ETML-ES-SLO/PRJ_1730_PortierWireless/soft/Portier_17300B_SCA_Release/1730_PortierWireless_InOut_02/readme.txt

Portier Wireless - projet 1730
------------------------------

Description:
Programme fonctionne sur PCB 17300B.
Le même code pour partie porte ou sonnette (détection automatique).
Avec module RF ES 868 MHz 1623x_ModulesRxTx868MHz. Fimware Module_Xbee_06_SCA.
Cette version est fonctionnelle.
Reste à faire :
-gestion des messages sonnette -> sonnette (actuellement, n'en tient pas compte).

Emplacement de ce fichier:
"C:\microchip\harmony\v2_06\apps\PROJ\1730_PortierWireless_InOut_01\readme.txt"

Logiciels:
MPLABX 5.15
xc32 2.15
Harmony 2.06

Auteur:
10.01.2020
Serge Castoldi
