ETML-ES-SLO/PRJ_1730_PortierWireless/doc/Modification/Mod 3.0/2_Rendu/Portier_17300_04_LMS/1730_PortierWireless_InOut_04/readme.txt

Portier Wireless - projet 1730 04
------------------------------

Description:
Programme fonctionne sur PCB 17300B.
Le même code pour partie porte ou sonnette (détection automatique).
Avec module RF ES 868 MHz 1623x_ModulesRxTx868MHz. Fimware Module_Xbee_06_SCA.
Cette version est fonctionnelle.

Basé sur version release SCA avec moddification LMS
Paiting non terminé problème de stabilité. 

Documentations du code : 
https://1730portierwireless.neocities.org/

Emplacement du projet :
C:\microchip\harmony\v2_06\apps\PROJ\1730_PortierWireless_InOut_04

Logiciels:
MPLABX 5.50
xc32 2.50
Harmony 2

Auteur:
02.06.2025
Léo Mendes
