ETML-ES-SLO/PRJ_1730_PortierWireless/doc/PDF(design)/PortierDesign.pptx

## Portier

Phase de design

Ismaël Page
Projet ETML-ES
30 janvier 2018

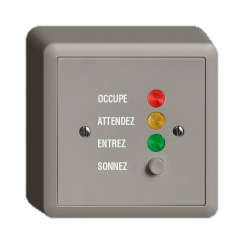
[picture p2: figure]

Notes: 20 min + 10 min questions

## Sommaire

- Produit voulu
- Entrées/Sorties
- Montage "OUT"
- Montage "IN"
- UART
- Coûts
- Planning
- Conclusion
- Questions

## Produit voulu

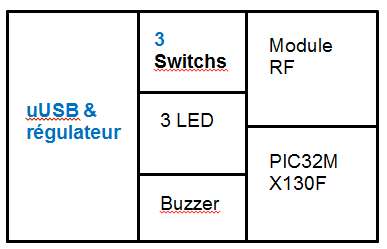
[picture p3: figure]

Module 868MHz

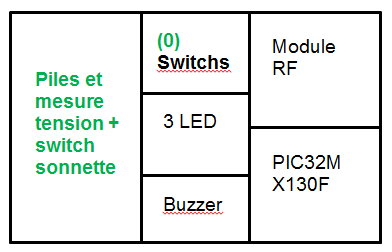
[picture p4: figure]

Module 868MHz

Module 868MHz

## Entrées / Sorties

IN | | OUT
Entrées | Sorties | Entrées | Sorties
Switch1 | LEDRED | Switch1 | LEDRED
Switch2 | LEDRED | Tension piles | LEDYLW
Switch3 | LEDRED | / | LEDGRN
/ | Buzzer | / | Buzzer
RS232 | RS232 | RS232 | RS232

Notes: LED Verte = 330 Ohm

## Entrées / Sorties

RLED Verte = 330Ω
RLED Rouge = 750Ω
RLED Verte = 750Ω
R207 → Sans bruit au démarrage

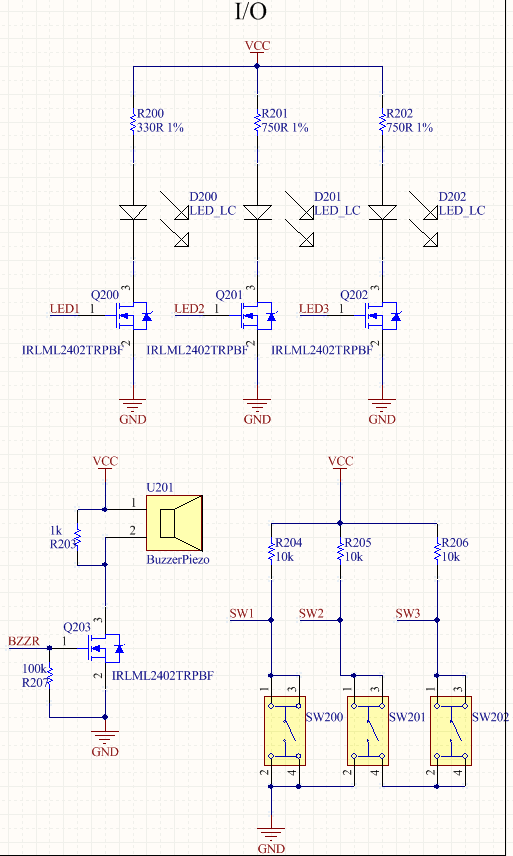
[picture p5: figure]

Notes: Tension LED Rge = 1V75
Tension LED Jne = 1V85
Tension LED Verte = 2V65

## Montage "OUT" Alimentation

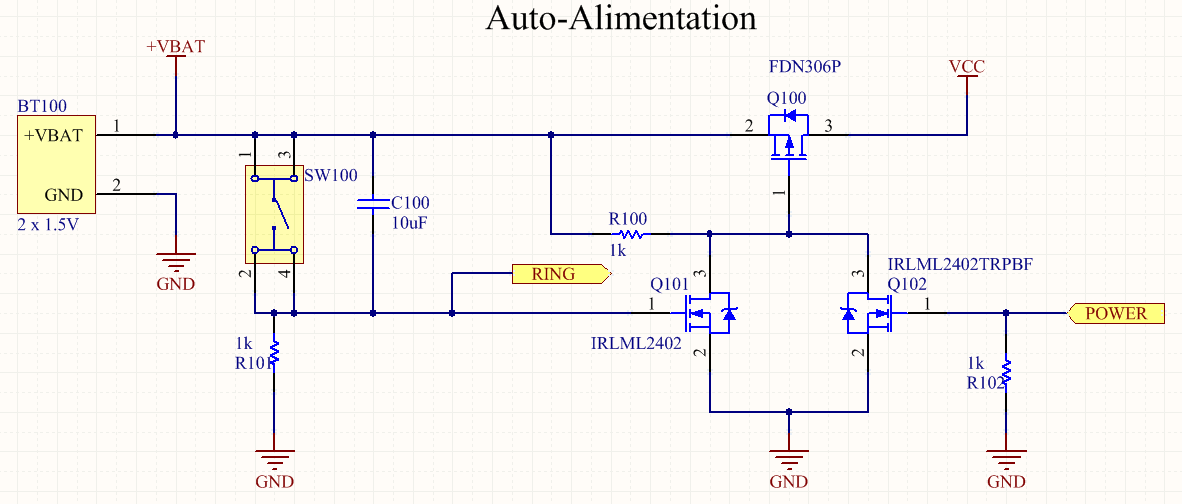
[picture p6: figure]

RC = 10ms

## Montage "OUT" Piles

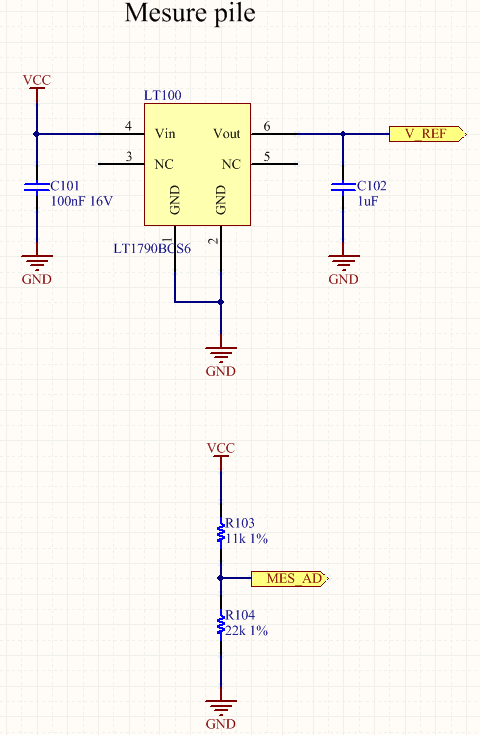
[picture p7: figure]

V_REF = 2.048 V
MES_AD = ⅔ VCC
Seuil d'alerte :
⅔ VCCmin = ⅔ 2.3 = 1.533 V (+0.05)

## Montage "OUT" Démarrage

TPU = Time power-up
TSYSDLY = Time system delay

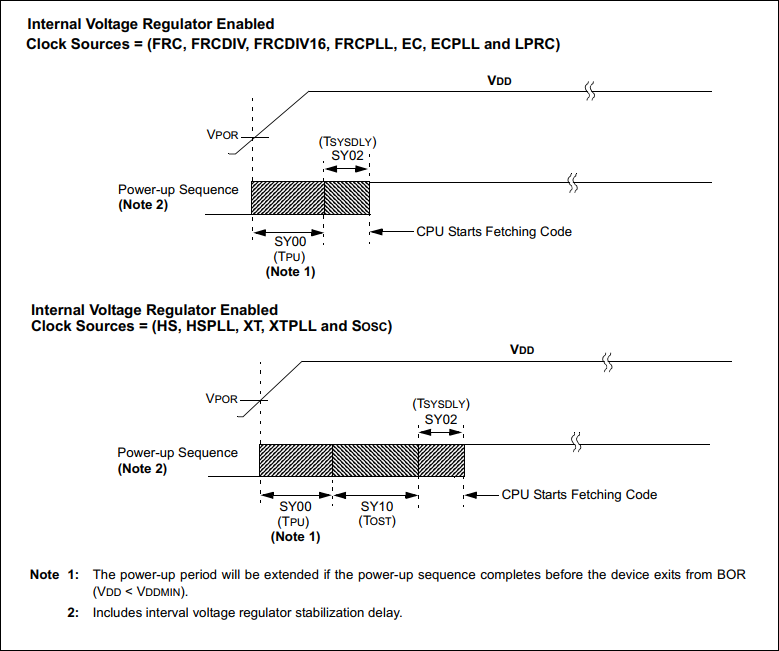
[picture p8: figure]

1+1 µs

Notes: SYSCLK = 8MHz

## Montage Reset PIC

RC = 1 ms
Temps pour être à 1 :
Approx. 3τ → 3ms
Temps Démarrage PIC : 402 µs
Temps Total : 3.402 ms

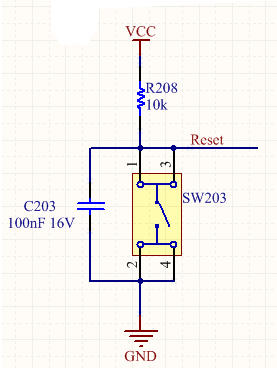
[picture p9: figure]

## Montage "IN" Alimentation

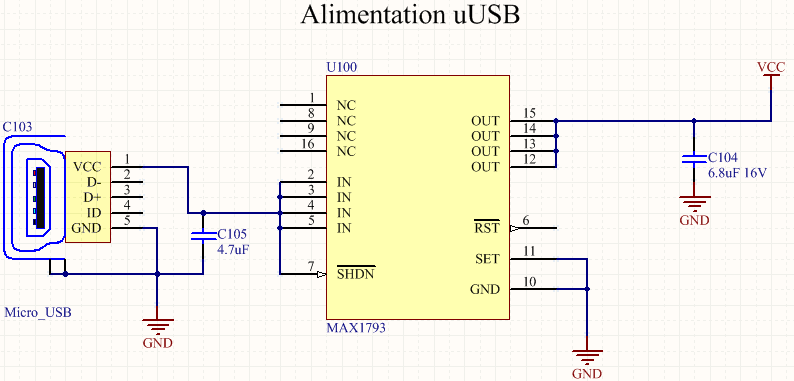
[picture p10: figure]

## UART

- Communication PIC32MX → Module 868MHz
  - Baudrate : 57'600
  - Demande depuis montage OUT (+ tension piles)
  - Réponse dans les 30 secondes
  - Emission en broadcast via le module RF

## Coût

- Composants
  - 74.14.- Fr
- PCB
  - 150.- Fr
- Module 868MHz
  - 165.- Fr
- Total : 389.14.- Fr

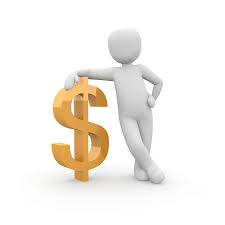
[picture p11: figure]

## Planning

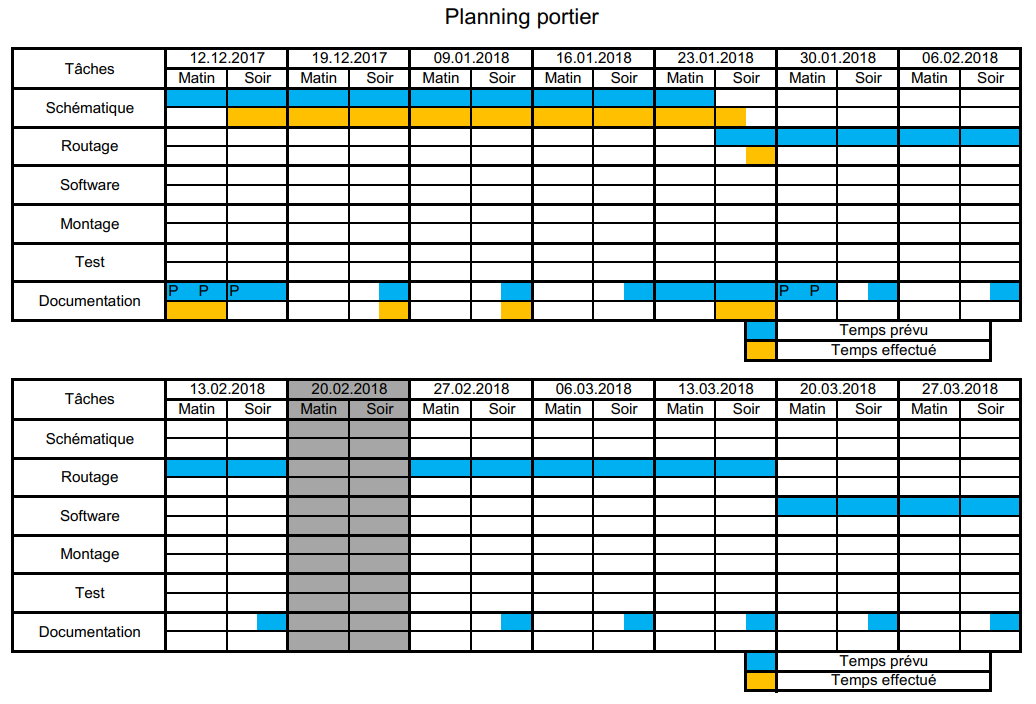
[picture p12: figure]

## Planning

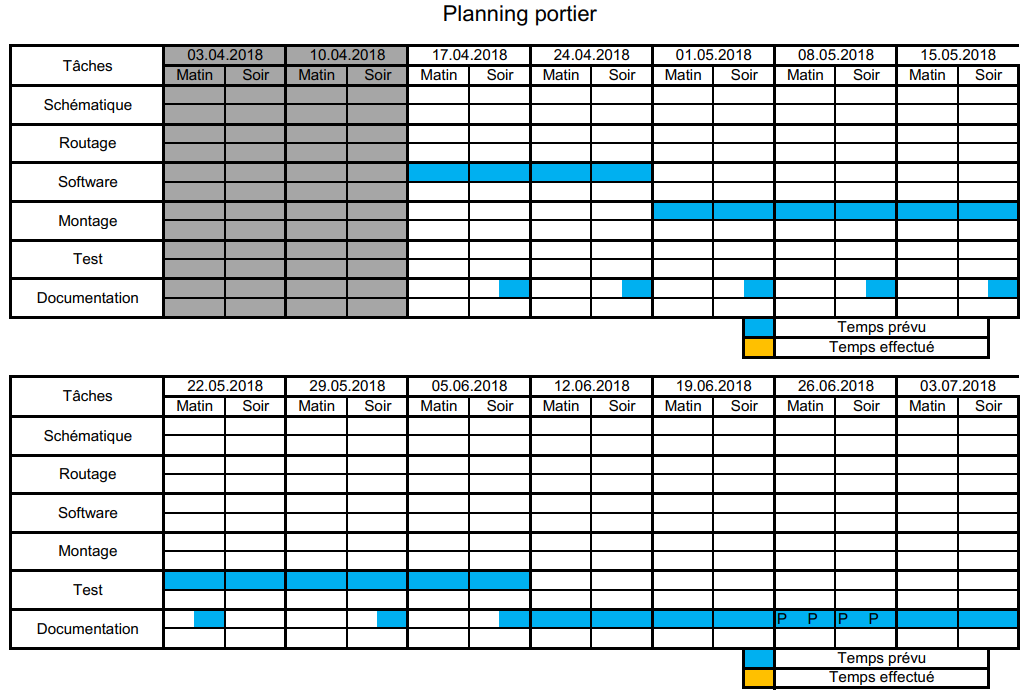
[picture p13: figure]

## Conclusion

- Peu de problèmes dans cette phase
- Je suis dans le temps selon mon planning

Notes: Essayer de gagner du temps dans les prochaines phase par rapport à mon planning

## Questions

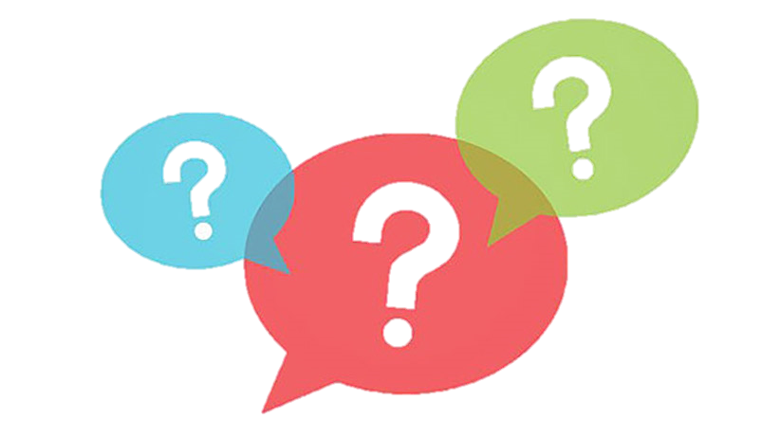
[picture p14: figure]
