ETML-ES-SLO/PRJ_1730_PortierWireless/hard/Portier_17300B_SCA/Project Outputs for Portier_1730/Reports/Electrical Rules Check.html

Altium

# Electrical Rule Check Report

Date: | | 01.11.2019
Time: | | 12:50:00
Filename: | | C:\Users\sercastoldi\Documents\datas_ES\Projets_SCA\1730_PortierWireless\hard\Portier_17300B\Project Outputs for Portier_1730\Reports\Electrical Rules Check.html

Class | Document | Message
Warning | Portier.SchDoc | CD(M) contains IO Pin and Output Pin objects (Pin X200-4,Pin U200-9)
Warning | Portier.SchDoc | LINK(M) contains IO Pin and Output Pin objects (Pin X200-16,Pin U200-25)
Warning | Portier.SchDoc | Net /MCLR has no driving source (Pin R211-2,Pin U200-1,Pin X201-1)
Warning | Portier.SchDoc | NetU200_2 contains IO Pin and Input Port objects (Port V_REF)
Warning | Portier.SchDoc | NetU200_3 contains IO Pin and Input Port objects (Port MES_AD)
Warning | Portier.SchDoc | NetU200_4 contains IO Pin and Output Port objects (Port POWER)
Warning | Portier.SchDoc | NetU200_5 contains IO Pin and Input Port objects (Port RING)
Warning | Power.SchDoc | Net VUSB has no driving source (Pin C104-2,Pin U101-2,Pin U101-3,Pin U101-4,Pin U101-5,Pin U101-7,Pin X100-1)
Warning | Portier.SchDoc | UART_RX contains IO Pin and Output Pin objects (Pin U200-6)

Back to top
