ETML-ES-SLO/PRJ_1730_PortierWireless/hard/Portier_17300B_SCA/Project Outputs for Portier_1730/Reports/Footprint Comparison Report.html

Altium customize

# Footprint Comparison Report

Date: | | 01.11.2019
Time: | | 12:50:00
Elapsed Time: | | 00:00:00
Filename: | | C:\Users\sercastoldi\Documents\datas_ES\Projets_SCA\1730_PortierWireless\hard\Portier_17300B\PCB\Portier.PcbDoc

## Contents

Contents

Components Status Summary

Matched Components List

Footprints Not Found

## Components Status Summary

## Matched Components List

Designator | Footprint | Footprint reference | Footprint to reference Library
BT100 | BATTERYSUPPORT | BatterySupport | C:\Users\sercastoldi\Documents\datas_ES\Projets_SCA\1730_PortierWireless\hard\Portier_17300B\LIBRAIRIES\Portier.PcbLib
C100 | CAPC2013X100X20NL20 | CAPC2013X100X20NL20 | Altium Content Vault
C101 | CAPC2013X100X20NL20 | CAPC2013X100X20NL20 | Altium Content Vault
C102 | CAPC2013X145X50ML20T25 | CAPC2013X145X50ML20T25 | Altium Content Vault
C103 | CAPC2013X135X45LL10T25 | CAPC2013X135X45LL10T25 | Altium Content Vault
C104 | CAPC2013X135X45LL10T25 | CAPC2013X135X45LL10T25 | Altium Content Vault
C200 | CAPC3216X180X50ML20T25 | CAPC3216X180X50ML20T25 | Altium Content Vault
C201 | CAPC2013X100X20NL20 | CAPC2013X100X20NL20 | Altium Content Vault
C202 | CAPC2013X100X20NL20 | CAPC2013X100X20NL20 | Altium Content Vault
C203 | CAPC2013X100X20NL20 | CAPC2013X100X20NL20 | Altium Content Vault
D200 | LED_0805 | LED_0805 | C:\Users\sercastoldi\Documents\datas_ES\Projets_SCA\1730_PortierWireless\hard\Portier_17300B\LIBRAIRIES\Portier.PcbLib
D201 | LED_0805 | LED_0805 | C:\Users\sercastoldi\Documents\datas_ES\Projets_SCA\1730_PortierWireless\hard\Portier_17300B\LIBRAIRIES\Portier.PcbLib
D202 | LED_0805 | LED_0805 | C:\Users\sercastoldi\Documents\datas_ES\Projets_SCA\1730_PortierWireless\hard\Portier_17300B\LIBRAIRIES\Portier.PcbLib
Q100 | FAIR-SSOT3L-3_V | FAIR-SSOT3L-3_V | Altium Content Vault
Q101 | INTR-IRLML2402TRPBF-3_V | INTR-IRLML2402TRPBF-3_V | Altium Content Vault
Q102 | INTR-IRLML2402TRPBF-3_V | INTR-IRLML2402TRPBF-3_V | Altium Content Vault
Q200 | INTR-IRLML2402TRPBF-3_V | INTR-IRLML2402TRPBF-3_V | Altium Content Vault
Q201 | INTR-IRLML2402TRPBF-3_V | INTR-IRLML2402TRPBF-3_V | Altium Content Vault
Q202 | INTR-IRLML2402TRPBF-3_V | INTR-IRLML2402TRPBF-3_V | Altium Content Vault
Q203 | INTR-IRLML2402TRPBF-3_V | INTR-IRLML2402TRPBF-3_V | Altium Content Vault
R100 | RESC2013X60X35ML10T20 | RESC2013X60X35ML10T20 | Altium Content Vault
R101 | RESC2013X60X35ML10T20 | RESC2013X60X35ML10T20 | Altium Content Vault
R102 | RESC2013X60X35ML10T20 | RESC2013X60X35ML10T20 | Altium Content Vault
R103 | RESC0805(2012)_N | RESC0805(2012)_N | Altium Content Vault
R104 | RESC0805(2012)_L | RESC0805(2012)_L | Altium Content Vault
R200 | RESC0805(2012)_N | RESC0805(2012)_N | Altium Content Vault
R201 | RESC0805(2012)_N | RESC0805(2012)_N | Altium Content Vault
R202 | RESC0805(2012)_N | RESC0805(2012)_N | Altium Content Vault
R203 | RESC2013X60X35ML10T20 | RESC2013X60X35ML10T20 | Altium Content Vault
R204 | RESC2013X60X35ML10T20 | RESC2013X60X35ML10T20 | Altium Content Vault
R205 | RESC2013X60X35NL10T20 | RESC2013X60X35NL10T20 | Altium Content Vault
R206 | RESC2013X60X35NL10T20 | RESC2013X60X35NL10T20 | Altium Content Vault
R207 | RESC2013X60X35NL10T20 | RESC2013X60X35NL10T20 | Altium Content Vault
R208 | RESC2013X60X35ML10T20 | RESC2013X60X35ML10T20 | Altium Content Vault
R209 | RESC2013X60X35ML10T20 | RESC2013X60X35ML10T20 | Altium Content Vault
R210 | RESC2013X60X35NL10T20 | RESC2013X60X35NL10T20 | Altium Content Vault
R211 | RESC2013X60X35NL10T20 | RESC2013X60X35NL10T20 | Altium Content Vault
SW100 | SWITCH_SCHURTER | Switch_Schurter | C:\Users\sercastoldi\Documents\datas_ES\Projets_SCA\1730_PortierWireless\hard\Portier_17300B\LIBRAIRIES\Portier.PcbLib
SW200 | SWITCH_SCHURTER | Switch_Schurter | C:\Users\sercastoldi\Documents\datas_ES\Projets_SCA\1730_PortierWireless\hard\Portier_17300B\LIBRAIRIES\Portier.PcbLib
SW201 | SWITCH_SCHURTER | Switch_Schurter | C:\Users\sercastoldi\Documents\datas_ES\Projets_SCA\1730_PortierWireless\hard\Portier_17300B\LIBRAIRIES\Portier.PcbLib
SW202 | SWITCH_SCHURTER | Switch_Schurter | C:\Users\sercastoldi\Documents\datas_ES\Projets_SCA\1730_PortierWireless\hard\Portier_17300B\LIBRAIRIES\Portier.PcbLib
U100 | SOT-23 | SOT-23 | C:\Users\sercastoldi\Documents\datas_ES\Projets_SCA\1730_PortierWireless\hard\Portier_17300B\LIBRAIRIES\Portier.PcbLib
U101 | TSOP65P640X110_HS-17N | TSOP65P640X110_HS-17N | C:\Users\sercastoldi\Documents\datas_ES\Projets_SCA\1730_PortierWireless\hard\Portier_17300B\LIBRAIRIES\Portier.PcbLib
U200 | MCHP-SOIC-SO28_L | MCHP-SOIC-SO28_L | Altium Content Vault
U201 | BUZZER | Buzzer | C:\Users\sercastoldi\Documents\datas_ES\Projets_SCA\1730_PortierWireless\hard\Portier_17300B\LIBRAIRIES\Portier.PcbLib
X100 | MICRO_USB | Micro_USB | C:\Users\sercastoldi\Documents\datas_ES\Projets_SCA\1730_PortierWireless\hard\Portier_17300B\LIBRAIRIES\Portier.PcbLib
X200 | MODULESRXTX868MHZ_1623 | ModulesRxTx868MHz_1623 | C:\Users\sercastoldi\Documents\datas_ES\Projets_SCA\1730_PortierWireless\hard\Portier_17300B\LIBRAIRIES\Portier.PcbLib
X201 | 61300711121 | 61300711121 | C:\Users\sercastoldi\Documents\datas_ES\Projets_SCA\1730_PortierWireless\hard\Portier_17300B\LIBRAIRIES\Portier.PcbLib
X202 | 61300711121 | 61300711121 | C:\Users\sercastoldi\Documents\datas_ES\Projets_SCA\1730_PortierWireless\hard\Portier_17300B\LIBRAIRIES\Portier.PcbLib
X203 | SMTC-TSW-103-07-X-S | SMTC-TSW-103-07-X-S | Altium Content Vault
X204 | 61301011121 | 61301011121 | C:\Users\sercastoldi\Documents\datas_ES\Projets_SCA\1730_PortierWireless\hard\Portier_17300B\LIBRAIRIES\Portier.PcbLib

Back to top

## Footprints Not Found

Designator | Footprint | Library to install
SW203 | 4301X20508X6_6X6X5 | ALTIUM-WS-TASV.IntLib

Back to top
