ETML-ES-SLO/PRJ_1730_PortierWireless/hard/Portier_17300C_JMO/Project Outputs for Portier_1730/Reports/Design Rules Check.html

Altium

# Design Rule Verification Report

Date: | | 19.01.2023
Time: | | 15:34:53
Elapsed Time: | | 00:00:02
Filename: | | C:\Users\juamoreno\OneDrive - Education Vaud\Documents\Altium\Projets\1730_PortierWireless\hard\Portier_17300C_JMO\PCB\Portier.PcbDoc

Warnings: | | 0
Rule Violations: | | 0

## Summary

Warnings | Count
Total | 0

Rule Violations | Count
Clearance Constraint (Gap=0.15mm) (All),(All) | 0
Short-Circuit Constraint (Allowed=No) (All),(All) | 0
Un-Routed Net Constraint ( (All) ) | 0
Modified Polygon (Allow modified: No), (Allow shelved: No) | 0
Width Constraint (Min=0.15mm) (Max=1.5mm) (Preferred=0.2mm) (All) | 0
Width Constraint (Min=0.5mm) (Max=2mm) (Preferred=0.5mm) (InNetClass('Supply')) | 0
Power Plane Connect Rule(Relief Connect )(Expansion=0.175mm) (Conductor Width=0.2mm) (Air Gap=0.2mm) (Entries=4) (All) | 0
Minimum Annular Ring (Minimum=0.125mm) (All) | 0
Hole Size Constraint (Min=0.25mm) (Max=3.5mm) (All) | 0
Hole To Hole Clearance (Gap=0.35mm) (All),(All) | 0
Minimum Solder Mask Sliver (Gap=0.08mm) (All),(All) | 0
Net Antennae (Tolerance=0mm) (All) | 0
Board Clearance Constraint (Gap=0mm) (All) | 0
Height Constraint (Min=0mm) (Max=25mm) (Prefered=12.5mm) (All) | 0
Total | 0
