ETML-ES-SLO/PRJ_1730_PortierWireless/hard/Portier_17300C_JMO/Project Outputs for Portier_1730/Reports/Design Rules Check/1730_Circuit_Door.html

Altium

# Design Rule Verification Report

Date: | | 27.01.2023
Time: | | 16:37:06
Elapsed Time: | | 00:00:02
Filename: | | G:\OneDrive_EV\OneDrive - Education Vaud\Documents\Altium\Projets\1730_PortierWireless\hard\Portier_17300C_JMO\PCB\Portier.PcbDoc

Warnings: | | 0
Rule Violations: | | 3

## Summary

Warnings | Count
Total | 0

Rule Violations | Count
Clearance Constraint (Gap=0.15mm) (All),(All) | 0
Short-Circuit Constraint (Allowed=No) (All),(All) | 0
Un-Routed Net Constraint ( (All) ) | 0
Modified Polygon (Allow modified: No), (Allow shelved: No) | 0
Width Constraint (Min=0.15mm) (Max=1.5mm) (Preferred=0.2mm) (All) | 0
Width Constraint (Min=0.5mm) (Max=2mm) (Preferred=0.5mm) (InNetClass('Supply')) | 0
Power Plane Connect Rule(Relief Connect )(Expansion=0.175mm) (Conductor Width=0.2mm) (Air Gap=0.2mm) (Entries=4) (All) | 0
Minimum Annular Ring (Minimum=0.125mm) (All) | 0
Hole Size Constraint (Min=0.25mm) (Max=3.5mm) (All) | 3
Hole To Hole Clearance (Gap=0.35mm) (All),(All) | 0
Minimum Solder Mask Sliver (Gap=0.08mm) (All),(All) | 0
Net Antennae (Tolerance=0mm) (All) | 0
Board Clearance Constraint (Gap=0mm) (All) | 0
Room Alimentation (Bounding Region = (134.62mm, 33.528mm, 173.99mm, 114.554mm) (InComponentClass('Alimentation')) | 0
Room Circuit (Bounding Region = (75.184mm, 25.146mm, 145.288mm, 123.698mm) (InComponentClass('Circuit')) | 0
Height Constraint (Min=0mm) (Max=25mm) (Prefered=12.5mm) (All) | 0
Total | 3

Hole Size Constraint (Min=0.25mm) (Max=3.5mm) (All)

Hole Size Constraint: (3.5mm > 3.5mm) Pad BT100-3(87.022mm,62.236mm) on Multi-Layer Actual Hole Size = 3.5mm

Hole Size Constraint: (3.5mm > 3.5mm) Pad BT100-3(89.372mm,77.221mm) on Multi-Layer Actual Hole Size = 3.5mm

Hole Size Constraint: (3.5mm > 3.5mm) Pad BT100-4(84.672mm,47.251mm) on Multi-Layer Actual Hole Size = 3.5mm

Back to top
