ETML-ES-SLO/PRJ_1730_PortierWireless/hard/Portier_17300C_JMO/Project Outputs for Portier_1730/Reports/Electrical Rules Check/1730_Circuit_Door.html

Altium

# Electrical Rule Check Report

Date: | | 27.01.2023
Time: | | 16:37:09
Filename: | | G:\OneDrive_EV\OneDrive - Education Vaud\Documents\Altium\Projets\1730_PortierWireless\hard\Portier_17300C_JMO\Project Outputs for Portier_1730\Reports\Electrical Rules Check\1730_Circuit_Door.html

Class | Document | Message
Warning | Portier.SchDoc | CD(M) contains IO Pin and Output Pin objects (Pin U200-9, Pin X200-4).
Warning | Power.SchDoc | Component R104 22k 1% at 9000mil,3000mil: Component revision is Out of Date.
Warning | Portier.SchDoc | Component R200 750R at 8600mil,6600mil: Component revision is Out of Date.
Warning | Portier.SchDoc | Component R201 750R at 9500mil,6600mil: Component revision is Out of Date.
Warning | Portier.SchDoc | Component R202 750R at 10200mil,6400mil: Component revision is Out of Date.
Warning | Power.SchDoc | Incorrect link between project variant "1730_Circuit_Bell" and schematic component Component C102 1µF
Warning | Portier.SchDoc | LINK(M) contains IO Pin and Output Pin objects (Pin U200-25, Pin X200-16).
Warning | Portier.SchDoc | Net /MCLR has no driving source (Pin R211-2, Pin U200-1, Pin X201-1)
Warning | Power.SchDoc | Net VUSB has no driving source (Pin C104-2, Pin U101-2, Pin U101-3, Pin U101-4, Pin U101-5, Pin U101-7, Pin X100-1)
Warning | Portier.SchDoc | NetU200_2 contains IO Pin and Input Port objects (Pin U200-2, Port V_REF).
Warning | Portier.SchDoc | NetU200_3 contains IO Pin and Input Port objects (Pin U200-3, Port MES_AD).
Warning | Portier.SchDoc | NetU200_4 contains IO Pin and Output Port objects (Pin U200-4, Port POWER).
Warning | Portier.SchDoc | NetU200_5 contains IO Pin and Input Port objects (Pin U200-5, Port RING).
Warning | Portier.SchDoc | UART_RX contains IO Pin and Output Pin objects (Pin U200-6, Pin X200-2).

Back to top
