ETML-ES-SLO/PRJ_1730_PortierWireless/doc/Modification/Mod 3.0/3_Doxygen/rtf/dir_1914f9ae7ad7a126c86f640c04ac95e9.rtf

begin bodyRÃ©pertoire de rÃ©fÃ©rence de C:/microchip/harmony/v2_06/apps/1730_PortierWireless_InOut_04/firmware/src
AAAAAAAALLAAAAAAAALLGraphe des dÃ©pendances de rÃ©pertoires pour src:
IMAGE
Fichiers
fichier app.c
fichier app.h
fichier led.c
fichier led.h
fichier main.c
fichier Management.c
fichier Management.h
fichier Mc32Debounce.c
fichier Mc32Debounce.h
fichier Mc32Delays.c
fichier Mc32Delays.h
fichier Pairing.c
fichier Pairing.h
fichier RF.c
fichier RF.h
fichier sound.c
fichier sound.h
