ETML-ES-SLO/PRJ_1730_PortierWireless/doc/Modification/Mod 3.0/3_Doxygen/rtf/refman.rtf

Portier Wireless

AUTHOR
Version Le portier sans fil est un système bidirectionnel basé sur un microcontrôleur PIC32MX130F064B-I/SS et un module radio 868 MHz, permettant à un visiteur d’envoyer une requête depuis l’extérieur via un bouton alimenté par piles, et à l’occupant du bureau de répondre par des signaux lumineux et sonores grâce à une unité intérieure alimentée en USB, le tout avec appairage sécurisé et gestion autonome de l’énergie.

Table des matières

Table of contents

Index des classes
Liste des classes
Liste des classes, structures, unions et interfaces avec une brève description :
APP_DATA pagenum
NOTE_t pagenum
s_bits pagenum
S_SwitchDescriptor pagenum

Index des fichiers
Liste des fichiers
Liste de tous les fichiers avec une brève description :
C:/microchip/harmony/v2_06/apps/1730_PortierWireless_InOut_04/firmware/src/app.c pagenum
C:/microchip/harmony/v2_06/apps/1730_PortierWireless_InOut_04/firmware/src/app.h pagenum
C:/microchip/harmony/v2_06/apps/1730_PortierWireless_InOut_04/firmware/src/led.c pagenum
C:/microchip/harmony/v2_06/apps/1730_PortierWireless_InOut_04/firmware/src/led.h pagenum
C:/microchip/harmony/v2_06/apps/1730_PortierWireless_InOut_04/firmware/src/main.c pagenum
C:/microchip/harmony/v2_06/apps/1730_PortierWireless_InOut_04/firmware/src/Management.c pagenum
C:/microchip/harmony/v2_06/apps/1730_PortierWireless_InOut_04/firmware/src/Management.h pagenum
C:/microchip/harmony/v2_06/apps/1730_PortierWireless_InOut_04/firmware/src/Mc32Debounce.c pagenum
C:/microchip/harmony/v2_06/apps/1730_PortierWireless_InOut_04/firmware/src/Mc32Debounce.h pagenum
C:/microchip/harmony/v2_06/apps/1730_PortierWireless_InOut_04/firmware/src/Mc32Delays.c pagenum
C:/microchip/harmony/v2_06/apps/1730_PortierWireless_InOut_04/firmware/src/Mc32Delays.h pagenum
C:/microchip/harmony/v2_06/apps/1730_PortierWireless_InOut_04/firmware/src/Pairing.c pagenum
C:/microchip/harmony/v2_06/apps/1730_PortierWireless_InOut_04/firmware/src/Pairing.h pagenum
C:/microchip/harmony/v2_06/apps/1730_PortierWireless_InOut_04/firmware/src/RF.c pagenum
C:/microchip/harmony/v2_06/apps/1730_PortierWireless_InOut_04/firmware/src/RF.h pagenum
C:/microchip/harmony/v2_06/apps/1730_PortierWireless_InOut_04/firmware/src/sound.c pagenum
C:/microchip/harmony/v2_06/apps/1730_PortierWireless_InOut_04/firmware/src/sound.h pagenum

Documentation des classes
Référence de la structure APP_DATA
AAAAAAAAKLAAAAAAAAKL
#include <app.h>

Attributs publics
APP_STATES state
bool isDoor
uint16_t batVoltage
bool isLowBat

AAAAAAAAKMAAAAAAAAKMDocumentation des données membres
uint16_t APP_DATA::batVoltage
AAAAAAAAKNAAAAAAAAKNbool APP_DATA::isDoor
AAAAAAAAKOAAAAAAAAKObool APP_DATA::isLowBat
AAAAAAAAKPAAAAAAAAKPAPP_STATES APP_DATA::state
AAAAAAAAKQAAAAAAAAKQ
La documentation de cette structure a été générée à partir du fichier suivant :
C:/microchip/harmony/v2_06/apps/1730_PortierWireless_InOut_04/firmware/src/app.h

Référence de la structure NOTE_t
AAAAAAAAKRAAAAAAAAKR
#include <sound.h>

Attributs publics
uint16_t duration
uint16_t freq

AAAAAAAAKSAAAAAAAAKSDocumentation des données membres
uint16_t NOTE_t::duration
AAAAAAAAKTAAAAAAAAKTuint16_t NOTE_t::freq
AAAAAAAAKUAAAAAAAAKU
La documentation de cette structure a été générée à partir du fichier suivant :
C:/microchip/harmony/v2_06/apps/1730_PortierWireless_InOut_04/firmware/src/sound.h

Référence de la structure s_bits
AAAAAAAAKVAAAAAAAAKV
#include <Mc32Debounce.h>

Attributs publics
uint8_t KeyPressed:1
uint8_t KeyReleased: 1
uint8_t KeyPrevInputValue: 1
uint8_t KeyValue: 1

AAAAAAAAKWAAAAAAAAKWDocumentation des données membres
uint8_t s_bits::KeyPressed
AAAAAAAAKXAAAAAAAAKXuint8_t s_bits::KeyPrevInputValue
AAAAAAAAKYAAAAAAAAKYuint8_t s_bits::KeyReleased
AAAAAAAAKZAAAAAAAAKZuint8_t s_bits::KeyValue
AAAAAAAALAAAAAAAAALA
La documentation de cette structure a été générée à partir du fichier suivant :
C:/microchip/harmony/v2_06/apps/1730_PortierWireless_InOut_04/firmware/src/Mc32Debounce.h

Référence de la structure S_SwitchDescriptor
AAAAAAAALBAAAAAAAALB
#include <Mc32Debounce.h>

Graphe de collaboration de S_SwitchDescriptor:
IMAGE

Attributs publics
E_DebouceStates DebounceState
uint8_t DebounceCounter
s_bits bits

AAAAAAAALCAAAAAAAALCDocumentation des données membres
s_bits S_SwitchDescriptor::bits
AAAAAAAALDAAAAAAAALDuint8_t S_SwitchDescriptor::DebounceCounter
AAAAAAAALEAAAAAAAALEE_DebouceStates S_SwitchDescriptor::DebounceState
AAAAAAAALFAAAAAAAALF
La documentation de cette structure a été générée à partir du fichier suivant :
C:/microchip/harmony/v2_06/apps/1730_PortierWireless_InOut_04/firmware/src/Mc32Debounce.h

Documentation des fichiers
Référence du fichier C:/microchip/harmony/v2_06/apps/1730_PortierWireless_InOut_04/firmware/src/app.c
AAAAAAAAAIAAAAAAAAAI#include "app.h"
#include <stdio.h>

#include "peripheral/adc/plib_adc.h"

#include "peripheral/reset/plib_reset.h"

#include "sound.h"

#include "RF.h"

#include "led.h"

#include "Pairing.h"

#include "management.h"

Graphe des dépendances par inclusion de app.c:
IMAGE

Fonctions
uint16_t ReadBatVoltage (void)
Lit la tension mesurée sur l'entrée analogique AN1.

void SetDoor (void)
Détermine si le CPU est à la porte (Door) ou à la sonnette intérieure (Bell).

void APP_UpdateState (APP_STATES newState)
Met à jour l'état de l'application.

bool APP_GetIsDoor (void)
Vérifie si l'entité courante est une porte.

void APP_Initialize (void)
Initialise l'application.

void APP_Tasks (void)
Tâche principale de l'application.

Variables
APP_DATA appData
S_SwitchDescriptor swEnter
S_SwitchDescriptor swBusy
S_SwitchDescriptor swRing
S_SwitchDescriptor swWait
uint32_t appPairedSerial = 0
uint32_t mySerial

AAAAAAAAAJAAAAAAAAAJDocumentation des fonctions
bool APP_GetIsDoor (void )
AAAAAAAAAKAAAAAAAAAK
Vérifie si l'entité courante est une porte.

Renvoie
true si l'entité est une porte, false sinon.
Cette fonction retourne la valeur du champ isDoor de la structure appData.
void APP_Initialize (void )
AAAAAAAAALAAAAAAAAAL
Initialise l'application.
Cette fonction configure l'état initial de l'application, initialise les broches matérielles, la logique d'antirebond pour les boutons, ainsi que les périphériques tels que les LEDs, le module sonore et la RF.
Renvoie
void
void APP_Tasks (void )
AAAAAAAAAMAAAAAAAAAM
Tâche principale de l'application.
Cette fonction gère la machine à états principale de l'application. Elle est appelée de manière répétée dans la boucle principale du programme.
Remarques
Voir le prototype dans app.h.
void APP_UpdateState (APP_STATES newState)
AAAAAAAAANAAAAAAAAAN
Met à jour l'état de l'application.

Paramètres
newState | Le nouvel état à appliquer à l'application.
Cette fonction assigne la valeur de newState à la variable d'état de l'application. uint16_t ReadBatVoltage (void )
AAAAAAAAAOAAAAAAAAAO
Lit la tension mesurée sur l'entrée analogique AN1.
Cette fonction lit la valeur convertie par l'ADC sur AN1.
◦ i le montage est un bouton à la porte, elle retourne la tension de la pile (diviseur résistif 2/3).
◦ i c'est une sonnerie distante, elle retourne 0 (pull-down).
Renvoie
uint16_t Valeur brute ADC mesurée sur AN1.
void SetDoor (void )
AAAAAAAAAPAAAAAAAAAP
Détermine si le CPU est à la porte (Door) ou à la sonnette intérieure (Bell).
Cette fonction met à jour le champ appData.isDoor selon la position du CPU. Si le CPU est à la porte (isDoor), elle lit la tension de la pile, met à jour appData.batVoltage (tension pile en mV) et appData.isLowBat (indication de batterie faible).
Note
Utilise l'ADC pour effectuer les mesures nécessaires.
Désactive l'ADC à la fin pour économiser la batterie.

AAAAAAAAAQAAAAAAAAAQDocumentation des variables
APP_DATA appData
AAAAAAAAARAAAAAAAAARuint32_t appPairedSerial = 0
AAAAAAAAASAAAAAAAAASuint32_t mySerial[extern]
AAAAAAAAATAAAAAAAAATS_SwitchDescriptor swBusy
AAAAAAAAAUAAAAAAAAAUS_SwitchDescriptor swEnter
AAAAAAAAAVAAAAAAAAAVS_SwitchDescriptor swRing
AAAAAAAAAWAAAAAAAAAWS_SwitchDescriptor swWait
AAAAAAAAAXAAAAAAAAAX

Référence du fichier C:/microchip/harmony/v2_06/apps/1730_PortierWireless_InOut_04/firmware/src/app.h
AAAAAAAAAYAAAAAAAAAY#include <stdint.h>
#include <stdbool.h>

#include <stddef.h>

#include <stdlib.h>

#include "system_config.h"

#include "system_definitions.h"

#include "Mc32Debounce.h"

Graphe des dépendances par inclusion de app.h:
IMAGE

Ce graphe montre quels fichiers incluent directement ou indirectement ce fichier :
IMAGE

Classes
struct APP_DATAMacros
#define LOWBAT_THRESHOLD 2400

Énumérations
enum APP_STATES { APP_STATE_INIT = 0, APP_STATE_WAIT, APP_STATE_SERVICE_TASKS }
Fonctions
void APP_Initialize (void)
Initialise l'application.

void APP_Tasks (void)
Tâche principale de l'application.

void APP_UpdateState (APP_STATES newState)
Met à jour l'état de l'application.

bool APP_GetIsDoor (void)
Vérifie si l'entité courante est une porte.

Variables
S_SwitchDescriptor swRing
S_SwitchDescriptor swEnter
S_SwitchDescriptor swWait
S_SwitchDescriptor swBusy

AAAAAAAAAZAAAAAAAAAZDocumentation des macros
#define LOWBAT_THRESHOLD 2400

AAAAAAAABAAAAAAAAABA
AAAAAAAABBAAAAAAAABBDocumentation du type de l'énumération
enum APP_STATES
AAAAAAAABCAAAAAAAABC
Valeurs énumérées:
APP_STATE_INITAAAAAAAABDAAAAAAAABD
APP_STATE_WAITAAAAAAAABEAAAAAAAABE
APP_STATE_SERVICE_TASKSAAAAAAAABFAAAAAAAABF

AAAAAAAABGAAAAAAAABGDocumentation des fonctions
bool APP_GetIsDoor (void )
AAAAAAAABHAAAAAAAABH
Vérifie si l'entité courante est une porte.

Renvoie
true si l'entité est une porte, false sinon.
Cette fonction retourne la valeur du champ isDoor de la structure appData.
void APP_Initialize (void )
AAAAAAAABIAAAAAAAABI
Initialise l'application.
Cette fonction configure l'état initial de l'application, initialise les broches matérielles, la logique d'antirebond pour les boutons, ainsi que les périphériques tels que les LEDs, le module sonore et la RF.
Renvoie
void
void APP_Tasks (void )
AAAAAAAABJAAAAAAAABJ
Tâche principale de l'application.
Cette fonction gère la machine à états principale de l'application. Elle est appelée de manière répétée dans la boucle principale du programme.
Remarques
Voir le prototype dans app.h.
void APP_UpdateState (APP_STATES newState)
AAAAAAAABKAAAAAAAABK
Met à jour l'état de l'application.

Paramètres
newState | Le nouvel état à appliquer à l'application.
Cette fonction assigne la valeur de newState à la variable d'état de l'application.
AAAAAAAABLAAAAAAAABLDocumentation des variables
S_SwitchDescriptor swBusy[extern]
AAAAAAAABMAAAAAAAABMS_SwitchDescriptor swEnter[extern]
AAAAAAAABNAAAAAAAABNS_SwitchDescriptor swRing[extern]
AAAAAAAABOAAAAAAAABOS_SwitchDescriptor swWait[extern]
AAAAAAAABPAAAAAAAABP

app.h
AAAAAAAAAAAAAAAAAAAAAller à la documentation de ce fichier.

1 /*******************************************************************************
2 MPLAB Harmony Application Header File
3
4 Company:
5 Microchip Technology Inc.
6
7 File Name:
8 app.h
9
10 Summary:
11 This header file provides prototypes and definitions for the application.
12
13 Description:
14 This header file provides function prototypes and data type definitions for
15 the application. Some of these are required by the system (such as the
16 "APP_Initialize" and "APP_Tasks" prototypes) and some of them are only used
17 internally by the application (such as the "APP_STATES" definition). Both
18 are defined here for convenience.
19 *******************************************************************************/
20
21 //DOM-IGNORE-BEGIN
22 /*******************************************************************************
23 Copyright (c) 2013-2014 released Microchip Technology Inc. All rights reserved.
24
25 Microchip licenses to you the right to use, modify, copy and distribute
26 Software only when embedded on a Microchip microcontroller or digital signal
27 controller that is integrated into your product or third party product
28 (pursuant to the sublicense terms in the accompanying license agreement).
29
30 You should refer to the license agreement accompanying this Software for
31 additional information regarding your rights and obligations.
32
33 SOFTWARE AND DOCUMENTATION ARE PROVIDED "AS IS" WITHOUT WARRANTY OF ANY KIND,
34 EITHER EXPRESS OR IMPLIED, INCLUDING WITHOUT LIMITATION, ANY WARRANTY OF
35 MERCHANTABILITY, TITLE, NON-INFRINGEMENT AND FITNESS FOR A PARTICULAR PURPOSE.
36 IN NO EVENT SHALL MICROCHIP OR ITS LICENSORS BE LIABLE OR OBLIGATED UNDER
37 CONTRACT, NEGLIGENCE, STRICT LIABILITY, CONTRIBUTION, BREACH OF WARRANTY, OR
38 OTHER LEGAL EQUITABLE THEORY ANY DIRECT OR INDIRECT DAMAGES OR EXPENSES
39 INCLUDING BUT NOT LIMITED TO ANY INCIDENTAL, SPECIAL, INDIRECT, PUNITIVE OR
40 CONSEQUENTIAL DAMAGES, LOST PROFITS OR LOST DATA, COST OF PROCUREMENT OF
41 SUBSTITUTE GOODS, TECHNOLOGY, SERVICES, OR ANY CLAIMS BY THIRD PARTIES
42 (INCLUDING BUT NOT LIMITED TO ANY DEFENSE THEREOF), OR OTHER SIMILAR COSTS.
43 *******************************************************************************/
44 //DOM-IGNORE-END
45
46 #ifndef _APP_H
47 #define _APP_H
48
49 // *****************************************************************************
50 // Section : Fichiers inclus
51 // *****************************************************************************
52
53 #include <stdint.h> // Types entiers standards
54 #include <stdbool.h> // Type booléen
55 #include <stddef.h> // Définitions de taille
56 #include <stdlib.h> // Fonctions utilitaires générales
57 #include "system_config.h" // Configuration système
58 #include "system_definitions.h" // Définitions système
59 #include "Mc32Debounce.h" // Gestion anti-rebond pour boutons
60
61 // DOM-IGNORE-BEGIN
62 #ifdef __cplusplus // Pour compatibilité C++
63 extern "C" {
64 #endif
65 // DOM-IGNORE-END
66
67 // *****************************************************************************
68 // Section : Définitions de types
69 // *****************************************************************************
70
71 // *****************************************************************************
72 // Enumération des états de l'application
73 // *****************************************************************************
74 typedef enum
75 {
76 APP_STATE_INIT = 0, // État initial de l'application
77 APP_STATE_WAIT, // Attente d'un événement
78 APP_STATE_SERVICE_TASKS // Exécution des tâches de service
79 } APP_STATES;
80
81 // *****************************************************************************
82 // Structure des données de l'application
83 // *****************************************************************************
84 #define LOWBAT_THRESHOLD 2400 // Seuil de batterie faible (2.4V)
85
86 typedef struct
87 {
88 APP_STATES state; // État courant de l'application
89 bool isDoor; // Indique si la porte est détectée
90 uint16_t batVoltage; // Tension de la batterie
91 bool isLowBat; // Indique si la batterie est faible
92 } APP_DATA;
93
94 // *****************************************************************************
95 // Déclarations externes des descripteurs de boutons
96 // *****************************************************************************
97 extern S_SwitchDescriptor swRing; // Descripteur du bouton de sonnette
98 extern S_SwitchDescriptor swEnter; // Descripteur du bouton d'entrée
99 extern S_SwitchDescriptor swWait; // Descripteur du bouton d'attente
100 extern S_SwitchDescriptor swBusy; // Descripteur du bouton d'occupation
101
102 // *****************************************************************************
103 // Section : Prototypes des fonctions de l'application
104 // *****************************************************************************
105
106 /*******************************************************************************
107 Fonction : void APP_Initialize(void)
108 Initialise l'application Harmony, place dans l'état initial.
109 *******************************************************************************/
110 void APP_Initialize(void); // Initialise l'application
111
112 /*******************************************************************************
113 Fonction : void APP_Tasks(void)
114 Machine à états principale de l'application Harmony.
115 *******************************************************************************/
116 void APP_Tasks(void); // Exécute les tâches de l'application
117
118 /*******************************************************************************
119 Fonction : void APP_UpdateState(APP_STATES newState)
120 Met à jour l'état de l'application.
121 *******************************************************************************/
122 void APP_UpdateState(APP_STATES newState); // Met à jour l'état
123
124 /*******************************************************************************
125 Fonction : bool APP_GetIsDoor(void)
126 Retourne l'état de détection de la porte.
127 *******************************************************************************/
128 bool APP_GetIsDoor(void); // Retourne si la porte est détectée
129
130 // *****************************************************************************
131 // Fin des définitions externes et compatibilité C++
132 // *****************************************************************************
133 #ifdef __cplusplus
134 }
135 #endif
136
137 /*******************************************************************************
138 Fin du fichier
139 *******************************************************************************/

Référence du fichier C:/microchip/harmony/v2_06/apps/1730_PortierWireless_InOut_04/firmware/src/led.c
AAAAAAAABQAAAAAAAABQ#include "led.h"
#include <stdint.h>

#include <xc.h>

#include <stdbool.h>

Graphe des dépendances par inclusion de led.c:
IMAGE

Macros
#define NUMBER_OF_LEDS 3

#define LED_ON(led_Id)

#define LED_OFF(led_Id)

Énumérations
enum LED_STATES { LED_STATE_INIT =0, LED_STATE_IDLE, LED_STATE_ACTIVE }
Fonctions
void Led_Init (void)
bool Led_CheckBlink ()
void Led_SetMode (LED_IDS led_Id, LED_MODES led_Mode)
void Led_Mgmt (void)
Variables
LED_STATES ledState
LED_MODES ledModes [NUMBER_OF_LEDS]

AAAAAAAABRAAAAAAAABRDocumentation des macros
#define LED_OFF( led_Id)

AAAAAAAABSAAAAAAAABSValeur :
{LATBCLR = 1<<(led_Id+4);}
#define LED_ON( led_Id)

AAAAAAAABTAAAAAAAABTValeur :
{LATBSET = 1<<(led_Id+4);}
#define NUMBER_OF_LEDS 3

AAAAAAAABUAAAAAAAABU
AAAAAAAABVAAAAAAAABVDocumentation du type de l'énumération
enum LED_STATES
AAAAAAAABWAAAAAAAABW
Valeurs énumérées:
LED_STATE_INITAAAAAAAABXAAAAAAAABX
LED_STATE_IDLEAAAAAAAABYAAAAAAAABY
LED_STATE_ACTIVEAAAAAAAABZAAAAAAAABZ

AAAAAAAACAAAAAAAAACADocumentation des fonctions
bool Led_CheckBlink ()
AAAAAAAACBAAAAAAAACBvoid Led_Init (void )
AAAAAAAACCAAAAAAAACCvoid Led_Mgmt (void )
AAAAAAAACDAAAAAAAACDvoid Led_SetMode (LED_IDS led_Id, LED_MODES led_Mode)
AAAAAAAACEAAAAAAAACE
AAAAAAAACFAAAAAAAACFDocumentation des variables
LED_MODES ledModes[NUMBER_OF_LEDS]
AAAAAAAACGAAAAAAAACGLED_STATES ledState
AAAAAAAACHAAAAAAAACH

Référence du fichier C:/microchip/harmony/v2_06/apps/1730_PortierWireless_InOut_04/firmware/src/led.h
AAAAAAAACIAAAAAAAACICe graphe montre quels fichiers incluent directement ou indirectement ce fichier :
IMAGE

Énumérations
enum LED_IDS { LED_ID_ENTER =0, LED_ID_WAIT, LED_ID_BUSY }
enum LED_MODES { LED_MODE_OFF =0, LED_MODE_ON, LED_MODE_BLINK_NORMAL, LED_MODE_BLINK_2X_FAST }
Fonctions
void Led_Init (void)
void Led_SetMode (LED_IDS led_Id, LED_MODES led_Mode)
void Led_Mgmt (void)

AAAAAAAACJAAAAAAAACJDocumentation du type de l'énumération
enum LED_IDS
AAAAAAAACKAAAAAAAACK
Valeurs énumérées:
LED_ID_ENTERAAAAAAAACLAAAAAAAACL
LED_ID_WAITAAAAAAAACMAAAAAAAACM
LED_ID_BUSYAAAAAAAACNAAAAAAAACN
enum LED_MODES
AAAAAAAACOAAAAAAAACO
Valeurs énumérées:
LED_MODE_OFFAAAAAAAACPAAAAAAAACP
LED_MODE_ONAAAAAAAACQAAAAAAAACQ
LED_MODE_BLINK_NORMALAAAAAAAACRAAAAAAAACR
LED_MODE_BLINK_2X_FASTAAAAAAAACSAAAAAAAACS

AAAAAAAACTAAAAAAAACTDocumentation des fonctions
void Led_Init (void )
AAAAAAAACUAAAAAAAACUvoid Led_Mgmt (void )
AAAAAAAACVAAAAAAAACVvoid Led_SetMode (LED_IDS led_Id, LED_MODES led_Mode)
AAAAAAAACWAAAAAAAACW

led.h
AAAAAAAAABAAAAAAAAABAller à la documentation de ce fichier.

1 //--------------------------------------------------------
2 // led.h
3 //--------------------------------------------------------
4 // Gestion des leds sur portier électronique (1730)
5 //
6 // Auteur : SCA
7 // Date : 15.01.2020
8 // Version : V1.0
9 // Compilateur : XC32 V2.15
10 // Modifications :
11 // -
12 /*--------------------------------------------------------*/
13
14 #ifndef _LED_H /* Guard against multiple inclusion */
15 #define _LED_H
16
17 /* ************************************************************************** */
18
19 typedef enum
20 {
21 LED_ID_ENTER=0,
22 LED_ID_WAIT,
23 LED_ID_BUSY,
24 } LED_IDS;
25
26 typedef enum
27 {
28 LED_MODE_OFF=0,
29 LED_MODE_ON,
30 LED_MODE_BLINK_NORMAL,
31 LED_MODE_BLINK_2X_FAST,
32 } LED_MODES;
33
34 /* ************************************************************************** */
35
36 void Led_Init(void);
37 void Led_SetMode(LED_IDS led_Id, LED_MODES led_Mode);
38 void Led_Mgmt(void);
39
40 #endif /* _LED_H */
41
42 /* *****************************************************************************
43 End of File
44 */

Référence du fichier C:/microchip/harmony/v2_06/apps/1730_PortierWireless_InOut_04/firmware/src/main.c
AAAAAAAACXAAAAAAAACX#include <stddef.h>
#include <stdbool.h>

#include <stdlib.h>

#include "system/common/sys_module.h"

#include "system_definitions.h"

Graphe des dépendances par inclusion de main.c:
IMAGE

Fonctions
int main (void)

AAAAAAAACYAAAAAAAACYDocumentation des fonctions
int main (void )
AAAAAAAACZAAAAAAAACZ

Référence du fichier C:/microchip/harmony/v2_06/apps/1730_PortierWireless_InOut_04/firmware/src/Management.c
AAAAAAAADAAAAAAAAADA#include "Management.h"
#include "app.h"

#include "led.h"

#include "sound.h"

#include "Pairing.h"

#include "RF.h"

#include "peripheral/reset/plib_reset.h"

Graphe des dépendances par inclusion de Management.c:
IMAGE

Macros
#define DOOR_TIMEOUT 3100

#define BELL_TIMEOUT 3000

#define ANSWER_NR_MAX 50

Fonctions
void Door_Mgmt (void)
Gestion du bouton-poussoir de la porte avec filtre de pairing intégré.

void Bell_Mgmt (void)
Gestion de la carte de sonnerie (Bell_Mgmt).

AAAAAAAADBAAAAAAAADBDocumentation des macros
#define ANSWER_NR_MAX 50

AAAAAAAADCAAAAAAAADC#define BELL_TIMEOUT 3000
AAAAAAAADDAAAAAAAADD#define DOOR_TIMEOUT 3100
AAAAAAAADEAAAAAAAADE
AAAAAAAADFAAAAAAAADFDocumentation des fonctions
void Bell_Mgmt (void )
AAAAAAAADGAAAAAAAADG
Gestion de la carte de sonnerie (Bell_Mgmt).
Cette fonction gère la logique de la carte de sonnerie, y compris la réception des messages, la gestion des boutons de réponse, l'envoi des réponses, et la gestion des états associés.

◦ urveille les messages RF entrants pour déclencher la sonnerie ou répondre à une demande.
◦ ère les boutons physiques pour envoyer les réponses appropriées (entrez, attendez, occupé).
◦ ère les délais et le clignotement des LEDs selon l'état de la batterie et les réponses.
◦ ssure la synchronisation avec d'autres cartes de sonnerie si nécessaire.
Note
Cette fonction fait partie du module de gestion de la sonnerie (Bell_Mgmt).
void Door_Mgmt (void )
AAAAAAAADHAAAAAAAADH
Gestion du bouton-poussoir de la porte avec filtre de pairing intégré.
Cette fonction gère la logique associée au bouton-poussoir situé à la porte, incluant un filtre pour le processus de jumelage (pairing).

◦ urveille l'état du bouton-poussoir.
◦ pplique un filtre logiciel pour éviter les rebonds et les appuis involontaires.
◦ ntègre la gestion du pairing pour l'association des dispositifs sans fil.
Note
Cette fonction fait partie du module de gestion de la porte (Door_Mgmt).

Référence du fichier C:/microchip/harmony/v2_06/apps/1730_PortierWireless_InOut_04/firmware/src/Management.h
AAAAAAAADIAAAAAAAADI#include <stdint.h>
#include <stdbool.h>

#include "Mc32Debounce.h"

#include "app.h"

Graphe des dépendances par inclusion de Management.h:
IMAGE

Ce graphe montre quels fichiers incluent directement ou indirectement ce fichier :
IMAGE

Énumérations
enum DOOR_STATES { DOOR_STATE_INIT = 0, DOOR_STATE_PRESSED, DOOR_STATE_WAITING, DOOR_STATE_ANSWER, DOOR_STATE_NOANSWER, DOOR_STATE_SHUTDOWN }
enum BELL_STATES { BELL_STATE_INIT = 0, BELL_STATE_IDLE, BELL_STATE_RING }
Fonctions
void Door_Mgmt (void)
Gestion du bouton-poussoir de la porte avec filtre de pairing intégré.

void Bell_Mgmt (void)
Gestion de la carte de sonnerie (Bell_Mgmt).

Variables
S_SwitchDescriptor swRing
S_SwitchDescriptor swEnter
S_SwitchDescriptor swWait
S_SwitchDescriptor swBusy
APP_DATA appData

AAAAAAAADJAAAAAAAADJDocumentation du type de l'énumération
enum BELL_STATES
AAAAAAAADKAAAAAAAADK
Valeurs énumérées:
BELL_STATE_INITAAAAAAAADLAAAAAAAADL
BELL_STATE_IDLEAAAAAAAADMAAAAAAAADM
BELL_STATE_RINGAAAAAAAADNAAAAAAAADN
enum DOOR_STATES
AAAAAAAADOAAAAAAAADO
Valeurs énumérées:
DOOR_STATE_INITAAAAAAAADPAAAAAAAADP
DOOR_STATE_PRESSEDAAAAAAAADQAAAAAAAADQ
DOOR_STATE_WAITINGAAAAAAAADRAAAAAAAADR
DOOR_STATE_ANSWERAAAAAAAADSAAAAAAAADS
DOOR_STATE_NOANSWERAAAAAAAADTAAAAAAAADT
DOOR_STATE_SHUTDOWNAAAAAAAADUAAAAAAAADU

AAAAAAAADVAAAAAAAADVDocumentation des fonctions
void Bell_Mgmt (void )
AAAAAAAADWAAAAAAAADW
Gestion de la carte de sonnerie (Bell_Mgmt).
Cette fonction gère la logique de la carte de sonnerie, y compris la réception des messages, la gestion des boutons de réponse, l'envoi des réponses, et la gestion des états associés.

◦ urveille les messages RF entrants pour déclencher la sonnerie ou répondre à une demande.
◦ ère les boutons physiques pour envoyer les réponses appropriées (entrez, attendez, occupé).
◦ ère les délais et le clignotement des LEDs selon l'état de la batterie et les réponses.
◦ ssure la synchronisation avec d'autres cartes de sonnerie si nécessaire.
Note
Cette fonction fait partie du module de gestion de la sonnerie (Bell_Mgmt).
void Door_Mgmt (void )
AAAAAAAADXAAAAAAAADX
Gestion du bouton-poussoir de la porte avec filtre de pairing intégré.
Cette fonction gère la logique associée au bouton-poussoir situé à la porte, incluant un filtre pour le processus de jumelage (pairing).

◦ urveille l'état du bouton-poussoir.
◦ pplique un filtre logiciel pour éviter les rebonds et les appuis involontaires.
◦ ntègre la gestion du pairing pour l'association des dispositifs sans fil.
Note
Cette fonction fait partie du module de gestion de la porte (Door_Mgmt).

AAAAAAAADYAAAAAAAADYDocumentation des variables
APP_DATA appData[extern]
AAAAAAAADZAAAAAAAADZS_SwitchDescriptor swBusy[extern]
AAAAAAAAEAAAAAAAAAEAS_SwitchDescriptor swEnter[extern]
AAAAAAAAEBAAAAAAAAEBS_SwitchDescriptor swRing[extern]
AAAAAAAAECAAAAAAAAECS_SwitchDescriptor swWait[extern]
AAAAAAAAEDAAAAAAAAED

Management.h
AAAAAAAAACAAAAAAAAACAller à la documentation de ce fichier.

1 //--------------------------------------------------------
2 // DoorBellMgmt.h
3 //--------------------------------------------------------
4 // Header pour gestion Door et Bell du système PortierWireless
5 //
6 // Auteurs : Projet ETML / adaptation LMS
7 // Date : 2025
8 // Version : V3.0
9 // Compilateur : XC32
10 //--------------------------------------------------------
11
12 #ifndef DOORBELLMGMT_H
13 #define DOORBELLMGMT_H
14
15 //----------------------
16 // Inclusions
17 //----------------------
18 #include <stdint.h> // Types entiers standard
19 #include <stdbool.h> // Types booléens standard
20 #include "Mc32Debounce.h" // Gestion anti-rebond des boutons
21 #include "app.h" // Définition de APP_DATA
22
23 //----------------------
24 // Définitions d'états
25 //----------------------
26
27 // États internes pour la gestion de la porte (Door)
28 typedef enum
29 {
30 DOOR_STATE_INIT = 0, // Initialisation
31 DOOR_STATE_PRESSED, // Bouton pressé
32 DOOR_STATE_WAITING, // En attente de réponse
33 DOOR_STATE_ANSWER, // Réponse reçue
34 DOOR_STATE_NOANSWER, // Pas de réponse
35 DOOR_STATE_SHUTDOWN // Arrêt du système
36 } DOOR_STATES;
37
38 // États internes pour la gestion de la sonnette (Bell)
39 typedef enum
40 {
41 BELL_STATE_INIT = 0, // Initialisation
42 BELL_STATE_IDLE, // Attente (repos)
43 BELL_STATE_RING // Sonnerie active
44 } BELL_STATES;
45
46 //----------------------
47 // Prototypes de fonctions
48 //----------------------
49
50 // Gestion de la porte
51 void Door_Mgmt(void);
52
53 // Gestion de la sonnette
54 void Bell_Mgmt(void);
55
56 //----------------------
57 // Variables externes
58 //----------------------
59
60 // Descripteurs pour l'anti-rebond des boutons
61 extern S_SwitchDescriptor swRing; // Bouton de sonnerie
62 extern S_SwitchDescriptor swEnter; // Bouton d'entrée
63 extern S_SwitchDescriptor swWait; // Bouton d'attente
64 extern S_SwitchDescriptor swBusy; // Bouton d'occupation
65
66 // Données globales de l'application
67 extern APP_DATA appData;
68
69 #endif // DOORBELLMGMT_H

Référence du fichier C:/microchip/harmony/v2_06/apps/1730_PortierWireless_InOut_04/firmware/src/Mc32Debounce.c
AAAAAAAAEEAAAAAAAAEE#include "Mc32Debounce.h"
Graphe des dépendances par inclusion de Mc32Debounce.c:
IMAGE

Fonctions
void DoDebounce (S_SwitchDescriptor *Descriptor, bool InputValue)
!!!!!!!!!!!!!!!!!!!!!!!!!!!!!!!!!!!!!!!!!!!!!!!!!!!!!!!!!!!!!!!!!!!!!!!!!!!!!

void DebounceInit (S_SwitchDescriptor *pDescriptor)
bool DebounceGetInput (S_SwitchDescriptor *pDescriptor)
bool DebounceIsPressed (S_SwitchDescriptor *pDescriptor)
bool DebounceIsReleased (S_SwitchDescriptor *pDescriptor)
void DebounceClearPressed (S_SwitchDescriptor *pDescriptor)
void DebounceClearReleased (S_SwitchDescriptor *pDescriptor)
Variables
const uint8_t MaxDebounceCount = 5

AAAAAAAAEFAAAAAAAAEFDocumentation des fonctions
void DebounceClearPressed (S_SwitchDescriptor * pDescriptor)
AAAAAAAAEGAAAAAAAAEGvoid DebounceClearReleased (S_SwitchDescriptor * pDescriptor)
AAAAAAAAEHAAAAAAAAEHbool DebounceGetInput (S_SwitchDescriptor * pDescriptor)
AAAAAAAAEIAAAAAAAAEIvoid DebounceInit (S_SwitchDescriptor * pDescriptor)
AAAAAAAAEJAAAAAAAAEJbool DebounceIsPressed (S_SwitchDescriptor * pDescriptor)
AAAAAAAAEKAAAAAAAAEKbool DebounceIsReleased (S_SwitchDescriptor * pDescriptor)
AAAAAAAAELAAAAAAAAELvoid DoDebounce (S_SwitchDescriptor * Descriptor, bool InputValue)
AAAAAAAAEMAAAAAAAAEM
!!!!!!!!!!!!!!!!!!!!!!!!!!!!!!!!!!!!!!!!!!!!!!!!!!!!!!!!!!!!!!!!!!!!!!!!!!!!!
!!!!!!!!!!!!!!!!!!!!!!!!!!!!!!!!!!!!!!!!!!!!!!!!!!!!!!!!!!!!!!!!!!!!!!!!!!!!!

AAAAAAAAENAAAAAAAAENDocumentation des variables
const uint8_t MaxDebounceCount = 5
AAAAAAAAEOAAAAAAAAEO

Référence du fichier C:/microchip/harmony/v2_06/apps/1730_PortierWireless_InOut_04/firmware/src/Mc32Debounce.h
AAAAAAAAEPAAAAAAAAEP#include <stdbool.h>
#include <stdint.h>

Graphe des dépendances par inclusion de Mc32Debounce.h:
IMAGE

Ce graphe montre quels fichiers incluent directement ou indirectement ce fichier :
IMAGE

Classes
struct s_bitsstruct S_SwitchDescriptor
Énumérations
enum E_DebouceStates { DebounceWaitChange, DebounceWaitStable }
Fonctions
void DoDebounce (S_SwitchDescriptor *Descriptor, bool InputValue)
!!!!!!!!!!!!!!!!!!!!!!!!!!!!!!!!!!!!!!!!!!!!!!!!!!!!!!!!!!!!!!!!!!!!!!!!!!!!!

void DebounceInit (S_SwitchDescriptor *pDescriptor)
bool DebounceGetInput (S_SwitchDescriptor *pDescriptor)
bool DebounceIsPressed (S_SwitchDescriptor *pDescriptor)
bool DebounceIsReleased (S_SwitchDescriptor *pDescriptor)
void DebounceClearPressed (S_SwitchDescriptor *pDescriptor)
void DebounceClearReleased (S_SwitchDescriptor *pDescriptor)

AAAAAAAAEQAAAAAAAAEQDocumentation du type de l'énumération
enum E_DebouceStates
AAAAAAAAERAAAAAAAAER
Valeurs énumérées:
DebounceWaitChangeAAAAAAAAESAAAAAAAAES
DebounceWaitStableAAAAAAAAETAAAAAAAAET

AAAAAAAAEUAAAAAAAAEUDocumentation des fonctions
void DebounceClearPressed (S_SwitchDescriptor * pDescriptor)
AAAAAAAAEVAAAAAAAAEVvoid DebounceClearReleased (S_SwitchDescriptor * pDescriptor)
AAAAAAAAEWAAAAAAAAEWbool DebounceGetInput (S_SwitchDescriptor * pDescriptor)
AAAAAAAAEXAAAAAAAAEXvoid DebounceInit (S_SwitchDescriptor * pDescriptor)
AAAAAAAAEYAAAAAAAAEYbool DebounceIsPressed (S_SwitchDescriptor * pDescriptor)
AAAAAAAAEZAAAAAAAAEZbool DebounceIsReleased (S_SwitchDescriptor * pDescriptor)
AAAAAAAAFAAAAAAAAAFAvoid DoDebounce (S_SwitchDescriptor * Descriptor, bool InputValue)
AAAAAAAAFBAAAAAAAAFB
!!!!!!!!!!!!!!!!!!!!!!!!!!!!!!!!!!!!!!!!!!!!!!!!!!!!!!!!!!!!!!!!!!!!!!!!!!!!!
!!!!!!!!!!!!!!!!!!!!!!!!!!!!!!!!!!!!!!!!!!!!!!!!!!!!!!!!!!!!!!!!!!!!!!!!!!!!!

Mc32Debounce.h
AAAAAAAAADAAAAAAAAADAller à la documentation de ce fichier.

1 #ifndef MC32DEBOUNCE2_H
2 #define MC32DEBOUNCE2_H
3
4
5 // Mc32Debounce.h
6
7 // C. HUBER 19/02/2014 Portage sur PIC32MX
8 // Attention int1 transformé en uint8
9
10 // Fonctions pour la gestion de l'anti-rebond d'un switch
11 //
12 //
13 // Principe : Il est nécessaire d'appeler cycliquement la fonction DoDebounce
14 // pour chaque switch. Suggestion cycle de 1 ms
15 //
16 // Pour la gestion du switch, il y a 3 fonctions à disposition :
17 // DebounceGetInput fourni l'état du switch aprés anti-rebond
18 // DebounceIsPressed true indique que l'on vient de presser la touche
19 // DebounceIsReleased true indique que l'on vient de relacher la touche
20 // DebounceClearPressed annule indication de pression sur la touche
21 // DebounceClearReleased annule indication de relachement de la touche
22 //
23 // Remarques : toute les fonctions utilisent un descripteur de touche
24 // un état 0 indique une touche pressée
25 //
26 //---------------------------------------------------------------------------
27
28 #include <stdbool.h>
29 #include <stdint.h>
30
31 // définitions des types qui seront utilisés dans cette application
32
33 // Etats du système antirebond
34 typedef enum {
35 DebounceWaitChange,
36 DebounceWaitStable,
37 } E_DebouceStates;
38
39 // New
40 typedef struct {
41 uint8_t KeyPressed :1; // événement touche pressée
42 uint8_t KeyReleased : 1; // événement touche relachée
43 uint8_t KeyPrevInputValue : 1; // valeur précédente de la touche
44 uint8_t KeyValue : 1; // valeur finale (image) de la touche
45 } s_bits;
46
47 // structure du descripteur
48 typedef struct {
49 E_DebouceStates DebounceState; // état de l'antirebond
50 uint8_t DebounceCounter; // compteur
51 s_bits bits;
52 } S_SwitchDescriptor;
53
55 // POUR CHAQUE SWITCH DONT ON VEUT EFFECTUER L'ANTI-REBOND DANS L'APPLICATION.
56 // IL FAUDRA DEFINIR UNE VARIABLE DU TYPE S_SwitchDescriptor
58 //
59 //
60 // DoDebounce (S_SwitchDescriptor *Descriptor, boolean InputValue)
61 // Routine effectuant la gestion de l'anti-rebond d'un switch
62 // dont l'adresse de la structure est passée en paramètre.
63 // La valeur du switch lue sur le port est a passer lors de l'appel
64 //
65 // Entrée: un pointeur sur la structure du switch
66 // la valeur du switch lue sur le port
67 //
68 // Sortie: la structure mise à jour
69 // le bit KeyValue qui donne la valeur du switch après anti-rebond
70 // le bit KeyPressed qui est mis à 1 dès que l'on presse sur le switch
71 // ce bit n'est pas resetté par cette fonction mais doit l'être par l'application
72 // si elle l'utilise.
73 // le bit KeyReleased qui est mis à 1 dès que l'on relâche sur le switch
74 // ce bit n'est pas resetté par cette fonction mais doit l'être par l'application
75 // si elle l'utilise
76 //
77
78 void DoDebounce (S_SwitchDescriptor *Descriptor, bool InputValue);
79
80
81 /********************************************************************************************/
82 // DebounceInit (S_SwitchDescriptor *pDescriptor) :
83 // Routine effectuant l'initialisation de la structure d'un switch
84 // dont l'adresse de la structure est passée en paramètre.
85 //
86 // Entrée: un pointeur sur la structure du switch
87 //
88
89 void DebounceInit (S_SwitchDescriptor *pDescriptor);
90
91 // DebounceGetInput fourni l'état du switch aprés anti-rebond
92 bool DebounceGetInput (S_SwitchDescriptor *pDescriptor);
93
94 // DebounceIsPressed true indique que l'on vient de presser la touche
95 bool DebounceIsPressed (S_SwitchDescriptor *pDescriptor);
96
97 // DebounceIsReleased true indique que l'on vient de relacher la touche
98 bool DebounceIsReleased (S_SwitchDescriptor *pDescriptor);
99
100 // DebounceClearPressed annule indication de pression sur la touche
101 void DebounceClearPressed (S_SwitchDescriptor *pDescriptor);
102
103 // DebounceClearReleased annule indication de relachement de la touche
104 void DebounceClearReleased (S_SwitchDescriptor *pDescriptor);
105
106 #endif

Référence du fichier C:/microchip/harmony/v2_06/apps/1730_PortierWireless_InOut_04/firmware/src/Mc32Delays.c
AAAAAAAAFCAAAAAAAAFC#include "Mc32Delays.h"
#include <xc.h>

#include <stdint.h>

Graphe des dépendances par inclusion de Mc32Delays.c:
IMAGE

Macros
#define SYS_FREQ (10000000L)

#define TICK_CT_MS (SYS_FREQ / 2000L)

#define TICK_CT_US (SYS_FREQ / 2000000L)

#define TICK_OVERHEAD 0

Fonctions
void __attribute__ ((optimize("-O0")))

AAAAAAAAFDAAAAAAAAFDDocumentation des macros
#define SYS_FREQ (10000000L)

AAAAAAAAFEAAAAAAAAFE#define TICK_CT_MS (SYS_FREQ / 2000L)
AAAAAAAAFFAAAAAAAAFF#define TICK_CT_US (SYS_FREQ / 2000000L)
AAAAAAAAFGAAAAAAAAFG#define TICK_OVERHEAD 0
AAAAAAAAFHAAAAAAAAFH
AAAAAAAAFIAAAAAAAAFIDocumentation des fonctions
void __attribute__ ((optimize("-O0")) )
AAAAAAAAFJAAAAAAAAFJ

Référence du fichier C:/microchip/harmony/v2_06/apps/1730_PortierWireless_InOut_04/firmware/src/Mc32Delays.h
AAAAAAAAFKAAAAAAAAFKCe graphe montre quels fichiers incluent directement ou indirectement ce fichier :
IMAGE

Macros
#define delay_cycle()

Fonctions
void delay_msCt (unsigned int NbMs)
void delay_usCt (unsigned int NbUs)
void delay500nsCt (void)

AAAAAAAAFLAAAAAAAAFLDocumentation des macros
#define delay_cycle()

AAAAAAAAFMAAAAAAAAFMValeur :
__asm__( "nop" )

AAAAAAAAFNAAAAAAAAFNDocumentation des fonctions
void delay500nsCt (void )
AAAAAAAAFOAAAAAAAAFOvoid delay_msCt (unsigned int NbMs)
AAAAAAAAFPAAAAAAAAFPvoid delay_usCt (unsigned int NbUs)
AAAAAAAAFQAAAAAAAAFQ

Mc32Delays.h
AAAAAAAAAEAAAAAAAAAEAller à la documentation de ce fichier.

1 #ifndef __MC32DELAYS_H
2 #define __MC32DELAYS_H
3 /*--------------------------------------------------------*/
4 // Mc32Delays.h
5 /*--------------------------------------------------------*/
6 // Description : Adaptation des fonctions de delay afin
7 // de pouvoir utiliser la même syntaxe
8 // que sous CCS.
9 //
10 // Auteur : F. Dominé
11 //
12 // Version : V1.0
13 // Compilateur : C32 V2.01
14 //
15 /*--------------------------------------------------------*/
16
17
18 /*--------------------------------------------------------*/
19 // Définition des fonctions prototypes
20 /*--------------------------------------------------------*/
21 // Quelques commentaires:
22 // Avec notre configuration, le temps nécessire pour passer
23 // une sortie à 0 puis à 1 est denviron 65ns
24 // En ajoutant un nop, on obtient environ 100ns
25 // On peut en conclure que le temps de cycle est de 33ns
26 #define delay_cycle() __asm__( "nop" )
27 //void delay500ns(); // nécessaire pour lcd
28 //void delay_us(unsigned int); // 32 bits
29 //void delay_ms(unsigned int); // 32 bits
30
31 //Fonctions basées sur Core Timer
32 void delay_msCt(unsigned int NbMs);
33 void delay_usCt(unsigned int NbUs);
34 void delay500nsCt(void);
35
36
37 #endif

Référence du fichier C:/microchip/harmony/v2_06/apps/1730_PortierWireless_InOut_04/firmware/src/Pairing.c
AAAAAAAAFRAAAAAAAAFR#include "app.h"
#include <stdio.h>

#include <string.h>

#include "driver/nvm/drv_nvm.h"

#include "led.h"

#include "Mc32Debounce.h"

#include "Mc32Delays.h"

#include "Pairing.h"

#include "RF.h"

#include "sound.h"

Graphe des dépendances par inclusion de Pairing.c:
IMAGE

Énumérations
enum BellState { BELL_IDLE, BELL_SEND_P0, BELL_SEND_P1, BELL_WAIT_ACK, BELL_DONE }
enum DoorState { DOOR_IDLE, DOOR_WAIT_P, DOOR_SEND_A0, DOOR_SEND_A1, DOOR_DONE }
Fonctions
Serial_IsPairingRunningIndique si une procédure d'appairage est en cours.
Renvoie
true si l'appairage est en cours, false sinon.
bool Serial_IsPairingRunning (void)
NVM_OpenDriverOuvre le driver NVM si ce n'est pas déjà fait.
SaveSerialHarmonySauvegarde le numéro de série appairé en mémoire non volatile (NVM).
Paramètres
serial | Numéro de série à sauvegarder.
LoadSerialHarmonyCharge le numéro de série appairé depuis la mémoire non volatile (NVM).
Renvoie
Le numéro de série chargé, ou 0 si non valide.
SavePairedSerialToFlashSauvegarde le numéro de série appairé courant en mémoire flash.
void SavePairedSerialToFlash (void)
LoadPairedSerialAndApplyCharge le numéro de série appairé depuis la flash et l'applique à l'application.
void LoadPairedSerialAndApply (void)
GetActifSerialNbrRetourne le numéro de série actuellement actif (appairé).
Renvoie
Le numéro de série appairé.
uint32_t GetActifSerialNbr (void)
ResetSerialListRéinitialise la liste des numéros de série et l'état d'appairage.
void ResetSerialList (void)
ShowPairingSuccessIndique visuellement et auditivement le succès de l'appairage.
void ShowPairingSuccess (void)
PairingReset_DoResetEffectue la réinitialisation de l'appairage.
Cette fonction réinitialise la liste des numéros de série appairés, efface la mémoire flash correspondante, remet l'état d'appairage à zéro, et effectue une indication visuelle et sonore de la réinitialisation.
Renvoie
void
PairingReset_DoorTaskTâche de surveillance du bouton d'appairage pour la porte (Door).
Déclenche une réinitialisation de l'appairage si le bouton swRing est maintenu appuyé suffisamment longtemps (appui long).
Renvoie
void
void PairingReset_DoorTask (void)
PairingReset_BellTaskTâche de surveillance des boutons d'appairage pour la sonnette (Bell).
Déclenche une réinitialisation de l'appairage si les trois boutons (swEnter, swWait, swBusy) sont maintenus appuyés simultanément suffisamment longtemps (appui long).
Renvoie
void
void PairingReset_BellTask (void)
void RF_SendWithSerial (uint8_t *payload)
Envoie une trame RF avec le numéro de série, en utilisant P0 et P1.

bool Serial_CheckIfFromPaired (uint8_t *msg)
Vérifie si le message RF reçu provient du périphérique appairé.

uint32_t PairingManagement (void)
Gère la procédure complète d'appairage côté Door ou Bell.

AAAAAAAAFSAAAAAAAAFSDocumentation du type de l'énumération
enum BellState
AAAAAAAAFTAAAAAAAAFT
Valeurs énumérées:
BELL_IDLEAAAAAAAAFUAAAAAAAAFU
BELL_SEND_P0AAAAAAAAFVAAAAAAAAFV
BELL_SEND_P1AAAAAAAAFWAAAAAAAAFW
BELL_WAIT_ACKAAAAAAAAFXAAAAAAAAFX
BELL_DONEAAAAAAAAFYAAAAAAAAFY
enum DoorState
AAAAAAAAFZAAAAAAAAFZ
Valeurs énumérées:
DOOR_IDLEAAAAAAAAGAAAAAAAAAGA
DOOR_WAIT_PAAAAAAAAGBAAAAAAAAGB
DOOR_SEND_A0AAAAAAAAGCAAAAAAAAGC
DOOR_SEND_A1AAAAAAAAGDAAAAAAAAGD
DOOR_DONEAAAAAAAAGEAAAAAAAAGE

AAAAAAAAGFAAAAAAAAGFDocumentation des fonctions
uint32_t GetActifSerialNbr (void )
AAAAAAAAGGAAAAAAAAGGvoid LoadPairedSerialAndApply (void )
AAAAAAAAGHAAAAAAAAGHuint32_t PairingManagement (void )
AAAAAAAAGIAAAAAAAAGI
Gère la procédure complète d'appairage côté Door ou Bell.
Cette fonction implémente la machine d'état d'appairage pour les deux rôles (Door/Bell). Elle pilote l'envoi/réception des trames, la sauvegarde du numéro de série appairé, l'affichage du succès, et la sortie de la procédure.
Renvoie
Le numéro de série appairé si l'appairage est terminé, 0 sinon.
void PairingReset_BellTask (void )
AAAAAAAAGJAAAAAAAAGJvoid PairingReset_DoorTask (void )
AAAAAAAAGKAAAAAAAAGKvoid ResetSerialList (void )
AAAAAAAAGLAAAAAAAAGLvoid RF_SendWithSerial (uint8_t * payload)
AAAAAAAAGMAAAAAAAAGM
Envoie une trame RF avec le numéro de série, en utilisant P0 et P1.

Paramètres
payload | Pointeur vers la charge utile à envoyer.
void SavePairedSerialToFlash (void )
AAAAAAAAGNAAAAAAAAGNbool Serial_CheckIfFromPaired (uint8_t * msg)
AAAAAAAAGOAAAAAAAAGO
Vérifie si le message RF reçu provient du périphérique appairé.

Paramètres
msg | Pointeur vers le message RF reçu.
Renvoie true si le message provient du périphérique appairé, false sinon.
bool Serial_IsPairingRunning (void )
AAAAAAAAGPAAAAAAAAGPvoid ShowPairingSuccess (void )
AAAAAAAAGQAAAAAAAAGQ

Référence du fichier C:/microchip/harmony/v2_06/apps/1730_PortierWireless_InOut_04/firmware/src/Pairing.h
AAAAAAAAGRAAAAAAAAGRCe graphe montre quels fichiers incluent directement ou indirectement ce fichier :
IMAGE

Macros
#define NVM_SERIAL_BLOCK 0

#define LONG_PRESS_TICKS 300

Fonctions
void LoadPairedSerialAndApply (void)
void SavePairedSerialToFlash (void)
uint32_t GetActifSerialNbr (void)
void ResetSerialList (void)
uint32_t PairingManagement (void)
Gère la procédure complète d'appairage côté Door ou Bell.

void PairingReset_DoorTask (void)
void PairingReset_BellTask (void)
bool Serial_IsPairingRunning (void)
bool Serial_CheckIfFromPaired (uint8_t *msg)
Vérifie si le message RF reçu provient du périphérique appairé.

void RF_SendWithSerial (uint8_t *payload)
Envoie une trame RF avec le numéro de série, en utilisant P0 et P1.

void ShowPairingSuccess (void)
void TestFlashWriteRead (void)
Variables
S_SwitchDescriptor swRing
S_SwitchDescriptor swEnter
S_SwitchDescriptor swWait
S_SwitchDescriptor swBusy
uint32_t appPairedSerial

AAAAAAAAGSAAAAAAAAGSDocumentation des macros
#define LONG_PRESS_TICKS 300

AAAAAAAAGTAAAAAAAAGT#define NVM_SERIAL_BLOCK 0
AAAAAAAAGUAAAAAAAAGU
AAAAAAAAGVAAAAAAAAGVDocumentation des fonctions
uint32_t GetActifSerialNbr (void )
AAAAAAAAGWAAAAAAAAGWvoid LoadPairedSerialAndApply (void )
AAAAAAAAGXAAAAAAAAGXuint32_t PairingManagement (void )
AAAAAAAAGYAAAAAAAAGY
Gère la procédure complète d'appairage côté Door ou Bell.
Cette fonction implémente la machine d'état d'appairage pour les deux rôles (Door/Bell). Elle pilote l'envoi/réception des trames, la sauvegarde du numéro de série appairé, l'affichage du succès, et la sortie de la procédure.
Renvoie
Le numéro de série appairé si l'appairage est terminé, 0 sinon.
void PairingReset_BellTask (void )
AAAAAAAAGZAAAAAAAAGZvoid PairingReset_DoorTask (void )
AAAAAAAAHAAAAAAAAAHAvoid ResetSerialList (void )
AAAAAAAAHBAAAAAAAAHBvoid RF_SendWithSerial (uint8_t * payload)
AAAAAAAAHCAAAAAAAAHC
Envoie une trame RF avec le numéro de série, en utilisant P0 et P1.

Paramètres
payload | Pointeur vers la charge utile à envoyer.
void SavePairedSerialToFlash (void )
AAAAAAAAHDAAAAAAAAHDbool Serial_CheckIfFromPaired (uint8_t * msg)
AAAAAAAAHEAAAAAAAAHE
Vérifie si le message RF reçu provient du périphérique appairé.

Paramètres
msg | Pointeur vers le message RF reçu.
Renvoie true si le message provient du périphérique appairé, false sinon.
bool Serial_IsPairingRunning (void )
AAAAAAAAHFAAAAAAAAHFvoid ShowPairingSuccess (void )
AAAAAAAAHGAAAAAAAAHGvoid TestFlashWriteRead (void )
AAAAAAAAHHAAAAAAAAHH
AAAAAAAAHIAAAAAAAAHIDocumentation des variables
uint32_t appPairedSerial[extern]
AAAAAAAAHJAAAAAAAAHJS_SwitchDescriptor swBusy[extern]
AAAAAAAAHKAAAAAAAAHKS_SwitchDescriptor swEnter[extern]
AAAAAAAAHLAAAAAAAAHLS_SwitchDescriptor swRing[extern]
AAAAAAAAHMAAAAAAAAHMS_SwitchDescriptor swWait[extern]
AAAAAAAAHNAAAAAAAAHN

Pairing.h
AAAAAAAAAFAAAAAAAAAFAller à la documentation de ce fichier.

1 /*
2 * Pairing.c
3 * Gestion de l'appairage Door / Bell
4 * - Envoi automatique des trames P0 / P1 / A0 / A1 (non bloquant)
5 * - Reset d'appairage par appui long (Door : swRing, Bell : trois boutons)
6 * - Sauvegarde / lecture du numéro appairé en Flash (Harmony NVM)
7 *
8 * MCU : PIC32MX130F064B
9 * Outils : XC32 v2.50, Harmony v2_06
10 * Auteurs : Projet PortierWireless LMS
11 * ---------------------------------------------------------------------------
12
13 #ifndef PAIRING_H // Protection contre l'inclusion multiple du fichier d'en-tête
14 #define PAIRING_H
15
16 #include <stdint.h> // Inclusion des définitions de types entiers standard
17 #include <stdbool.h> // Inclusion du type booléen standard
18 /* === Constantes === */
19 #define NVM_SERIAL_BLOCK 0 // Bloc mémoire NVM utilisé pour le numéro de série
20 #define LONG_PRESS_TICKS 300 // Nombre de ticks pour un appui long
21
22 /* === Déclarations externes === */
23 extern S_SwitchDescriptor swRing; // Descripteur du bouton Ring
24 extern S_SwitchDescriptor swEnter; // Descripteur du bouton Enter
25 extern S_SwitchDescriptor swWait; // Descripteur du bouton Wait
26 extern S_SwitchDescriptor swBusy; // Descripteur du bouton Busy
27 extern uint32_t appPairedSerial; // Numéro de série appairé courant
28
29 /* === Fonctions publiques === */
30
31 /* Accès au numéro de série appairé */
32 void LoadPairedSerialAndApply(void); // Charge le numéro appairé depuis la Flash et l'applique en RAM
33 void SavePairedSerialToFlash(void); // Sauvegarde le numéro appairé courant en mémoire non-volatile
34 uint32_t GetActifSerialNbr(void); // Retourne le numéro de série appairé actif
35 void ResetSerialList(void); // Réinitialise la liste des numéros appairés
36
37 /* Automate d'appairage complet */
38 uint32_t PairingManagement(void); // Gère l'automate d'appairage, retourne le numéro appairé (0 si non appairé)
39
40 /* Reset d'appairage (appui long) */
41 void PairingReset_DoorTask(void); // Gestion du reset d'appairage côté Door
42 void PairingReset_BellTask(void); // Gestion du reset d'appairage côté Bell
43
44 /* Statut global du pairing */
45 bool Serial_IsPairingRunning(void); // Retourne true si l'appairage est en cours
46
47 /* Filtrage & envoi de trames RF */
48 bool Serial_CheckIfFromPaired(uint8_t *msg); // Vérifie si la trame reçue provient du numéro appairé
49 void RF_SendWithSerial(uint8_t *payload); // Envoie une trame RF avec le numéro de série appairé
50
51 /* Visuel / sonore */
52 void ShowPairingSuccess(void); // Indique le succès de l'appairage (bip + LED verte)
53
54 /* Tests Flash (optionnel) */
55 void TestFlashWriteRead(void); // Teste l'écriture/lecture du numéro appairé en Flash
56
57 /* === Fonctions internes (statics, à usage privé) === */
58 static void SaveSerialHarmony(uint32_t serial); // Sauvegarde un numéro de série en Flash (interne)
59 static uint32_t LoadSerialHarmony(void); // Charge un numéro de série depuis la Flash (interne)
60 static void PairingReset_DoReset(void); // Effectue le reset d'appairage (interne)
61 static void RF_SendP0(void); // Envoie une trame P0 (interne)
62 static void RF_SendP1(void); // Envoie une trame P1 (interne)
63 static void RF_SendA0(uint32_t serial); // Envoie une trame A0 avec numéro de série (interne)
64 static void RF_SendA1(uint32_t serial); // Envoie une trame A1 avec numéro de série (interne)
65 static void HandlePairingMessage(uint8_t* msg); // Traite un message d'appairage (interne)
66
67 #endif /* PAIRING_H */ // Fin de la protection contre l'inclusion multiple

Référence du fichier C:/microchip/harmony/v2_06/apps/1730_PortierWireless_InOut_04/firmware/src/RF.c
AAAAAAAAHOAAAAAAAAHO#include "RF.h"
#include <xc.h>

#include "Mc32Delays.h"

#include "peripheral/usart/plib_usart.h"

#include <string.h>

#include "system_definitions.h"

#include <stdio.h>

Graphe des dépendances par inclusion de RF.c:
IMAGE

Macros
#define MAXMSG 64

Fonctions
uint32_t RF_GetLastSenderSerial (void)
void RF_RecordSenderSerial (uint8_t *msg)
uint8_t ReadSerialNbr (uint32_t *serialInput)
void RF_Init (void)
void RF_SendMessage (uint8_t *dataToSend, uint8_t nbBytesToSend)
bool isNewFrame (uint8_t *rcvdMsg)
bool RF_GetMessage (uint8_t *msg)
uint32_t getSerialRF ()
Variables
uint8_t flagGetAdress = 0
uint8_t flagErrorAdress = 0
uint32_t nbrSerialRF = 0
uint8_t rcvdMsg [64]
uint8_t rcdvCharCntr = 0
bool flagGetMsgUart = false
DRV_HANDLE handleUSART

AAAAAAAAHPAAAAAAAAHPDocumentation des macros
#define MAXMSG 64

AAAAAAAAHQAAAAAAAAHQ
AAAAAAAAHRAAAAAAAAHRDocumentation des fonctions
uint32_t getSerialRF (void )
AAAAAAAAHSAAAAAAAAHSbool isNewFrame (uint8_t * rcvdMsg)
AAAAAAAAHTAAAAAAAAHTuint8_t ReadSerialNbr (uint32_t * serialInput)
AAAAAAAAHUAAAAAAAAHUuint32_t RF_GetLastSenderSerial (void )
AAAAAAAAHVAAAAAAAAHVbool RF_GetMessage (uint8_t * msg)
AAAAAAAAHWAAAAAAAAHWvoid RF_Init (void )
AAAAAAAAHXAAAAAAAAHXvoid RF_RecordSenderSerial (uint8_t * msg)
AAAAAAAAHYAAAAAAAAHYvoid RF_SendMessage (uint8_t * dataToSend, uint8_t nbBytesToSend)
AAAAAAAAHZAAAAAAAAHZ
AAAAAAAAIAAAAAAAAAIADocumentation des variables
uint8_t flagErrorAdress = 0
AAAAAAAAIBAAAAAAAAIBuint8_t flagGetAdress = 0
AAAAAAAAICAAAAAAAAICbool flagGetMsgUart = false
AAAAAAAAIDAAAAAAAAIDDRV_HANDLE handleUSART
AAAAAAAAIEAAAAAAAAIEuint32_t nbrSerialRF = 0
AAAAAAAAIFAAAAAAAAIFuint8_t rcdvCharCntr = 0
AAAAAAAAIGAAAAAAAAIGuint8_t rcvdMsg[64]
AAAAAAAAIHAAAAAAAAIH

Référence du fichier C:/microchip/harmony/v2_06/apps/1730_PortierWireless_InOut_04/firmware/src/RF.h
AAAAAAAAIIAAAAAAAAII#include <stdint.h>
#include <stdbool.h>

Graphe des dépendances par inclusion de RF.h:
IMAGE

Ce graphe montre quels fichiers incluent directement ou indirectement ce fichier :
IMAGE

Fonctions
void RF_Init (void)
void RF_SendMessage (uint8_t *dataToSend, uint8_t nbBytesToSend)
bool RF_GetMessage (uint8_t *msg)
uint32_t getSerialRF (void)
uint32_t RF_GetLastSenderSerial (void)
void RF_RecordSenderSerial (uint8_t *msg)

AAAAAAAAIJAAAAAAAAIJDocumentation des fonctions
uint32_t getSerialRF (void )
AAAAAAAAIKAAAAAAAAIKuint32_t RF_GetLastSenderSerial (void )
AAAAAAAAILAAAAAAAAILbool RF_GetMessage (uint8_t * msg)
AAAAAAAAIMAAAAAAAAIMvoid RF_Init (void )
AAAAAAAAINAAAAAAAAINvoid RF_RecordSenderSerial (uint8_t * msg)
AAAAAAAAIOAAAAAAAAIOvoid RF_SendMessage (uint8_t * dataToSend, uint8_t nbBytesToSend)
AAAAAAAAIPAAAAAAAAIP

RF.h
AAAAAAAAAGAAAAAAAAAGAller à la documentation de ce fichier.

1 //--------------------------------------------------------
2 // RF.h
3 //--------------------------------------------------------
4 // Gestion communication
5 //
6 // Auteur : SCA
7 // Date : 5.12.2019
8 // Version : V1.0
9 // Compilateur : XC32 V2.15
10 // Modifications :
11 // -
12 /*--------------------------------------------------------*/
13
14 #ifndef _RF_H /* Guard against multiple inclusion */
15 #define _RF_H
16
17 #include <stdint.h>
18 #include <stdbool.h>
19
20 /* ************************************************************************** */
21
22
23 /* ************************************************************************** */
24
25
26
27 /* ************************************************************************** */
28
29 void RF_Init(void);
30 void RF_SendMessage(uint8_t* dataToSend, uint8_t nbBytesToSend);
31 bool RF_GetMessage(uint8_t* msg);
32 uint32_t getSerialRF(void);
33 uint32_t RF_GetLastSenderSerial(void);
34 void RF_RecordSenderSerial(uint8_t* msg);
35 #endif /* _RF_H */
36
37 /* *****************************************************************************
38 End of File
39 */

Référence du fichier C:/microchip/harmony/v2_06/apps/1730_PortierWireless_InOut_04/firmware/src/sound.c
AAAAAAAAIQAAAAAAAAIQ#include "sound.h"
#include "peripheral/oc/plib_oc.h"

#include "peripheral/tmr/plib_tmr.h"

Graphe des dépendances par inclusion de sound.c:
IMAGE

Macros
#define DO3 262

#define RE3 294

#define MI3 330

#define FA3 349

#define SOL3 392

#define LA3 440

#define SI3 494

#define DO4 523

#define RE4 587

#define MI4 659

#define FA4 699

#define SOL4 784

#define LA4 880

#define SI4 988

#define DO5 1047

#define F_TMR_CLK 10000000

Énumérations
enum SOUND_STATES { SOUND_STATE_INIT =0, SOUND_STATE_IDLE, SOUND_STATE_PLAYING }
Fonctions
void SetNote (uint16_t freq)
void Sound_Init (void)
void Sound_Start (const NOTE_t *sound)
bool Sound_IsIdle (void)
void Sound_Mgmt (void)
Variables
const NOTE_t RING [10]
const NOTE_t SUCCESS [10]
const NOTE_t ERROR [10]
SOUND_STATES soundState
NOTE_t * currentNotes
uint16_t currentNoteIndex
uint16_t currentNoteDuration

AAAAAAAAIRAAAAAAAAIRDocumentation des macros
#define DO3 262

AAAAAAAAISAAAAAAAAIS#define DO4 523
AAAAAAAAITAAAAAAAAIT#define DO5 1047
AAAAAAAAIUAAAAAAAAIU#define F_TMR_CLK 10000000
AAAAAAAAIVAAAAAAAAIV#define FA3 349
AAAAAAAAIWAAAAAAAAIW#define FA4 699
AAAAAAAAIXAAAAAAAAIX#define LA3 440
AAAAAAAAIYAAAAAAAAIY#define LA4 880
AAAAAAAAIZAAAAAAAAIZ#define MI3 330
AAAAAAAAJAAAAAAAAAJA#define MI4 659
AAAAAAAAJBAAAAAAAAJB#define RE3 294
AAAAAAAAJCAAAAAAAAJC#define RE4 587
AAAAAAAAJDAAAAAAAAJD#define SI3 494
AAAAAAAAJEAAAAAAAAJE#define SI4 988
AAAAAAAAJFAAAAAAAAJF#define SOL3 392
AAAAAAAAJGAAAAAAAAJG#define SOL4 784
AAAAAAAAJHAAAAAAAAJH
AAAAAAAAJIAAAAAAAAJIDocumentation du type de l'énumération
enum SOUND_STATES
AAAAAAAAJJAAAAAAAAJJ
Valeurs énumérées:
SOUND_STATE_INITAAAAAAAAJKAAAAAAAAJK
SOUND_STATE_IDLEAAAAAAAAJLAAAAAAAAJL
SOUND_STATE_PLAYINGAAAAAAAAJMAAAAAAAAJM

AAAAAAAAJNAAAAAAAAJNDocumentation des fonctions
void SetNote (uint16_t freq)
AAAAAAAAJOAAAAAAAAJOvoid Sound_Init (void )
AAAAAAAAJPAAAAAAAAJPbool Sound_IsIdle (void )
AAAAAAAAJQAAAAAAAAJQvoid Sound_Mgmt (void )
AAAAAAAAJRAAAAAAAAJRvoid Sound_Start (const NOTE_t * sound)
AAAAAAAAJSAAAAAAAAJS
AAAAAAAAJTAAAAAAAAJTDocumentation des variables
uint16_t currentNoteDuration
AAAAAAAAJUAAAAAAAAJUuint16_t currentNoteIndex
AAAAAAAAJVAAAAAAAAJVNOTE_t* currentNotes
AAAAAAAAJWAAAAAAAAJWconst NOTE_t ERROR[10]
AAAAAAAAJXAAAAAAAAJXValeur initiale :
=
{{.duration=150,.freq=SI3},
{.duration=150,.freq=LA3},
{.duration=150,.freq=SOL3},
{.duration=150,.freq=FA3},
{.duration=0,.freq=0},
{.duration=0,.freq=0},
{.duration=0,.freq=0},
{.duration=0,.freq=0},
{.duration=0,.freq=0},
{.duration=0,.freq=0}}
const NOTE_t RING[10]
AAAAAAAAJYAAAAAAAAJYValeur initiale :
=

{{.duration=200,.freq=DO4},
{.duration=200,.freq=RE4},
{.duration=200,.freq=MI4},
{.duration=200,.freq=FA4},
{.duration=200,.freq=SOL4},
{.duration=200,.freq=LA4},
{.duration=200,.freq=SI4},
{.duration=1000,.freq=DO5},
{.duration=0,.freq=0},
{.duration=0,.freq=0}}
SOUND_STATES soundState
AAAAAAAAJZAAAAAAAAJZconst NOTE_t SUCCESS[10]
AAAAAAAAKAAAAAAAAAKAValeur initiale :
=
{{.duration=150,.freq=FA3},
{.duration=150,.freq=SOL3},
{.duration=150,.freq=LA3},
{.duration=150,.freq=SI3},
{.duration=0,.freq=0},
{.duration=0,.freq=0},
{.duration=0,.freq=0},
{.duration=0,.freq=0},
{.duration=0,.freq=0},
{.duration=0,.freq=0}}

Référence du fichier C:/microchip/harmony/v2_06/apps/1730_PortierWireless_InOut_04/firmware/src/sound.h
AAAAAAAAKBAAAAAAAAKB#include <stdint.h>
#include <stdbool.h>

Graphe des dépendances par inclusion de sound.h:
IMAGE

Ce graphe montre quels fichiers incluent directement ou indirectement ce fichier :
IMAGE

Classes
struct NOTE_tFonctions
void Sound_Init (void)
void Sound_Start (const NOTE_t *sound)
bool Sound_IsIdle (void)
void Sound_Mgmt (void)
Variables
const NOTE_t RING []
const NOTE_t SUCCESS []
const NOTE_t ERROR []

AAAAAAAAKCAAAAAAAAKCDocumentation des fonctions
void Sound_Init (void )
AAAAAAAAKDAAAAAAAAKDbool Sound_IsIdle (void )
AAAAAAAAKEAAAAAAAAKEvoid Sound_Mgmt (void )
AAAAAAAAKFAAAAAAAAKFvoid Sound_Start (const NOTE_t * sound)
AAAAAAAAKGAAAAAAAAKG
AAAAAAAAKHAAAAAAAAKHDocumentation des variables
const NOTE_t ERROR[][extern]
AAAAAAAAKIAAAAAAAAKIconst NOTE_t RING[][extern]
AAAAAAAAKJAAAAAAAAKJconst NOTE_t SUCCESS[][extern]
AAAAAAAAKKAAAAAAAAKK

sound.h
AAAAAAAAAHAAAAAAAAAHAller à la documentation de ce fichier.

1 //--------------------------------------------------------
2 // sound.h
3 //--------------------------------------------------------
4 // Gestion mélodies sur haut-parleur portier électronique (1730)
5 // Description : HP branché sur RB15 (OC1)
6 //
7 // Auteur : SCA
8 // Date : 26.11.2019
9 // Version : V1.0
10 // Compilateur : XC32 V2.15
11 // Modifications :
12 // -
13 /*--------------------------------------------------------*/
14
15 #ifndef _SOUND_H /* Guard against multiple inclusion */
16 #define _SOUND_H
17
18 #include <stdint.h>
19 #include <stdbool.h>
20
21 /* ************************************************************************** */
22 typedef struct{
23 uint16_t duration; //duree de la note en ms
24 uint16_t freq; //freq de la note en Hz
25 } NOTE_t;
26
27 /* ************************************************************************** */
28
29 extern const NOTE_t RING[];
30 extern const NOTE_t SUCCESS[];
31 extern const NOTE_t ERROR[];
32
33 /* ************************************************************************** */
34
35 void Sound_Init(void);
36 void Sound_Start(const NOTE_t* sound);
37 bool Sound_IsIdle(void);
38 void Sound_Mgmt(void);
39
40 #endif /* _SOUND_H */
41
42 /* *****************************************************************************
43 End of File
44 */

Index
INDEX
