ETML-ES-SLO/PRJ_1730_PortierWireless/doc/PDF(Final)/EstimationPrix.pdf

ETML | Estimation prix | Page n° 1 / 1
N° | Désignation | Fabricant | Réf. Fabricant | Fournisseur | Réf fournisseur | prix unitaire | Qté | Total
1 PIC32MX130F064B-I/SS | Microchip Technology | PIC32MX130F064B-I/SO | Digi-key | PIC32MX130F064B-I/SO-ND | fr. 2.61 | 3 | fr. 7.83
2 Buzzer piezzoélectrique | TDK Corporation | PS1240P02BT | Digi-key | 445-2525-3-ND | fr. 0.75 | 3 | fr. 2.25
3 Bouton poussoir | Wurth Electronics Inc | 430152070826 | Digi-key | 732-6995-2-ND | fr. 0.37 | 7 | fr. 2.59
4 LED rouge low current | Kingbright | APTD2012LSURCK | Digi-key | 754-2044-1-ND | fr. 0.32 | 3 | fr. 0.97
5 LED jaune low current | Kingbright | APTD2012LSYCK | Digi-key | 754-2045-1-ND | fr. 0.32 | 3 | fr. 0.97
6 LED verte low current | Kingbright | APTD20120LZGCK | Digi-key | 754-2048-1-ND | fr. 0.67 | 3 | fr. 2.00
7 Pile AAA | Distrelec | 300-96-325 | fr. 1.45 | 2 | fr. 2.90
8 Support à piles pour print | Keystone Electronics | 1022 | Digi-key | 36-1022-ND | fr. 3.90 | 1 | fr. 3.90
9 Transformateur 5V | Phihong USA | PSM03E-050Q | Digi-key | 993-1031-ND | fr. 4.45 | 2 | fr. 8.90
10 Prise uUSB | Phihong USA | IP-USB(C10)S | Digi-key | 993-1294-ND | fr. 3.70 | 2 | fr. 7.40
11 uUSB femelle | Wurth Electronics Inc | 629105150521 | Digi-key | 732-5960-1-ND | fr. 2.07 | 2 | fr. 4.14
| 12 868MHz0 | ETML-ES | Simonet | | | fr. 55.00 | | 3 fr. 165.00
13 MOSFET P FDN306P-D | ON Semiconductor | FDN306P | Digi-key | FDN306PCT-ND | fr. 0.51 | 1 | fr. 0.51
14 MOSFET N IRLML2402 | Infineon Technologies | IRLML2402TRBF | Digi-key | IRLML2402PBFCT-ND | fr. 0.55 | 2 | fr. 1.10
15 Régulateur 5V to 3V3 | Maxim Integrated | MAX1793EUE33+- | Digi-key | MAX1793EUE33+ND | fr. 3.90 | 2 | fr. 7.80
16 Référence de Tension | Linear Technology | LT1790BSC6-2.5#TRMPBF | Digi-key | LT1790BSC6-2.5#TRMPBF-ND | fr. 3.21 | 1 | fr. 3.21
17 Quartz 8MHz | IQD | LF XTAL003151 | Distrelec | 174-52-030 | fr. 0.60 | 3 | fr. 1.80
| 18 Estimation fabrication PCB | Eurocircuit | - | - | - | fr. 14.00 | | 3 fr. 42.00
19 Barette 1x3 | Wurth Electronics Inc | 61300311121.00 | Digi-key | 732-5316-ND | fr. 0.28 | 3 | fr. 0.84
Barette femelle 1x10 2mm | Harwin Inc. | M22-7131042 | Digi-key | 952-1354-5-ND | fr. 1.40 | 6 | 8.4
20 Barette 1x7 | Wurth Electronics Inc | 61300711121 | Digi-key | 732-5320-ND | fr. 0.35 | 3 | fr. 1.05
21 Condensateur SMD Série E12 | En stock | Estimation prix | fr. 0.60 | 11 | fr. 6.60
22 Résistances SMD Série E24 | En stock | Estimation prix | fr. 0.60 | 14 | fr. 8.40
Total | | | | | | | | fr. 290.55
Prix composants : | fr. 83.55
H:\Projet\Projet_1730\doc\EstimationPrix.xlsx | Date d'impression : 21.06.2018
