ETML-ES-SLO/PRJ_1730_PortierWireless/doc/Modification/Mod 3.0/3_Doxygen/latex/led_8c__incl.pdf

C:/microchip/harmony
/v2_06/apps/1730_PortierWireless _InOut_04/firmware/src/led.c
led.h | stdint.h | xc.h | stdbool.h
