ETML-ES-SLO/PRJ_1730_PortierWireless/doc/Modification/Mod 3.0/3_Doxygen/latex/led_8h__dep__incl.pdf

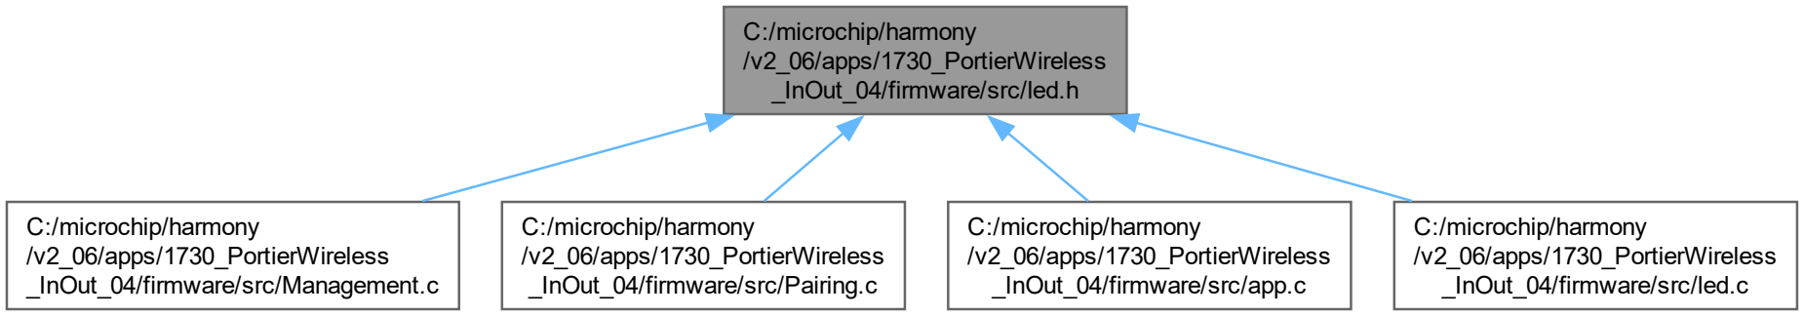
[picture p43: figure]
C:/microchip/harmony /v2_06/apps/1730_PortierWireless _InOut_04/firmware/src/led.h; C:/microchip/harmony /v2_06/apps/1730_PortierWireless _InOut_04/firmware/src/Management.c; C:/microchip/harmony /v2_06/apps/1730_PortierWireless _InOut_04/firmware/src/Pairing.c; C:/microchip/harmony /v2_06/apps/1730_PortierWireless _InOut_04/firmware/src/app.c; C:/microchip/harmony /v2_06/apps/1730_PortierWireless _InOut_04/firmware/src/led.c
