ETML-ES-SLO/PRJ_1730_PortierWireless/soft/Portier_17300B_SCA_Release/20200214_Module_Xbee_06_SCA/readme.txt

Portier Wireless - projet 1730
------------------------------

Description:
FW du module RF868 ES 1623x_ModulesRxTx868MHz
Possibilité, durant les 2 premières secondes, d'interroger le module et d'obtenir on Id unique.
Après 2s, le module passe en mode transparent. Tout part en broadcast. Pas de garantie de livraison des trames

Emplacement de ce fichier:
"C:\microchip\harmony\v2_06\apps\PROJ\Module_Xbee_06_SCA\readme.txt"

Logiciels:
MPLABX 5.15
xc32 2.15
Harmony 2.06

Auteur:
10.01.2020
Serge Castoldi
