ETML-ES-SLO/PRJ_1730_PortierWireless/doc/Modification/Mod 3.0/3_Doxygen/latex/app_8h.tex

\doxysection{RÃ©fÃ©rence du fichier C\+:/microchip/harmony/v2\+\_\+06/apps/1730\+\_\+\+Portier\+Wireless\+\_\+\+In\+Out\+\_\+04/firmware/src/app.h}
\hypertarget{app_8h}{}\label{app_8h}\index{C:/microchip/harmony/v2\_06/apps/1730\_PortierWireless\_InOut\_04/firmware/src/app.h@{C:/microchip/harmony/v2\_06/apps/1730\_PortierWireless\_InOut\_04/firmware/src/app.h}}
{\ttfamily \#include $<$stdint.\+h$>$}\newline
{\ttfamily \#include $<$stdbool.\+h$>$}\newline
{\ttfamily \#include $<$stddef.\+h$>$}\newline
{\ttfamily \#include $<$stdlib.\+h$>$}\newline
{\ttfamily \#include "{}system\+\_\+config.\+h"{}}\newline
{\ttfamily \#include "{}system\+\_\+definitions.\+h"{}}\newline
{\ttfamily \#include "{}Mc32\+Debounce.\+h"{}}\newline
Graphe des dÃ©pendances par inclusion de app.\+h\+:\nopagebreak
\begin{figure}[H]
\begin{center}
\leavevmode
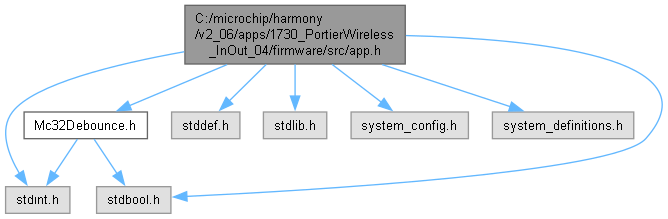
[picture p45: doc/Modification/Mod 3.0/3_Doxygen/rtf/app_8h__incl.png]

\end{center}
\end{figure}
Ce graphe montre quels fichiers incluent directement ou indirectement ce fichier \+:\nopagebreak
\begin{figure}[H]
\begin{center}
\leavevmode
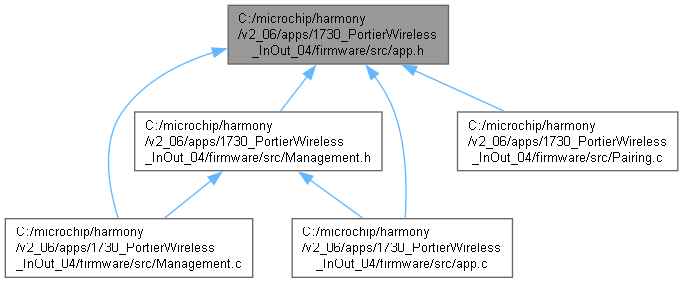
[picture p46: doc/Modification/Mod 3.0/3_Doxygen/rtf/app_8h__dep__incl.png]

\end{center}
\end{figure}
\doxysubsubsection*{Classes}
\begin{DoxyCompactItemize}
\item 
struct \mbox{\hyperlink{struct_a_p_p___d_a_t_a}{APP\+\_\+\+DATA}}
\end{DoxyCompactItemize}
\doxysubsubsection*{Macros}
\begin{DoxyCompactItemize}
\item 
\#define \mbox{\hyperlink{app_8h_a6e6123365d9c53fa6c846def98dd72b9}{LOWBAT\+\_\+\+THRESHOLD}}~2400
\end{DoxyCompactItemize}
\doxysubsubsection*{Ã‰numÃ©rations}
\begin{DoxyCompactItemize}
\item 
enum \mbox{\hyperlink{app_8h_ac23e091bbd221d57ef9aa15bf099b871}{APP\+\_\+\+STATES}} \{ \mbox{\hyperlink{app_8h_ac23e091bbd221d57ef9aa15bf099b871aee72936f6dda86ada3946d7c937a2297}{APP\+\_\+\+STATE\+\_\+\+INIT}} = 0
, \mbox{\hyperlink{app_8h_ac23e091bbd221d57ef9aa15bf099b871a4a2d007c2bbd7b136d1a6c587e536c89}{APP\+\_\+\+STATE\+\_\+\+WAIT}}
, \mbox{\hyperlink{app_8h_ac23e091bbd221d57ef9aa15bf099b871a92f04718da45a34c069d899c657d1ac5}{APP\+\_\+\+STATE\+\_\+\+SERVICE\+\_\+\+TASKS}}
 \}
\end{DoxyCompactItemize}
\doxysubsubsection*{Fonctions}
\begin{DoxyCompactItemize}
\item 
void \mbox{\hyperlink{app_8h_a59b305aa4f4287d45cbe428f533f84b2}{APP\+\_\+\+Initialize}} (void)
\begin{DoxyCompactList}\small\item\em Initialise l\textquotesingle{}application. \end{DoxyCompactList}\item 
void \mbox{\hyperlink{app_8h_a859aee46b660cfee47cfd45ce08f6862}{APP\+\_\+\+Tasks}} (void)
\begin{DoxyCompactList}\small\item\em Tâche principale de l\textquotesingle{}application. \end{DoxyCompactList}\item 
void \mbox{\hyperlink{app_8h_acc9cde7d11cdebdf90dc9f45323376d7}{APP\+\_\+\+Update\+State}} (\mbox{\hyperlink{app_8h_ac23e091bbd221d57ef9aa15bf099b871}{APP\+\_\+\+STATES}} new\+State)
\begin{DoxyCompactList}\small\item\em Met à jour l\textquotesingle{}état de l\textquotesingle{}application. \end{DoxyCompactList}\item 
bool \mbox{\hyperlink{app_8h_a2eddd01dc88b9cfb845ab578cd7510b4}{APP\+\_\+\+Get\+Is\+Door}} (void)
\begin{DoxyCompactList}\small\item\em Vérifie si l\textquotesingle{}entité courante est une porte. \end{DoxyCompactList}\end{DoxyCompactItemize}
\doxysubsubsection*{Variables}
\begin{DoxyCompactItemize}
\item 
\mbox{\hyperlink{struct_s___switch_descriptor}{S\+\_\+\+Switch\+Descriptor}} \mbox{\hyperlink{app_8h_a19358061a4fa8672c2124d5eb6a6337a}{sw\+Ring}}
\item 
\mbox{\hyperlink{struct_s___switch_descriptor}{S\+\_\+\+Switch\+Descriptor}} \mbox{\hyperlink{app_8h_aafadd8f2a2aa59c174b5207f21872f1f}{sw\+Enter}}
\item 
\mbox{\hyperlink{struct_s___switch_descriptor}{S\+\_\+\+Switch\+Descriptor}} \mbox{\hyperlink{app_8h_afdc3fbca7ca6fb08b354d67fea915b56}{sw\+Wait}}
\item 
\mbox{\hyperlink{struct_s___switch_descriptor}{S\+\_\+\+Switch\+Descriptor}} \mbox{\hyperlink{app_8h_a2eb3ac5dc73c685e3beefb74af0e1371}{sw\+Busy}}
\end{DoxyCompactItemize}

\label{doc-define-members}
\Hypertarget{app_8h_doc-define-members}
\doxysubsection{Documentation des macros}
\Hypertarget{app_8h_a6e6123365d9c53fa6c846def98dd72b9}\index{app.h@{app.h}!LOWBAT\_THRESHOLD@{LOWBAT\_THRESHOLD}}
\index{LOWBAT\_THRESHOLD@{LOWBAT\_THRESHOLD}!app.h@{app.h}}
\doxysubsubsection{\texorpdfstring{LOWBAT\_THRESHOLD}{LOWBAT\_THRESHOLD}}
{\footnotesize\ttfamily \label{app_8h_a6e6123365d9c53fa6c846def98dd72b9} 
\#define LOWBAT\+\_\+\+THRESHOLD~2400}

\label{doc-enum-members}
\Hypertarget{app_8h_doc-enum-members}
\doxysubsection{Documentation du type de l\textquotesingle{}Ã©numÃ©ration}
\Hypertarget{app_8h_ac23e091bbd221d57ef9aa15bf099b871}\index{app.h@{app.h}!APP\_STATES@{APP\_STATES}}
\index{APP\_STATES@{APP\_STATES}!app.h@{app.h}}
\doxysubsubsection{\texorpdfstring{APP\_STATES}{APP\_STATES}}
{\footnotesize\ttfamily \label{app_8h_ac23e091bbd221d57ef9aa15bf099b871} 
enum \mbox{\hyperlink{app_8h_ac23e091bbd221d57ef9aa15bf099b871}{APP\+\_\+\+STATES}}}

\begin{DoxyEnumFields}[2]{Valeurs Ã©numÃ©rÃ©es}
\raisebox{\heightof{T}}[0pt][0pt]{\index{APP\_STATE\_INIT@{APP\_STATE\_INIT}!app.h@{app.h}}\index{app.h@{app.h}!APP\_STATE\_INIT@{APP\_STATE\_INIT}}}\Hypertarget{app_8h_ac23e091bbd221d57ef9aa15bf099b871aee72936f6dda86ada3946d7c937a2297}\label{app_8h_ac23e091bbd221d57ef9aa15bf099b871aee72936f6dda86ada3946d7c937a2297} 
APP\+\_\+\+STATE\+\_\+\+INIT&\\
\hline

\raisebox{\heightof{T}}[0pt][0pt]{\index{APP\_STATE\_WAIT@{APP\_STATE\_WAIT}!app.h@{app.h}}\index{app.h@{app.h}!APP\_STATE\_WAIT@{APP\_STATE\_WAIT}}}\Hypertarget{app_8h_ac23e091bbd221d57ef9aa15bf099b871a4a2d007c2bbd7b136d1a6c587e536c89}\label{app_8h_ac23e091bbd221d57ef9aa15bf099b871a4a2d007c2bbd7b136d1a6c587e536c89} 
APP\+\_\+\+STATE\+\_\+\+WAIT&\\
\hline

\raisebox{\heightof{T}}[0pt][0pt]{\index{APP\_STATE\_SERVICE\_TASKS@{APP\_STATE\_SERVICE\_TASKS}!app.h@{app.h}}\index{app.h@{app.h}!APP\_STATE\_SERVICE\_TASKS@{APP\_STATE\_SERVICE\_TASKS}}}\Hypertarget{app_8h_ac23e091bbd221d57ef9aa15bf099b871a92f04718da45a34c069d899c657d1ac5}\label{app_8h_ac23e091bbd221d57ef9aa15bf099b871a92f04718da45a34c069d899c657d1ac5} 
APP\+\_\+\+STATE\+\_\+\+SERVICE\+\_\+\+TASKS&\\
\hline

\end{DoxyEnumFields}

\label{doc-func-members}
\Hypertarget{app_8h_doc-func-members}
\doxysubsection{Documentation des fonctions}
\Hypertarget{app_8h_a2eddd01dc88b9cfb845ab578cd7510b4}\index{app.h@{app.h}!APP\_GetIsDoor@{APP\_GetIsDoor}}
\index{APP\_GetIsDoor@{APP\_GetIsDoor}!app.h@{app.h}}
\doxysubsubsection{\texorpdfstring{APP\_GetIsDoor()}{APP\_GetIsDoor()}}
{\footnotesize\ttfamily \label{app_8h_a2eddd01dc88b9cfb845ab578cd7510b4} 
bool APP\+\_\+\+Get\+Is\+Door (\begin{DoxyParamCaption}\item[{void}]{}{}\end{DoxyParamCaption})}

Vérifie si l\textquotesingle{}entité courante est une porte. 

\begin{DoxyReturn}{Renvoie}
true si l\textquotesingle{}entité est une porte, false sinon.
\end{DoxyReturn}
Cette fonction retourne la valeur du champ is\+Door de la structure app\+Data. \Hypertarget{app_8h_a59b305aa4f4287d45cbe428f533f84b2}\index{app.h@{app.h}!APP\_Initialize@{APP\_Initialize}}
\index{APP\_Initialize@{APP\_Initialize}!app.h@{app.h}}
\doxysubsubsection{\texorpdfstring{APP\_Initialize()}{APP\_Initialize()}}
{\footnotesize\ttfamily \label{app_8h_a59b305aa4f4287d45cbe428f533f84b2} 
void APP\+\_\+\+Initialize (\begin{DoxyParamCaption}\item[{void}]{}{}\end{DoxyParamCaption})}

Initialise l\textquotesingle{}application. 

Cette fonction configure l\textquotesingle{}état initial de l\textquotesingle{}application, initialise les broches matérielles, la logique d\textquotesingle{}antirebond pour les boutons, ainsi que les périphériques tels que les LEDs, le module sonore et la RF.

\begin{DoxyReturn}{Renvoie}
void 
\end{DoxyReturn}
\Hypertarget{app_8h_a859aee46b660cfee47cfd45ce08f6862}\index{app.h@{app.h}!APP\_Tasks@{APP\_Tasks}}
\index{APP\_Tasks@{APP\_Tasks}!app.h@{app.h}}
\doxysubsubsection{\texorpdfstring{APP\_Tasks()}{APP\_Tasks()}}
{\footnotesize\ttfamily \label{app_8h_a859aee46b660cfee47cfd45ce08f6862} 
void APP\+\_\+\+Tasks (\begin{DoxyParamCaption}\item[{void}]{}{}\end{DoxyParamCaption})}

Tâche principale de l\textquotesingle{}application. 

Cette fonction gère la machine à états principale de l\textquotesingle{}application. Elle est appelée de manière répétée dans la boucle principale du programme.

\begin{DoxyRemark}{Remarques}
Voir le prototype dans \doxylink{app_8h}{app.\+h}. 
\end{DoxyRemark}
\Hypertarget{app_8h_acc9cde7d11cdebdf90dc9f45323376d7}\index{app.h@{app.h}!APP\_UpdateState@{APP\_UpdateState}}
\index{APP\_UpdateState@{APP\_UpdateState}!app.h@{app.h}}
\doxysubsubsection{\texorpdfstring{APP\_UpdateState()}{APP\_UpdateState()}}
{\footnotesize\ttfamily \label{app_8h_acc9cde7d11cdebdf90dc9f45323376d7} 
void APP\+\_\+\+Update\+State (\begin{DoxyParamCaption}\item[{\mbox{\hyperlink{app_8h_ac23e091bbd221d57ef9aa15bf099b871}{APP\+\_\+\+STATES}}}]{new\+State}{}\end{DoxyParamCaption})}

Met à jour l\textquotesingle{}état de l\textquotesingle{}application. 

\begin{DoxyParams}{ParamÃ¨tres}
{\em new\+State} & Le nouvel état à appliquer à l\textquotesingle{}application.\\
\hline
\end{DoxyParams}
Cette fonction assigne la valeur de new\+State à la variable d\textquotesingle{}état de l\textquotesingle{}application. 

\label{doc-var-members}
\Hypertarget{app_8h_doc-var-members}
\doxysubsection{Documentation des variables}
\Hypertarget{app_8h_a2eb3ac5dc73c685e3beefb74af0e1371}\index{app.h@{app.h}!swBusy@{swBusy}}
\index{swBusy@{swBusy}!app.h@{app.h}}
\doxysubsubsection{\texorpdfstring{swBusy}{swBusy}}
{\footnotesize\ttfamily \label{app_8h_a2eb3ac5dc73c685e3beefb74af0e1371} 
\mbox{\hyperlink{struct_s___switch_descriptor}{S\+\_\+\+Switch\+Descriptor}} sw\+Busy\hspace{0.3cm}{\ttfamily [extern]}}

\Hypertarget{app_8h_aafadd8f2a2aa59c174b5207f21872f1f}\index{app.h@{app.h}!swEnter@{swEnter}}
\index{swEnter@{swEnter}!app.h@{app.h}}
\doxysubsubsection{\texorpdfstring{swEnter}{swEnter}}
{\footnotesize\ttfamily \label{app_8h_aafadd8f2a2aa59c174b5207f21872f1f} 
\mbox{\hyperlink{struct_s___switch_descriptor}{S\+\_\+\+Switch\+Descriptor}} sw\+Enter\hspace{0.3cm}{\ttfamily [extern]}}

\Hypertarget{app_8h_a19358061a4fa8672c2124d5eb6a6337a}\index{app.h@{app.h}!swRing@{swRing}}
\index{swRing@{swRing}!app.h@{app.h}}
\doxysubsubsection{\texorpdfstring{swRing}{swRing}}
{\footnotesize\ttfamily \label{app_8h_a19358061a4fa8672c2124d5eb6a6337a} 
\mbox{\hyperlink{struct_s___switch_descriptor}{S\+\_\+\+Switch\+Descriptor}} sw\+Ring\hspace{0.3cm}{\ttfamily [extern]}}

\Hypertarget{app_8h_afdc3fbca7ca6fb08b354d67fea915b56}\index{app.h@{app.h}!swWait@{swWait}}
\index{swWait@{swWait}!app.h@{app.h}}
\doxysubsubsection{\texorpdfstring{swWait}{swWait}}
{\footnotesize\ttfamily \label{app_8h_afdc3fbca7ca6fb08b354d67fea915b56} 
\mbox{\hyperlink{struct_s___switch_descriptor}{S\+\_\+\+Switch\+Descriptor}} sw\+Wait\hspace{0.3cm}{\ttfamily [extern]}}
