ETML-ES-SLO/PRJ_1730_PortierWireless/doc/Modification/Mod 3.0/3_Doxygen/latex/main_8c.tex

\doxysection{Référence du fichier C\+:/microchip/harmony/v2\+\_\+06/apps/1730\+\_\+\+Portier\+Wireless\+\_\+\+In\+Out\+\_\+04/firmware/src/main.c}
\hypertarget{main_8c}{}\label{main_8c}\index{C:/microchip/harmony/v2\_06/apps/1730\_PortierWireless\_InOut\_04/firmware/src/main.c@{C:/microchip/harmony/v2\_06/apps/1730\_PortierWireless\_InOut\_04/firmware/src/main.c}}
{\ttfamily \#include $<$stddef.\+h$>$}\newline
{\ttfamily \#include $<$stdbool.\+h$>$}\newline
{\ttfamily \#include $<$stdlib.\+h$>$}\newline
{\ttfamily \#include "{}system/common/sys\+\_\+module.\+h"{}}\newline
{\ttfamily \#include "{}system\+\_\+definitions.\+h"{}}\newline
Graphe des dépendances par inclusion de main.\+c\+:\nopagebreak
\begin{figure}[H]
\begin{center}
\leavevmode

\end{center}
\end{figure}
\doxysubsubsection*{Fonctions}
\begin{DoxyCompactItemize}
\item 
int \mbox{\hyperlink{main_8c_a840291bc02cba5474a4cb46a9b9566fe}{main}} (void)
\end{DoxyCompactItemize}

\label{doc-func-members}
\Hypertarget{main_8c_doc-func-members}
\doxysubsection{Documentation des fonctions}
\Hypertarget{main_8c_a840291bc02cba5474a4cb46a9b9566fe}\index{main.c@{main.c}!main@{main}}
\index{main@{main}!main.c@{main.c}}
\doxysubsubsection{\texorpdfstring{main()}{main()}}
{\footnotesize\ttfamily \label{main_8c_a840291bc02cba5474a4cb46a9b9566fe} 
int main (\begin{DoxyParamCaption}\item[{void}]{}{}\end{DoxyParamCaption})}
