ETML-ES-SLO/PRJ_1730_PortierWireless/doc/Modification/Mod 3.0/2_Rendu/Presentation_Modification_1730_PortierWireless_Mendes.pptx

## 1730 Portier Wireless

Modification 3.0
POBJ SLO2
Léo Mendes

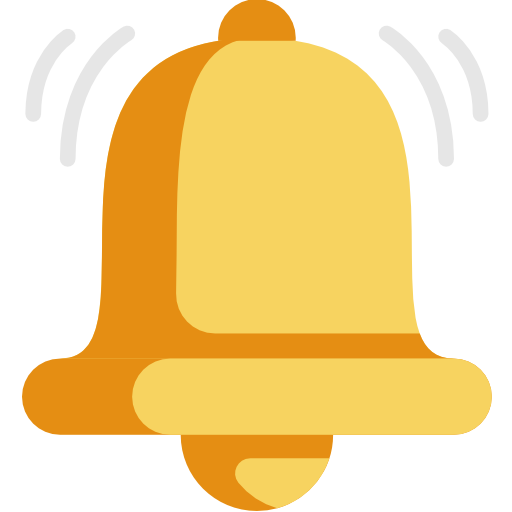
[picture p56: figure]

## Description du projet

Firmware de base :
- Essais et compréhension de modification de la version 2 de Diogo Ferreira
- Choix de repartir de la version stable de Serge Castoldi
  - Version : 1730_PortierWireless_InOut_02
Hardware :
- Carte n°1730B :
  - Avec PIC32MX130F064B-I/SS
- 1623x_ModulesRxTx868MHz :
  - Communication sans fil par module RF 868 MHz
  - Version firmware : Module_Xbee_06_SCA
Aucun filtrage d'identité :
- Toutes les trames sont acceptées, quelle que soit leur provenance

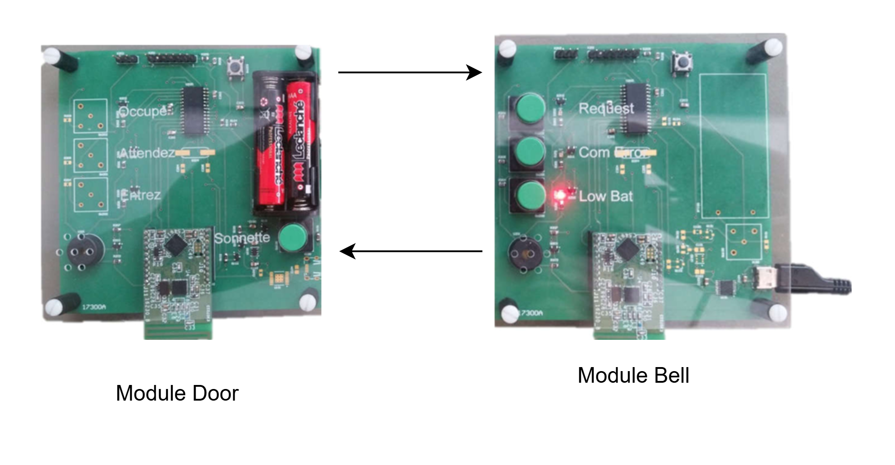
[picture p57: figure]

- Alimentation par USB (5V)
- Réception de la demande
- Envois de la réponse
- Buzzer pour indications sonore

- Alimentation indépendante
- Appuis pour demandes
- Réception de la réponse
- Buzzeur pour indications sonore

## Modifications apportées

Effectuée :
- Implémentation complète de l’appairage dynamique des modules
- Mise à jour de la documentation technique avec Flowchart, machines d’état et tests

Non effectuée :
Mise en place d’un message RF dédié pour alerter sur un niveau de batterie critique.
Amélioration de l’indication visuelle en cas de batterie faible

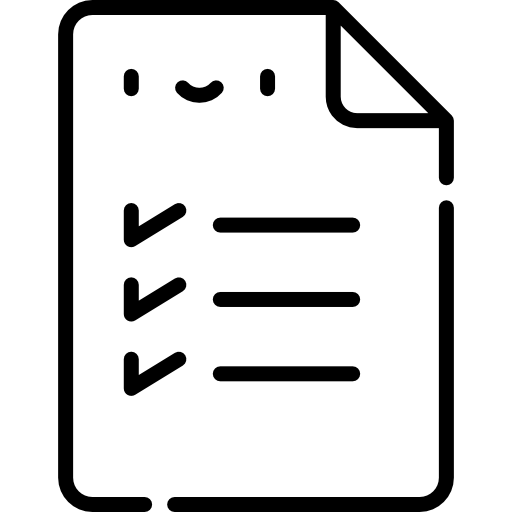
[picture p58: figure]

## Modifications apportées

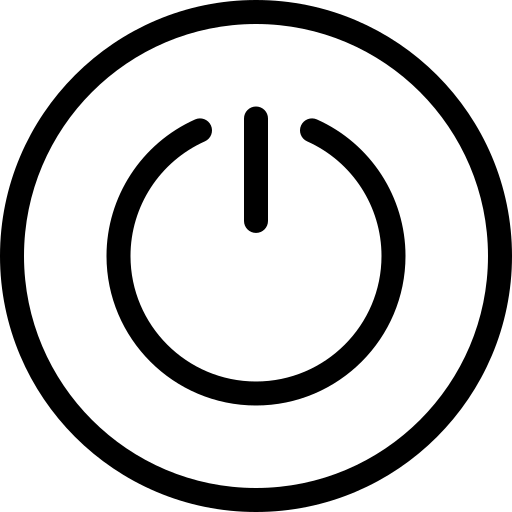
[picture p59: figure]

Appareillage : Logique à l’allumage

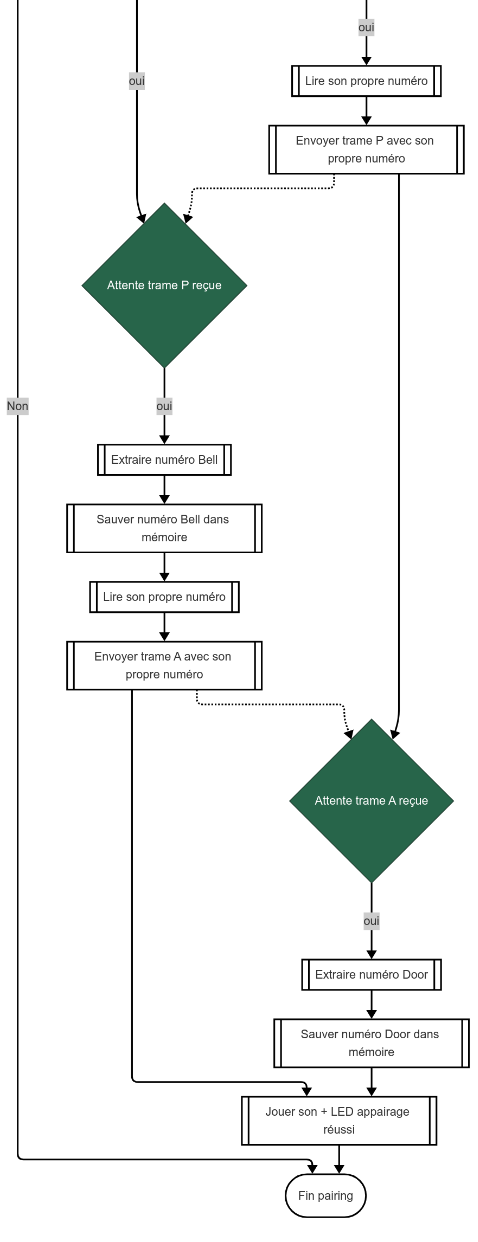
[picture p60: figure]
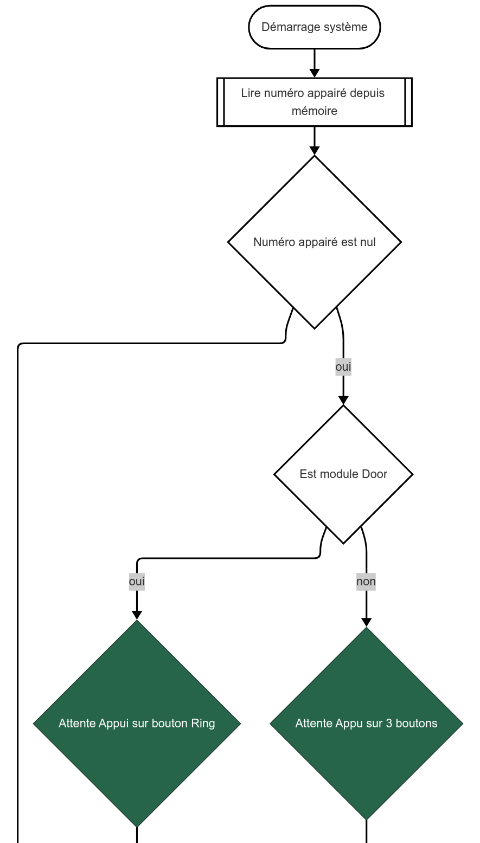
[picture p61: figure]

## Modifications apportées

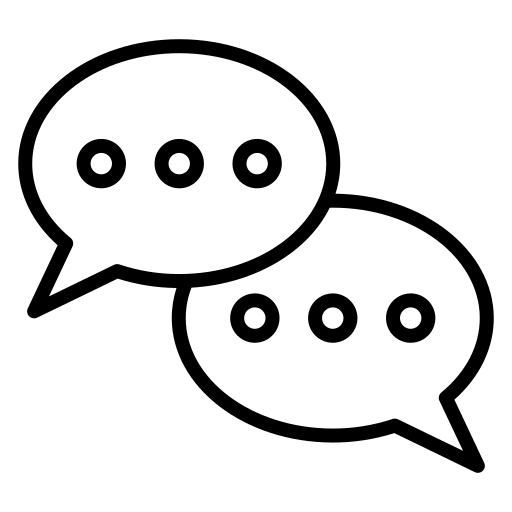
[picture p62: figure]

Appareillage : En communication

Module Door

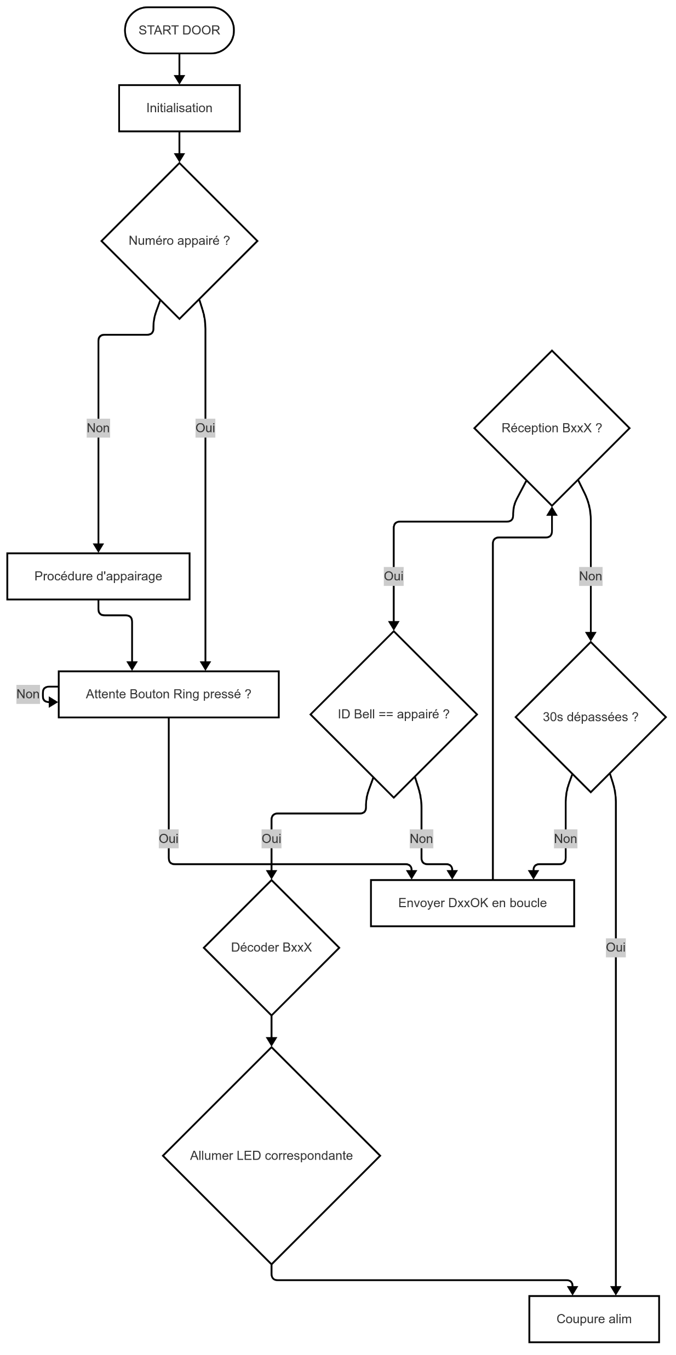
[picture p63: figure]

Module Bell :

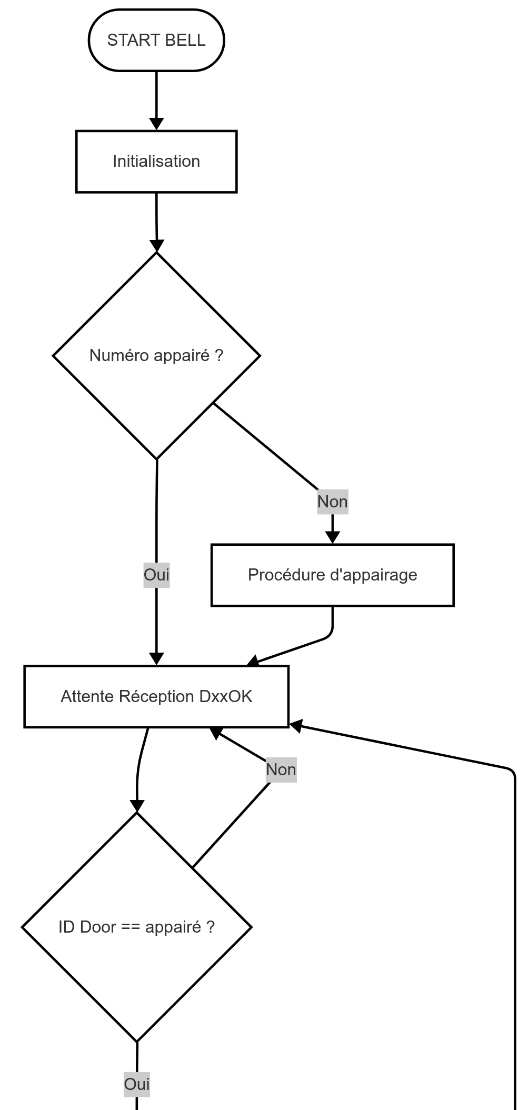
[picture p64: figure]
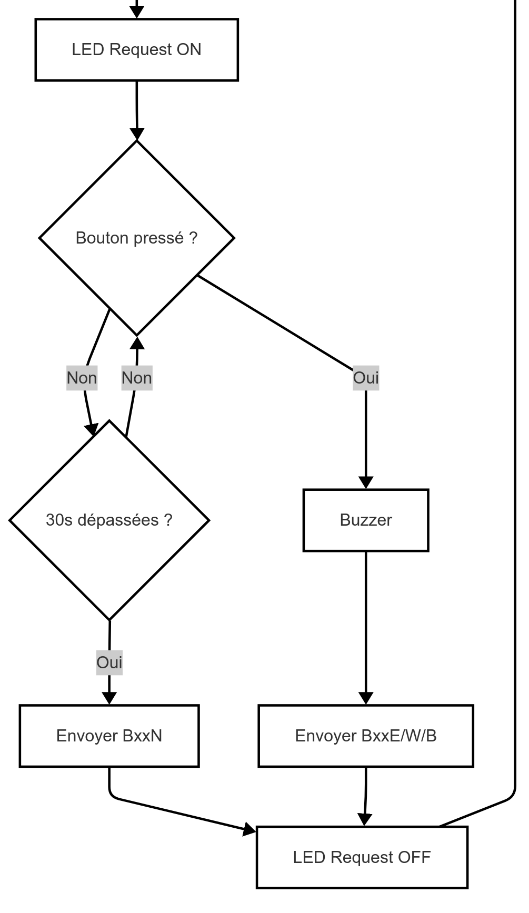
[picture p65: figure]

## Modifications apportées

Appareillage : Demo

Fonctionnalités OK:
Appairage manuel au démarrage
Sauvegarde ID en NVM
Filtrage des trames reçues
Réinitialisation par bouton
Intégration ID et filtrage

Fonctionnalités NOK:
Perte d’ID après redémarrage (Door)
Reset instable (Bell)
Procédure appairage instable
Priorité Bell/Door
Pas d’appareillage automatique
Feedback sonore peu clair

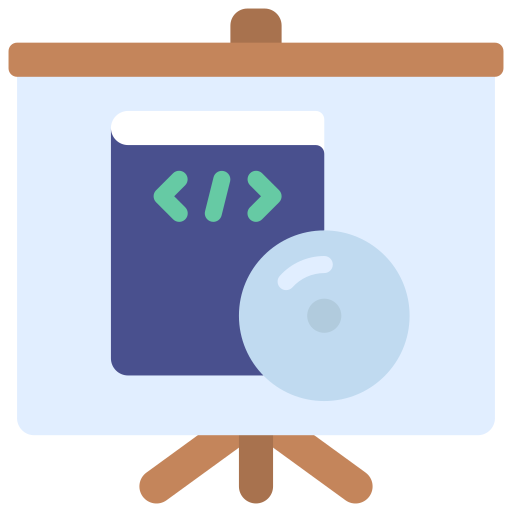
[picture p66: figure]

## Modifications apportées

Documentation

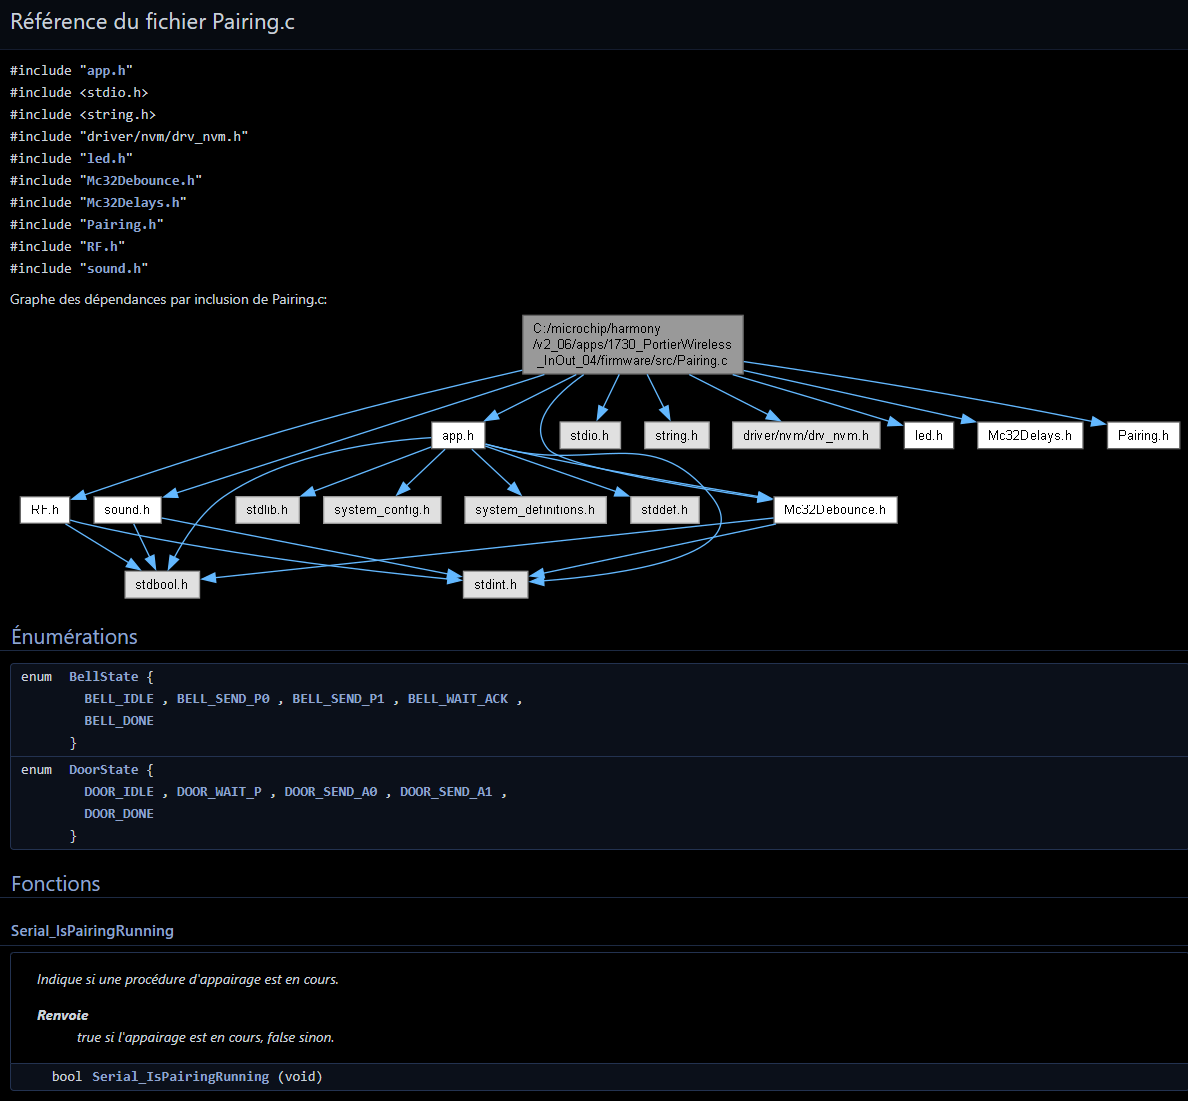
[picture p67: figure]

https://1730portierwireless.neocities.org/

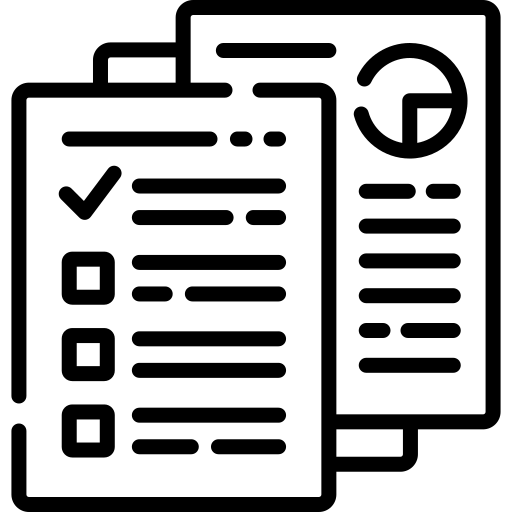
[picture p68: figure]

Améliorations apportées :
Passage de fonctions de management dans fichier supplémentaire
Utilisation de Doxgen
Amélioration des commentaires

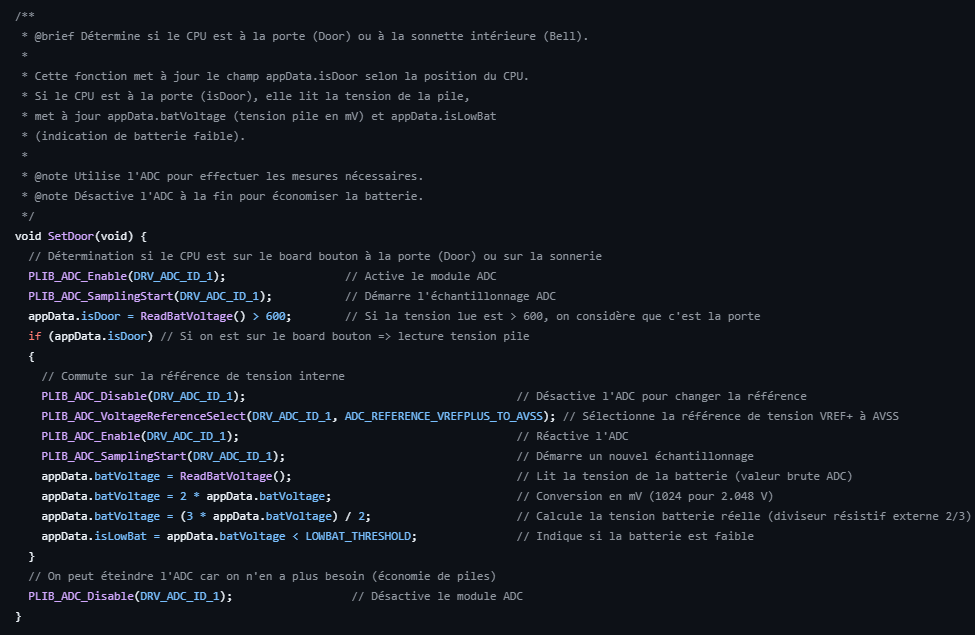
[picture p69: figure]

## Modifications apportées

Difficulté :
Instabilité du débogueur : 8 redémarrages de MPLAB en une matinée
→ migration vers MPLAB v6.15.
Difficulté de compréhension des modifications de Diogo Ferreira
→ usage de Doxygen + diagrammes Mermaid pour améliorer la lisibilité.
Code DFA non fonctionnel sur carte
→ remplacement par le code stable SCA.
Mise en place complexe de la sauvegarde NVM
→ réflexion sur l’ajout d’une EEPROM externe.
Le système DOOR doit s’éteindre pour exécuter sa séquence logique, ce qui interrompt le débogage
→ réflexion sur une modification hardware ou logicielle pour contourner ce blocage.?

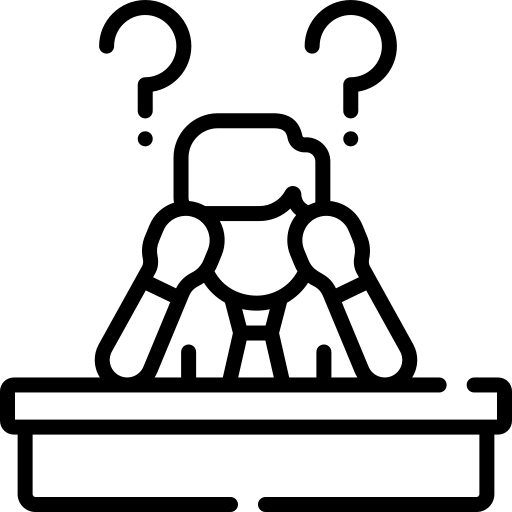
[picture p70: figure]

## Slide 9

Merci pour votre attention

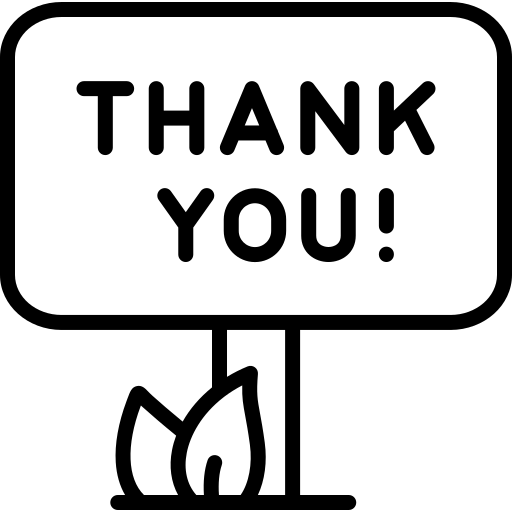
[picture p71: figure]

## Slide 10

Questions

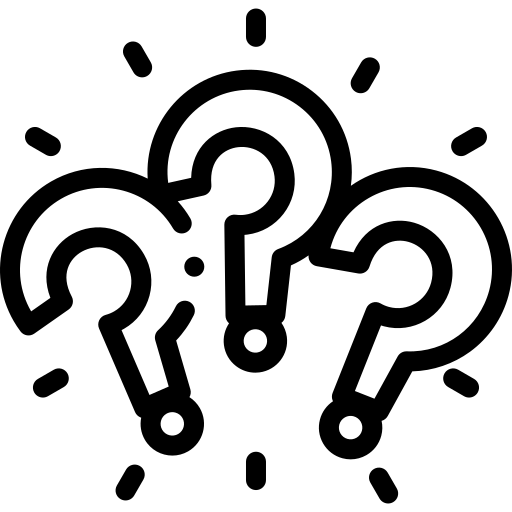
[picture p72: figure]
