ETML-ES-SLO/PRJ_1730_PortierWireless/doc/Modification/Mod 3.0/3_Doxygen/rtf/dir_3c1ce8462c07dfc038ad7ef552c344f0.rtf

begin bodyRÃ©pertoire de rÃ©fÃ©rence de C:/microchip/harmony/v2_06
AAAAAAAALMAAAAAAAALMGraphe des dÃ©pendances de rÃ©pertoires pour v2_06:
IMAGE
RÃ©pertoires
rÃ©pertoire apps
