ETML-ES-SLO/PRJ_1730_PortierWireless/doc/Modification/Mod 3.0/3_Doxygen/rtf/dir_580ddd0237585ac315b4ef98a15174fa.rtf

begin bodyRÃ©pertoire de rÃ©fÃ©rence de C:/microchip/harmony/v2_06/apps
AAAAAAAALHAAAAAAAALHGraphe des dÃ©pendances de rÃ©pertoires pour apps:
IMAGE
RÃ©pertoires
rÃ©pertoire 1730_PortierWireless_InOut_04
