ETML-ES-SLO/PRJ_1730_PortierWireless/doc/Modification/Mod 3.0/3_Doxygen/rtf/dir_60864ceb768185ac6327ae001cbbf6bb.rtf

begin bodyRÃ©pertoire de rÃ©fÃ©rence de C:/microchip
AAAAAAAALKAAAAAAAALKRÃ©pertoires
rÃ©pertoire harmony
