ETML-ES-SLO/PRJ_1730_PortierWireless/doc/Modification/Mod 3.0/3_Doxygen/rtf/dir_6b443360973a53f0750ab0dc163001d0.rtf

begin bodyRÃ©pertoire de rÃ©fÃ©rence de C:/microchip/harmony
AAAAAAAALJAAAAAAAALJGraphe des dÃ©pendances de rÃ©pertoires pour harmony:
IMAGE
RÃ©pertoires
rÃ©pertoire v2_06
