ETML-ES-SLO/PRJ_1730_PortierWireless/doc/Modification/Mod 3.0/3_Doxygen/rtf/dir_7729169af531c636b6b5252162dc6bbe.rtf

begin bodyRÃ©pertoire de rÃ©fÃ©rence de C:/microchip/harmony/v2_06/apps/1730_PortierWireless_InOut_04/firmware
AAAAAAAALIAAAAAAAALIGraphe des dÃ©pendances de rÃ©pertoires pour firmware:
IMAGE
RÃ©pertoires
rÃ©pertoire src
