ETML-ES-SLO/PRJ_1730_PortierWireless/doc/Modification/Mod 3.0/3_Doxygen/rtf/dir_8e86079d32e24360c681a957ed9a9585.rtf

begin bodyRÃ©pertoire de rÃ©fÃ©rence de C:/microchip/harmony/v2_06/apps/1730_PortierWireless_InOut_04
AAAAAAAALGAAAAAAAALGGraphe des dÃ©pendances de rÃ©pertoires pour 1730_PortierWireless_InOut_04:
IMAGE
RÃ©pertoires
rÃ©pertoire firmware
