ETML-ES-SLO/PRJ_1730_PortierWireless/doc/Modification/Mod 3.0/3_Doxygen/latex/app_8h__dep__incl.pdf

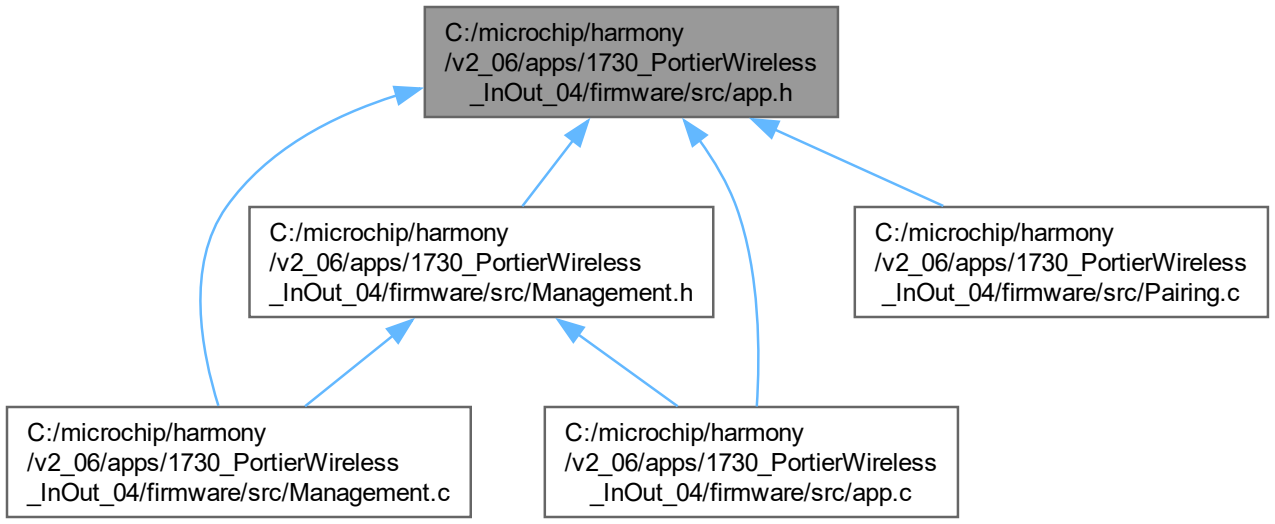
[picture p73: figure]
C:/microchip/harmony /v2_06/apps/1730_PortierWireless _InOut_04/firmware/src/app.h; C:/microchip/harmony /v2_06/apps/1730_PortierWireless _InOut_04/firmware/src/Management.c; C:/microchip/harmony /v2_06/apps/1730_PortierWireless _InOut_04/firmware/src/Management.h; C:/microchip/harmony /v2_06/apps/1730_PortierWireless _InOut_04/firmware/src/app.c; C:/microchip/harmony /v2_06/apps/1730_PortierWireless _InOut_04/firmware/src/Pairing.c
