ETML-ES-SLO/PRJ_1730_PortierWireless/doc/Modification/Mod 3.0/3_Doxygen/latex/app_8h__incl.pdf

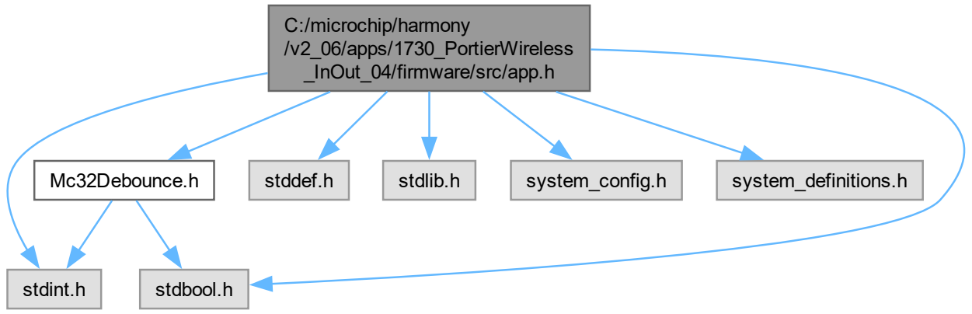
[picture p74: figure]
C:/microchip/harmony /v2_06/apps/1730_PortierWireless _InOut_04/firmware/src/app.h; stdint.h; stdbool.h; Mc32Debounce.h; stddef.h; stdlib.h; system_config.h; system_definitions.h
