ETML-ES-SLO/PRJ_1730_PortierWireless/doc/Modification/Mod 3.0/3_Doxygen/latex/main_8c__incl.pdf

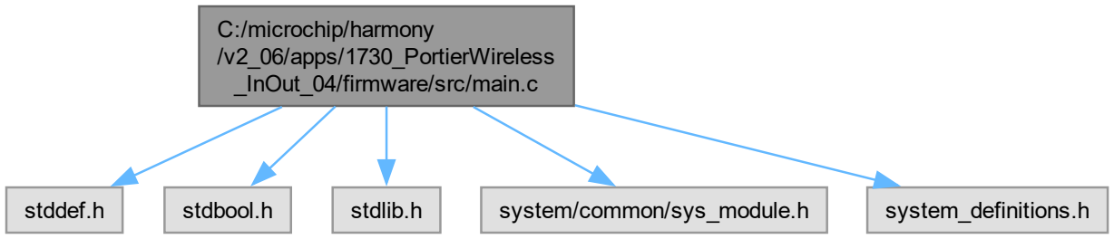
[picture p75: figure]
C:/microchip/harmony /v2_06/apps/1730_PortierWireless _InOut_04/firmware/src/main.c; stddef.h; stdbool.h; stdlib.h; system/common/sys_module.h; system_definitions.h
