ETML-ES-SLO/PRJ_1730_PortierWireless/doc/Modification/Mod 3.0/3_Doxygen/latex/sound_8c__incl.pdf

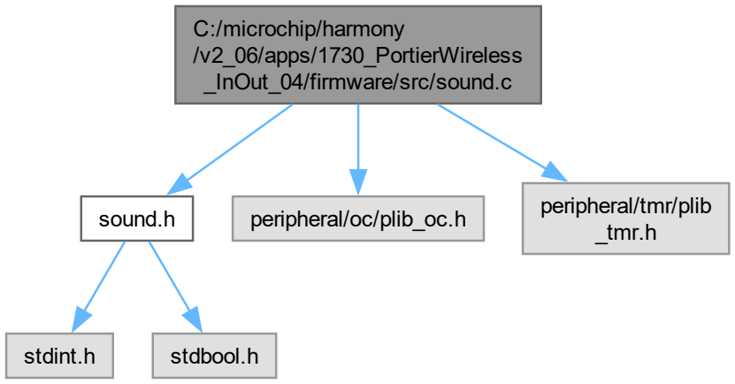
[picture p76: figure]
C:/microchip/harmony /v2_06/apps/1730_PortierWireless _InOut_04/firmware/src/sound.c; sound.h; peripheral/oc/plib_oc.h; peripheral/tmr/plib; _tmr.h; stdint.h; stdbool.h
