ETML-ES-SLO/PRJ_1730_PortierWireless/doc/IMG_Rapport/Buzzer.jpg

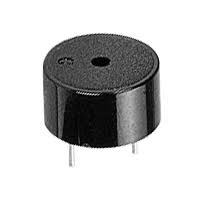
doc/IMG_Rapport/Buzzer.jpg
