ETML-ES-SLO/PRJ_1730_PortierWireless/doc/IMG_Rapport/IN.jpg

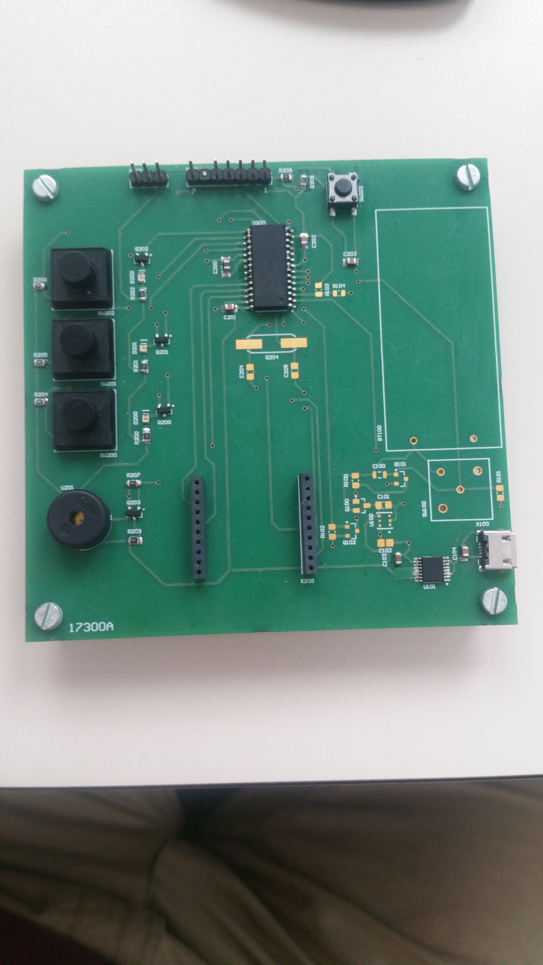
doc/IMG_Rapport/IN.jpg
