ETML-ES-SLO/PRJ_1730_PortierWireless/doc/IMG_Rapport/LED_RGO.png

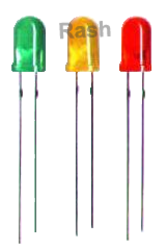
doc/IMG_Rapport/LED_RGO.png
