ETML-ES-SLO/PRJ_1730_PortierWireless/doc/IMG_Rapport/microUSB.jpg

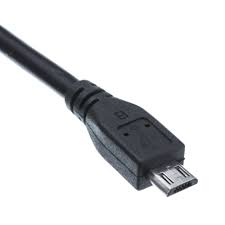
doc/IMG_Rapport/microUSB.jpg
