ETML-ES-SLO/PRJ_1730_PortierWireless/doc/IMG_Rapport/OUT.jpg

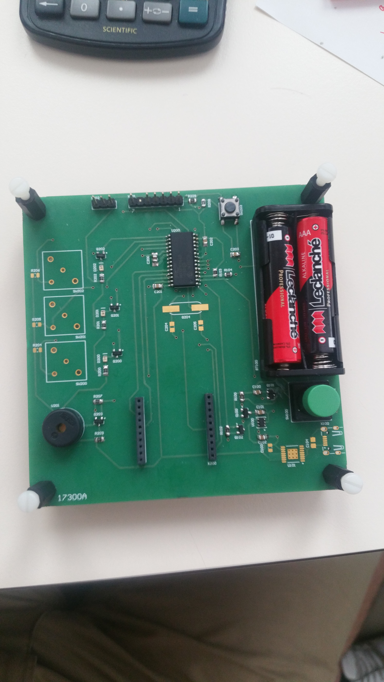
doc/IMG_Rapport/OUT.jpg
