ETML-ES-SLO/PRJ_1730_PortierWireless/doc/IMG_Rapport/OutFini1.jpg

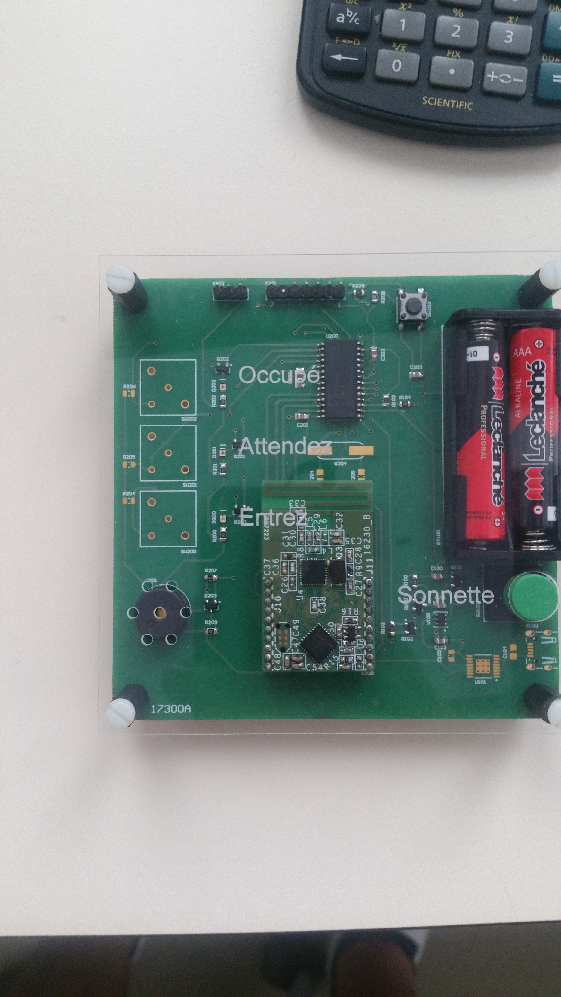
doc/IMG_Rapport/OutFini1.jpg
