ETML-ES-SLO/PRJ_1730_PortierWireless/doc/IMG_Rapport/Poussoir.jpg

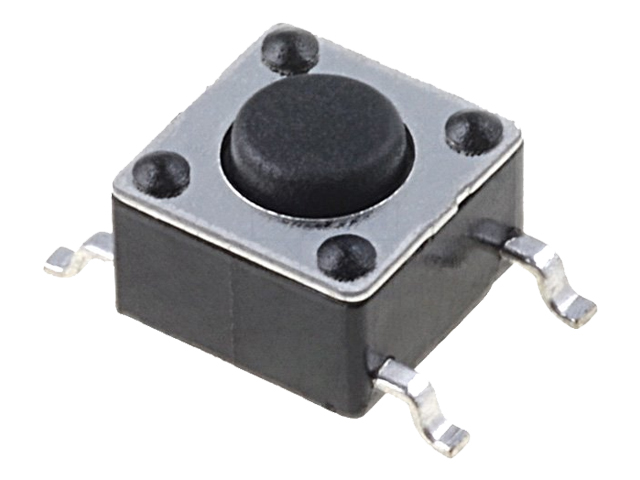
doc/IMG_Rapport/Poussoir.jpg
