ETML-ES-SLO/PRJ_1730_PortierWireless/doc/IMG_Rapport/Proj_f_CLK.png

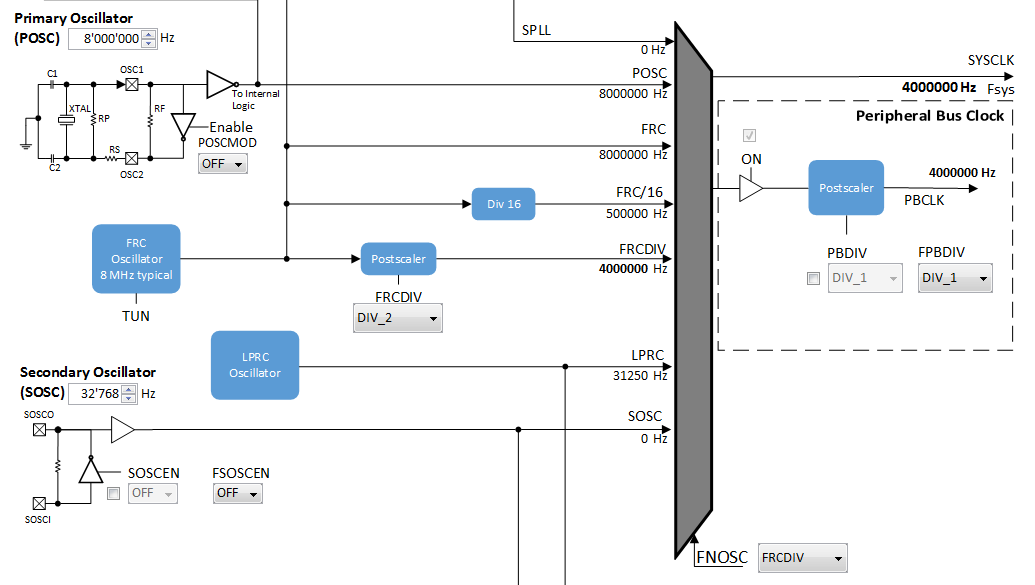
doc/IMG_Rapport/Proj_f_CLK.png
