ETML-ES-SLO/PRJ_1730_PortierWireless/doc/IMG_Rapport/Proj_Pinout.png

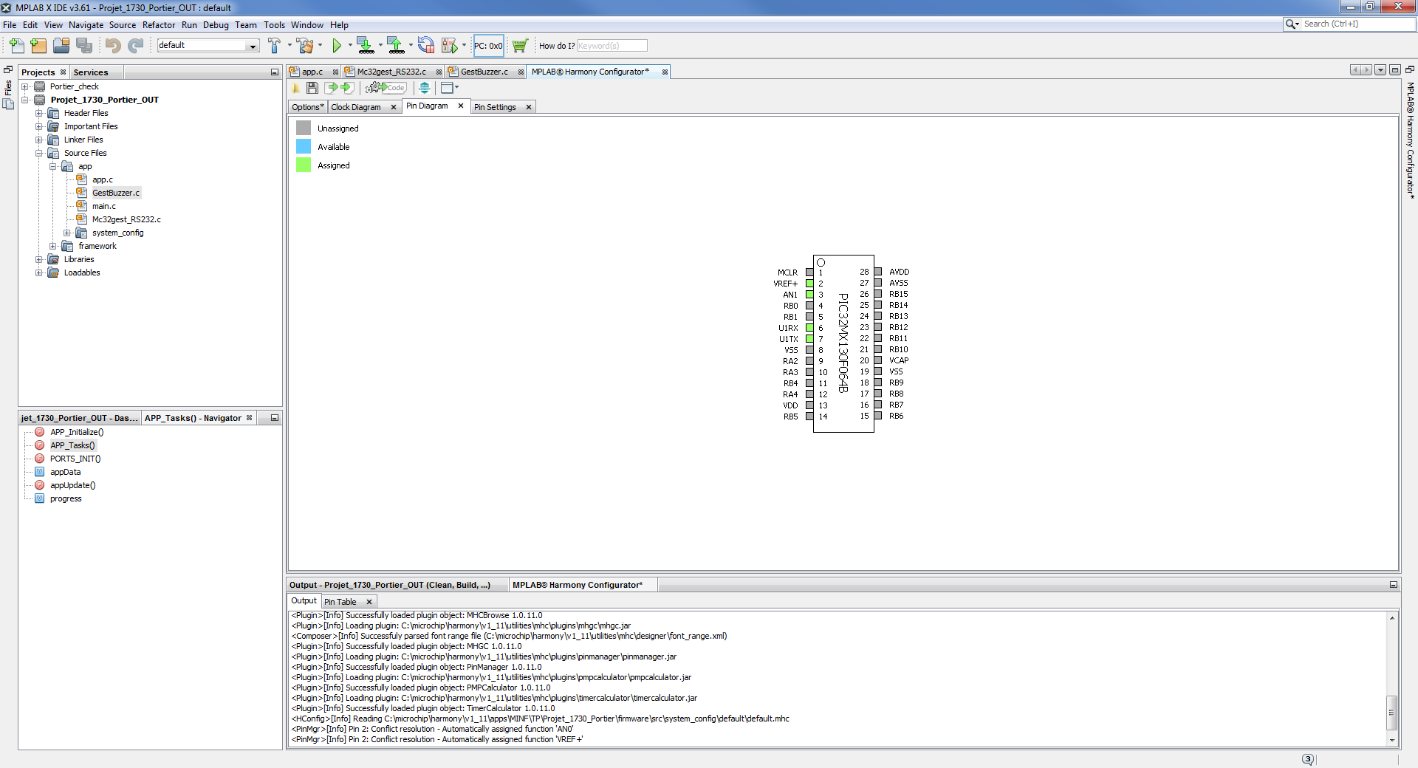
doc/IMG_Rapport/Proj_Pinout.png
