ETML-ES-SLO/PRJ_1730_PortierWireless/doc/IMG_Rapport/transfo.jpg

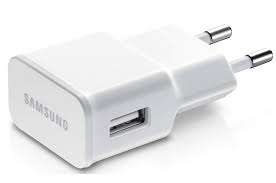
doc/IMG_Rapport/transfo.jpg
