ETML-ES-SLO/PRJ_1730_PortierWireless/doc/IMG_Rapport/USB.jpg

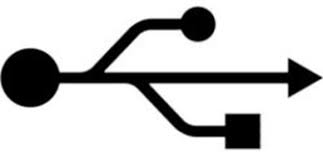
doc/IMG_Rapport/USB.jpg
