ETML-ES-SLO/PRJ_1730_PortierWireless/doc/Modification/Mod 3.0/3_Doxygen/docbook/_management_8h__incl.png

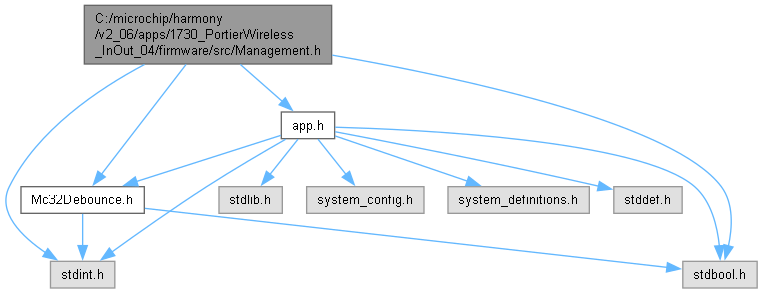
doc/Modification/Mod 3.0/3_Doxygen/docbook/_management_8h__incl.png
