ETML-ES-SLO/PRJ_1730_PortierWireless/doc/Modification/Mod 3.0/3_Doxygen/docbook/_r_f_8c__incl.png

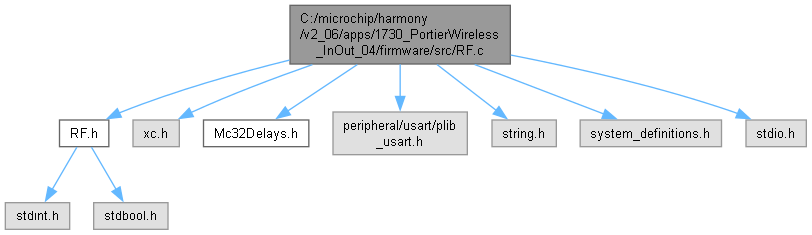
doc/Modification/Mod 3.0/3_Doxygen/docbook/_r_f_8c__incl.png
