ETML-ES-SLO/PRJ_1730_PortierWireless/doc/Modification/Mod 3.0/3_Doxygen/docbook/dir_3c1ce8462c07dfc038ad7ef552c344f0_dep.png

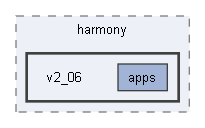
doc/Modification/Mod 3.0/3_Doxygen/docbook/dir_3c1ce8462c07dfc038ad7ef552c344f0_dep.png
