ETML-ES-SLO/PRJ_1730_PortierWireless/doc/Modification/Mod 3.0/3_Doxygen/docbook/dir_8e86079d32e24360c681a957ed9a9585_dep.png

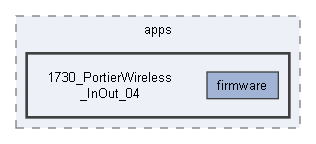
doc/Modification/Mod 3.0/3_Doxygen/docbook/dir_8e86079d32e24360c681a957ed9a9585_dep.png
