ETML-ES-SLO/PRJ_1730_PortierWireless/doc/Modification/Mod 3.0/3_Doxygen/docbook/dir_580ddd0237585ac315b4ef98a15174fa_dep.png

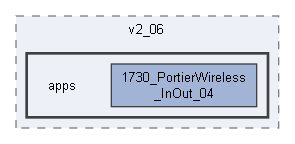
doc/Modification/Mod 3.0/3_Doxygen/docbook/dir_580ddd0237585ac315b4ef98a15174fa_dep.png
