ETML-ES-SLO/PRJ_1730_PortierWireless/doc/Modification/Mod 3.0/3_Doxygen/docbook/dir_7729169af531c636b6b5252162dc6bbe_dep.png

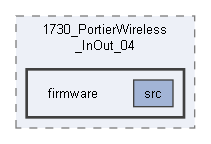
doc/Modification/Mod 3.0/3_Doxygen/docbook/dir_7729169af531c636b6b5252162dc6bbe_dep.png
