ETML-ES-SLO/PRJ_1730_PortierWireless/doc/Modification/Mod 3.0/3_Doxygen/docbook/struct_s___switch_descriptor__coll__graph.png

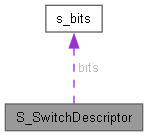
doc/Modification/Mod 3.0/3_Doxygen/docbook/struct_s___switch_descriptor__coll__graph.png
