ETML-ES-SLO/PRJ_1730_PortierWireless/hard/Portier_17300C_JMO/LIBRAIRIES/MECH/Face avant Gravoply OUT.png

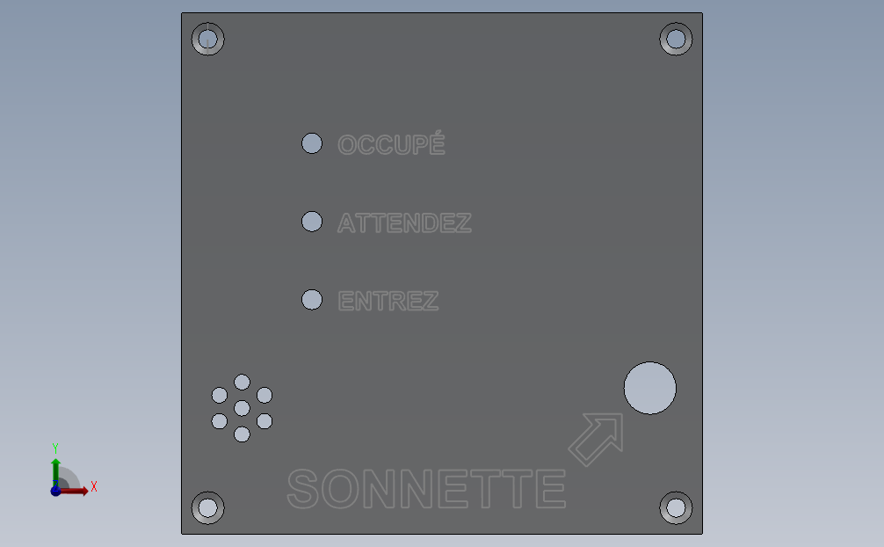
hard/Portier_17300C_JMO/LIBRAIRIES/MECH/Face avant Gravoply OUT.png
