ETML-ES-SLO/PRJ_1730_PortierWireless/hard/Portier_17300C_JMO/LIBRAIRIES/MECH/LFC 050 CTP.png

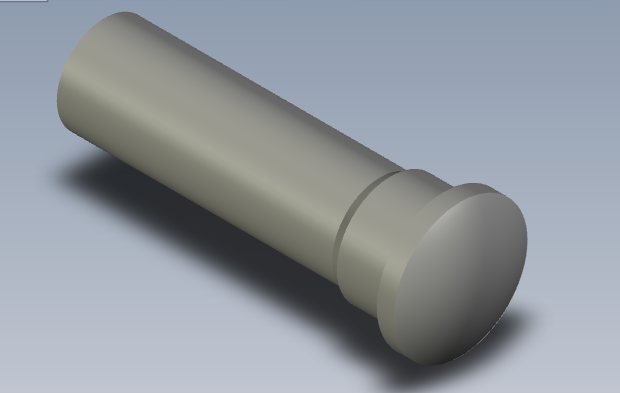
hard/Portier_17300C_JMO/LIBRAIRIES/MECH/LFC 050 CTP.png
