ETML-ES-SLO/PRJ_1730_PortierWireless/hard/Portier_17300C_JMO/LIBRAIRIES/MECH/M3x05_MF_971050365.png

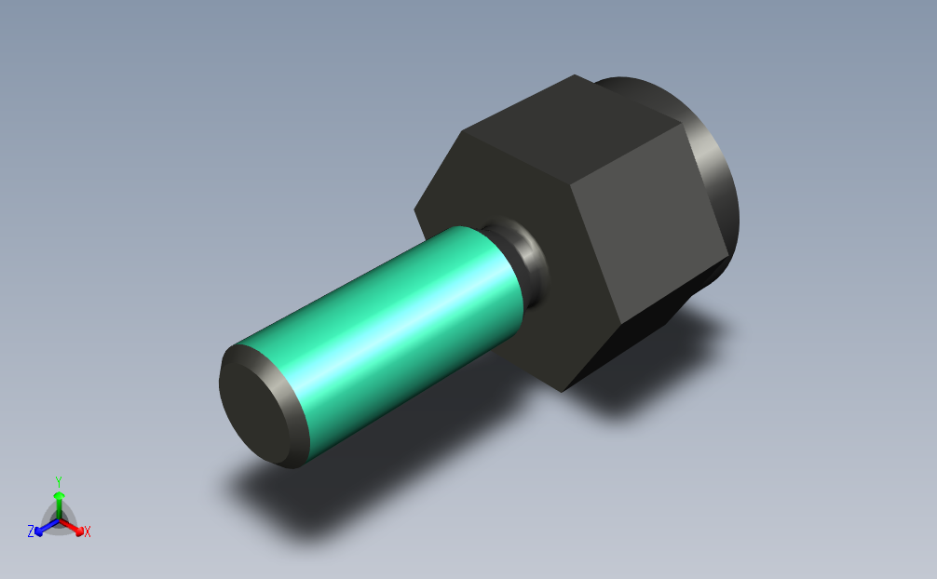
hard/Portier_17300C_JMO/LIBRAIRIES/MECH/M3x05_MF_971050365.png
