ETML-ES-SLO/PRJ_1730_PortierWireless/hard/Portier_17300C_JMO/LIBRAIRIES/MECH/M3x06_Countersunk.png

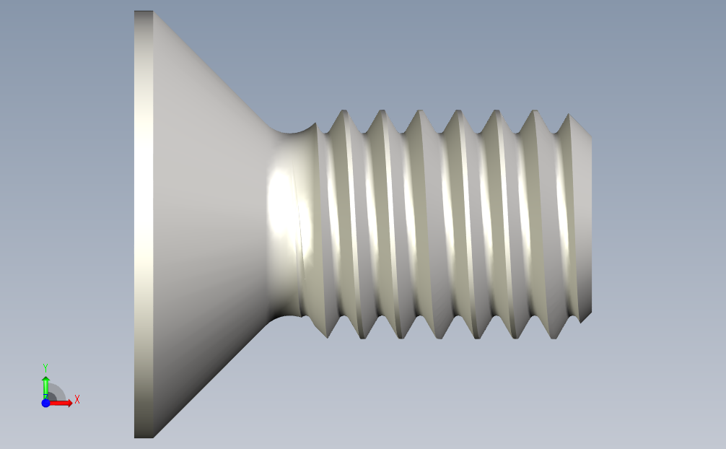
hard/Portier_17300C_JMO/LIBRAIRIES/MECH/M3x06_Countersunk.png
