ETML-ES-SLO/PRJ_1730_PortierWireless/hard/Portier_17300C_JMO/LIBRAIRIES/MECH/M3x14_FF_970140365-fil.png

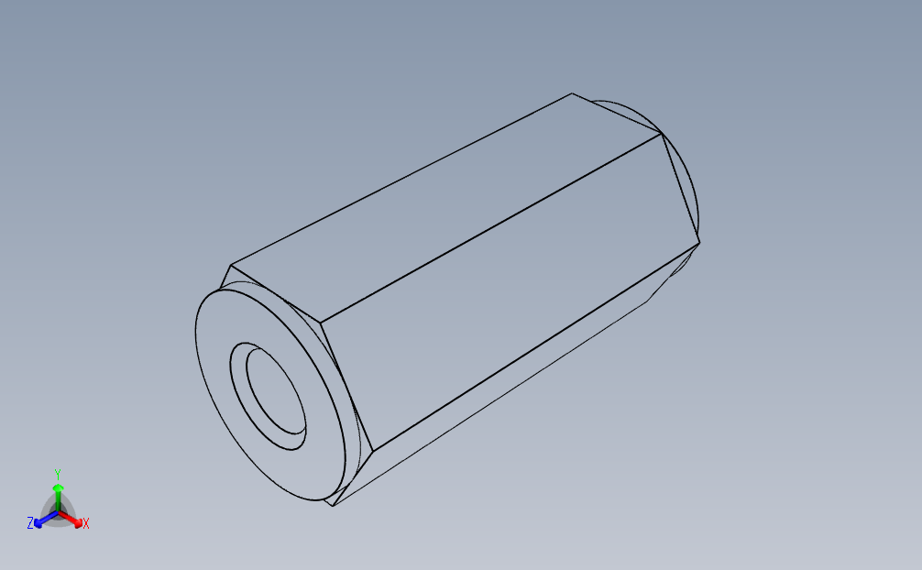
hard/Portier_17300C_JMO/LIBRAIRIES/MECH/M3x14_FF_970140365-fil.png
