ETML-ES-SLO/PRJ_1730_PortierWireless/hard/Portier_17300C_JMO/LIBRAIRIES/MECH/Xbee/User Library-XBee.png

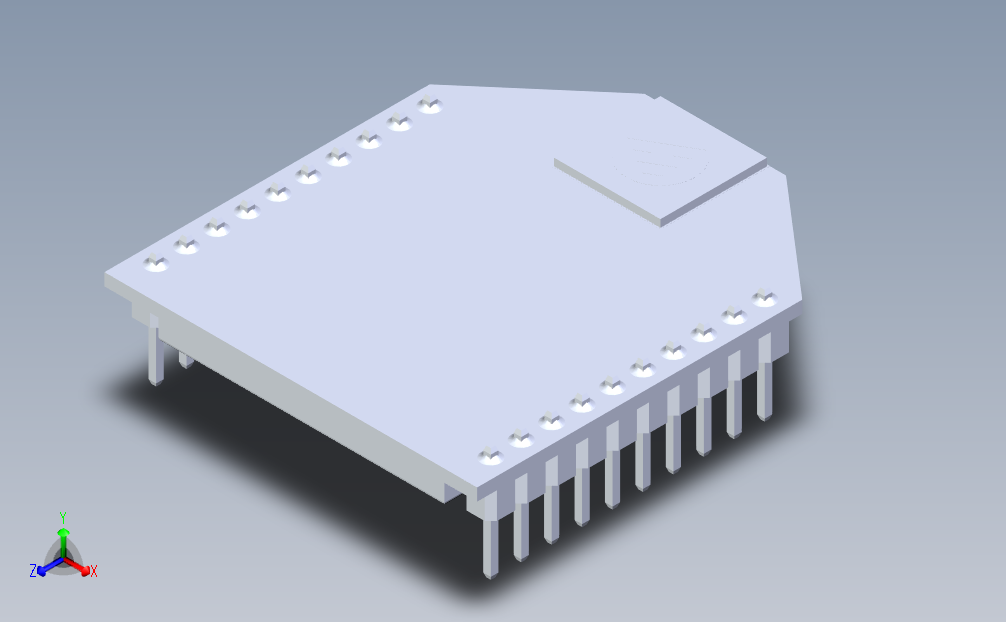
hard/Portier_17300C_JMO/LIBRAIRIES/MECH/Xbee/User Library-XBee.png
