ETML-ES-SLO/PRJ_1730_PortierWireless/hard/Portier_17300C_JMO/Project Outputs for Portier_1730/ETML_Mfg_Docs/17300C-Capture Panel EC Avant Commande.png

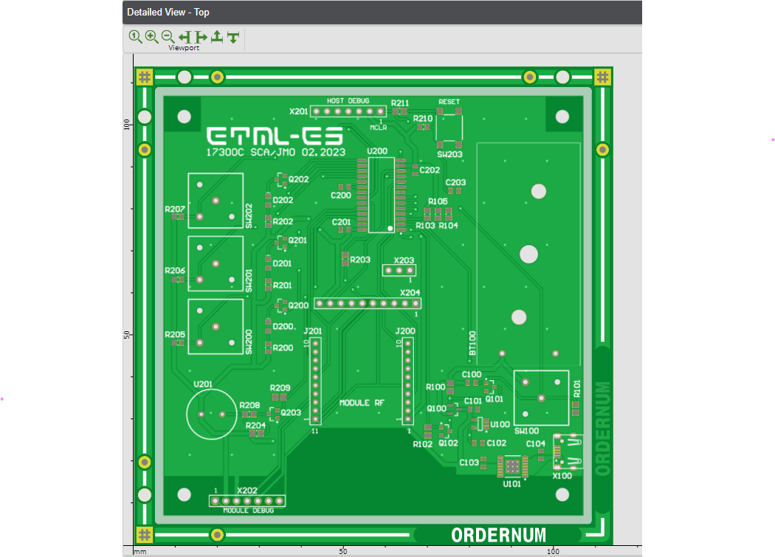
hard/Portier_17300C_JMO/Project Outputs for Portier_1730/ETML_Mfg_Docs/17300C-Capture Panel EC Avant Commande.png
