ETML-ES-SLO/PRJ_1730_PortierWireless/hard/Portier_17300C_JMO/Project Outputs for Portier_1730/Portier_1730_ES_BOM_Cost_All_Variants.xlsx

Line # | Designator | Value | Name | Description | Qty | Fitted | PCBA_Door - Qty | PCBA_Door - Price | PCBA_Bell - Qty | PCBA_Bell - Price | MEC_Assy_Door - Qty | MEC_Assy_Door - Price | MEC_Assy_Bell - Qty | MEC_Assy_Bell - Price | Manufacturer 1 | Manufacturer PN 1 | Supplier 1 | Supplier PN 1 | Supplier Unit Price 1 | Supplier Subtotal 1
1 | BT100 | 2 x 1.5V AAA | 2 x 1.5V AAA | Cylindrical Battery Contacts, Clips, Holders & Springs 2AAA PC MNT HOLDER | 1 | Varied | 1 | 15.02 | 0 | 0 | 1 | 15.02 | 0 | 0 | Keystone Electronics | 2468 | Digi-Key | 36-2468-ND | 1.25 | 15.02 | 0.50 | 7.50 | 7.50
2 | C100, C101, C102 |  | 100nF | WCAP-CSGP Multilayer Ceramic Chip Capacitor, General Purpose, size 0805, X7R, 100nF, 50VDC | 3 | Varied | 3 | 5.27 | 0 | 2.64 | 3 | 5.27 | 0 | 2.64 | Wurth Electronics | 885012207098 | Digi-Key | 732-8080-1-ND | 0.07322 | 5.27 | 1.00 | 1.32 | 1.32
3 | C103, C104 | 4.7µF 16V | 4.7µF | WCAP-CSGP Multilayer Ceramic Chip Capacitor, General Purpose, size 0805, X7R, 4.7µF, 16VDC | 2 | Varied | 0 | 0 | 2 | 8.19 | 0 | 0 | 2 | 8.19 | Wurth Electronics | 885012207053 | Digi-Key | 732-7666-1-ND | 0.34109 | 8.19 | 0.50 | 4.09 | 4.09
4 | C200 | 10uF 16V | 10µF | WCAP-CSGP Multilayer Ceramic Chip Capacitor, General Purpose, size 0805, X5R, 10µF, 16VDC | 1 | Fitted | 1 | 3.04 | 1 | 3.04 | 1 | 3.04 | 1 | 3.04 | Wurth Electronics | 885012107014 | Digi-Key | 732-7624-1-ND | 0.25304 | 3.04 | 0.25 | 3.04 | 3.04
2 | C201, C202, C203 |  | 100nF | WCAP-CSGP Multilayer Ceramic Chip Capacitor, General Purpose, size 0805, X7R, 100nF, 50VDC | 3 | Fitted | 3 | 5.27 | 3 | 2.64 | 3 | 5.27 | 3 | 2.64 | Wurth Electronics | 885012207098 | Digi-Key | 732-8080-1-ND | 0.07322 | 5.27 | 0.50 | 2.64 | 2.64
5 | D200, D201, D202 |  | Green, 2V, 40° | WL-SMCW Mono-color Chip LED Waterclear, size 0805, Bright Green, 2V, 140° | 3 | Fitted | 3 | 8.14 | 3 | 8.14 | 3 | 8.14 | 3 | 8.14 | Kingbright | APTD2012LCGCK | Digi-Key | 754-2043-1-ND | 0.22616 | 8.14 | 0.25 | 8.14 | 8.14
6 | J200, J201 | HD 10x1 2mm | 62001011821 | WR-PHD Socket Header, THT, Vertical, pitch 2mm, 1 Row, 10P | 2 | Fitted | 2 | 25.8 | 2 | 25.8 | 2 | 25.8 | 2 | 25.8 | Wurth Electronics | 62001011821 | Mouser | 710-62001011821 | 1.08 | 25.8 | 0.25 | 25.92 | 25.92
7 | LG1, LG2, LG3 |  | LFC 050 CTP | Light Guide pour panneau pour Leds | 3 | Varied | 0 | 0 | 0 | 0 | 3 | 18.55 | 3 | 18.55 | Visual Communications | LFC050CTP | Mouser | 593-LFC050CTP | 0.51535 | 18.55 | 0.50 | 0.00 | 18.55
8 | ME1, ME2, ME3, ME4 |  | Spacer M3x14 F-F | Hexagonal Plastic Spacer Stud, M3x14 F-F | 4 | Varied | 0 | 0 | 0 | 0 | 4 | 36.8 | 4 | 36.8 | Wurth Electronics | 970140365 | Digi-Key | 732-13006-ND | 0.73595 | 36.8 | 0.52 | 0.00 | 35.33
9 | ME5, ME6, ME7, ME8 |  | Spacer M3x05 M-F | Hexagonal Plastic Spacer Stud, M3x05 M-F | 4 | Varied | 0 | 0 | 0 | 0 | 4 | 37.03 | 4 | 37.03 | Wurth Electronics | 971050365 | Digi-Key | 732-13041-ND | 0.74058 | 37.03 | 0.52 | 0.00 | 35.55
10 | ME9, ME10, ME11, ME12, ME13, ME14, ME15, ME16 |  | M3x06 | M3x06 Coutersunk screw | 8 | Varied | 0 | 0 | 0 | 0 | 8 | 9.6 | 8 | 9.6 | Bossard | 1402994 | Bossard | 1402994 | 0.1 | 9.6 | 0.50 | 0.00 | 9.60
11 | MP1 | 9774030360 | M3 x 3mm | WA-SMSI SMT Steel Spacer with internal Thread, OD 6mm, M3 x 3mm | 1 | Varied | 1 | 18.05 | 0 | 0 | 1 | 18.05 | 0 | 0 | Wurth Electronics | 9774030360R | Digi-Key | 732-5270-1-ND | 1.5 | 18.05 | 0.50 | 9.00 | 9.00
40 | PCB1 | PCB 17300C | Bare board |  | 1 |  | 1 | 218.26 | 1 | 218.26 | 1 | 218.26 | 1 | 218.26 | EuroCircuits | 17300C | EuroCircuits | 17300C | 18.19 | 218.26 | 0.25 | 218.28 | 218.28
12 | Q100 | FDN336P | FDN336P | MOSFET P-CH 20V 1.3A SSOT3 | 1 | Varied | 1 | 4.26 | 0 | 0 | 1 | 4.26 | 0 | 0 | ON Semiconductor / Fairchild | FDN336P | Digi-Key | FDN336PCT-ND | 0.355 | 4.26 | 0.50 | 2.13 | 2.13
13 | Q101, Q102 | IRLML2402TRBF | IRLML2402TRPBF | HEXFET(R) Power MOSFET, N-Channel, 20 V, 1.2 A, 3-Pin SOT-23, RoHS, Tape and Reel | 2 | Varied | 2 | 20.35 | 0 | 14.37 | 2 | 20.35 | 0 | 14.37 | Infineon | IRLML2402TRPBF | Digi-Key | IRLML2402PBFCT-ND | 0.20354 | 20.35 | 2.08 | 2.44 | 2.44
13 | Q200, Q201, Q202, Q203 | IRLML2402TRBF | IRLML2402TRPBF | HEXFET(R) Power MOSFET, N-Channel, 20 V, 1.2 A, 3-Pin SOT-23, RoHS, Tape and Reel | 4 | Fitted | 4 | 20.35 | 4 | 14.37 | 4 | 20.35 | 4 | 14.37 | Infineon | IRLML2402TRPBF | Digi-Key | IRLML2402PBFCT-ND | 0.20354 | 20.35 | 0.52 | 9.77 | 9.77
14 | R100, R101, R102 | 100k | ERJ-6ENF1003V |  | 3 | Varied | 3 | 1.66 | 0 | 0.48939 | 3 | 1.66 | 0 | 0.48939 | Yageo | AC0805FR-07100KL | Digi-Key | YAG3688CT-ND | 0.01659 | 1.66 | 1.39 | 0.30 | 0.30
15 | R103, R105 | 22k | CRCW080522K0FKEA |  | 2 | Varied | 2 | 1.1 | 0 | 0.36705 | 2 | 1.1 | 0 | 0.36705 | Yageo | RC0805FR-0722KL | Digi-Key | 311-22.0KCRCT-ND | 0.03059 | 1.1 | 0.75 | 0.37 | 0.37
15 | R104 | 22k | CRCW080522K0FKEA |  | 1 | Fitted | 1 | 1.1 | 1 | 0.36705 | 1 | 1.1 | 1 | 0.36705 | Yageo | RC0805FR-0722KL | Digi-Key | 311-22.0KCRCT-ND | 0.03059 | 1.1 | 0.75 | 0.37 | 0.37
16 | R200, R201, R202 |  | CRCW0805750KFKEA |  | 3 | Fitted | 3 | 2.27 | 3 | 2.27 | 3 | 2.27 | 3 | 2.27 | Vishay | CRCW0805750KFKEA | Mouser | 71-CRCW0805-750K-E3 | 0.06303 | 2.27 | 0.25 | 2.27 | 2.27
17 | R203, R204, R211 | 1k | CRCW08051K00FKEA |  | 3 | Fitted | 3 | 2.24 | 3 | 2.24 | 3 | 2.24 | 3 | 2.24 | Vishay Dale | CRCW08051K00FKEA | Digi-Key | 541-1.00KCCT-ND | 0.0621 | 2.24 | 0.25 | 2.24 | 2.24
18 | R205, R206, R207, R210 | 10k | RC0805FR-0710KL | Chip Resistor, 10 KOhm, +/- 1%, 0.125 W, -55 to 155 degC, 0805 (2012 Metric), RoHS, Tape and Reel | 4 | Fitted | 4 | 1.24 | 4 | 1.24 | 4 | 1.24 | 4 | 1.24 | Yageo | RC0805FR-0710KL | Digi-Key | 311-10.0KCRCT-ND | 0.01242 | 1.24 | 0.52 | 0.60 | 0.60
19 | R208 | 0R | RC0805JR-100RL | Chip Resistor, 0 Ohm, +/- 5%, 125 mW, -55 to 155 degC, 0805 (2012 Metric), RoHS, Tape and Reel | 1 | Fitted | 1 | 0.17796 | 1 | 0.17796 | 1 | 0.17796 | 1 | 0.17796 | Yageo | RC0603JR-070RL | Digi-Key | 311-0.0GRCT-ND | 0.01483 | 0.17796 | 0.25 | 0.18 | 0.18
14 | R209 | 100k | ERJ-6ENF1003V |  | 1 | Fitted | 1 | 1.66 | 1 | 0.48939 | 1 | 1.66 | 1 | 0.48939 | Yageo | AC0805FR-07100KL | Digi-Key | YAG3688CT-ND | 0.01659 | 1.66 | 2.08 | 0.20 | 0.20
20 | SW100 |  | Tact-sw 1241.1022 |  | 1 | Varied | 1 | 42.38 | 0 | 127.13 | 1 | 42.38 | 0 | 127.13 | Schurter | 1241.1022 | Mouser | 693-1241.1022 | 2.62 | 131.15 | 2.09 | 15.72 | 15.72
20 | SW200, SW201, SW202 |  | Tact-sw 1241.1022 |  | 3 | Varied | 0 | 42.38 | 3 | 127.13 | 0 | 42.38 | 3 | 127.13 | Schurter | 1241.1022 | Mouser | 693-1241.1022 | 2.62 | 131.15 | 0.70 | 47.16 | 47.16
21 | SW203 | 430182043816 | 430182043816 | WS-TASV SMT Tact Switch, L6 x W6 x H4.3mm, 160g, SPST-NO, 12V, 50mA | 1 | Fitted | 1 | 5.89 | 1 | 5.89 | 1 | 5.89 | 1 | 5.89 | Wurth Electronics | 430182043816 | Digi-Key | 732-7004-1-ND | 0.49125 | 5.89 | 0.25 | 5.90 | 5.90
22 | U100 | LM4125IM5-2.0 | LM4125IM5-2.0/NOPB | Precision Micropower Low Dropout Voltage Reference, 5-pin SOT-23, Pb-Free | 1 | Varied | 1 | 21.62 | 0 | 0 | 1 | 21.62 | 0 | 0 | TI National Semiconductor | LM4125IM5-2.0/NOPB | Digi-Key | LM4125IM5-2.0/NOPBCT-ND | 1.8 | 21.62 | 0.50 | 10.80 | 10.80
23 | U101 | MAX1793EUE33 | MAX1793 | IC REG LINEAR POS ADJ 1A 16TSSOP | 1 | Varied | 0 | 0 | 1 | 43.68 | 0 | 0 | 1 | 43.68 | Maxim | MAX1793EUE33+ | Digi-Key | MAX1793EUE33+-ND | 3.64 | 43.68 | 0.50 | 21.84 | 21.84
24 | U200 | PIC32MX130F064B-I/SO | PIC32MX130F064B-I/SO | 32-bit Microcontroller with Audio and Graphics Interface, USB and Advanced Analog, 40 MHz, 21 I/O, PMP, -40 to 85 degC, 28-pin SOIC (SO28), Tube | 1 | Fitted | 1 | 38.6 | 1 | 38.6 | 1 | 38.6 | 1 | 38.6 | Microchip | PIC32MX130F064B-I/SO | Mouser | 579-32MX130F064BISO | 3.22 | 38.6 | 0.25 | 38.64 | 38.64
25 | U201 | PS1240P02BT | BuzzerPiezo | Buzzer 12mm piezo | 1 | Fitted | 1 | 5.91 | 1 | 5.91 | 1 | 5.91 | 1 | 5.91 | TDK | PS1240P02BT | Digi-Key | 445-2525-1-ND | 0.49218 | 5.91 | 0.25 | 5.91 | 5.91
26 | X100 |  | Micro_USB | WR-COM_USB_Micro Type B_Horizontal_SMT | 1 | Varied | 0 | 0 | 1 | 22.55 | 0 | 0 | 1 | 22.55 | Wurth Electronics | 629105150521 | Digi-Key | 732-5960-1-ND | 1.88 | 22.55 | 0.50 | 11.28 | 11.28
27 | X201, X202 | HD 7x1 2.54mm | 61300711121 | WR-PHD Pin Header, THT, Vertical, pitch 2.54mm, 1 Row, 7P | 2 | Fitted | 2 | 6.49 | 2 | 6.49 | 2 | 6.49 | 2 | 6.49 | Wurth Electronics | 61300711121 | Digi-Key | 732-5320-ND | 0.25953 | 6.49 | 0.26 | 6.23 | 6.23
28 | X203 | HD 3x1 2.54mm | 61300311121 | WR-PHD Pin Header, THT, Vertical, pitch 2.54mm, 1 Row, 3P | 1 | Fitted | 1 | 1.26 | 1 | 1.26 | 1 | 1.26 | 1 | 1.26 | Wurth Electronics | 61300311121 | Digi-Key | 732-5316-ND | 0.10474 | 1.26 | 0.25 | 1.26 | 1.26
29 | X204 | HD 10x1 2.54mm | 61301011121 | WR-PHD Pin Header, THT, Vertical, pitch 2.54mm, 1 Row, 10P | 1 | Fitted | 1 | 10.37 | 1 | 10.37 | 1 | 10.37 | 1 | 10.37 | Wurth Electronics | 61301011121 | Digi-Key | 732-2670-ND | 0.86386 | 10.37 | 0.25 | 10.37 | 10.37
30 | XB1 | 2x10 | ModulesRxTx868MHz_NC_3D | 2x Header 2x10 2mm / compatible xBee - sans connexion, avec footprint | 1 | Varied | 0 | 0 | 0 | 0 | 1 | 180 | 0 | 0 | ETML-ES | ModuleRF_RxTx | ETML-ES | ModuleRF_RxTx | 15 | 180 | 1.00 | 0.00 | 90.00
31 | XB2 |  | Xbee_Module | Module Xbee 3D pour BOM et représentation 3D | 1 | Varied | 0 | 0 | 0 | 0 | 0 | 0 | 1 | 368.16 | Digi International | XB24CAPIT-001 | Digi-Key | 602-1892-ND | 30.68 | 368.16 | 1.00 | 0.00 | 184.08
32 | ZPNL1 |  | Front Panel Door | Panneau de face avant de porte (Portier electronique) | 1 | Varied | 0 | 0 | 0 | 0 | 1 | 12 | 0 | 0 | ETML-ES | Face avant Gravoply OUT | ETML-ES | Face avant Gravoply OUT | 1 | 12 | 1.00 | 0.00 | 6.00
33 | ZPNL2 |  | Front Panel Bell | Panneau de face avant de porte (Portier electronique) | 1 | Varied | 0 | 0 | 0 | 0 | 0 | 0 | 1 | 12 | ETML-ES | Face avant Gravoply IN | ETML-ES | Face avant Gravoply IN | 1 | 12 | 1.00 | 0.00 | 6.00
34 | ZPNL3 |  | Rear Panel | Panneau de face arriere de porte (Portier electronique) | 1 | Varied | 0 | 0 | 0 | 0 | 1 | 12 | 1 | 12 | ETML-ES | Face arriere PMMA | ETML-ES | Face arriere PMMA | 1 | 12 | 0.50 | 0.00 | 12.00
 |  |  |  |  |  |  |  |  |  |  |  |  |  |  |  |  |  |  |  |  |  | 475.87 | 872.98
 |  |  |  |  |  |  |  |  |  |  |  |  |  |  |  |  |  |  |  | Coût moyen par pcb |  | 39.66 | 72.75
