ETML-ES-SLO/PRJ_1730_PortierWireless/hard/Portier_17300B_SCA/Project Outputs for Portier_1730/Reports/Bill of Materials.xls

Designator | Quantity | Comment | Description | Footprint | LibRef | Supplier | Supplier min. qty | Supplier PN | Supplier unit price
BT100 | 1 | 2 x 1.5V | Battery Support 2x1.5V type AAA | BatterySupport | Battery connector AAA | ? A retrouver? Stock magasin ETML ?
C100, C101, C201, C202, C203 | 5 | 100nF | Chip Capacitor, 100 nF, +/- 10%, 16 V, -55 to 85 degC, 0805 (2012 Metric), RoHS, Tape and Reel | CAPC2013X100X20NL20 | CMP-1663-00007-1 | Stock ES
C102 | 1 | 1uF | Chip Capacitor, 1 uF, 25 V, 10%, -55 to 125 degC, 0805 (2012 Metric), RoHS, Tape and Reel | CAPC2013X145X50ML20T25 | CMP-2100-03605-1 | Stock ES
C103, C104 | 2 | 4.7uF | Chip Capacitor, 4.7 uF, +/- 10%, 16 V, -55 to 85 degC, 0805 (2012 Metric), RoHS, Tape and Reel | CAPC2013X135X45LL10T25 | CMP-1662-00015-2 | Stock ES
C200 | 1 | 10uF | CAP, Ceramic, 10 uF, +/- 10%, 16 V, -55 to 125 degC, 1206 (3216 Metric), RoHS, Tape and Reel | CAPC3216X180X50ML20T25 | CMP-1664-00006-1 | Stock ES
D200, D201, D202 | 3 | LGR971-KN-1 | SMD mono-color Chip LED, 0805, Green | LED_0805 | LGR971-KN-1 | Stock ES
Q100 | 1 | FDN306P | P-Channel Specified Power Trench (R) MOSFET, 1.8 V, -55 to 150 degC, 3-Pin SOT, RoHS, Tape and Reel | FAIR-SSOT3L-3_V | CMP-2000-06248-1 | Digi-key |  | FDN306PCT-ND
Q101, Q102, Q200, Q201, Q202, Q203 | 6 | IRLML2402 | HEXFET(R) Power MOSFET, N-Channel, 20 V, 1.2 A, 3-Pin SOT-23, RoHS, Tape and Reel | INTR-IRLML2402TRPBF-3_V | CMP-2000-05155-1 | Digi-key,Stock ES | 1 | IRLML2402PBFCT-ND | 0.34
R100, R101, R102, R209 | 4 | 100k | Chip Resistor, 100 KOhm, +/- 1%, 125 mW, -55 to 155 degC, 0805 (2012 Metric), RoHS, Tape and Reel | RESC2013X60X35ML10T20 | CMP-2100-03671-1 | Stock ES
R103 | 1 | 11k 1% | 11k 0.125W 0805 (2012 Metric) SMD | RESC0805(2012)_N | CMP-1013-00075-1 | Stock ES
R104 | 1 | 22k 1% | 22k 0.125W 0805 (2012 Metric) SMD | RESC0805(2012)_L | CMP-1013-00082-1 | Stock ES
R200, R201, R202 | 3 | 750R | 750R 0.125W 1% 0805 (2012 Metric) SMD | RESC0805(2012)_N | CMP-1013-00496-1 | Stock ES
R203, R204 | 2 | 1k | Chip Resistor, 1 KOhm, +/- 1%, 125 mW, -55 to 155 degC, 0805 (2012 Metric), RoHS, Tape and Reel | RESC2013X60X35ML10T20 | CMP-2100-03671-1 | Stock ES
R205, R206, R207, R210 | 4 | 10k | Chip Resistor, 10 KOhm, +/- 1%, 0.125 W, -55 to 155 degC, 0805 (2012 Metric), RoHS, Tape and Reel | RESC2013X60X35NL10T20 | CMP-1659-00013-4, CMP-1659-00011-4 | Stock ES
R208 | 1 | 0R | Chip Resistor, 1 KOhm, +/- 1%, 125 mW, -55 to 155 degC, 0805 (2012 Metric), RoHS, Tape and Reel | RESC2013X60X35ML10T20 | CMP-2100-03671-1 | Stock ES
R211 | 1 | 1k | Chip Resistor, 1 KOhm, +/- 1%, 0.125 W, -55 to 155 degC, 0805 (2012 Metric), RoHS, Tape and Reel | RESC2013X60X35NL10T20 | CMP-1659-00011-4 | Stock ES
SW100 | 1 | Poussoir | Switch 12.7x12.7x17.5 | Switch_Schurter | Switch_Schurter
SW200, SW201, SW202 | 3 | SW | Switch 12.7x12.7x17.5 | Switch_Schurter | Switch_Schurter
SW203 | 1 | 430152050836 | WS-TASV 6x6mm Tact Switch, SMD version | 4301x20508x6_6x6x5 | 430152050836 | Stock ES
U100 | 1 | LT1790BCS6 | IC VREF SERIES 2.048V SOT23-6 | SOT-23 | LT1790 | Digi-key |  | LT1790BCS6-2.048#TRMPBFCT-ND
U101 | 1 | MAX1793 | IC REG LINEAR POS ADJ 1A 16TSSOP | TSOP65P640X110_HS-17N | MAX1793 | Stock ES
U200 | 1 | PIC32MX130F064B-I/SO | 32-bit Microcontroller with Audio and Graphics Interface, USB and Advanced Analog, 40 MHz, 21 I/O, PMP, -40 to 85 degC, 28-pin SOIC (SO28), Tube | MCHP-SOIC-SO28_L | CMP-0048-00454-1 | Digi-key |  | PIC32MX130F064B-I/SO-ND
U201 | 1 | BuzzerPiezo | Buzzer 12mm piezo | Buzzer | BZR | Digi-key | 1 | 445-2525-1-ND | 0.67
X100 | 1 | Micro_USB | WR-COM_USB_Micro Type B_Horizontal_SMT | Micro_USB | WR-Communication Connectors 629105150521 | Digi-key | 1 | 732-5960-1-ND | 2.03
X200 | 1 | ModulesRxTx868MHz_1623 | 2x Header 2x10 2mm / compatible xBee | ModulesRxTx868MHz_1623 | ModulesRxTx868MHz_1623 | Digi-key | 1 | 2x 3M156413-10-ND | 2x 0.74
X201, X202 | 2 | 2.54 mm_THT_Vertical_7 pin | Pin Header WR-PHD, pitch 2.54 mm, THT, Vertical, single row, 7 pin | 61300711121 | 61300711121 | Stock ES
X203 | 1 | TSW-103-07-F-S | 0.025" SQ Post Header, Through-hole, Vertical, -55 to 125 degC, 2.54 mm Pitch, 3-Pin, Male, RoHS | SMTC-TSW-103-07-X-S | CMP-1024-00331-1 | Stock ES
X204 | 1 | 61301011121 | WR-PHD 2.54 mm THT Pin Header, 10p | 61301011121 | 61301011121
