ETML-ES-SLO/PRJ_1730_PortierWireless/hard/Portier_17300C_JMO/Project Outputs for Portier_1730/ETML_Mfg_Docs/BOM_Cost_ES_Variant_PCBA_Bell.xlsx

Sheet: BOM Cost Report
BOM Cost |  | PROJET: | Portier_1730.PrjPcb |  |  |  |  |  |  | ETML-ES | Rue de Sébeillon 12 1004 Lausanne
Date: | 28.02.2023 | Variante: | PCBA_Bell |  |  |  |  |  |  | Quantité de production (nb PCBs) : | 6
Par: | SCA/JMO | Source: | Portier_1730.BomDoc |  |  |  |  |  |  | Devise : | CHF
Line # | Designator | Value | Name | Manufacturer 1 | Manufacturer PN 1 | Qty | Supplier 1 | Supplier PN 1 | Supplier Currency 1 | Supplier Unit Price 1 | Supplier Subtotal 1
2 | C201, C202, C203 |  | 100nF | Wurth Electronics | 885012207098 | 3 | Digi-Key | 732-8080-1-ND | CHF | 0.0732 | 1.32
3 | C103, C104 | 4.7µF 16V | 4.7µF | Wurth Electronics | 885012207053 | 2 | Digi-Key | 732-7666-1-ND | CHF | 0.3411 | 4.09
4 | C200 | 10uF 16V | 10µF | Wurth Electronics | 885012107014 | 1 | Digi-Key | 732-7624-1-ND | CHF | 0.2781 | 1.67
5 | D200, D201, D202 |  | Green, 2V, 40° | Kingbright | APTD2012LCGCK | 3 | Digi-Key | 754-2043-1-ND | CHF | 0.2262 | 4.07
6 | J200, J201 | HD 10x1 2mm | 62001011821 | Wurth Electronics | 62001011821 | 2 | Mouser | 710-62001011821 | CHF | 1.0800 | 12.90
13 | Q200, Q201, Q202, Q203 | IRLML2402TRBF | IRLML2402TRPBF | Infineon | IRLML2402TRPBF | 4 | Digi-Key | IRLML2402PBFCT-ND | CHF | 0.2994 | 7.19
14 | R209 | 100k | ERJ-6ENF1003V | Yageo | AC0805FR-07100KL | 1 | Digi-Key | YAG3688CT-ND | CHF | 0.0408 | 0.41
15 | R104 | 22k | CRCW080522K0FKEA | Yageo | RC0805FR-0722KL | 1 | Digi-Key | 311-22.0KCRCT-ND | CHF | 0.0306 | 0.31
16 | R200, R201, R202 |  | CRCW0805750KFKEA | Vishay | CRCW0805750KFKEA | 3 | Mouser | 71-CRCW0805-750K-E3 | CHF | 0.0630 | 1.13
17 | R203, R204, R211 | 1k | CRCW08051K00FKEA | Vishay Dale | CRCW08051K00FKEA | 3 | Digi-Key | 541-1.00KCCT-ND | CHF | 0.0621 | 1.12
18 | R205, R206, R207, R210 | 10k | RC0805FR-0710KL | Yageo | RC0805FR-0710KL | 4 | Digi-Key | 311-10.0KCRCT-ND | CHF | 0.0306 | 0.73
19 | R208 | 0R | RC0805JR-100RL | Yageo | RC0603JR-070RL | 1 | Digi-Key | 311-0.0GRCT-ND | CHF | 0.0148 | 0.15
20 | SW200, SW201, SW202 |  | Tact-sw 1241.1022 | Schurter | 1241.1022 | 3 | Mouser | 693-1241.1022 | CHF | 3.5300 | 63.57
21 | SW203 | 430182043816 | 430182043816 | Wurth Electronics | 430182043816 | 1 | Digi-Key | 732-7004-1-ND | CHF | 0.4913 | 2.95
23 | U101 | MAX1793EUE33 | MAX1793 | Maxim | MAX1793EUE33+ | 1 | Digi-Key | MAX1793EUE33+-ND | CHF | 4.0500 | 24.30
24 | U200 | PIC32MX130F064B-I/SO | PIC32MX130F064B-I/SO | Microchip | PIC32MX130F064B-I/SO | 1 | Mouser | 579-32MX130F064BISO | CHF | 3.2200 | 19.30
25 | U201 | PS1240P02BT | BuzzerPiezo | TDK | PS1240P02BT | 1 | Digi-Key | 445-2525-1-ND | CHF | 0.5747 | 3.45
26 | X100 |  | Micro_USB | Wurth Electronics | 629105150521 | 1 | Digi-Key | 732-5960-1-ND | CHF | 2.0500 | 12.29
27 | X201, X202 | HD 7x1 2.54mm | 61300711121 | Wurth Electronics | 61300711121 | 2 | Digi-Key | 732-5320-ND | CHF | 0.3114 | 3.74
28 | X203 | HD 3x1 2.54mm | 61300311121 | Wurth Electronics | 61300311121 | 1 | Digi-Key | 732-5316-ND | CHF | 0.1205 | 0.72
29 | X204 | HD 10x1 2.54mm | 61301011121 | Wurth Electronics | 61301011121 | 1 | Digi-Key | 732-2670-ND | CHF | 0.8805 | 5.28
40 | PCB1 | PCB 17300C | Bare board | EuroCircuits | 17300C | 1 | EuroCircuits | 17300C | CHF | 18.1900 | 218.26
 |  |  |  |  |  |  |  |  |  |  | CHF 388.95
Approved | Notes

Sheet: Project Information
Project Full Path | D:\Users\Jose\OneDrive\Documents\3-Engineering\Altium\Projects\PousseAvion\TPA_v2\TPA_v2.PrjPcb
Project Filename | TPA_v2.PrjPcb
Variant Name | None
Data-Source Filename | TPA_v2.PrjPcb
Data-Source Full Path | D:\Users\Jose\OneDrive\Documents\3-Engineering\Altium\Projects\PousseAvion\TPA_v2\TPA_v2.PrjPcb
Title | Batch2-BOM_Digikey for Project [TPA_v2.PrjPcb] (No PCB Document Selected)
Total Quantity | 146
Report Time | 00:02
Report Date | 22.05.2021
Report Date & Tine | 22.05.2021 00:02
Output Name | Batch2-BOM_Digikey
Output Type | BOM_PartType
Output Generator Name | BOM
Output Generator Description | Bill of Materials
