ETML-ES-SLO/PRJ_1730_PortierWireless/hard/Portier_17300C_JMO/Project Outputs for Portier_1730/Reports/Copy of Bill of Materials/1730_Circuit_Bell.xlsx

Line # | Name | Description | Designator | Revision ID | Revision State | Revision Status | Quantity | Manufacturer 1 | Manufacturer Part Number 1 | Manufacturer Lifecycle 1 | Supplier 1 | Supplier Part Number 1 | Supplier Unit Price 1 | Supplier Subtotal 1
 | GRM21BR61C475KA88L | Chip Capacitor, 4.7 uF, +/- 10%, 16 V, -55 to 85 degC, 0805 (2012 Metric), RoHS, Tape and Reel | C103, C104 | CMP-1662-00015-2 | Released | Up to date | 2 | Murata | GRM21BR61C475KA88L | Obsolete
 | C1206C106K4RACTU | CAP, Ceramic, 10 uF, +/- 10%, 16 V, -55 to 125 degC, 1206 (3216 Metric), RoHS, Tape and Reel | C200 | CMP-1664-00006-1 | Released | Up to date | 1 | KEMET | C1206C106K4RACTU | Unknown | Newark | 36X2794 | 0.124 | 0.124
 | C2012X5R1C106K085AC | Chip Capacitor, 10 uF, +/- 10%, 16 V, -55 to 85 degC, 0805 (2012 Metric), RoHS, Tape and Reel | C201, C202, C203 | CMP-1663-00007-1 | Released | Up to date | 3 | TDK | C2012X5R1C106K085AC | Not Recommended for New Design | Newark | 25AC8539 | 0.026 | 0.078
 | LGR971-KN-1 | SMD mono-color Chip LED, 0805, Green | D200, D201, D202 |  | Not managed |  | 3
 | IRLML2402TRPBF | HEXFET(R) Power MOSFET, N-Channel, 20 V, 1.2 A, 3-Pin SOT-23, RoHS, Tape and Reel | Q200, Q201, Q202, Q203 | CMP-2000-05155-1 | Released | Up to date | 4 | International Rectifier | IRLML2402TRPBF | Unknown | Farnell | 9102710 | 0.45738 | 2.29
 | 2K2 5% 0805(2012) | 2K2 0.125W 5% 0805 (2012 Metric) SMD | R104 | CMP-1013-00082-1 | Released | Out of date | 1 | Yageo | RC0805JR-072K2L | Unknown | Newark | 68R0264 | 0.001 | 0.001
 | 750R 1% 0805(2012) | 750R 0.125W 1% 0805 (2012 Metric) SMD | R200, R201, R202 | CMP-1013-00496-1 | Released | Out of date | 3 | Vishay | CRCW0805750RFKEA | Unknown | Newark | 42K4661 | 0.005 | 0.015
 | RC0805FR-071KL | Chip Resistor, 1 KOhm, +/- 1%, 125 mW, -55 to 155 degC, 0805 (2012 Metric), RoHS, Tape and Reel | R203, R204, R208, R209 | CMP-2100-03671-1 | Released | Up to date | 4 | Yageo | RC0805FR-071KL | Unknown | Newark | 68X3183 | 0.004 | 0.016
 | RC0805FR-0710KL | Chip Resistor, 10 KOhm, +/- 1%, 0.125 W, -55 to 155 degC, 0805 (2012 Metric), RoHS, Tape and Reel | R205, R206, R207 | CMP-1659-00013-4 | Released | Up to date | 3 | Yageo | RC0805FR-0710KL | Unknown | Newark | 85X1799 | 0.004 | 0.012
 | RC0805FR-0747KL | Chip Resistor, 47 KOhm, +/- 1%, 0.125 W, -55 to 155 degC, 0805 (2012 Metric), RoHS, Tape and Reel | R210, R211 | CMP-1659-00011-4 | Released | Up to date | 2 | Yageo | RC0805FR-0747KL | Unknown | Digi-Key | 311-47.0KCRCT-ND | 0.1 | 0.2
 | SW | Switch 12.7x12.7x17.5 | SW200, SW201, SW202 |  | Not managed |  | 3
 | 430152050836 | WS-TASV 6x6mm Tact Switch, SMD version | SW203 |  | Not managed |  | 1
 | MAX1793 | IC REG LINEAR POS ADJ 1A 16TSSOP | U101 |  | Not managed |  | 1
 | PIC32MX130F064B-I/SO | 32-bit Microcontroller with Audio and Graphics Interface, USB and Advanced Analog, 40 MHz, 21 I/O, PMP, -40 to 85 degC, 28-pin SOIC (SO28), Tube | U200 | CMP-0048-00454-1 | Released | Up to date | 1 | Microchip | PIC32MX130F064B-I/SO | Unknown | Mouser | 579-32MX130F064BISO | 3.47 | 3.47
 | BuzzerPiezo | Buzzer 12mm piezo | U201 |  | Not managed |  | 1
 | Micro_USB | WR-COM_USB_Micro Type B_Horizontal_SMT | X100 |  | Not managed |  | 1
 | ModulesRxTx868MHz_1623 | 2x Header 2x10 2mm / compatible xBee | X200 |  | Not managed |  | 1
 | 2.54 mm_THT_Vertical_7 pin | Pin Header WR-PHD, pitch 2.54 mm, THT, Vertical, single row, 7 pin | X201, X202 |  | Not managed |  | 2
 | TSW-103-07-F-S | 0.025" SQ Post Header, Through-hole, Vertical, -55 to 125 degC, 2.54 mm Pitch, 3-Pin, Male, RoHS | X203 | CMP-1024-00331-1 | Released | Up to date | 1 | Samtec | TSW-103-07-F-S | Unknown | Newark | 71Y9502 | 0.326 | 0.326
 | 61301011121 | WR-PHD 2.54 mm THT Pin Header, 10p | X204 |  | Not managed |  | 1
