ETML-ES-SLO/PRJ_1730_PortierWireless/hard/Portier_17300C_JMO/Project Outputs for Portier_1730/Reports/Copy of Bill of Materials/1730_Circuit_Door.xlsx

Line # | Designator | Name | Description | Revision State | Revision Status | Quantity | MAJ | Fitted | Manufacturer 1 | Manufacturer Part Number 1 | Manufacturer Lifecycle 1 | Supplier 1 | Supplier Part Number 1 | Supplier Unit Price 1 | Supplier Subtotal 1 | Supplier 2 | Supplier Part Number 2 | Supplier Unit Price 2 | Supplier Subtotal 2
1 | BT100 | 2 x 1.5V AAA | Cylindrical Battery Contacts, Clips, Holders & Springs 2AAA PC MNT HOLDER | Not managed |  | 1 | OK, faire trou pour spacer Wurth |  | Keystone Electronics | 2468 | Volume Production | Digi-Key | 36-2468-ND | 1.35 | 1.35
2 | C100, C101, C201, C202, C203 | 100nF | WCAP-CSGP Multilayer Ceramic Chip Capacitor, General Purpose, size 0805, X7R, 100nF, 50VDC | Not managed |  | 5 | OK |  | Wurth Electronics | 885012207098 | Volume Production | Digi-Key | 732-8080-1-ND | 0.1 | 0.5
 | C102 | 1µF | WCAP-CSGP Multilayer Ceramic Chip Capacitor, General Purpose, size 0805, X7R, 1µF, 25VDC | Not managed |  | 1 | OK |  | Wurth Electronics | 885012207078 | Volume Production | Digi-Key | 732-7672-1-ND | 0.1 | 0.1
5 | C200 | 10µF | WCAP-CSGP Multilayer Ceramic Chip Capacitor, General Purpose, size 0805, X5R, 10µF, 16VDC | Not managed |  | 1 | OK |  | Wurth Electronics | 885012107014 | Volume Production | Digi-Key | 732-7624-1-ND | 0.3 | 0.3
6 | D200, D201, D202 | Bright Green, 2V, 140° | WL-SMCW Mono-color Chip LED Waterclear, size 0805, Bright Green, 2V, 140° | Not managed |  | 3 | OK |  | Kingbright | APTD2012LCGCK | Volume Production | Digi-Key | 754-2043-1-ND | 0.41 | 1.23
7 | Q100 | FDN306P | P-Channel Specified Power Trench (R) MOSFET, 1.8 V, -55 to 150 degC, 3-Pin SOT, RoHS, Tape and Reel | Released | Up to date | 1 | Pas de stock
8 | Q101, Q102, Q200, Q201, Q202, Q203 | IRLML2402TRPBF | HEXFET(R) Power MOSFET, N-Channel, 20 V, 1.2 A, 3-Pin SOT-23, RoHS, Tape and Reel | Released | Up to date | 6 | OK, possible chez RS |  | International Rectifier | IRLML2402TRPBF | Unknown | Mouser | 942-IRLML2402TRPBF | 0.43 | 2.58
9 | R100, R101, R102, R203, R204, R208, R209 | RC0805FR-071KL | Chip Resistor, 1 KOhm, +/- 1%, 125 mW, -55 to 155 degC, 0805 (2012 Metric), RoHS, Tape and Reel | Released | Up to date | 7 | OK |  | Yageo | RC0805FR-071KL | Unknown | Digi-Key | 311-1.00KCRCT-ND | 0.033 | 0.33
10 | R103 | 1K1 5% 0805(2012) | 1K1 0.125W 5% 0805 (2012 Metric) SMD | Released | Up to date | 1 | E24, à fournir à Prod |  | Panasonic | ERJ-6GEYJ112V | Volume Production | Digi-Key | P1.1KACT-ND | 0.1 | 0.1
11 | R104 | 2K2 5% 0805(2012) | 2K2 0.125W 5% 0805 (2012 Metric) SMD | Released | Out of date | 1 | Changer ce composant |  | Yageo | RC0805JR-072K2L | Unknown | Digi-Key | 311-2.2KARCT-ND | 0.1 | 0.1
12 | R200, R201, R202 | 750R 1% 0805(2012) | 750R 0.125W 1% 0805 (2012 Metric) SMD | Released | Out of date | 3 | Changer ce composant |  | Yageo | RC0805FR-07750RL | Unknown | Digi-Key | 311-750CRCT-ND | 0.1 | 0.3
13 | R205, R206, R207 | RC0805FR-0710KL | Chip Resistor, 10 KOhm, +/- 1%, 0.125 W, -55 to 155 degC, 0805 (2012 Metric), RoHS, Tape and Reel | Released | Up to date | 3 | OK |  | Yageo | RC0805FR-0710KL | Unknown | Digi-Key | 311-10.0KCRCT-ND | 0.1 | 0.3
14 | R210, R211 | RC0805FR-0747KL | Chip Resistor, 47 KOhm, +/- 1%, 0.125 W, -55 to 155 degC, 0805 (2012 Metric), RoHS, Tape and Reel | Released | Up to date | 2 | OK |  | Yageo | RC0805FR-0747KL | Unknown | Digi-Key | 311-47.0KCRCT-ND | 0.1 | 0.2
15 | SW100 | Poussoir | Switch 12.7x12.7x17.5 | Not managed |  | 1 | Changer comp
17 | SW203 | 430152050836 | WS-TASV 6x6mm Tact Switch, SMD version | Not managed |  | 1 | Chercher ManPartSea
18 | U100 | LT1790BCS6 | IC VREF SERIES 2.048V SOT23-6 | Not managed |  | 1 | Chercher ManPartSea
20 | U200 | PIC32MX130F064B-I/SO | 32-bit Microcontroller with Audio and Graphics Interface, USB and Advanced Analog, 40 MHz, 21 I/O, PMP, -40 to 85 degC, 28-pin SOIC (SO28), Tube | Released | Up to date | 1 | Add sol |  | Microchip | PIC32MX130F064B-I/SO | Unknown | Mouser | 579-32MX130F064BISO | 3.47 | 3.47
21 | U201 | BuzzerPiezo | Buzzer 12mm piezo | Not managed |  | 1 | Add sol
23 | X200 | ModulesRxTx868MHz_1623 | 2x Header 2x10 2mm / compatible xBee | Not managed |  | 1 | Add Sol/Chge
24 | X201, X202 | 2.54 mm_THT_Vertical_7 pin | Pin Header WR-PHD, pitch 2.54 mm, THT, Vertical, single row, 7 pin | Not managed |  | 2 | Add Sol/Chge
25 | X203 | TSW-103-07-F-S | 0.025" SQ Post Header, Through-hole, Vertical, -55 to 125 degC, 2.54 mm Pitch, 3-Pin, Male, RoHS | Released | Up to date | 1 | Add Sol/Chge WHR-PHD |  | Samtec | TSW-103-07-F-S | Unknown | Digi-Key | SAM8995-ND | 0.42 | 0.42
26 | X204 | 61301011121 | WR-PHD 2.54 mm THT Pin Header, 10p | Not managed |  | 1 | Add Sol
