ETML-ES-SLO/PRJ_1730_PortierWireless/hard/Portier_17300C_JMO/Project Outputs for Portier_1730/Portier_1730_Verif_stock_ES.xlsx

Line # | Designator | Comment | Description | Quantity | MAJ | Fitted | Manufacturer 1 | Manufacturer Part Number 1 | Manufacturer Lifecycle 1 | Supplier 1 | Supplier Part Number 1 | Supplier Unit Price 1 | Supplier Subtotal 1 | Supplier 2 | Supplier Part Number 2 | Supplier Unit Price 2 | Supplier Subtotal 2
6 | J200, J201 | 62001011821 | WR-PHD Socket Header, THT, Vertical, pitch 2mm, 1 Row, 10P | 24 | OK, Verifier stock ES | Fitted | Wurth Electronics | 62001011821 | Volume Production | Digi-Key | 732-62001011821-ND | 1.13 | 2.26 | Mouser | 710-62001011821 | 1.13 | 2.26
20 | SW100 | Tact-sw 1241.1022 |  | 6 | OK, Verifier stock ES | Fitted | Schurter | 1241.1022 | Volume Production | Mouser | 693-1241.1022 | 3.53 | 3.53 | Farnell | 2082864 | 3.82 | 3.82
20 | SW200, SW201, SW202 | Tact-sw 1241.1022 |  | 18 | OK, Verifier stock ES | Not Fitted | Schurter | 1241.1022 | Volume Production | Mouser | 693-1241.1022 | 3.53 | 3.53 | Farnell | 2082864 | 3.82 | 3.82
21 | SW203 | 430152050836 | WS-TASV 6x6mm Tact Switch, SMD version | 12 | OK, Verifier stock ES | Fitted | Wurth Electronics | 430152050836 | Volume Production | Digi-Key | 732-6994-1-ND | 0.52832 | 0.52832 | Mouser | 710-430152050836 | 0.52832 | 0.52832
23 | U101 | MAX1793 | IC REG LINEAR POS ADJ 1A 16TSSOP | 6 | OK, Verifier stock ES | Not Fitted | Maxim | MAX1793EUE33+ | Volume Production | Digi-Key | MAX1793EUE33+-ND | 0 | 0 | Mouser | 700-MAX1793EUE33 | 0 | 0
30 | XB1 | ModulesRxTx868MHz_NC_3D | 2x Header 2x10 2mm / compatible xBee - sans connexion, avec footprint | 0 | OK, Verifier stock ES | Not Fitted | ETML-ES | ModuleRF_RxTx | Manual Solution | ETML-ES | ModuleRF_RxTx | 0 | 0
13 | Qxxx | IRLML2402TRPBF |  | 60
9 | ME5-8 | Spacer Hexa M/F M3x05
10 | ME9-16 | Vis plastique M3x6
