ETML-ES-SLO/PRJ_1730_PortierWireless/hard/Portier_17300C_JMO/Project Outputs for Portier_1730/Portier_1730_ETML_Simple.xlsx

 | Titre | <Parameter BomTitle not found> |  | Numéro | <Parameter BomNumber not found> |  | ETML
 | Devise | CHF |  | Dessiné | <Parameter BomDrawnBy not found> | <Parameter BomDrawnDate not found>
 | Qté production | 6 |  | Controlé | <Parameter BomCheckedBy not found> | <Parameter BomCheckedDate not found>
Pos. | Designator | Description | #Column Name Error:' PN | Qty | Supplier 1 | Supplier Part Number 1 | #Column Name Error:' Supplier Price 1 | Order Qty | Total | #Column Name Error:' IsStocked
1 | BT100 | Cylindrical Battery Contacts, Clips, Holders & Springs 2AAA PC MNT HOLDER |  | 1 | Digi-Key | 36-2468-ND |  | 6 | 0.0000
2 | C100, C101, C102, C201, C202, C203 | WCAP-CSGP Multilayer Ceramic Chip Capacitor, General Purpose, size 0805, X7R, 100nF, 50VDC |  | 6 | Digi-Key | 732-8080-1-ND |  | 36 | 0.0000
3 | C200 | WCAP-CSGP Multilayer Ceramic Chip Capacitor, General Purpose, size 0805, X5R, 10µF, 16VDC |  | 1 | Digi-Key | 732-7624-1-ND |  | 6 | 0.0000
4 | D200, D201, D202 | WL-SMCW Mono-color Chip LED Waterclear, size 0805, Bright Green, 2V, 140° |  | 3 | Digi-Key | 754-2043-1-ND |  | 18 | 0.0000
5 | J200, J201 | WR-PHD Socket Header, THT, Vertical, pitch 2mm, 1 Row, 10P |  | 2 | Digi-Key | 732-62001011821-ND |  | 12 | 0.0000
6 | MP1 | WA-SMSI SMT Steel Spacer with internal Thread, OD 6mm, M3 x 3mm |  | 1 | Digi-Key | 732-5270-1-ND |  | 6 | 0.0000
7 | Q100 | MOSFET P-CH 20V 1.3A SSOT3 |  | 1 | Digi-Key | FDN336PCT-ND |  | 6 | 0.0000
8 | Q101, Q102, Q200, Q201, Q202, Q203 | HEXFET(R) Power MOSFET, N-Channel, 20 V, 1.2 A, 3-Pin SOT-23, RoHS, Tape and Reel |  | 6 | Digi-Key | IRLML2402PBFCT-ND |  | 36 | 0.0000
9 | R100, R101, R102, R209 |  |  | 4 | Digi-Key | YAG3688CT-ND |  | 24 | 0.0000
10 | R103, R104, R105 |  |  | 3 | Digi-Key | 311-22.0KCRCT-ND |  | 18 | 0.0000
11 | R200, R201, R202 |  |  | 3 | Digi-Key | 541-750KCCT-ND |  | 18 | 0.0000
12 | R203, R204, R211 |  |  | 3 | Rs | 6790982 |  | 18 | 0.0000
13 | R205, R206, R207, R210 | Chip Resistor, 10 KOhm, +/- 1%, 0.125 W, -55 to 155 degC, 0805 (2012 Metric), RoHS, Tape and Reel |  | 4 | Digi-Key | 311-10.0KCRDKR-ND |  | 24 | 0.0000
14 | R208 | Chip Resistor, 0 Ohm, +/- 5%, 125 mW, -55 to 155 degC, 0805 (2012 Metric), RoHS, Tape and Reel |  | 1 | Digi-Key | 311-0.0GRCT-ND |  | 6 | 0.0000
15 | SW100 |  |  | 1 | Mouser | 693-1241.1022 |  | 6 | 0.0000
16 | SW203 | WS-TASV SMT Tact Switch, L6 x W6 x H4.3mm, 160g, SPST-NO, 12V, 50mA |  | 1 | Digi-Key | 732-7004-1-ND |  | 6 | 0.0000
17 | U100 | Precision Micropower Low Dropout Voltage Reference, 5-pin SOT-23, Pb-Free |  | 1 | Digi-Key | LM4125IM5-2.0/NOPBCT-ND |  | 6 | 0.0000
18 | U200 | 32-bit Microcontroller with Audio and Graphics Interface, USB and Advanced Analog, 40 MHz, 21 I/O, PMP, -40 to 85 degC, 28-pin SOIC (SO28), Tube |  | 1 | Mouser | 579-32MX130F064BISO |  | 6 | 0.0000
19 | U201 | Buzzer 12mm piezo |  | 1 | Digi-Key | 445-2525-1-ND |  | 6 | 0.0000
20 | X201, X202 | WR-PHD Pin Header, THT, Vertical, pitch 2.54mm, 1 Row, 7P |  | 2 | Digi-Key | 732-5320-ND |  | 12 | 0.0000
21 | X203 | WR-PHD Pin Header, THT, Vertical, pitch 2.54mm, 1 Row, 3P |  | 1 | Digi-Key | 732-5316-ND |  | 6 | 0.0000
22 | X204 | WR-PHD Pin Header, THT, Vertical, pitch 2.54mm, 1 Row, 10P |  | 1 | Digi-Key | 732-2670-ND |  | 6 | 0.0000
 |  |  |  |  |  |  | Totaux | 288 | 0.00
