ETML-ES-SLO/PRJ_1730_PortierWireless/hard/Portier_17300C_JMO/LIBRAIRIES/MECH/Xbee/User Library-XBee.STEP

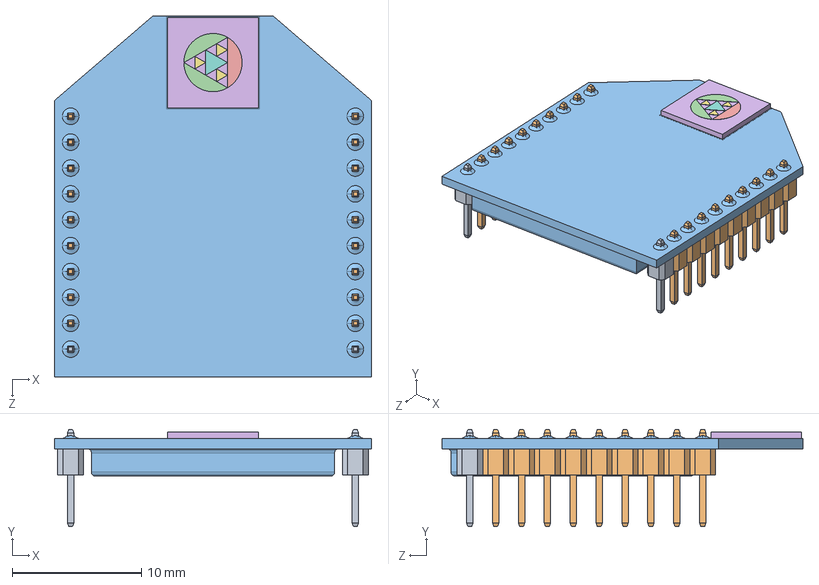
[picture p115: CAD file, 2024-05-14]
hard/Portier_17300C_JMO/LIBRAIRIES/MECH/Xbee/User Library-XBee.STEP
24.5 x 7.50 x 27.9 mm
User Library-XBee-Chip_XBee-10pin-male_1 x 2
User Library-XBee-Chip_XBee-Chip_1
User Library-XBee-Chip_XBee-Chip-antenna_1
