ETML-ES-SLO/PRJ_1730_PortierWireless/mec/Portier_17300A_Page/PlexiOUT.SLDPRT

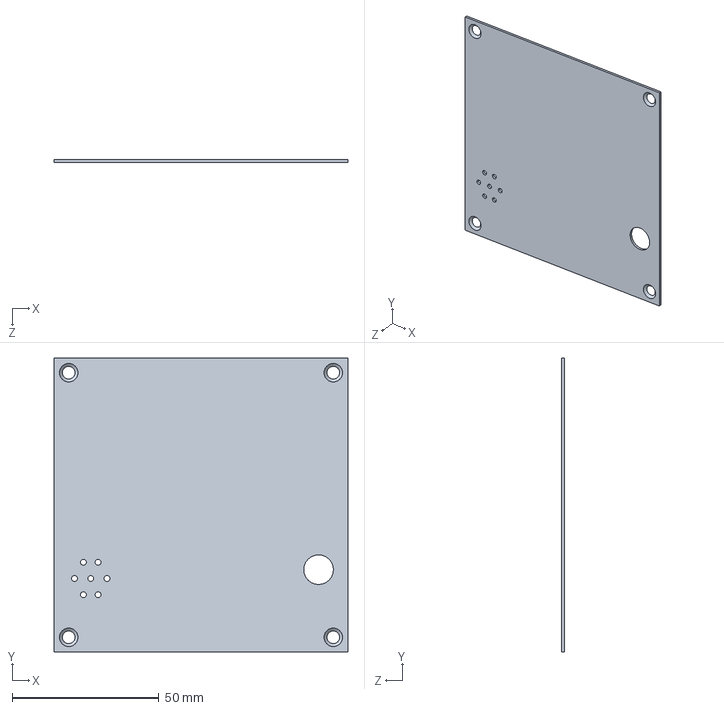
[picture p116: CAD file, 2024-05-14]
mec/Portier_17300A_Page/PlexiOUT.SLDPRT
100.0 x 100.0 x 1.00 mm
