ETML-ES-SLO/PRJ_1730_PortierWireless/mec/Portier_17300B_SCA/Face avant Gravoply OUT.SLDPRT

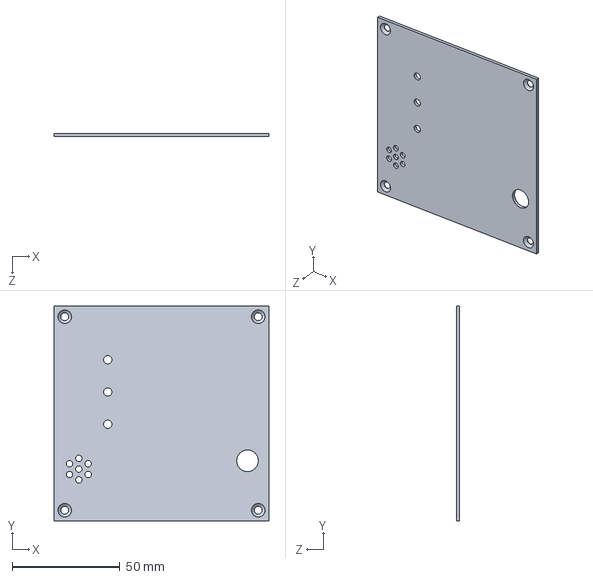
[picture p117: CAD file, 2024-05-14]
mec/Portier_17300B_SCA/Face avant Gravoply OUT.SLDPRT
100.0 x 100.0 x 1.60 mm
