ETML-ES-SLO/PRJ_1730_PortierWireless/mec/Portier_17300B_SCA/Face arriere PMMA.SLDPRT

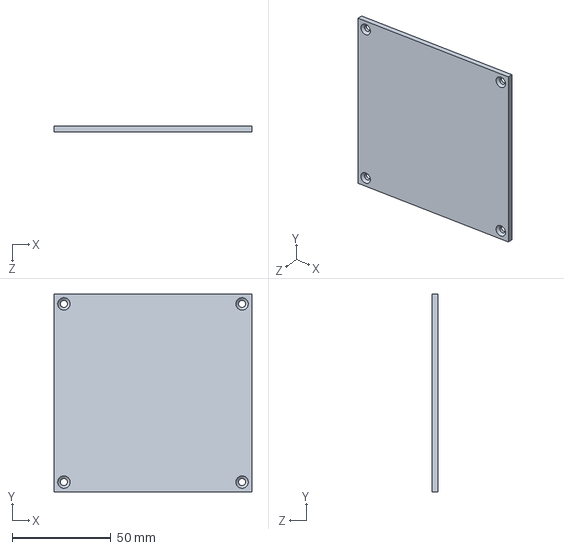
[picture p118: CAD file, 2024-05-14]
mec/Portier_17300B_SCA/Face arriere PMMA.SLDPRT
100.0 x 100.0 x 3.00 mm
