ETML-ES-SLO/PRJ_1730_PortierWireless/hard/Portier_17300C_JMO/LIBRAIRIES/MECH/LFC 050 CTP.STEP

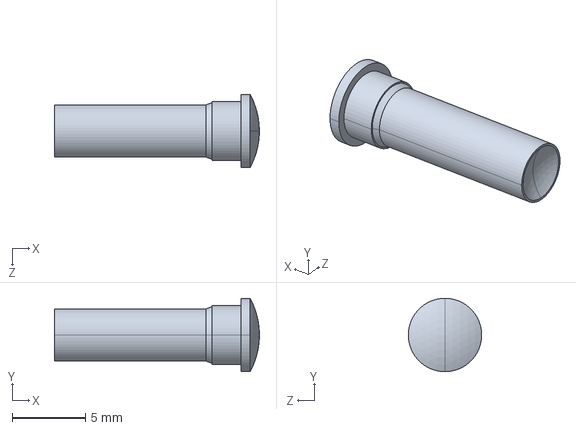
[picture p119: CAD file, 2024-05-14]
hard/Portier_17300C_JMO/LIBRAIRIES/MECH/LFC 050 CTP.STEP
14.0 x 5.00 x 5.00 mm
