ETML-ES-SLO/PRJ_1730_PortierWireless/hard/Portier_17300C_JMO/LIBRAIRIES/MECH/M3x06-torx-ph-iso7045.step

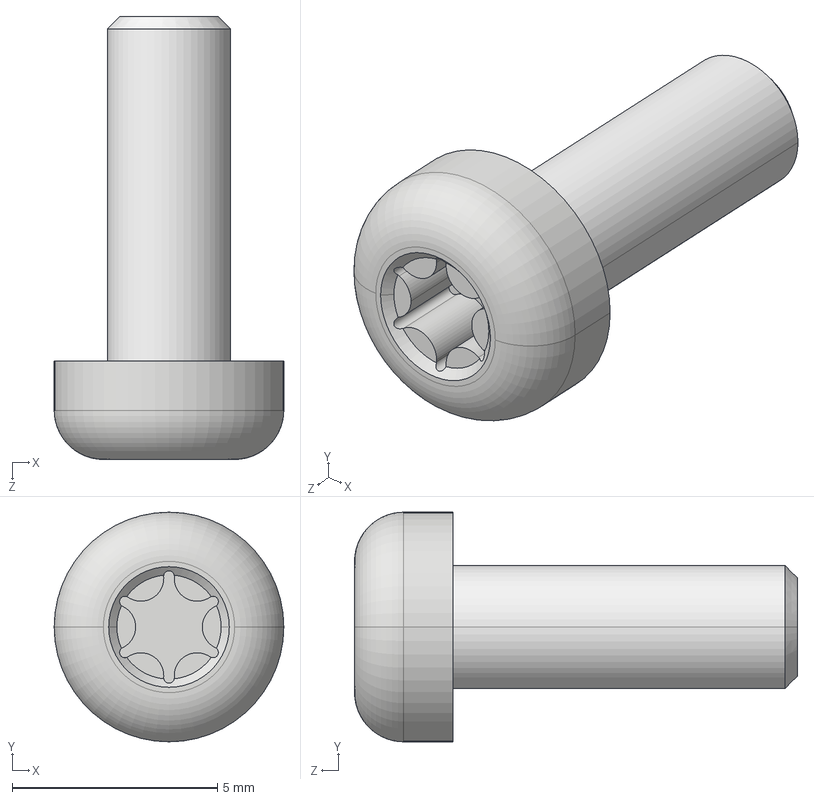
[picture p120: CAD file, 2024-05-14]
hard/Portier_17300C_JMO/LIBRAIRIES/MECH/M3x06-torx-ph-iso7045.step
5.60 x 5.60 x 10.8 mm
