ETML-ES-SLO/PRJ_1730_PortierWireless/hard/Portier_17300C_JMO/LIBRAIRIES/MECH/M3x06_Countersunk.step

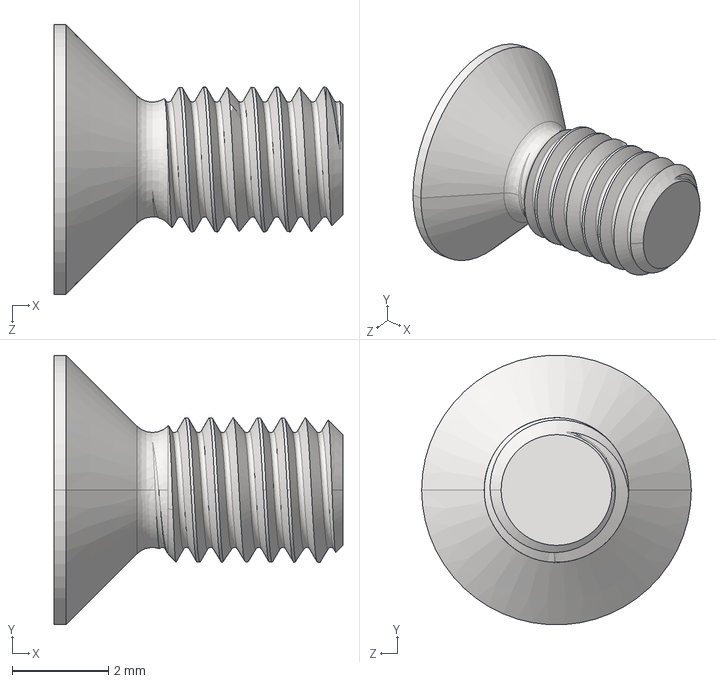
[picture p121: CAD file, 2024-05-14]
hard/Portier_17300C_JMO/LIBRAIRIES/MECH/M3x06_Countersunk.step
6.00 x 5.59 x 5.60 mm
