ETML-ES-SLO/PRJ_1730_PortierWireless/hard/Portier_17300C_JMO/LIBRAIRIES/MECH/M3x08_Countersunk.step

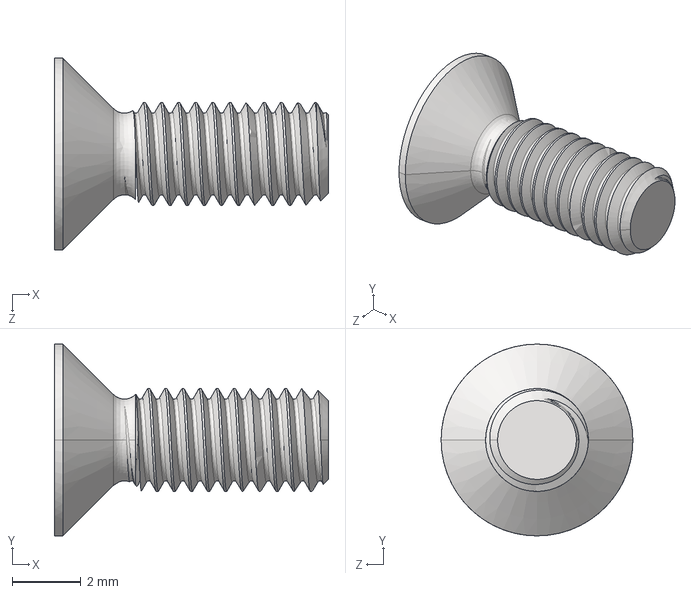
[picture p122: CAD file, 2024-05-14]
hard/Portier_17300C_JMO/LIBRAIRIES/MECH/M3x08_Countersunk.step
8.00 x 5.60 x 5.60 mm
