ETML-ES-SLO/PRJ_1730_PortierWireless/hard/Portier_17300C_JMO/LIBRAIRIES/MECH/M3x06_MF_971060365.stp

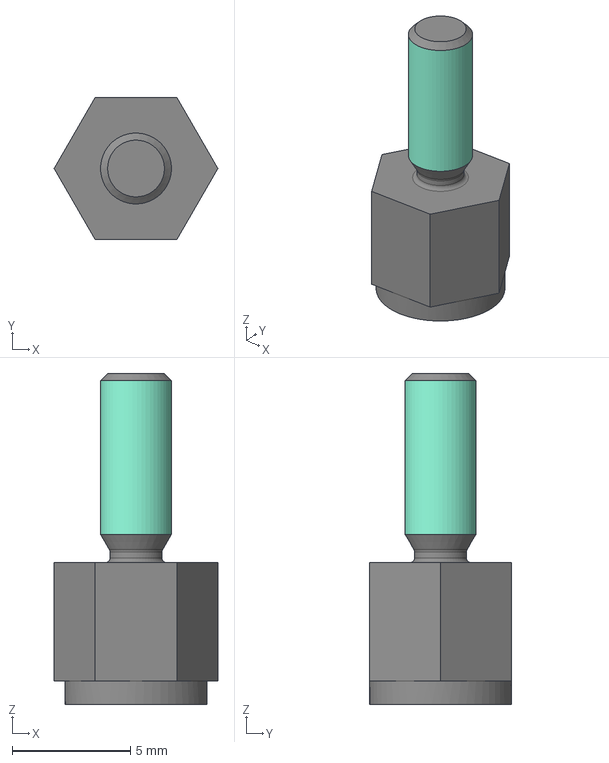
[picture p123: CAD file, 2024-05-14]
hard/Portier_17300C_JMO/LIBRAIRIES/MECH/M3x06_MF_971060365.stp
6.93 x 6.00 x 14.0 mm
