ETML-ES-SLO/PRJ_1730_PortierWireless/hard/Portier_17300C_JMO/LIBRAIRIES/MECH/M3x10_Countersunk.step

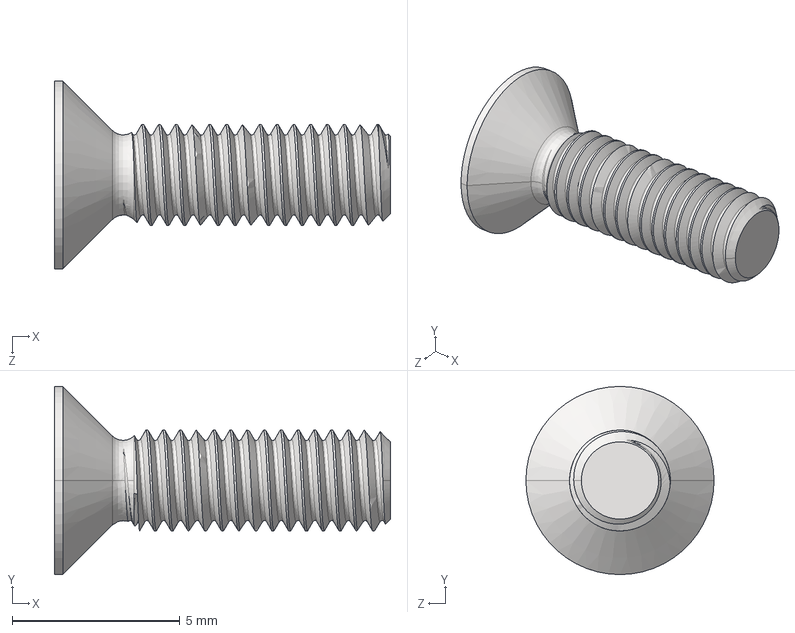
[picture p124: CAD file, 2024-05-14]
hard/Portier_17300C_JMO/LIBRAIRIES/MECH/M3x10_Countersunk.step
10.0 x 5.60 x 5.60 mm
