ETML-ES-SLO/PRJ_1730_PortierWireless/hard/Portier_17300C_JMO/LIBRAIRIES/MECH/M3x05_MF_971050365.stp

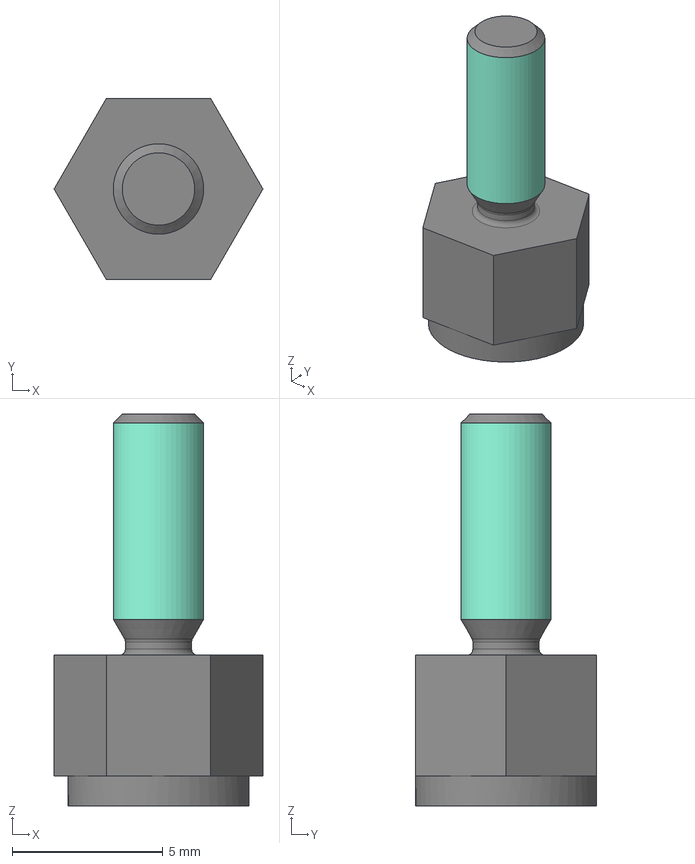
[picture p125: CAD file, 2024-05-14]
hard/Portier_17300C_JMO/LIBRAIRIES/MECH/M3x05_MF_971050365.stp
6.93 x 6.00 x 13.0 mm
