ETML-ES-SLO/PRJ_1730_PortierWireless/(list of files, cad)

Other CAD files:
mec/Portier_17300A_Page/PlexiIN.SLDPRT
mec/Portier_17300B_SCA/Face avant Gravoply IN.SLDPRT
hard/Portier_17300C_JMO/LIBRAIRIES/MECH/Face arriere PMMA - v2.SLDPRT
hard/Portier_17300C_JMO/LIBRAIRIES/MECH/Face avant Gravoply IN.SLDPRT
hard/Portier_17300C_JMO/LIBRAIRIES/MECH/Face avant Gravoply OUT - v2.SLDPRT
hard/Portier_17300C_JMO/LIBRAIRIES/MECH/Face avant Gravoply IN - v2.SLDPRT
hard/Portier_17300C_JMO/LIBRAIRIES/MECH/M3x05_Countersunk.step
hard/Portier_17300C_JMO/LIBRAIRIES/MECH/M3x05_FF_970050365.stp
hard/Portier_17300C_JMO/LIBRAIRIES/MECH/M3x14_FF_970140365.stp
