ETML-ES-SLO/PRJ_1730_PortierWireless/doc/Rapports/JournalDeTravail.xlsx

Sheet: JournalDeTravail
 |  | Journal de travail Page
S | Date | Tâches effectuées | Décisions Prises | Problèmes rencontrés
1 | 2017-11-14 | Cahier des charges | Autoalimentation par le PIC32 dès appuis sur
 |  | Schéma bloc | le bouton
2 | 2017-11-21 | Estimation prix + début détail schématique | Ajouter un buzzer sur la partie côté porte
 |  | Schéma bloc | Choix de certains composants
 |  | début rapport pré-étude | Utiliser des LED low current pour pour les piles
3 | 2017-11-28 | Choix des composants et autonomie des | Garder 2 piles | Autonomie inférieur à 2ans dans le pire
 |  | piles. |  | des cas.
 |  | planning
4 | 2017-12-05 | Choix du PIC, support à pile & planning | PIC
 |  | Rapport pré-étude
 |  | Présentations ppt
5 | 2017-12-12 | Présentations | MAJ du système d'autoalimentation
 |  | Schématique + download des librairies
 |  | Chez Wurth-electronique
6 | 2017-12-19 | Création de composants | Ajout d'un LT1790 pour la mesure des piles
 |  | MIse en place bibliothèque
7 | 2018-01-09 | Création de composants | Idée de faire un seul PCB qui peut être alimenté
 |  | Shématique | des 2 façons.
8 | 2018-01-16 | Schématique
9 | 2018-01-23 | Schématique finie | Pins N/A du PIC mise sur un TP(Test Point)
 |  | Génération routage
 |  | Rapport design
10 | 2018-01-30 | Finission présentation + présentation |  | Modification connecteur RJ12 en barettes
 |  | Contrôle des stock + préparation cmd
 |  | Modification schéma + Début routage
11 | 2018-02-06 | Routage + croquis boitier | Prise des switchs chez Schhurter | Dans l'attente de la réponse de Schurter
 |  | Choix des pipes pour les leds | Sinon prendre des soudable par câble | je commence le soft
 |  | échantillons de poussoirs demandés
 |  | Début du software
12 | 2018-02-13 | Finission PCB + commande ( avec matériel)
 |  | Commande effectuée
13 | 2018-02-27 | Réception composant + PCB --> montage |  | Il manque plus que les LED à monter
 |  |  |  | Quand la cmd Mouser arrivera
14 | 2018-03-06 | Finission du montage + test PCB
 |  | Tests des switchs, LED et Buzzer(soft)
 |  | Le circuit est opérationnel
15 | 2018-03-13 | Préparation de la face avant
 |  | Tests UART sans le module RF
16 | 2018-03-20 | Divers test de code
17 | 2018-03-27 | Test fonctionnement module |  | Peu de documentation
 |  |  |  | Plus de tests nécessaires
18 | 2018-04-17 | Essais divers pour faire fonctionner le |  | ZB-SB monté en miroir, on peut monter le
 |  | module 868MHz |  | module mais dans l'autre sens
19 | 2018-04-24 | Fabrication de la plaque frontale ETML | Faire les programme en communication UART
 |  | Code circuit OUT | Directement et ajouter les module 868MHz par après
20 | 2018-05-01 | Fin du code OUT |  | Reste l'ADC
 |  | Début du code IN |  | Reste l'UART
21 | 2018-05-08 | Fin du code IN |  | L'AD lit toujours un 0
 |  | Test de l'ADC |  | Fonctionnement du module RF
22 | 2018-05-15 | Divers test de code pour module RF
 |  |  |  | Ne fonctionne pas !
23 | 2018-08-22 | Analyse du code du module | Adapatation du Tx/Rx sur les montages | Tx et Rx inversé
24 | 2018-05-29 | Analyse du code du module |  | Module ne fonctionne pas
 |  | Test ADC |  | ADC OK
25 | 2018-06-05 | Refaire le code du module à partir d'un
 |  | exemple
26 | 2018-06-12 | MAJ de la documentation et des fautes
 |  | Documentation
27 | 2018-06-19 | Dernier tests pour faire fonctionner les |  | Problème hardware pour alimentation
 |  | modules |  | des piles, démarrage bloqué à 2V97

Sheet: Planning
Tâches | 2017-12-12 |  |  | 2017-12-19 |  | 2018-01-09 |  | 2018-01-16 |  | 2018-01-23 |  | 2018-01-30 |  |  | 2018-02-06 |  | Tâches | 2018-04-03 |  | 2018-04-10 |  | 2018-04-17 |  | 2018-04-24 |  | 2018-05-01 |  | 2018-05-08
 | Matin |  | Soir | Matin | Soir | Matin | Soir | Matin | Soir | Matin | Soir | Matin |  | Soir | Matin | Soir |  | Matin | Soir | Matin | Soir | Matin | Soir | Matin | Soir | Matin | Soir | Matin
Schématique |  |  |  |  |  |  |  |  |  |  |  |  |  |  |  |  | Schématique
Routage |  |  |  |  |  |  |  |  |  |  |  |  |  |  |  |  | Routage
Software |  |  |  |  |  |  |  |  |  |  |  |  |  |  |  |  | Software
Montage |  |  |  |  |  |  |  |  |  |  |  |  |  |  |  |  | Montage
Test |  |  |  |  |  |  |  |  |  |  |  |  |  |  |  |  | Test
Documentation | P | P | P |  |  |  |  |  |  |  |  | P | P |  |  |  | Documentation
 |  |  |  |  |  |  |  |  |  |  |  | Temps prévu |  |  |  |  |  |  |  |  |  |  |  |  |  |  |  | Temps prévu
 |  |  |  |  |  |  |  |  |  |  |  | Temps effectué |  |  |  |  |  |  |  |  |  |  |  |  |  |  |  | Temps effectué
Tâches | 2018-02-13 |  |  | 2018-02-20 |  | 2018-02-27 |  | 2018-03-06 |  | 2018-03-13 |  | 2018-03-20 |  |  | 2018-03-27 |  | Tâches | 2018-05-22 |  | 2018-05-29 |  | 2018-06-05 |  | 2018-06-12 |  | 2018-06-19 |  | 2018-06-26
 | Matin |  | Soir | Matin | Soir | Matin | Soir | Matin | Soir | Matin | Soir | Matin |  | Soir | Matin | Soir |  | Matin | Soir | Matin | Soir | Matin | Soir | Matin | Soir | Matin | Soir | Matin
Schématique |  |  |  |  |  |  |  |  |  |  |  |  |  |  |  |  | Schématique
Routage |  |  |  |  |  |  |  |  |  |  |  |  |  |  |  |  | Routage
Software |  |  |  |  |  |  |  |  |  |  |  |  |  |  |  |  | Software
Montage |  |  |  |  |  |  |  |  |  |  |  |  |  |  |  |  | Montage
Test |  |  |  |  |  |  |  |  |  |  |  |  |  |  |  |  | Test
Documentation |  |  |  |  |  |  |  |  |  |  |  |  |  |  |  |  | Documentation |  |  |  |  |  |  |  |  |  |  | P | P
 |  |  |  |  |  |  |  |  |  |  |  | Temps prévu |  |  |  |  |  |  |  |  |  |  |  |  |  |  |  | Temps prévu
 |  |  |  |  |  |  |  |  |  |  |  | Temps effectué |  |  |  |  |  |  |  |  |  |  |  |  |  |  |  | Temps effectué
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
