ETML-ES-SLO/PRJ_1730_PortierWireless/doc/PreEtude/JournalDeTravail.pdf

## Planning portier

| 12.12.2017 | 19.12.2017 | 09.01.2018 | 16.01.2018 | 23.01.2018 | 30.01.2018 | 06.02.2018
Matin | Soir | Matin | Soir | Matin | Soir | Matin | Soir | Matin | Soir | Matin | Soir | Matin | Soir Tâches

Schématique

Routage

Software

Montage

Test

Documentation | P P | P | | | | | | | | | P P
Tâches | 13.02.2018 | 20.02.2018 | 27.02.2018 | 06.03.2018 | 13.03.2018 | 20.03.2018 | 27.03.2018
Matin | Soir | Matin | Soir | Matin | Soir | Matin | Soir | Matin | Soir | Matin | Soir | Matin | Soir

Schématique

Routage

Software

Montage

Test

Documentation

| Temps prévu
| Temps effectué

Temps prévu
Temps effectué

## Planning portier

08.05.2018 | 15.05.2018
Tâches | 03.04.2018 | 10.04.2018 | 17.04.2018 | 24.04.2018 | 01.05.2018
Matin | Soir | Matin | Soir | Matin | Soir | Matin | Soir | Matin | Soir | Matin | Soir | Matin | Soir

Schématique

Routage

Software

Montage

Test

Documentation

| Temps prévu
| Temps effectué
26.06.2018 | 03.07.2018
Tâches | 22.05.2018 | 29.05.2018 | 05.06.2018 | 12.06.2018 | 19.06.2018
Matin | Soir | Matin | Soir | Matin | Soir | Matin | Soir | Matin | Soir | Matin | Soir | Matin | Soir

Schématique

Routage

Software

Montage

Test

Documentation | | | | | | | | | | | P P | P P

Temps prévu
Temps effectué
