ETML-ES-SLO/PRJ_1730_PortierWireless/doc/Modification/Mod 3.0/1_Fichier_Travail/JournalDeTravailModification.xlsx

Journal de travail modification PortierWireless
Jour de travail | Date | Avancements
1 | 2025-02-24 | • Lecture des documentations du projet. • Essais sans réussite de démarrage des modules (manque câble et piles).
2 | 2025-03-10 | • Compilation du programme fonctionnel. • Mise en place des adaptations IDC4 et alimentation forcée pour programmation.
3 | 2025-03-24 | • Compréhension du code au moyen de Sourcetrail. • Création des fonctions de pairing.
4 | 2025-04-07 | • Compréhension du code au moyen de Sourcetrail. • Implémentation des fonctions de pairing. • Débogage de la communication non fonctionnelle : les trames ne sont pas reçues par le système.
5 | 2025-05-12 | • Changement de la logique d’envoi pour correspondre à la logique présente. • Débogage des communications.
6 | 2025-05-19 | • Réussite du débogage des communications. • Mise en place de la logique de sauvegarde. • Débogage de la logique de sauvegarde.
7 | 2025-05-26 | • Réussite du débogage de la sauvegarde NVM. • Mise en place de la validation des trames par envoi du numéro de série. • Débogage de la validation des trames par envoi du numéro de série. • Ajout de la réinitialisation du pairing. • Débogage de la réinitialisation du pairing.
8 | 2025-06-02 | • Documentation : ◦ Doxygen ◦ Journal de travail ◦ Rapport de modifications • Tentative de débogage et de stabilisation : problèmes encore présents : ◦ La Door perd la sauvegarde du pairing ◦ Stabilité de la procédure de pairing ◦ Priorité du pairing : Bell d’abord, puis Door
