ETML-ES-SLO/PRJ_1730_PortierWireless/doc/PDF(design)/SchematicPrints.pdf

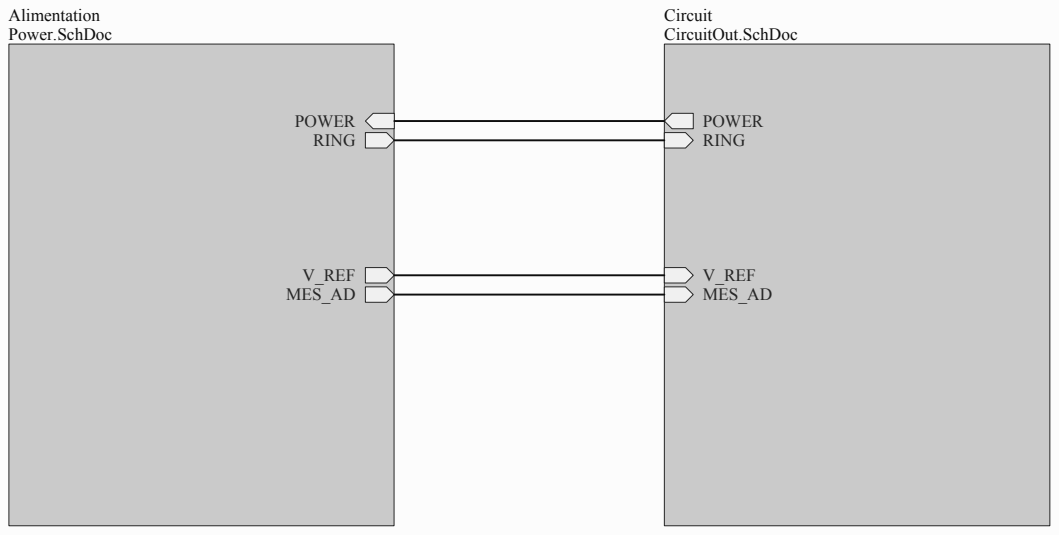
[picture p126: page 1]
Top Schematic; Title; Size:; Number:; Date:; Revision:; Time:; Sheet; RING; POWER; V_REF MES_AD; Alimentation Power.SchDoc; MES_AD; V_REF; Circuit CircuitOut.SchDoc

ETML-ES
Rue de Sébeillon 12
1004 Lausanne

H:\Projet\Projet_xxxx\hard\CircuitOUT\SCHEMA\TopSchematic.SchDoc
File:

# Auto-Alimentation

# Mesure pile

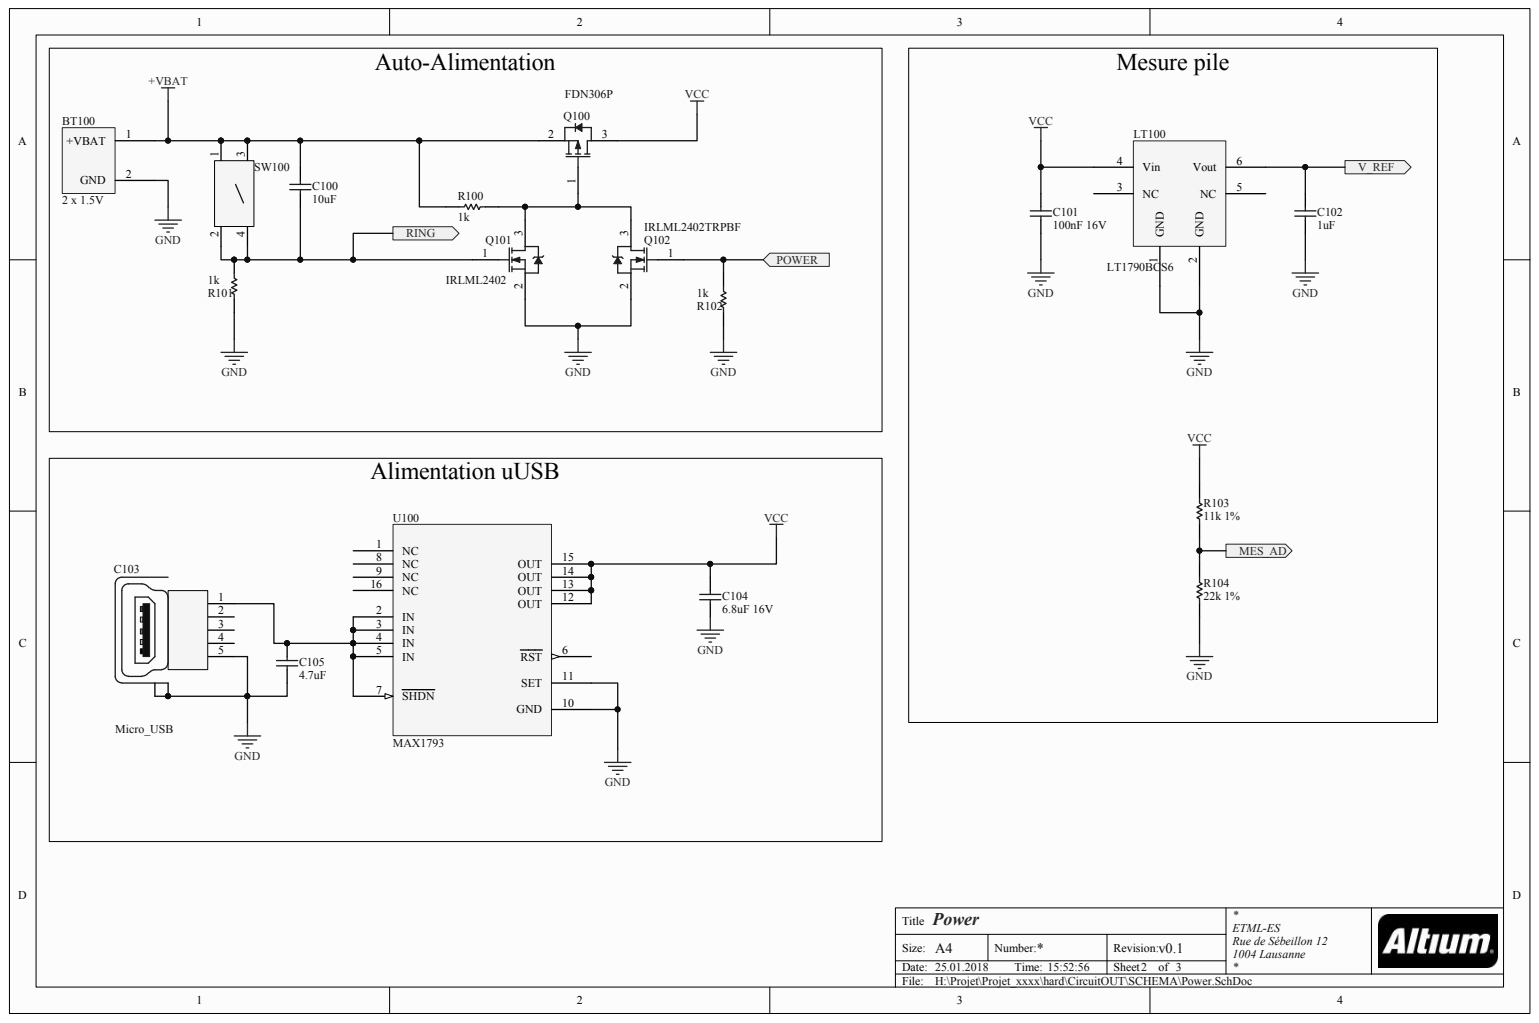
[picture p127: page 2]

H:\Projet\Projet_xxxx\hard\CircuitOUT\SCHEMA\Power.SchDoc

I/O

# PIC32MX130F064B

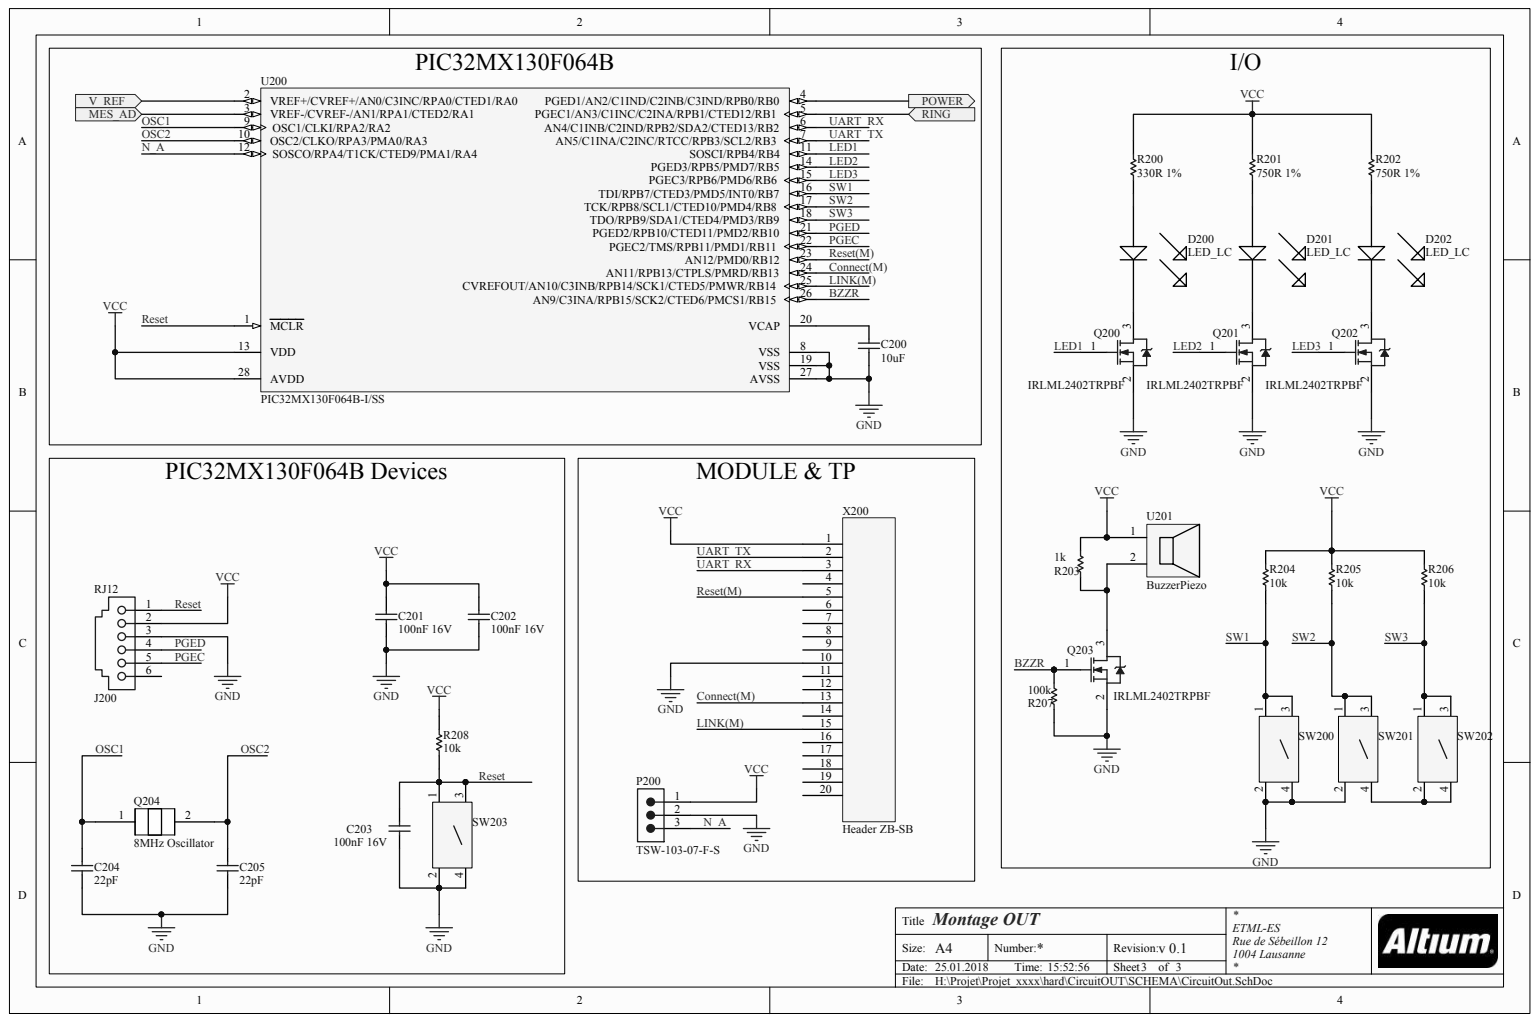
[picture p128: page 3]

H:\Projet\Projet_xxxx\hard\CircuitOUT\SCHEMA\CircuitOut.SchDoc
