ETML-ES-SLO/PRJ_1730_PortierWireless/hard/Portier_17300C_JMO/Project Outputs for Portier_1730/DesignDocs/Portier_1730_Draftsman_Variant_PCBA_Door.PDF

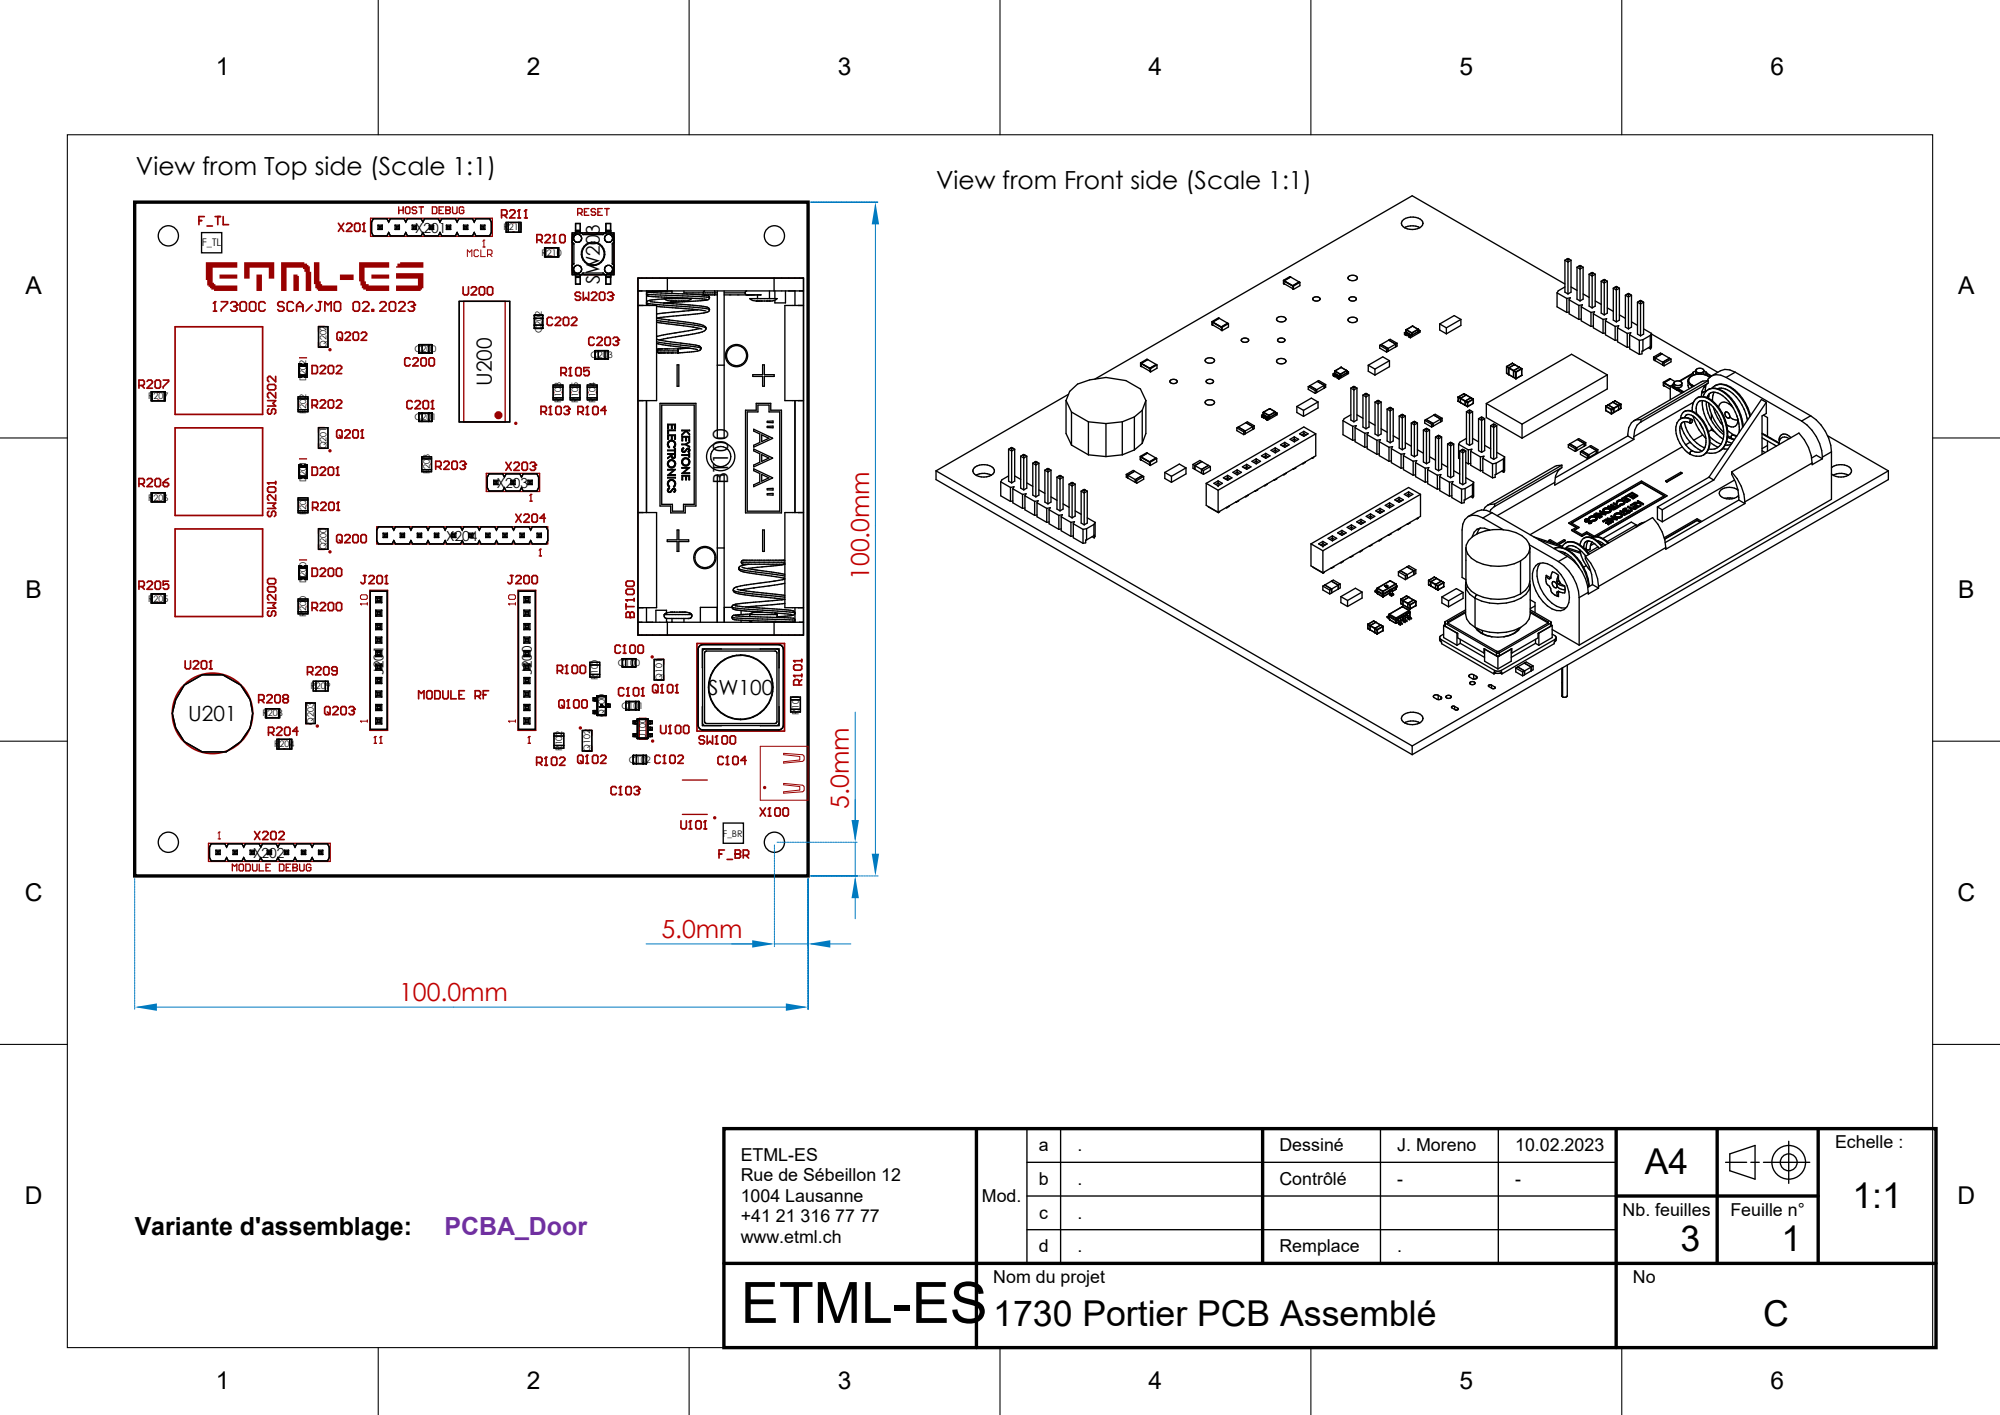
[picture p132: page 1]

View from Top side (Scale 1:1)

View from Front side (Scale 1:1)

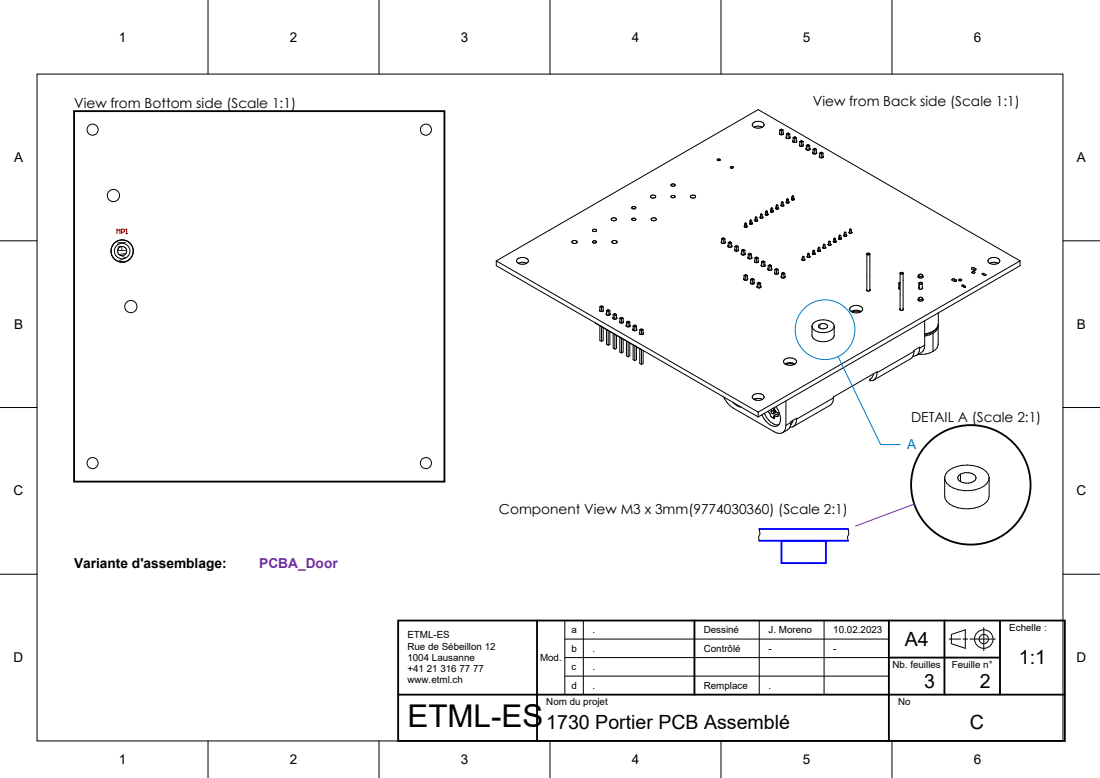
[picture p133: page 2]

View from Bottom side (Scale 1:1)

View from Back side (Scale 1:1)

ETML-ES Rue de Sébeillon 12 1004 Lausanne +41 21 316 77 77 www.etml.ch | Mod. | a | . | Dessiné | J. Moreno | 10.02.2023 | | | Echelle : 1:1

b | . | Contrôlé | - | -
d | . | Remplace | .

ETML-ES | Nom du projet | | | | | | No

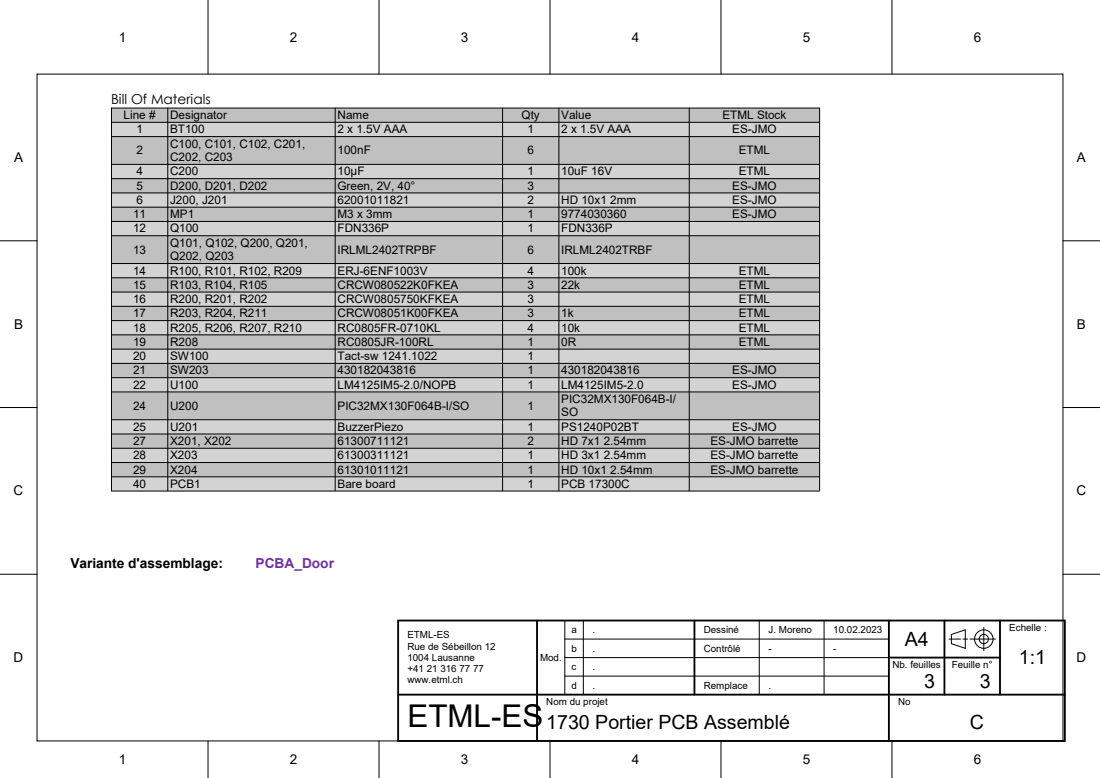
[picture p134: page 3]

Line # | Designator | Name | Qty | Value | ETML Stock
1 | BT100 | 2 x 1.5V AAA | 1 | 2 x 1.5V AAA | ES-JMO
2 | C100, C101, C102, C201, C202, C203 | 100nF | 6 | | ETML

4 | C200 | 10µF | 1 | 10uF 16V | ETML
5 | D200, D201, D202 | Green, 2V, 40° | 3 | | ES-JMO
6 | J200, J201 | 62001011821 | 2 | HD 10x1 2mm | ES-JMO
11 | MP1 | M3 x 3mm | 1 | 9774030360 | ES-JMO
12 | Q100 | FDN336P | 1 | FDN336P
13 | Q101, Q102, Q200, Q201, Q202, Q203 | IRLML2402TRPBF | 6 | IRLML2402TRBF

14 | R100, R101, R102, R209 | ERJ-6ENF1003V | 4 | 100k | ETML
15 | R103, R104, R105 | CRCW080522K0FKEA | 3 | 22k | ETML
16 | R200, R201, R202 | CRCW0805750KFKEA | 3 | | ETML
17 | R203, R204, R211 | CRCW08051K00FKEA | 3 | 1k | ETML
18 | R205, R206, R207, R210 | RC0805FR-0710KL | 4 | 10k | ETML
19 | R208 | RC0805JR-100RL | 1 | 0R | ETML
20 | SW100 | Tact-sw 1241.1022 | 1
21 | SW203 | 430182043816 | 1 | 430182043816 | ES-JMO
22 | U100 | LM4125IM5-2.0/NOPB | 1 | LM4125IM5-2.0 | ES-JMO
24 | U200 | PIC32MX130F064B-I/SO | 1 | PIC32MX130F064B-I/ SO

25 | U201 | BuzzerPiezo | 1 | PS1240P02BT | ES-JMO
27 | X201, X202 | 61300711121 | 2 | HD 7x1 2.54mm | ES-JMO barrette
28 | X203 | 61300311121 | 1 | HD 3x1 2.54mm | ES-JMO barrette
29 | X204 | 61301011121 | 1 | HD 10x1 2.54mm | ES-JMO barrette
40 | PCB1 | Bare board | 1 | PCB 17300C

ETML-ES Rue de Sébeillon 12 1004 Lausanne +41 21 316 77 77 www.etml.ch | Mod. | a | . | Dessiné | J. Moreno | 10.02.2023 | A4 | | Echelle : 1:1

b | . | Contrôlé | - | -
c | . | | | | Nb. feuilles 3 | Feuille n° 3
d | . | Remplace | .

ETML-ES | Nom du projet | | | | | | No
