ETML-ES-SLO/PRJ_1730_PortierWireless/hard/Portier_17300C_JMO/Project Outputs for Portier_1730/DesignDocs/Portier_1730_Schematic_Variant_No Variations.PDF

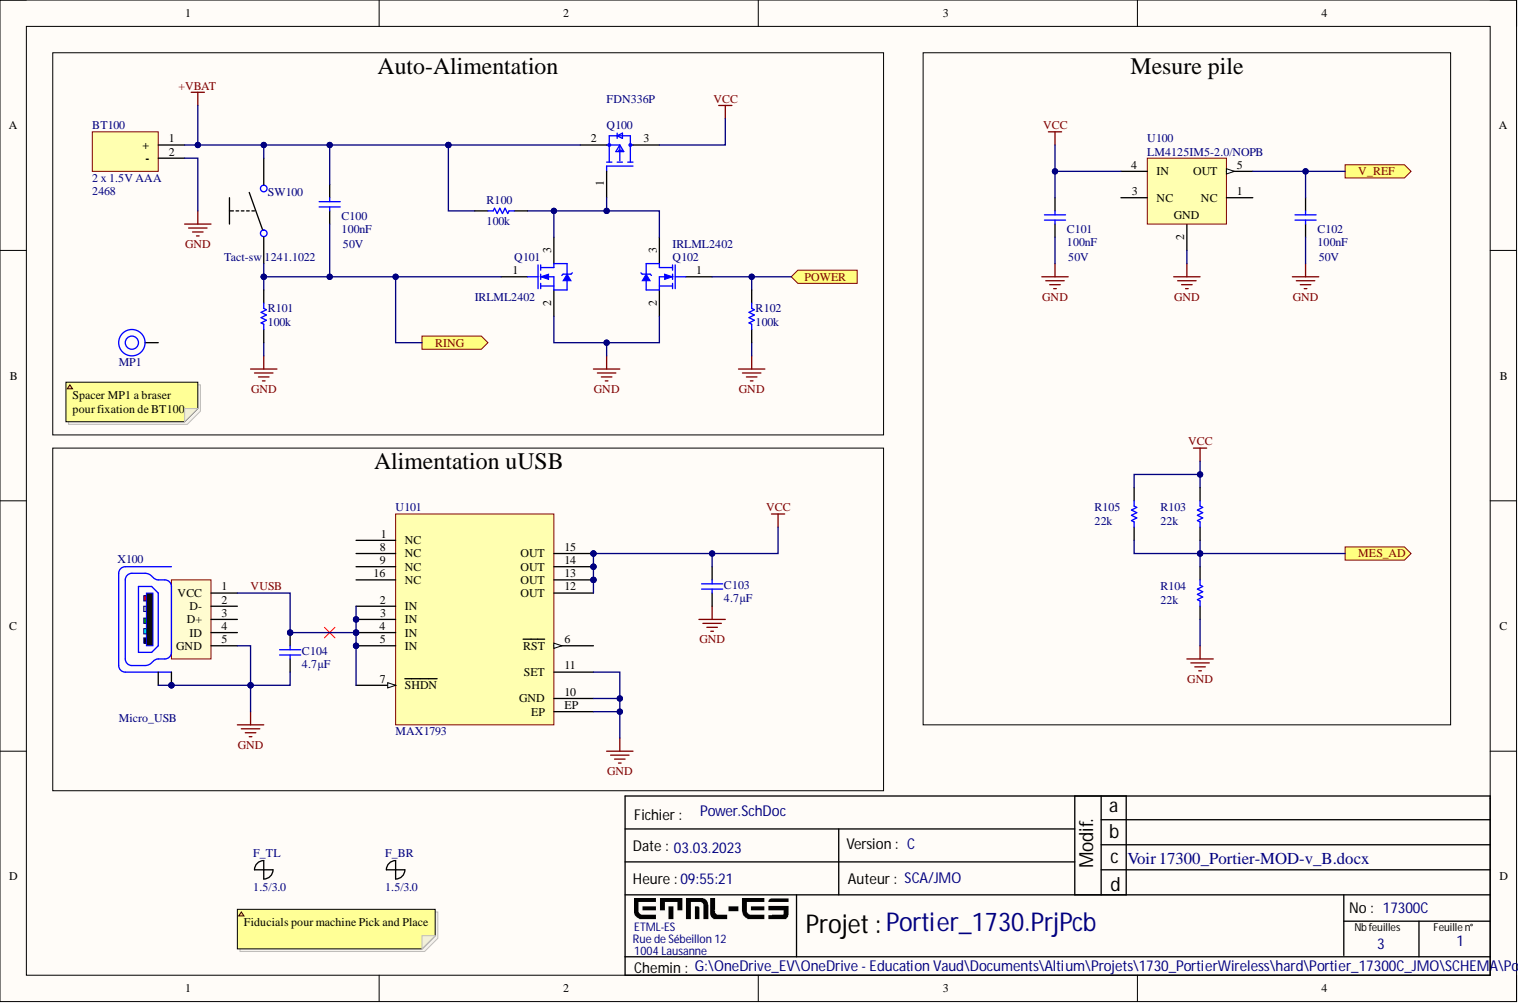
[picture p135: page 1]

Power.SchDoc Fichier : | | a

c | Voir 17300_Portier-MOD-v_B.docx

Date : 03.03.2023 | Version : C

Heure : 09:55:21 | SCA/JMO Auteur :
ETML-ES Rue de Sébeillon 12 1004 Lausanne | Projet : Portier_1730.PrjPcb | No : 17300C

Fiducials pour machine Pick and Place

Nb feuilles | Feuille n°

Chemin : G:\OneDrive_EV\OneDrive - Education Vaud\Documents\Altium\Projets\1730_PortierWireless\hard\Portier_17300C_JMO\SCHEMA\Power.SchDoc

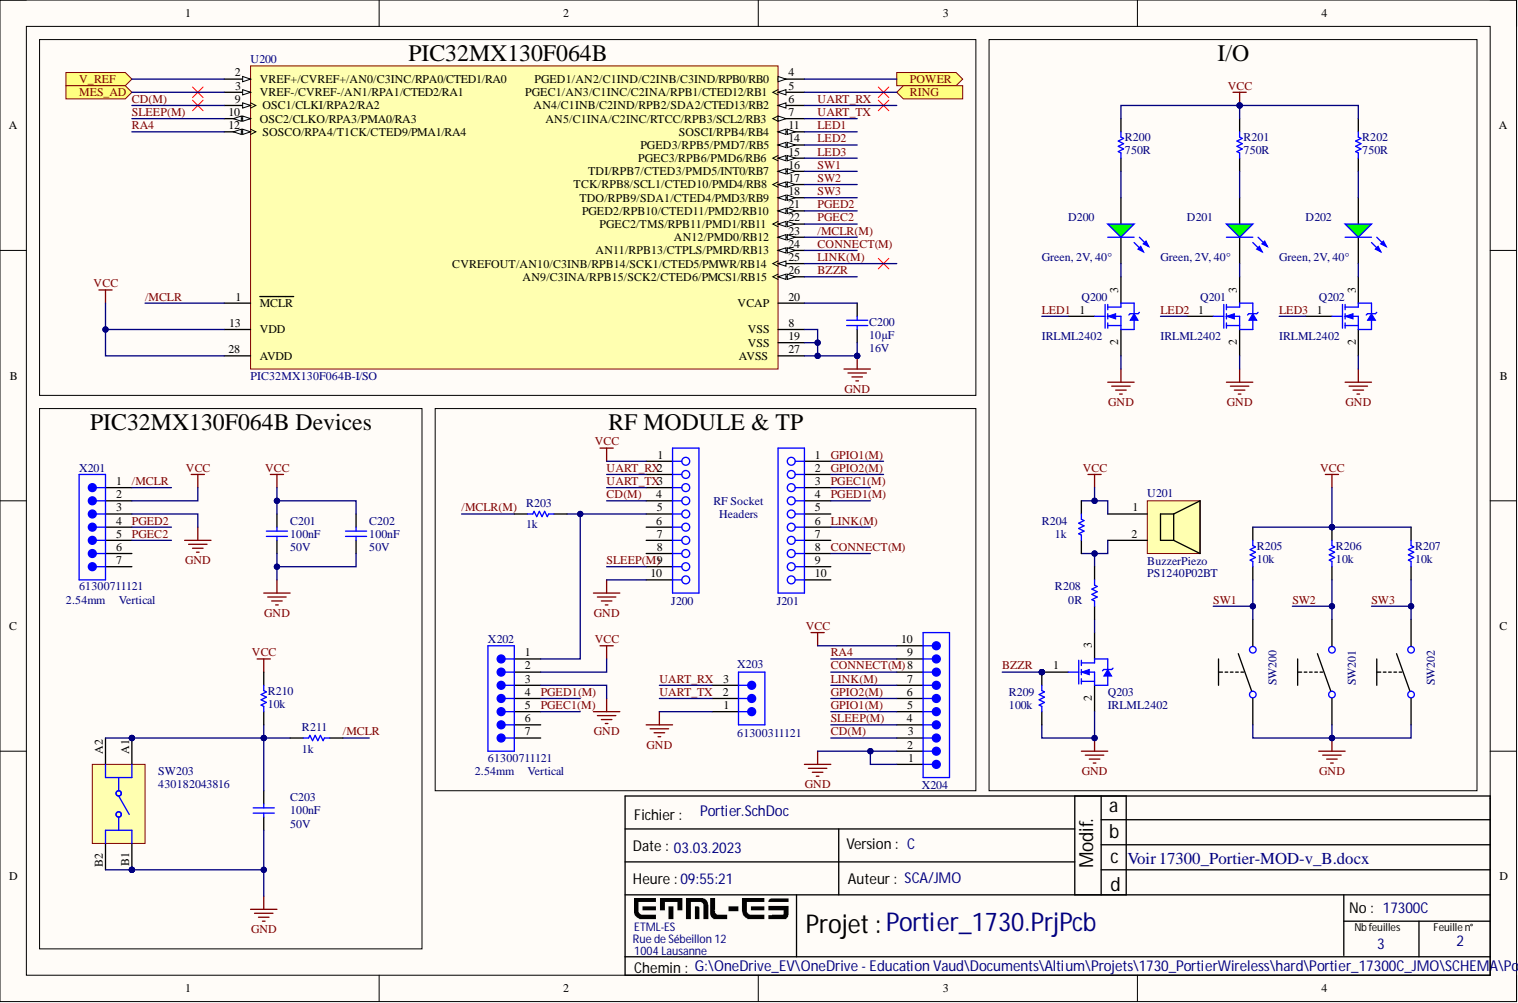
[picture p136: page 2]

Portier.SchDoc Fichier : | | a

c | Voir 17300_Portier-MOD-v_B.docx

Date : 03.03.2023 | Version : C

Heure : 09:55:21 | SCA/JMO Auteur :

Projet : Portier_1730.PrjPcb | No : 17300C

Chemin : G:\OneDrive_EV\OneDrive - Education Vaud\Documents\Altium\Projets\1730_PortierWireless\hard\Portier_17300C_JMO\SCHEMA\Portier.SchDoc

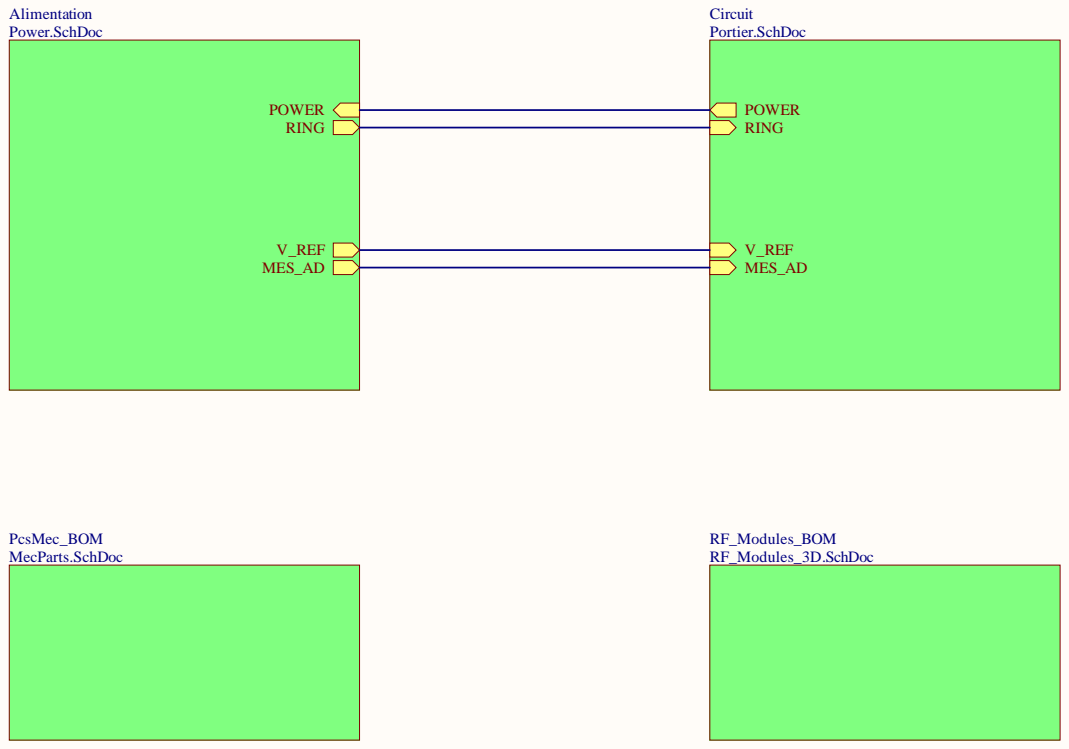
[picture p137: page 3]

TopSchematic.SchDoc Fichier : | | a

c | Voir 17300_Portier-MOD-v_B.docx

Date : 03.03.2023 | Version : C

Heure : 09:55:21 | SCA/JMO Auteur :

Projet : Portier_1730.PrjPcb | No : 17300C

Chemin : G:\OneDrive_EV\OneDrive - Education Vaud\Documents\Altium\Projets\1730_PortierWireless\hard\Portier_17300C_JMO\SCHEMA\TopSchematic.SchDoc

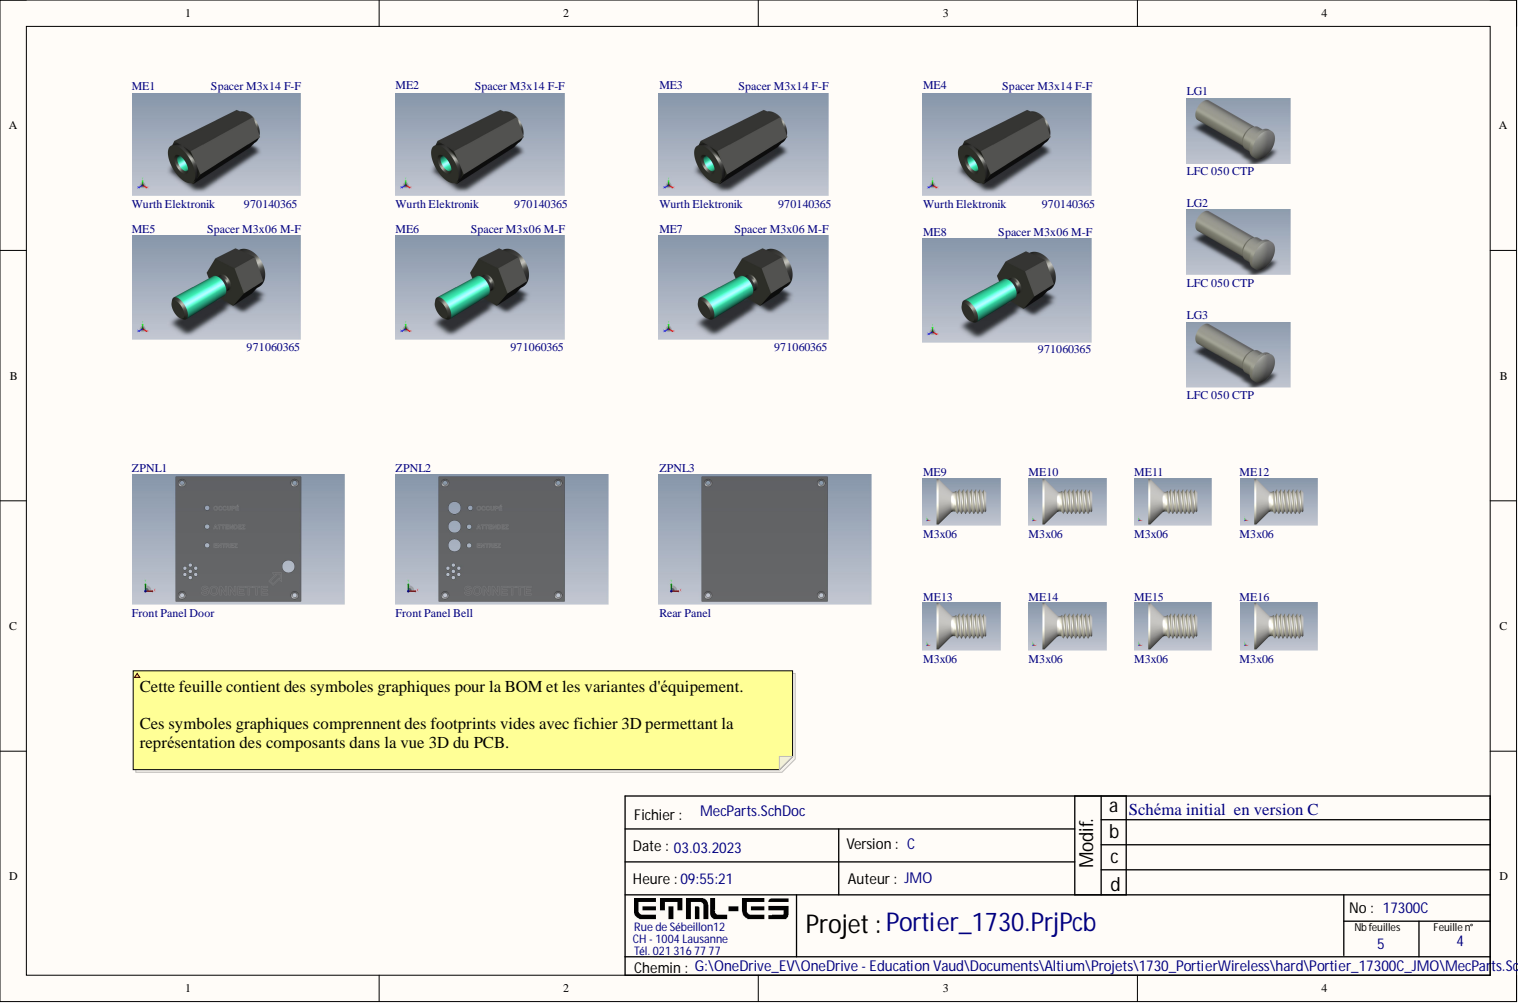
[picture p138: page 4]

Cette feuille contient des symboles graphiques pour la BOM et les variantes d'équipement.

Ces symboles graphiques comprennent des footprints vides avec fichier 3D permettant la
représentation des composants dans la vue 3D du PCB.

MecParts.SchDoc Fichier : | | a | Schéma initial en version C

Date : 03.03.2023 | Version : C

Heure : 09:55:21 | JMO Auteur :
Rue de Sébeillon12 CH - 1004 Lausanne Tél. 021 316 77 77 | Projet : Portier_1730.PrjPcb | No : 17300C

Chemin : G:\OneDrive_EV\OneDrive - Education Vaud\Documents\Altium\Projets\1730_PortierWireless\hard\Portier_17300C_JMO\MecParts.SchDoc

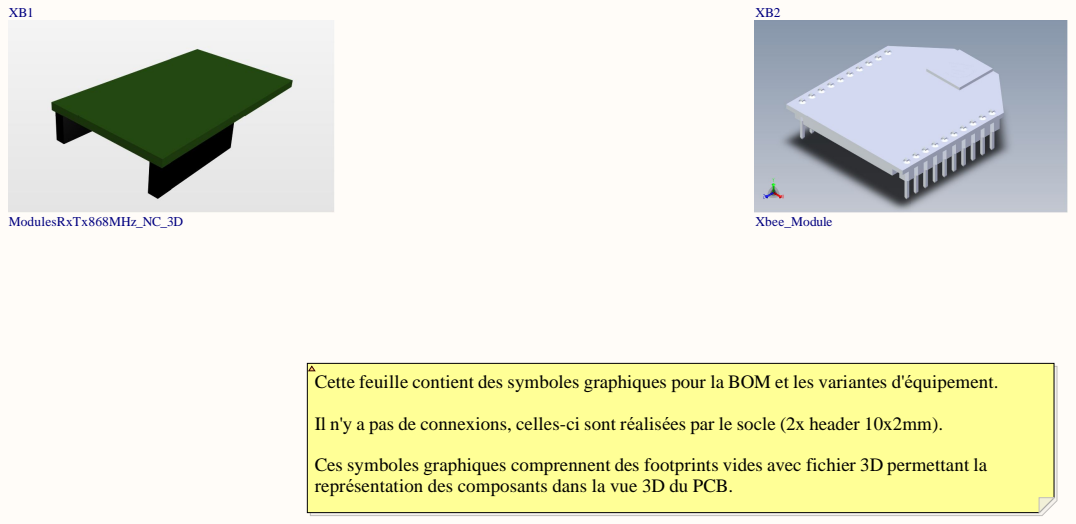
[picture p139: page 5]

Cette feuille contient des symboles graphiques pour la BOM et les variantes d'équipement.

Il n'y a pas de connexions, celles-ci sont réalisées par le socle (2x header 10x2mm).

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

RF_Modules_3D.SchDoc Fichier : | | a | Schéma initial pour version C

Date : 03.03.2023 | Version : C

Heure : 09:55:22 | JMO Auteur :
Rue Sébeillon 12 | Projet : Portier_1730.PrjPcb | No : 1730C

Chemin : G:\OneDrive_EV\OneDrive - Education Vaud\Documents\Altium\Projets\1730_PortierWireless\hard\Portier_17300C_JMO\SCHEMA\RF_Modules_3D.SchDoc
