ETML-ES-SLO/PRJ_1730_PortierWireless/doc/PDF(Final)/SchemaPower.pdf

# Auto-Alimentation

# Mesure pile

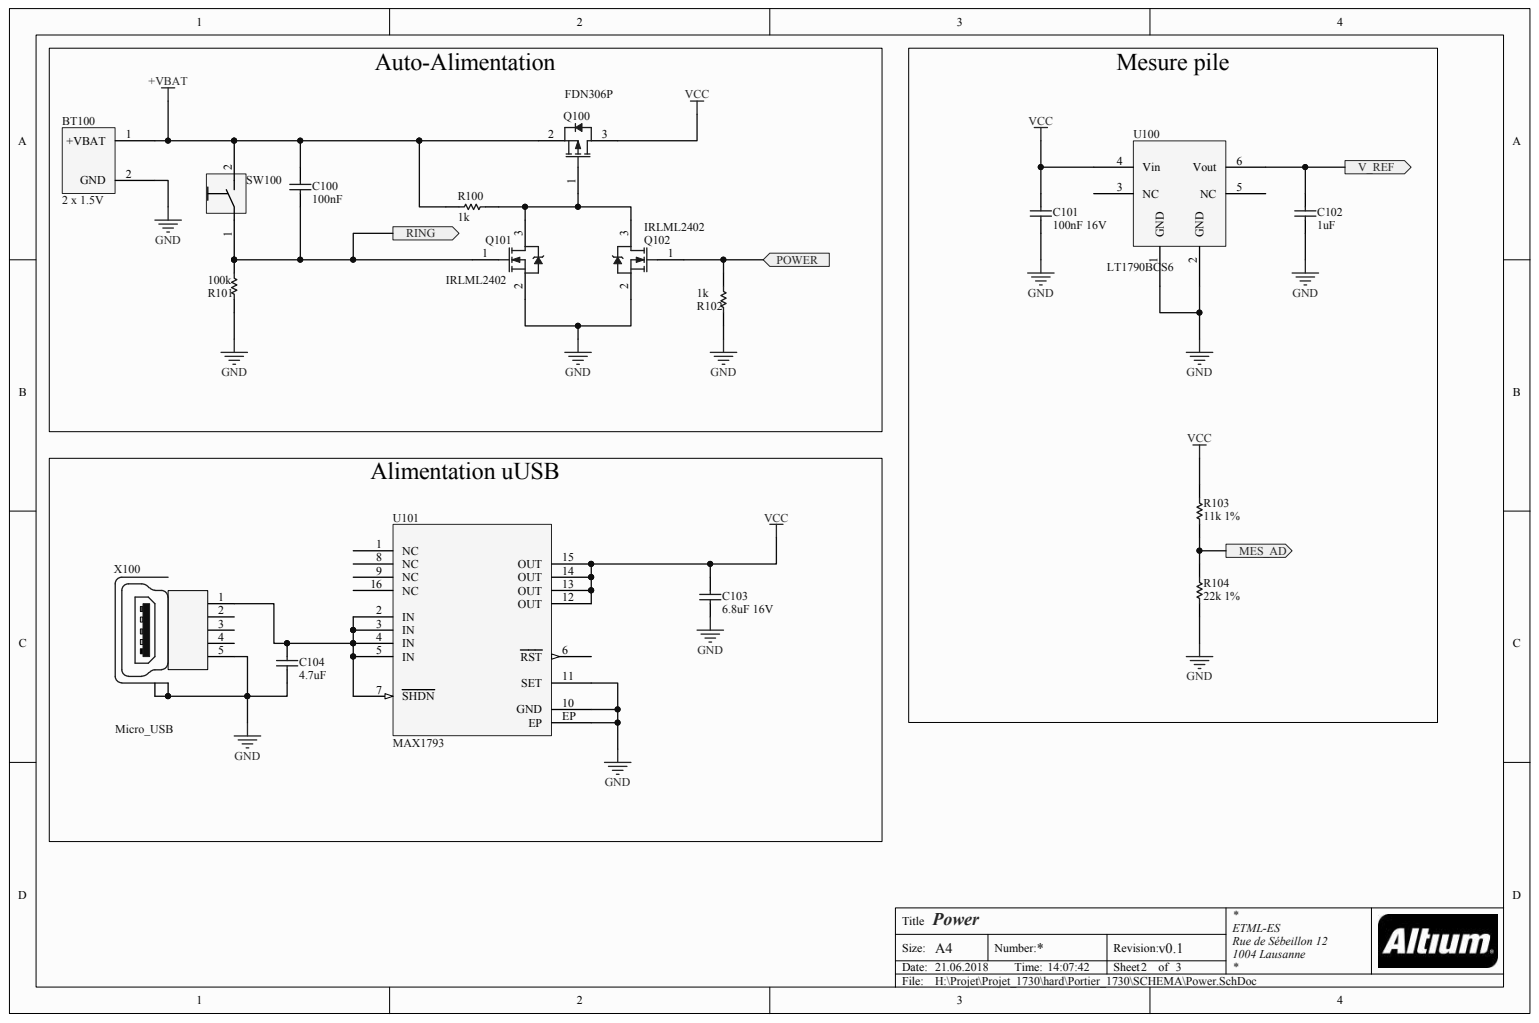
[picture p140: page 1]

H:\Projet\Projet_1730\hard\Portier_1730\SCHEMA\Power.SchDoc
File:
