ETML-ES-SLO/PRJ_1730_PortierWireless/soft/Portier_17300A_Page_NON_FINI/Visio-StructogrammeIN.pdf

# Code circuit IN

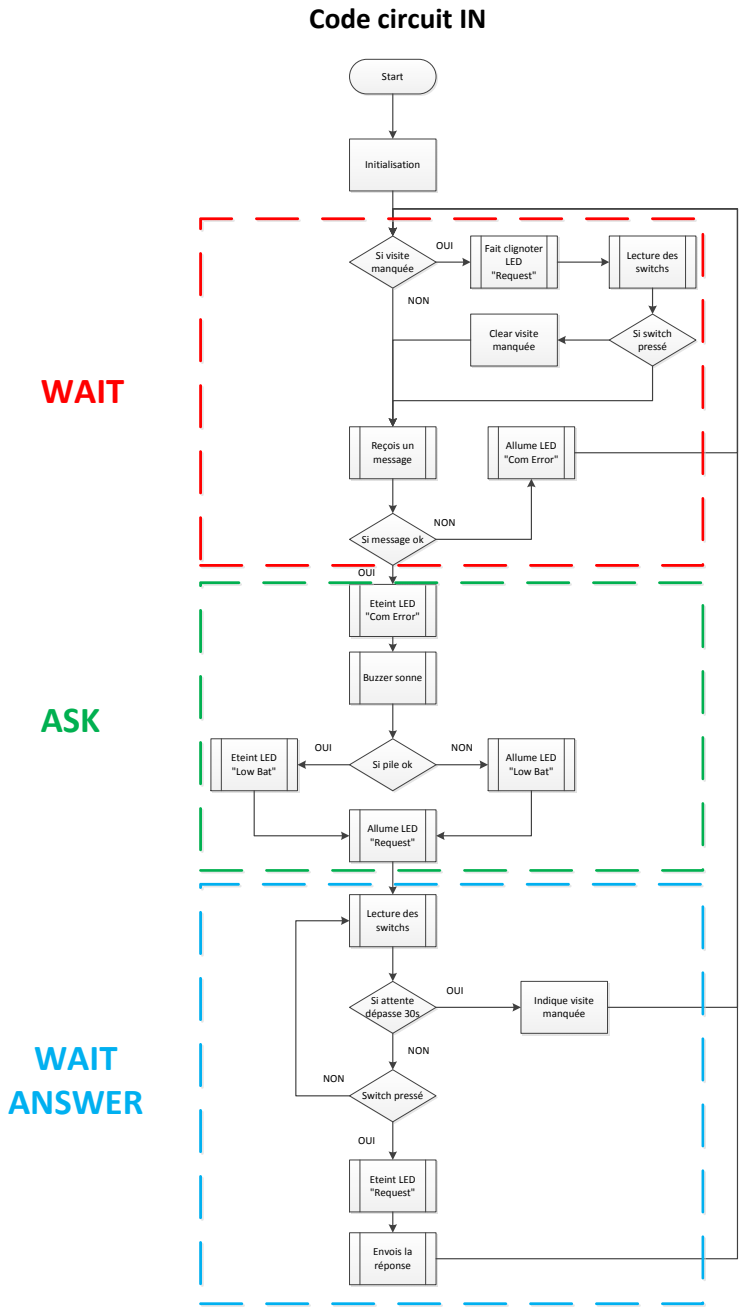
[picture p141: page 1]
Start; Initialisation; Reçois un message; Allume LED "Low Bat"; OUI; NON; Allume LED "Com Error"; Eteint LED "Com Error"; Buzzer sonne; Allume LED "Request"; Lecture des switchs; Si attente dépasse 30s; Switch pressé; Eteint LED "Request"; Envois la réponse; Si visite manquée; Fait clignoter LED "Request"; Si switch pressé; Indique visite manquée; Clear visite manquée; WAIT; ASK; WAIT ANSWER

Si message ok

Si pile ok Eteint LED
"Low Bat"
