ETML-ES-SLO/PRJ_1730_PortierWireless/soft/Portier_17300A_Page_NON_FINI/Visio-StructogrammeOUT.pdf

# Code circuit OUT

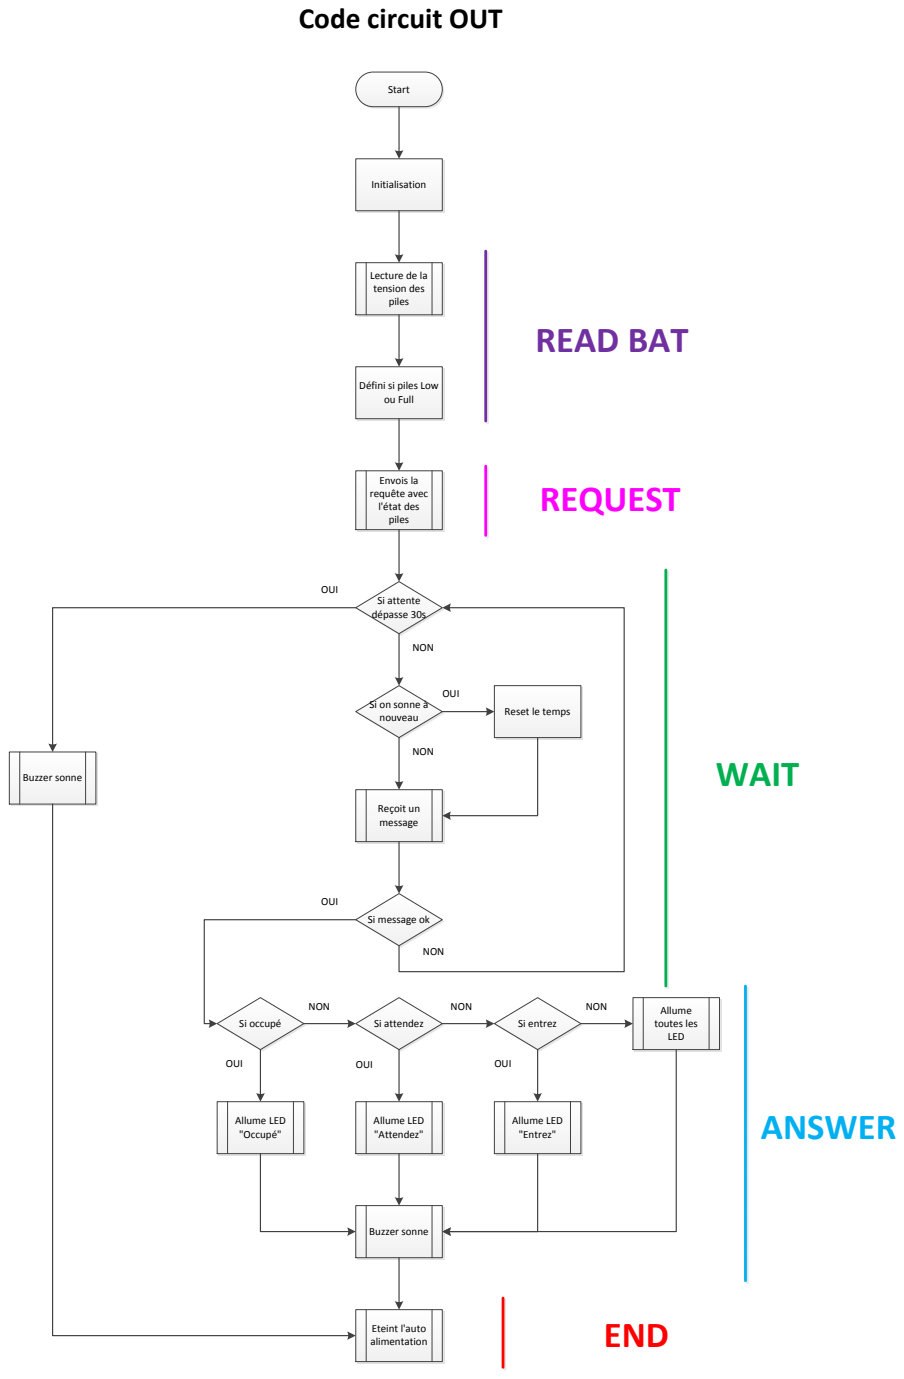
[picture p142: page 1]
Start; Initialisation; Envois la requête avec l'état des piles; Reçoit un message; nouveau; Reset le temps; Si attente dépasse 30s; Si occupé; Si attendez; Si entrez; Allume LED "Occupé"; Allume LED "Attendez"; Allume LED "Entrez"; Buzzer sonne; Allume toutes les LED; Eteint l'auto alimentation; NON; OUI; READ BAT; WAIT; ANSWER; END; REQUEST

Lecture de la
tension des
piles

Défini si piles Low
ou Full

Si on sonne à

Si message ok
