ETML-ES-SLO/PRJ_1730_PortierWireless/doc/Modification/Mod 3.0/3_Doxygen/latex/app_8c__incl.pdf

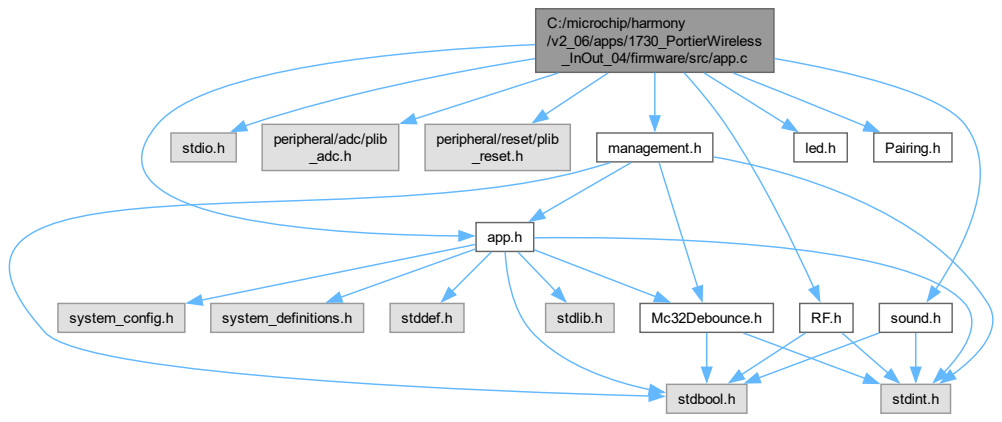
[picture p143: page 1]
app.h; stdio.h; peripheral/adc/plib; _adc.h; sound.h; management.h; led.h; Pairing.h; stdbool.h; stdint.h; system_config.h; system_definitions.h; stddef.h; stdlib.h; Mc32Debounce.h

C:/microchip/harmony
/v2_06/apps/1730_PortierWireless
_InOut_04/firmware/src/app.c

peripheral/reset/plib
_reset.h
