ETML-ES-SLO/PRJ_1730_PortierWireless/hard/Portier_17300B_SCA/PCB/DesignDocs/Dimensional Drawings.PDF

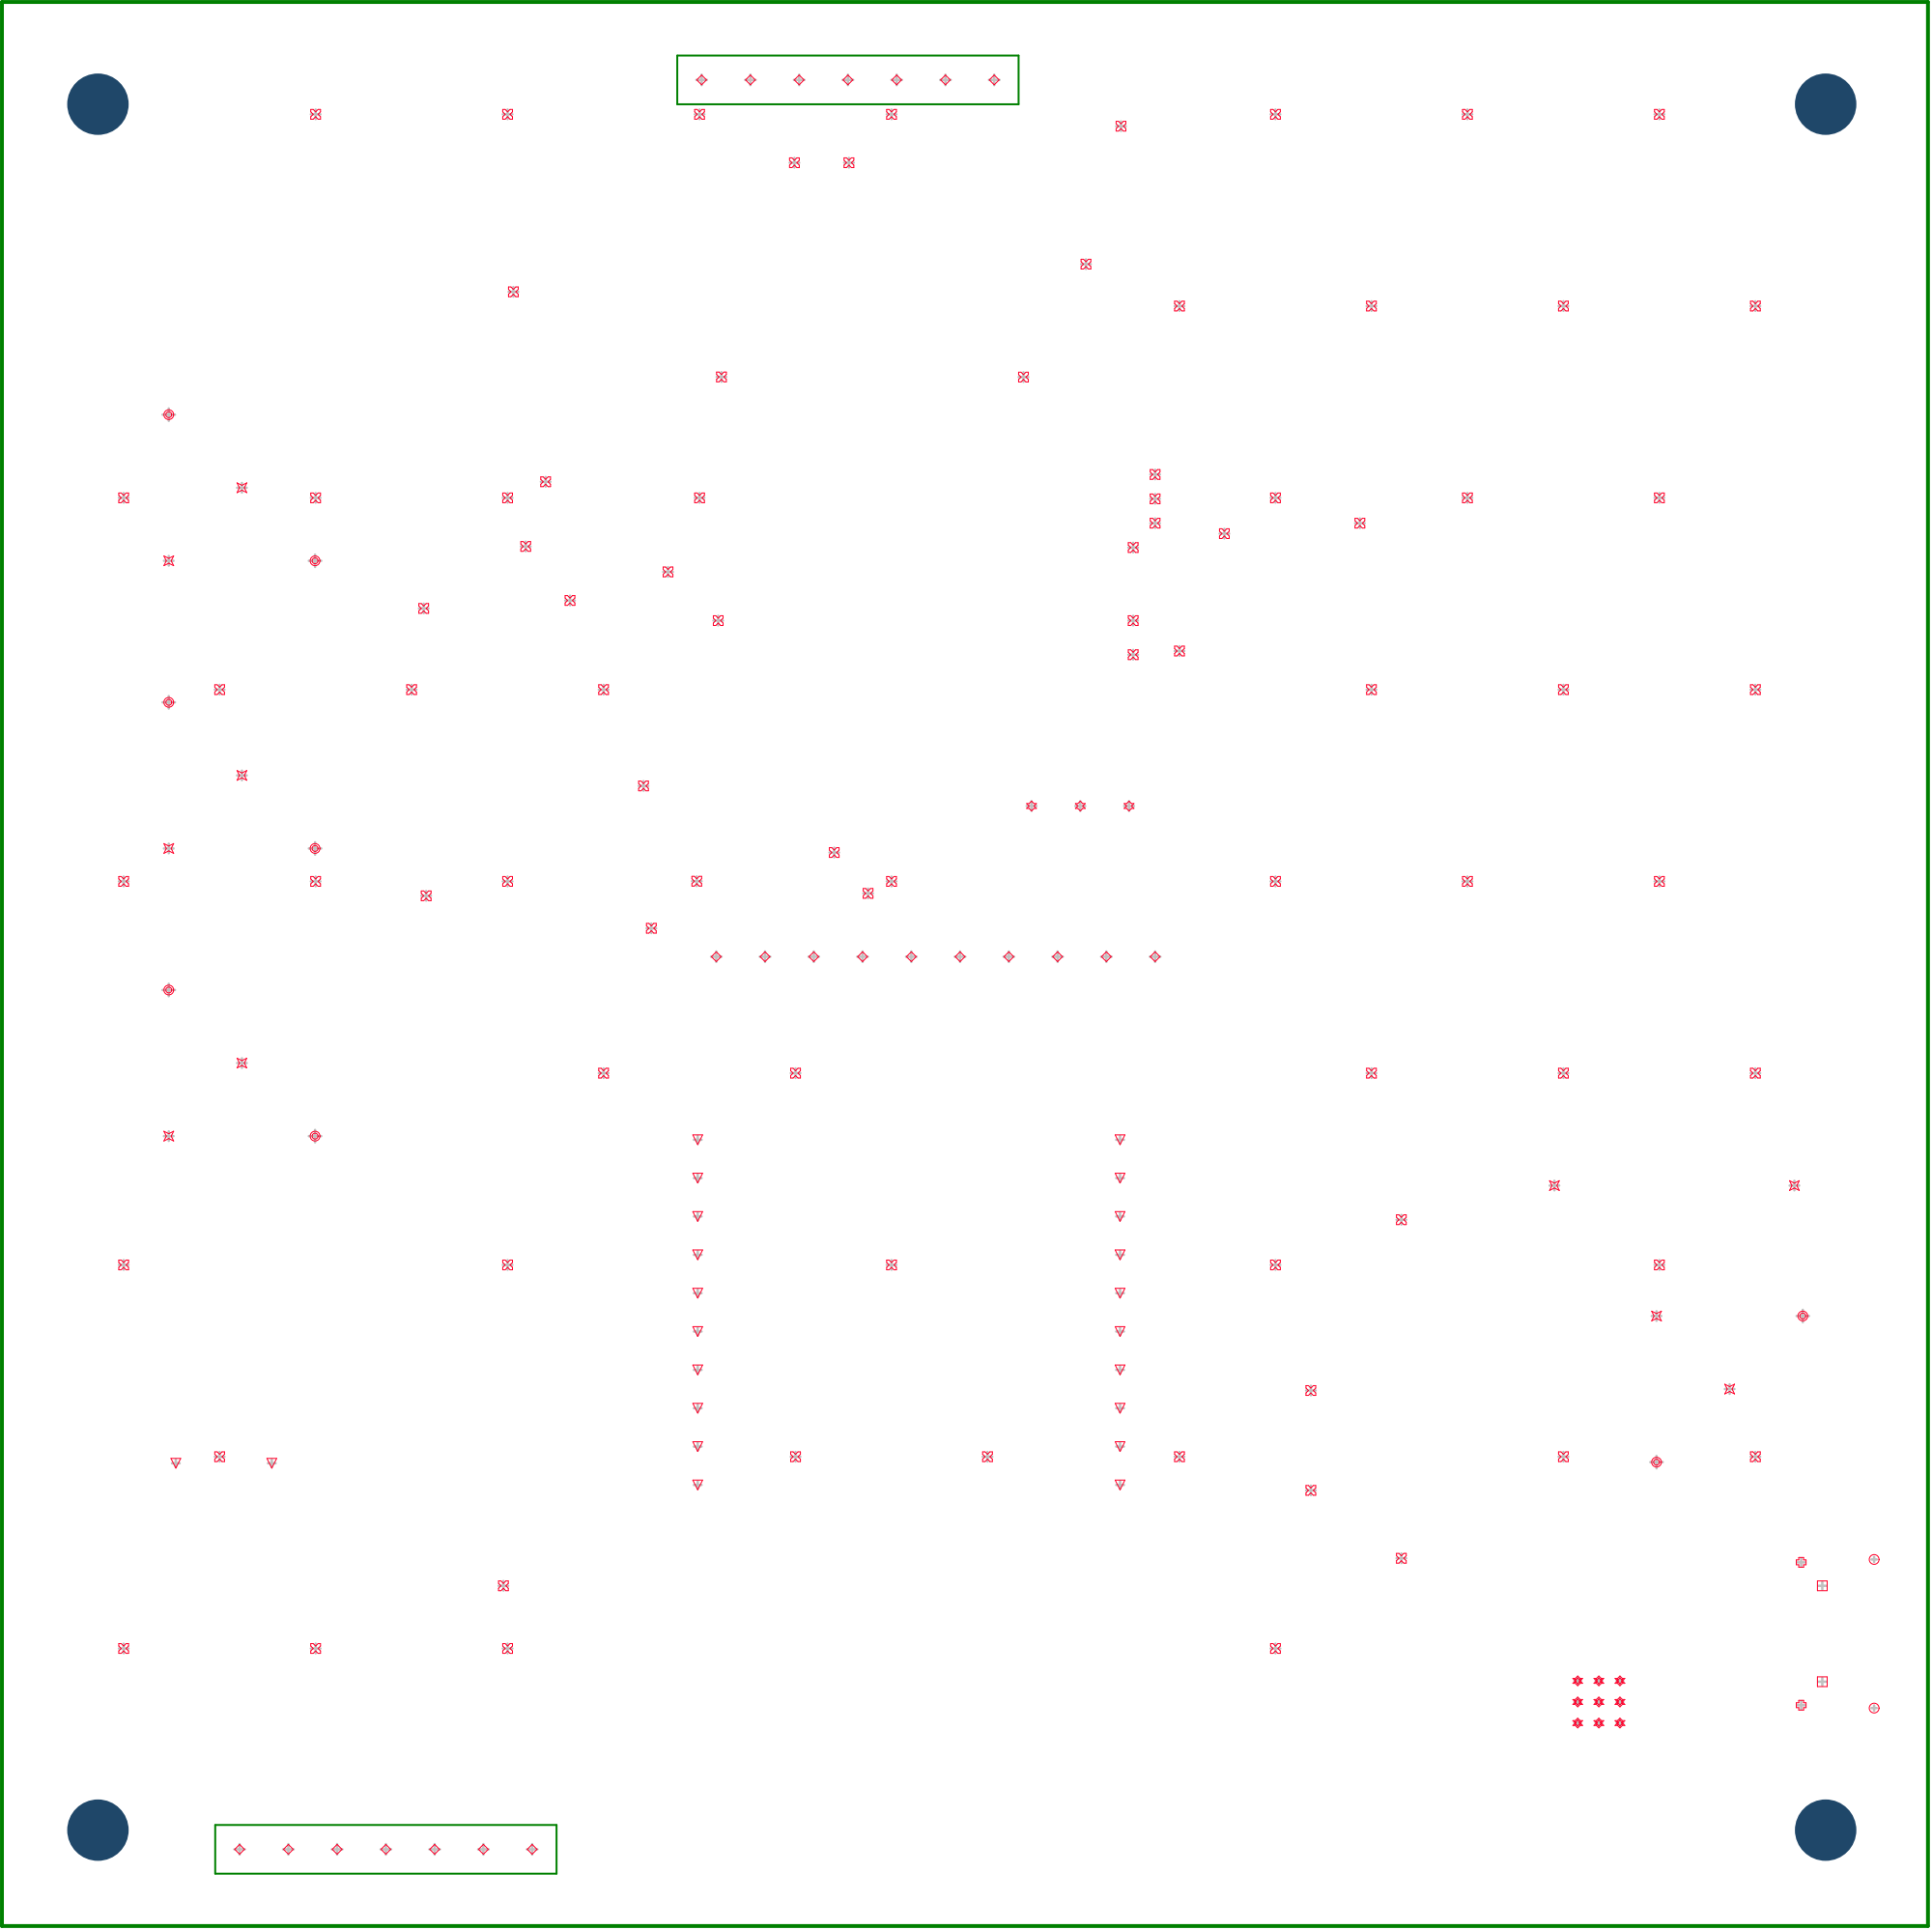
[picture p144: page 1]
