ETML-ES-SLO/PRJ_1730_PortierWireless/hard/Portier_17300B_SCA/PCB/DesignDocs/PCB Top-Bottom Assy Dwgs.PDF

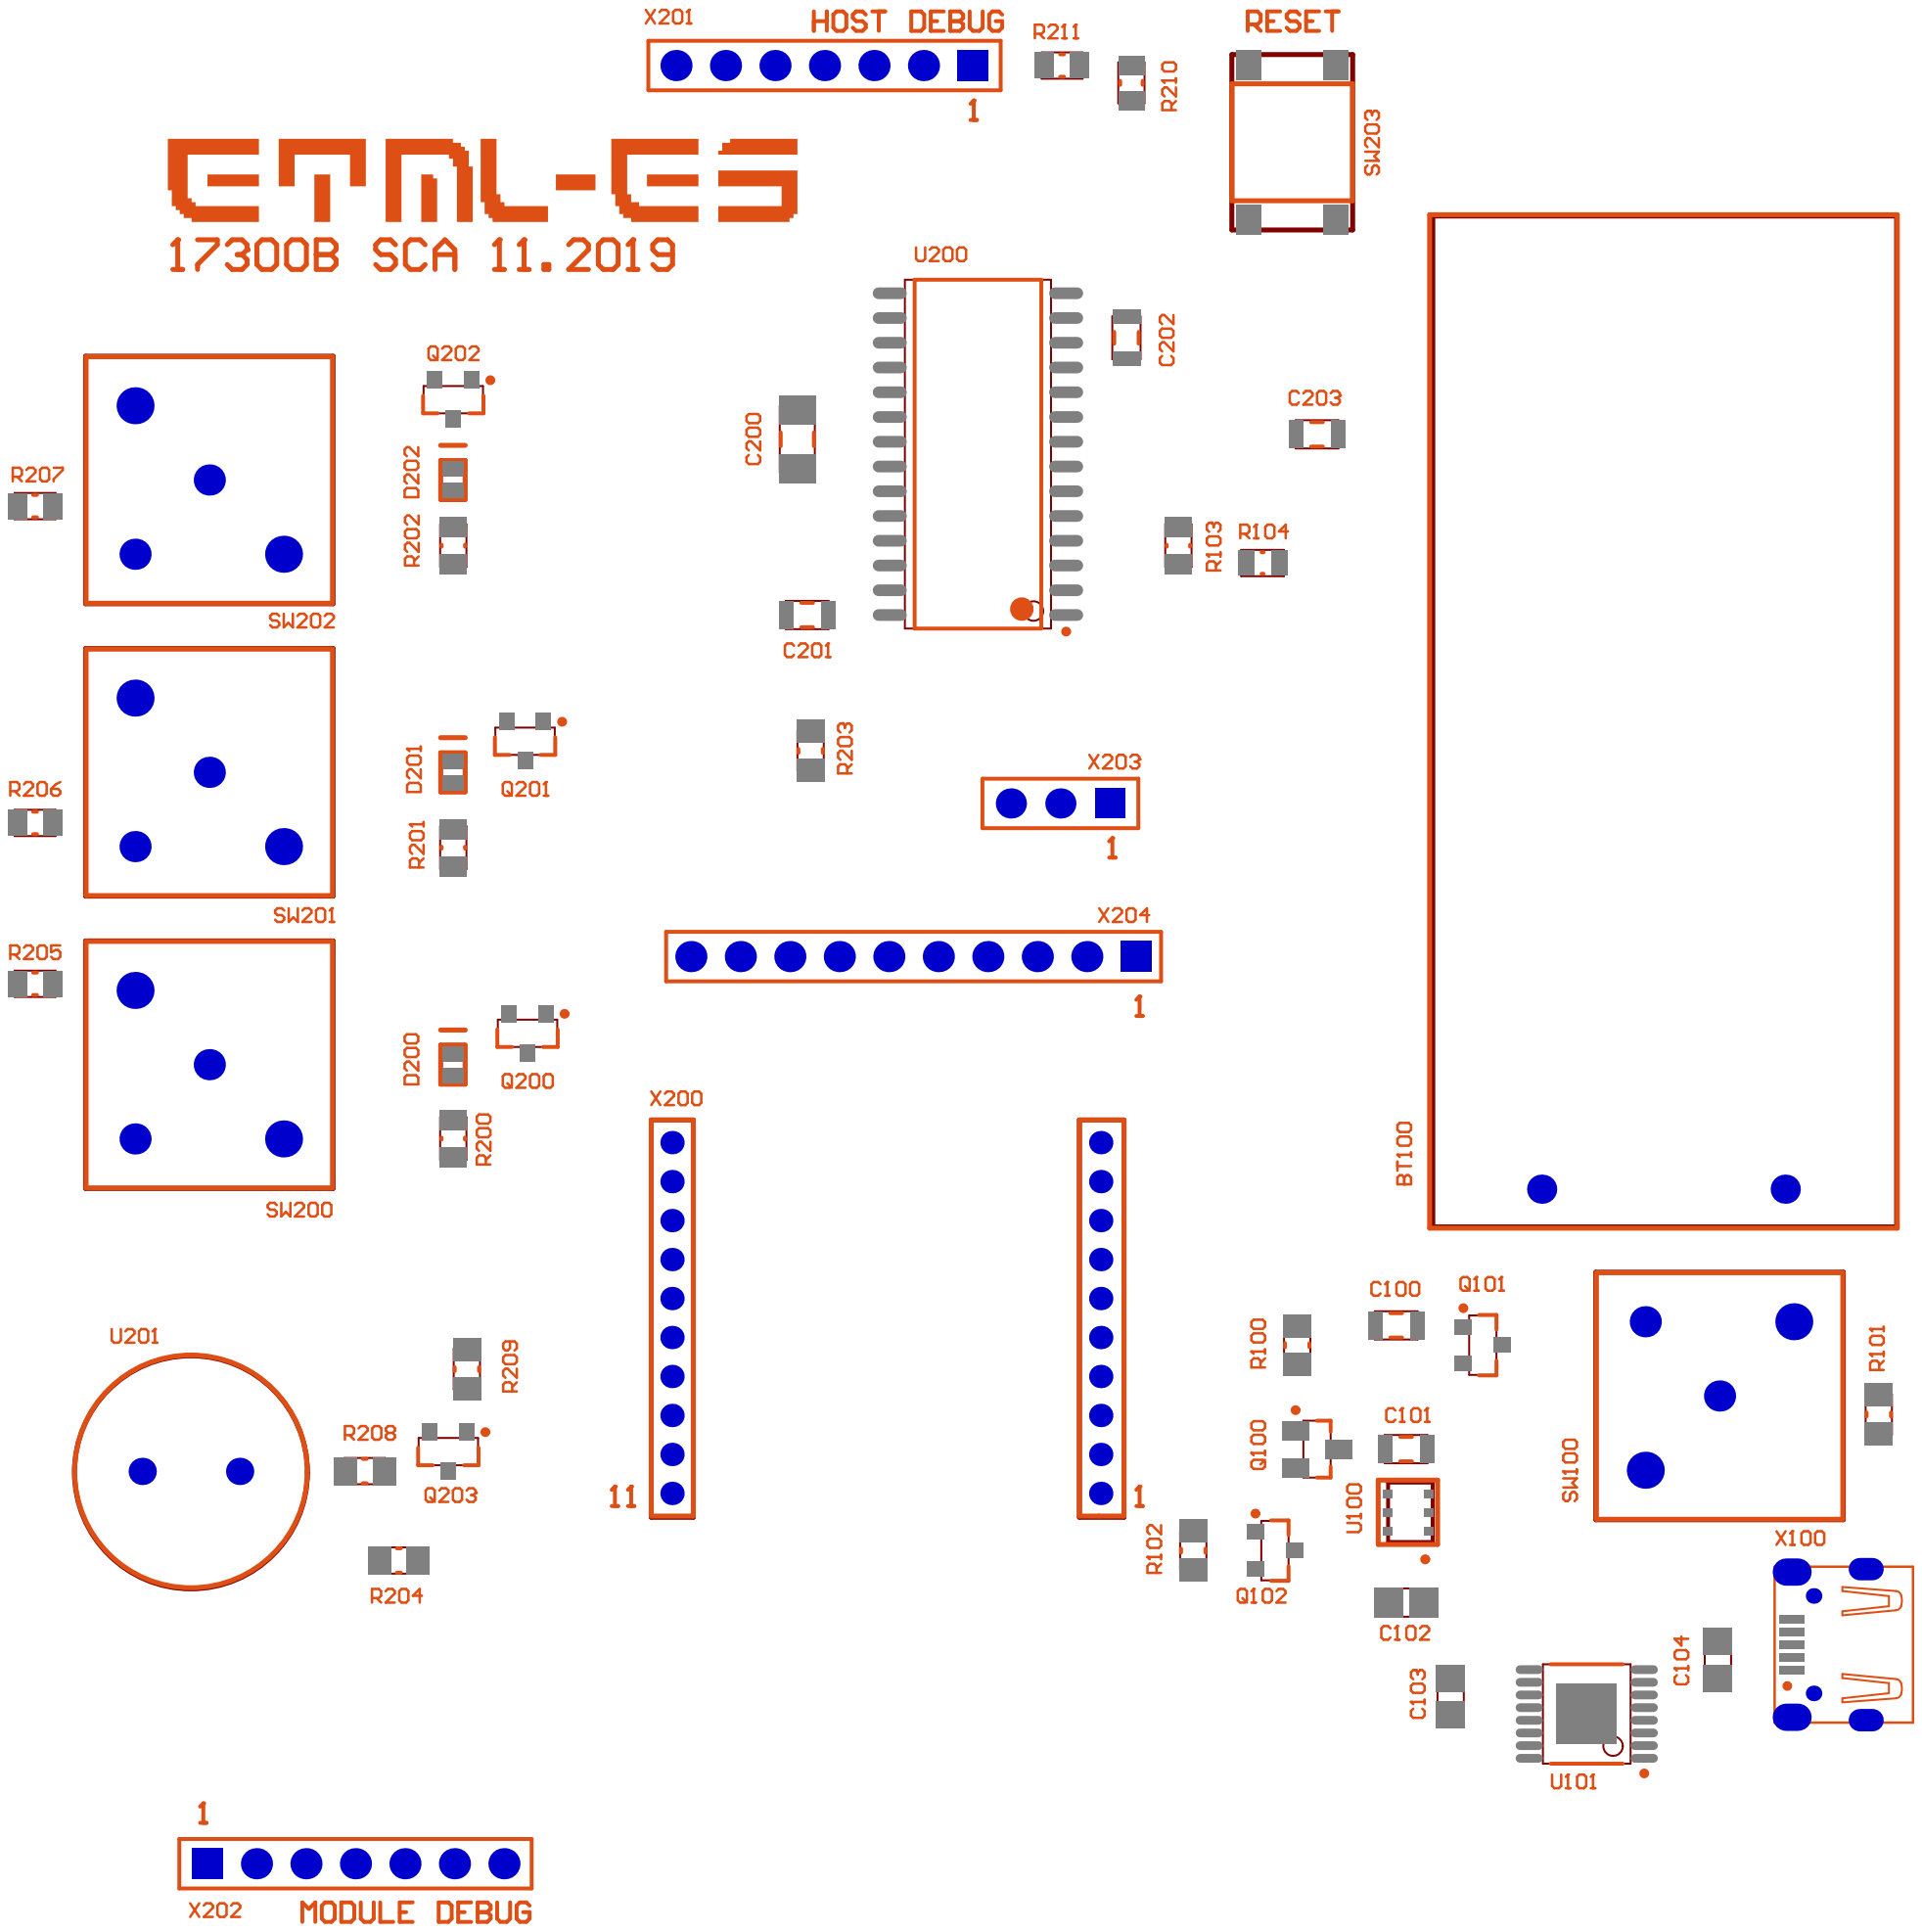
[picture p145: page 1]

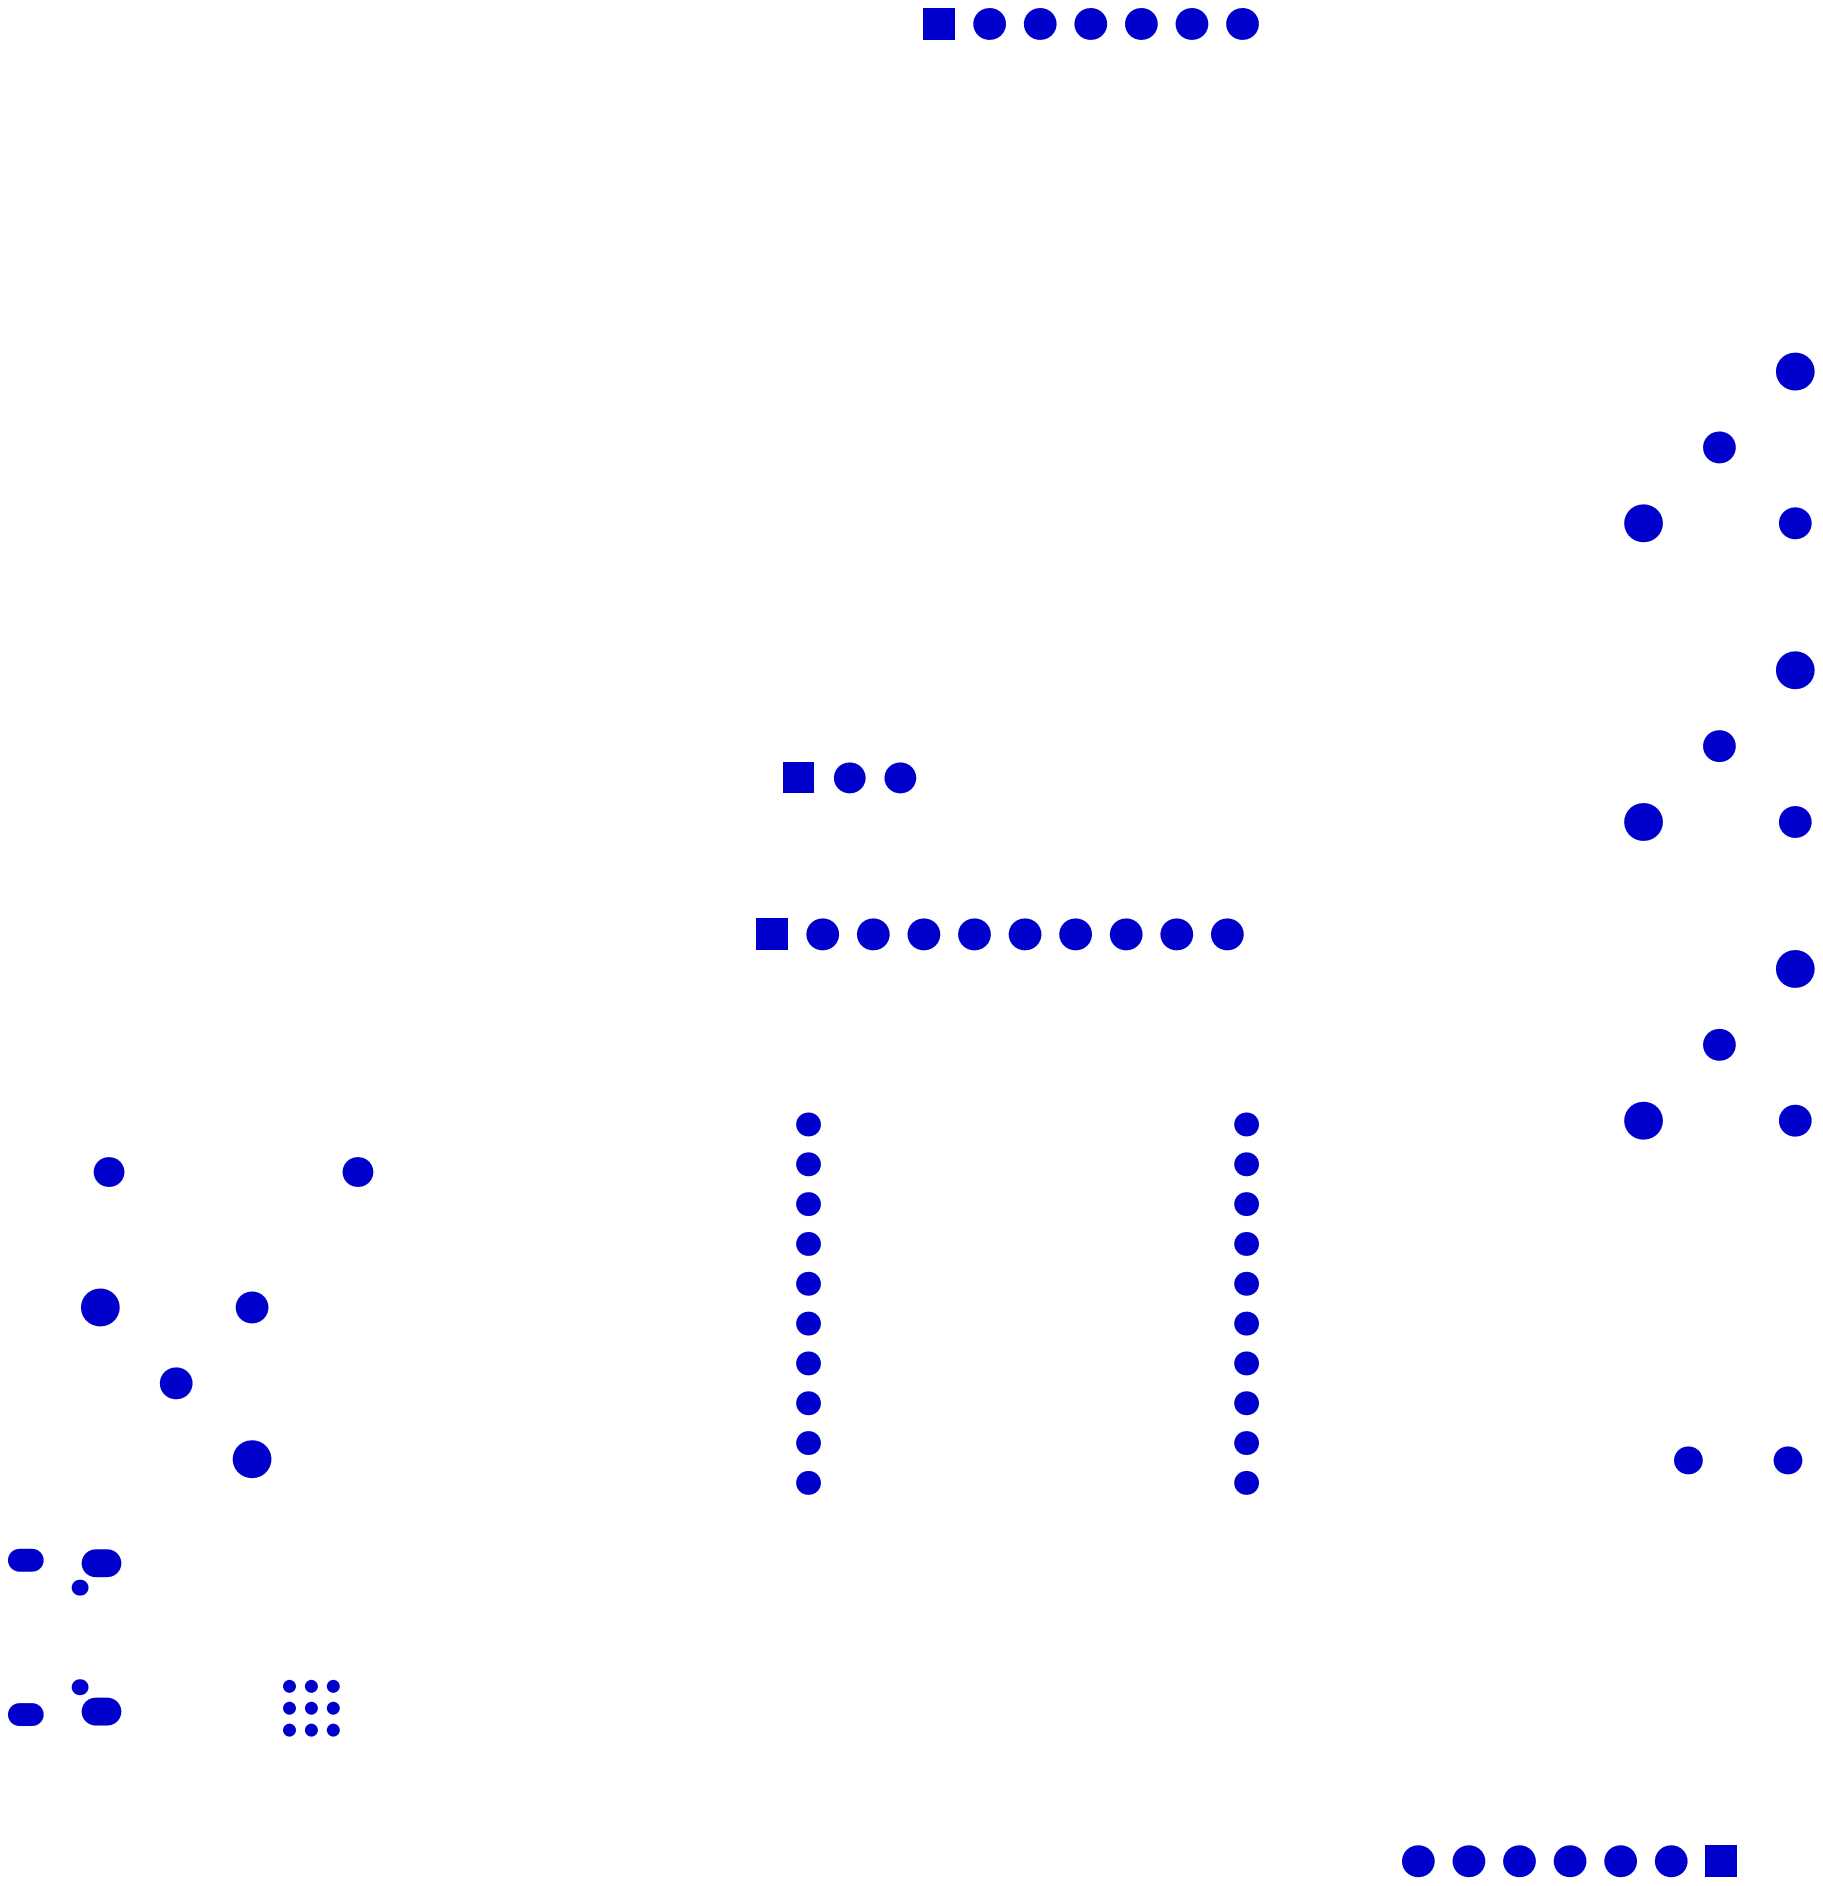
[picture p146: page 2]
