ETML-ES-SLO/PRJ_1730_PortierWireless/hard/Portier_17300B_SCA/Project Outputs for Portier_1730/DesignDocs/Schematic Prints.PDF

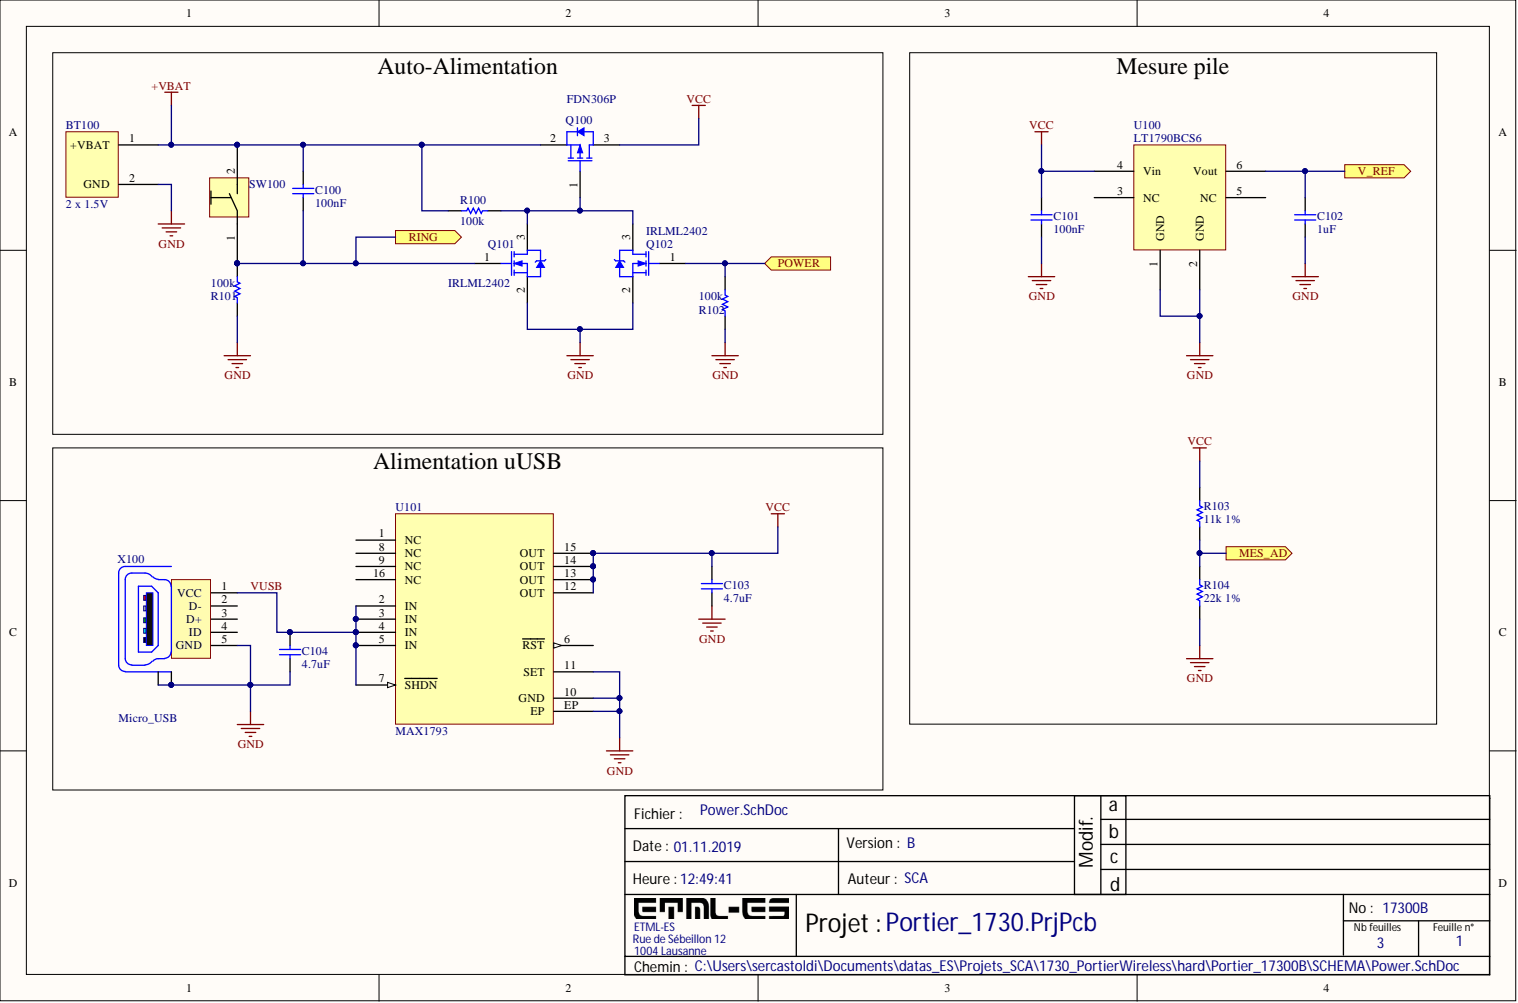
[picture p147: page 1]

Power.SchDoc Fichier : | | a

Date : 01.11.2019 | Version : B

Heure : 12:49:41 | SCA Auteur :
ETML-ES Rue de Sébeillon 12 1004 Lausanne | Projet : Portier_1730.PrjPcb | No : 17300B

Nb feuilles | Feuille n°

Chemin : C:\Users\sercastoldi\Documents\datas_ES\Projets_SCA\1730_PortierWireless\hard\Portier_17300B\SCHEMA\Power.SchDoc

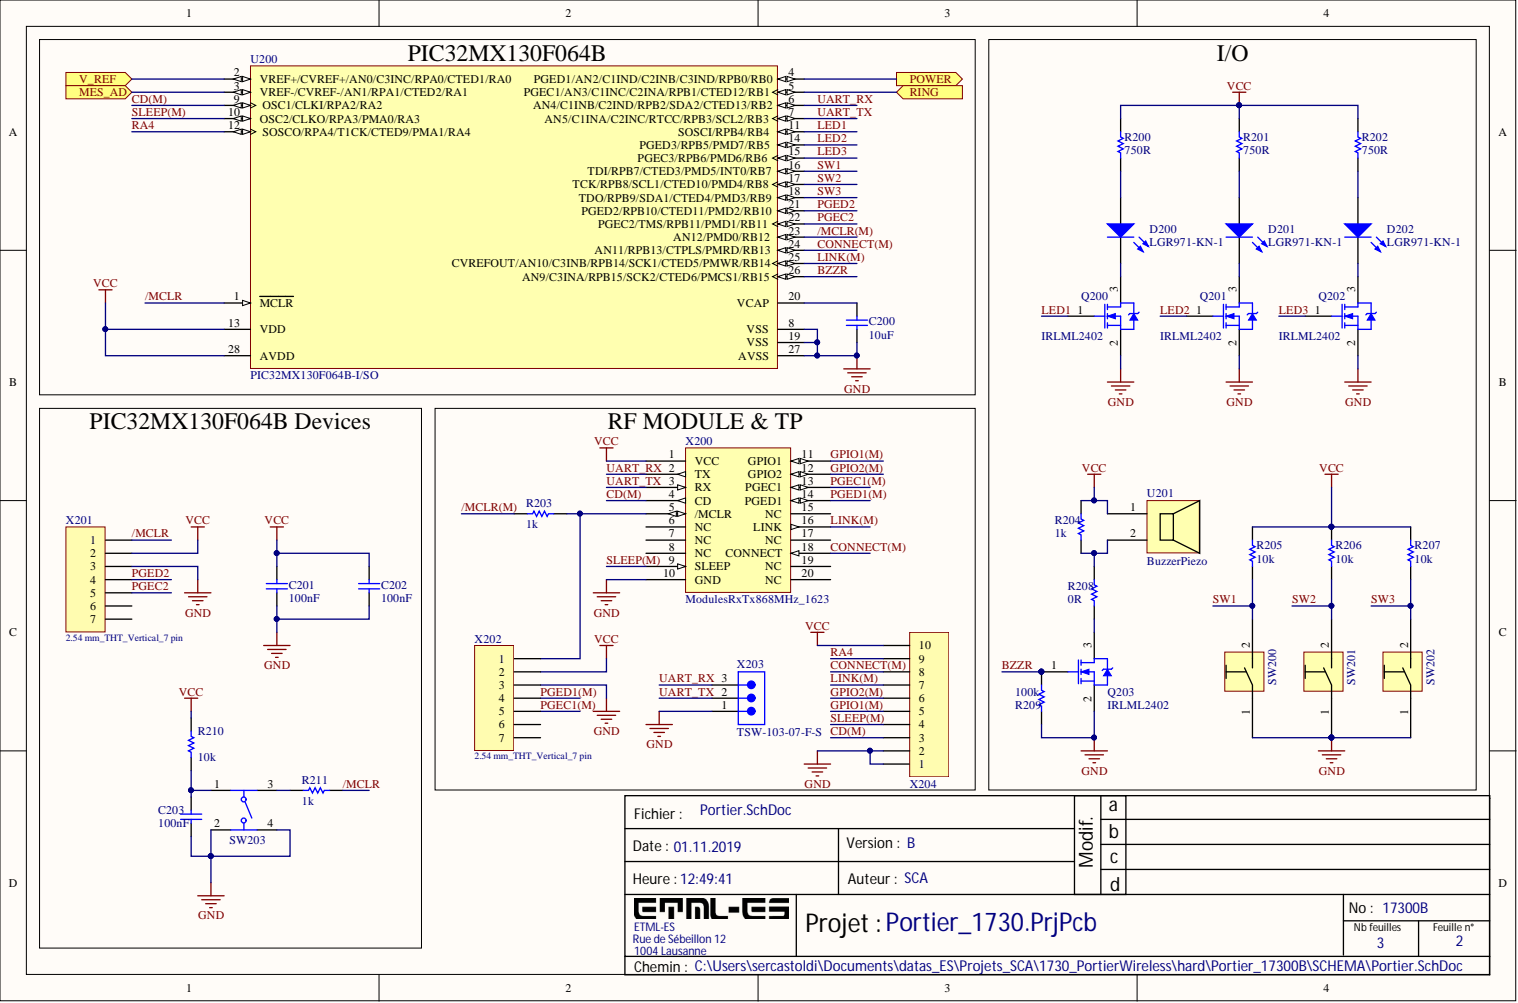
[picture p148: page 2]

Portier.SchDoc Fichier : | | a

Heure : 12:49:41 | SCA Auteur :

Projet : Portier_1730.PrjPcb | No : 17300B

Chemin : C:\Users\sercastoldi\Documents\datas_ES\Projets_SCA\1730_PortierWireless\hard\Portier_17300B\SCHEMA\Portier.SchDoc

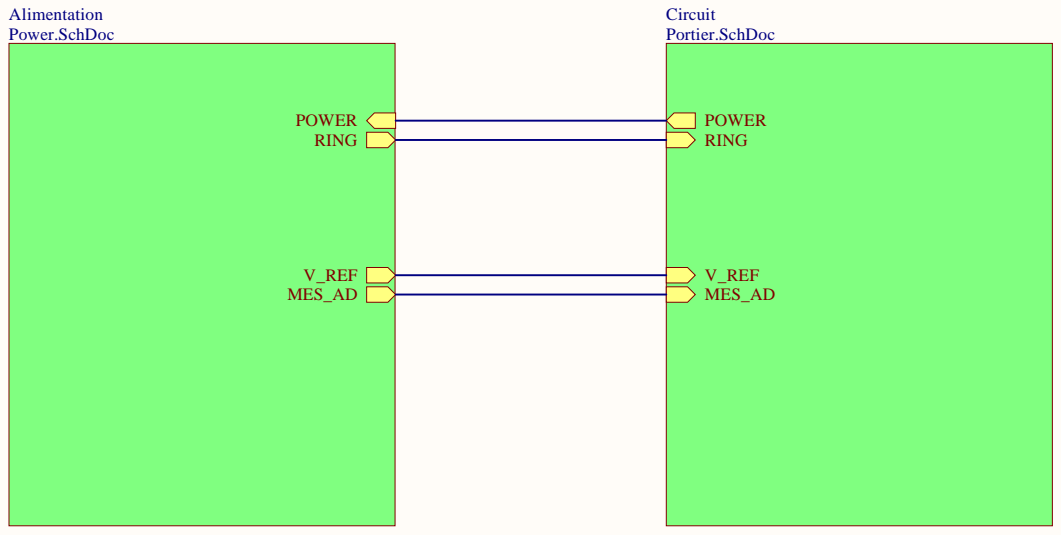
[picture p149: page 3]

TopSchematic.SchDoc Fichier : | | a

Date : 01.11.2019 | Version : B

Heure : 12:49:41 | SCA Auteur :

Projet : Portier_1730.PrjPcb | No : 17300B

Chemin : C:\Users\sercastoldi\Documents\datas_ES\Projets_SCA\1730_PortierWireless\hard\Portier_17300B\SCHEMA\TopSchematic.SchDoc
