ETML-ES-SLO/PRJ_1730_PortierWireless/hard/Portier_17300C_JMO/Project Outputs for Portier_1730/DesignDocs/Portier_1730_Draftsman_Variant_MEC_Assy_Bell.PDF

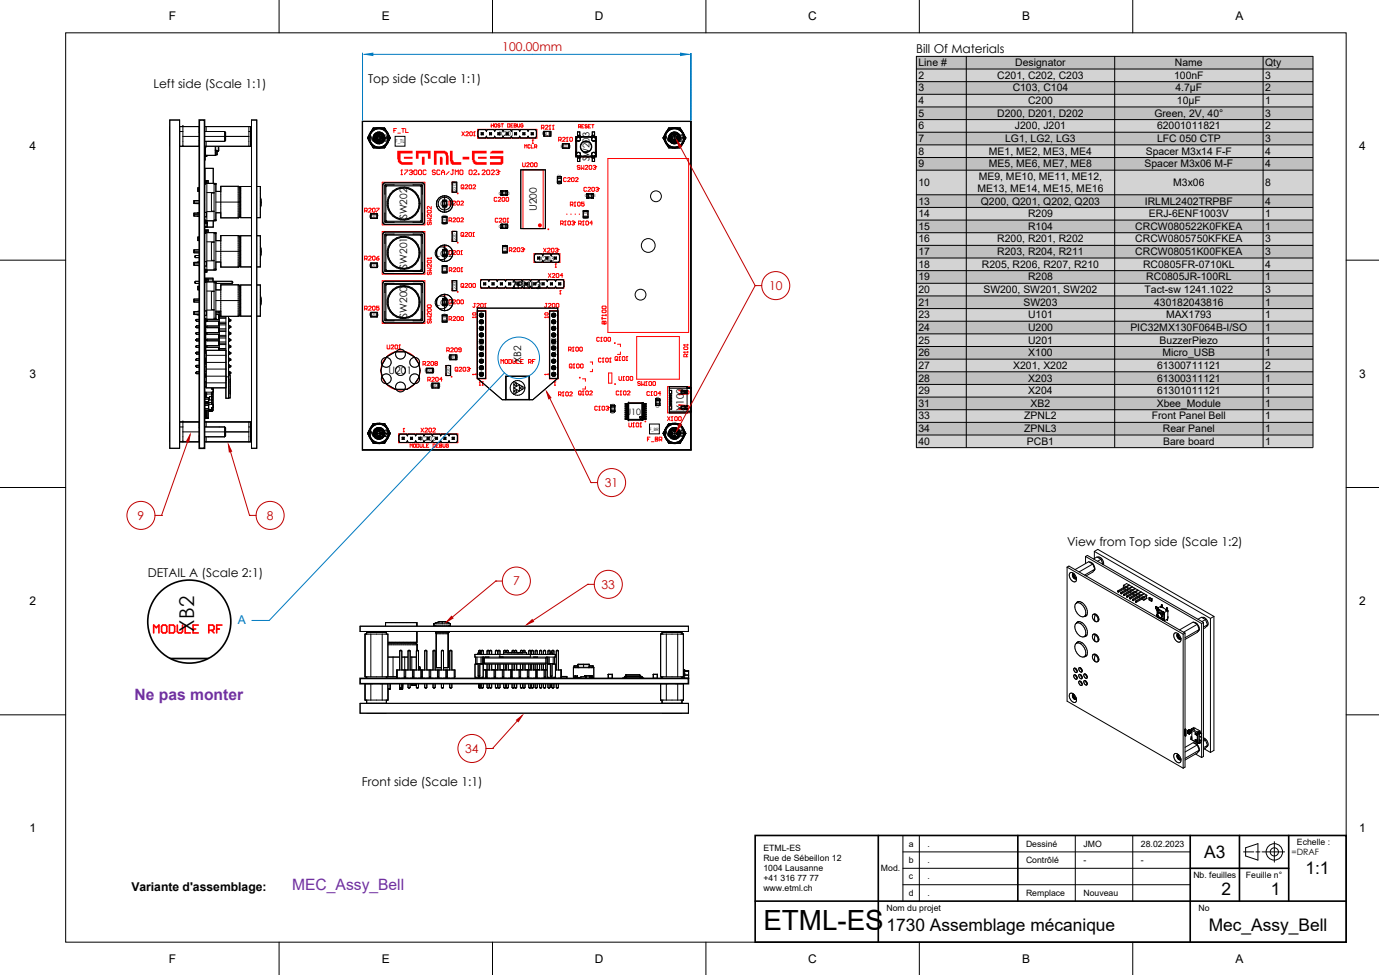
[picture p150: page 1]

View from Top side (Scale 1:2)

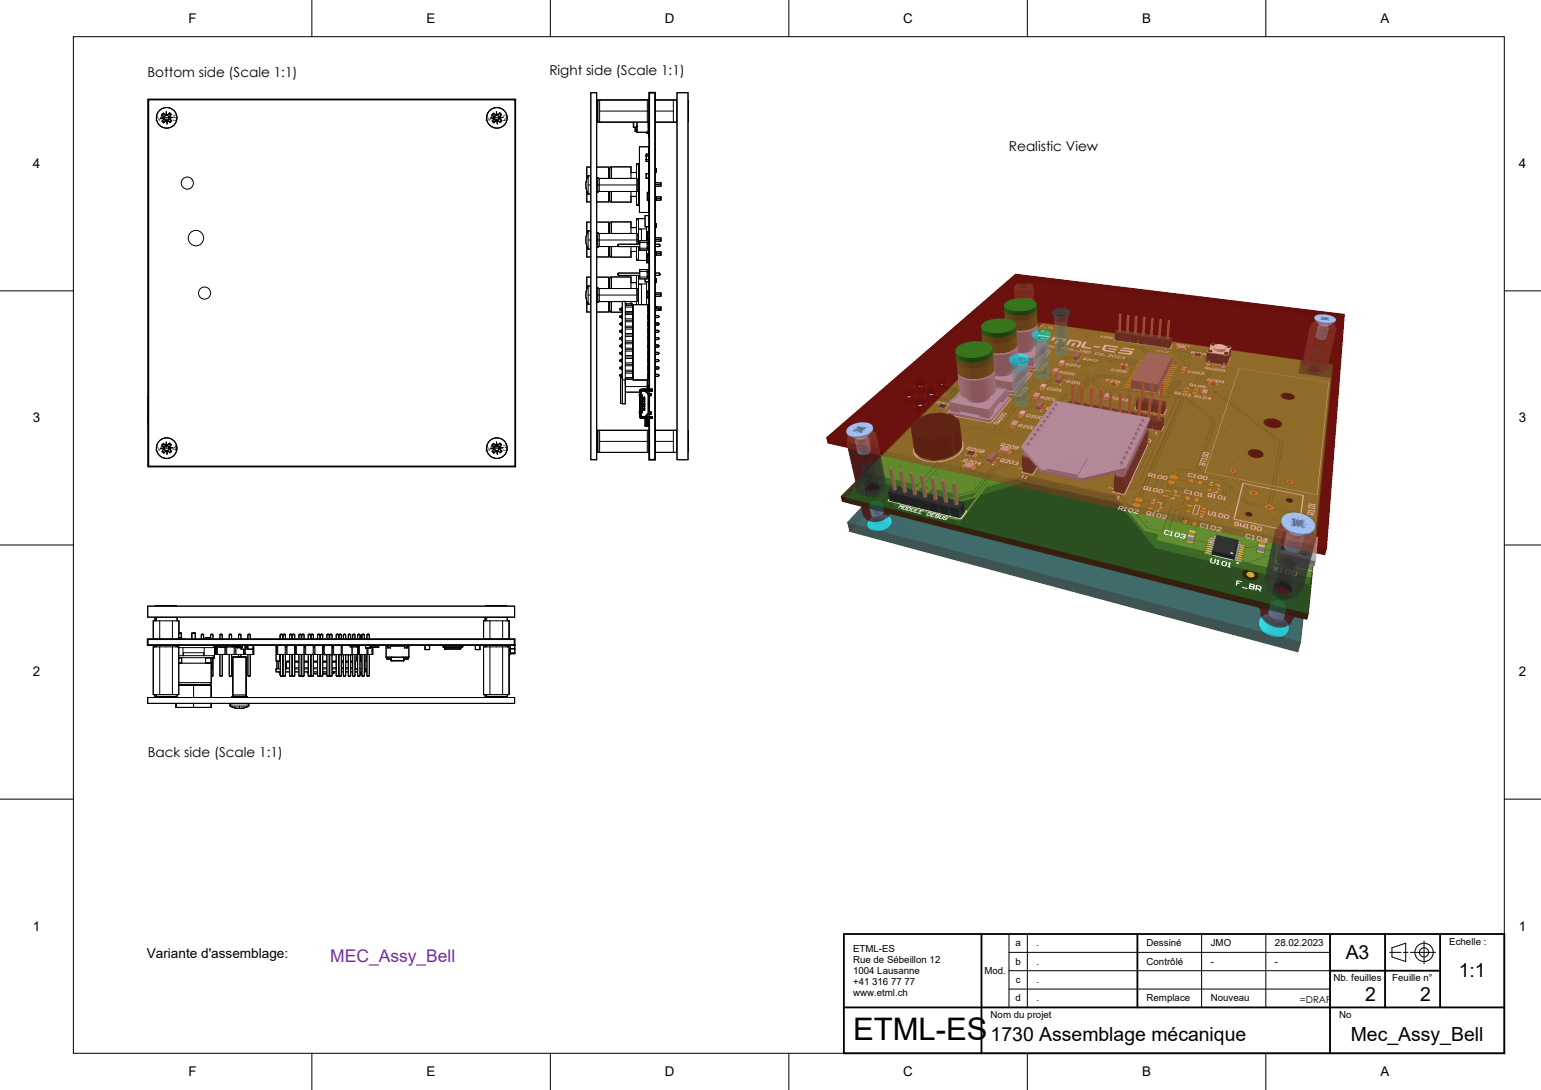
[picture p151: page 2]
