ETML-ES-SLO/PRJ_1730_PortierWireless/hard/Portier_17300C_JMO/Project Outputs for Portier_1730/DesignDocs/Portier_1730_PCB Top-Bot Assy Dwgs_Variant_PCBA_Door.PDF

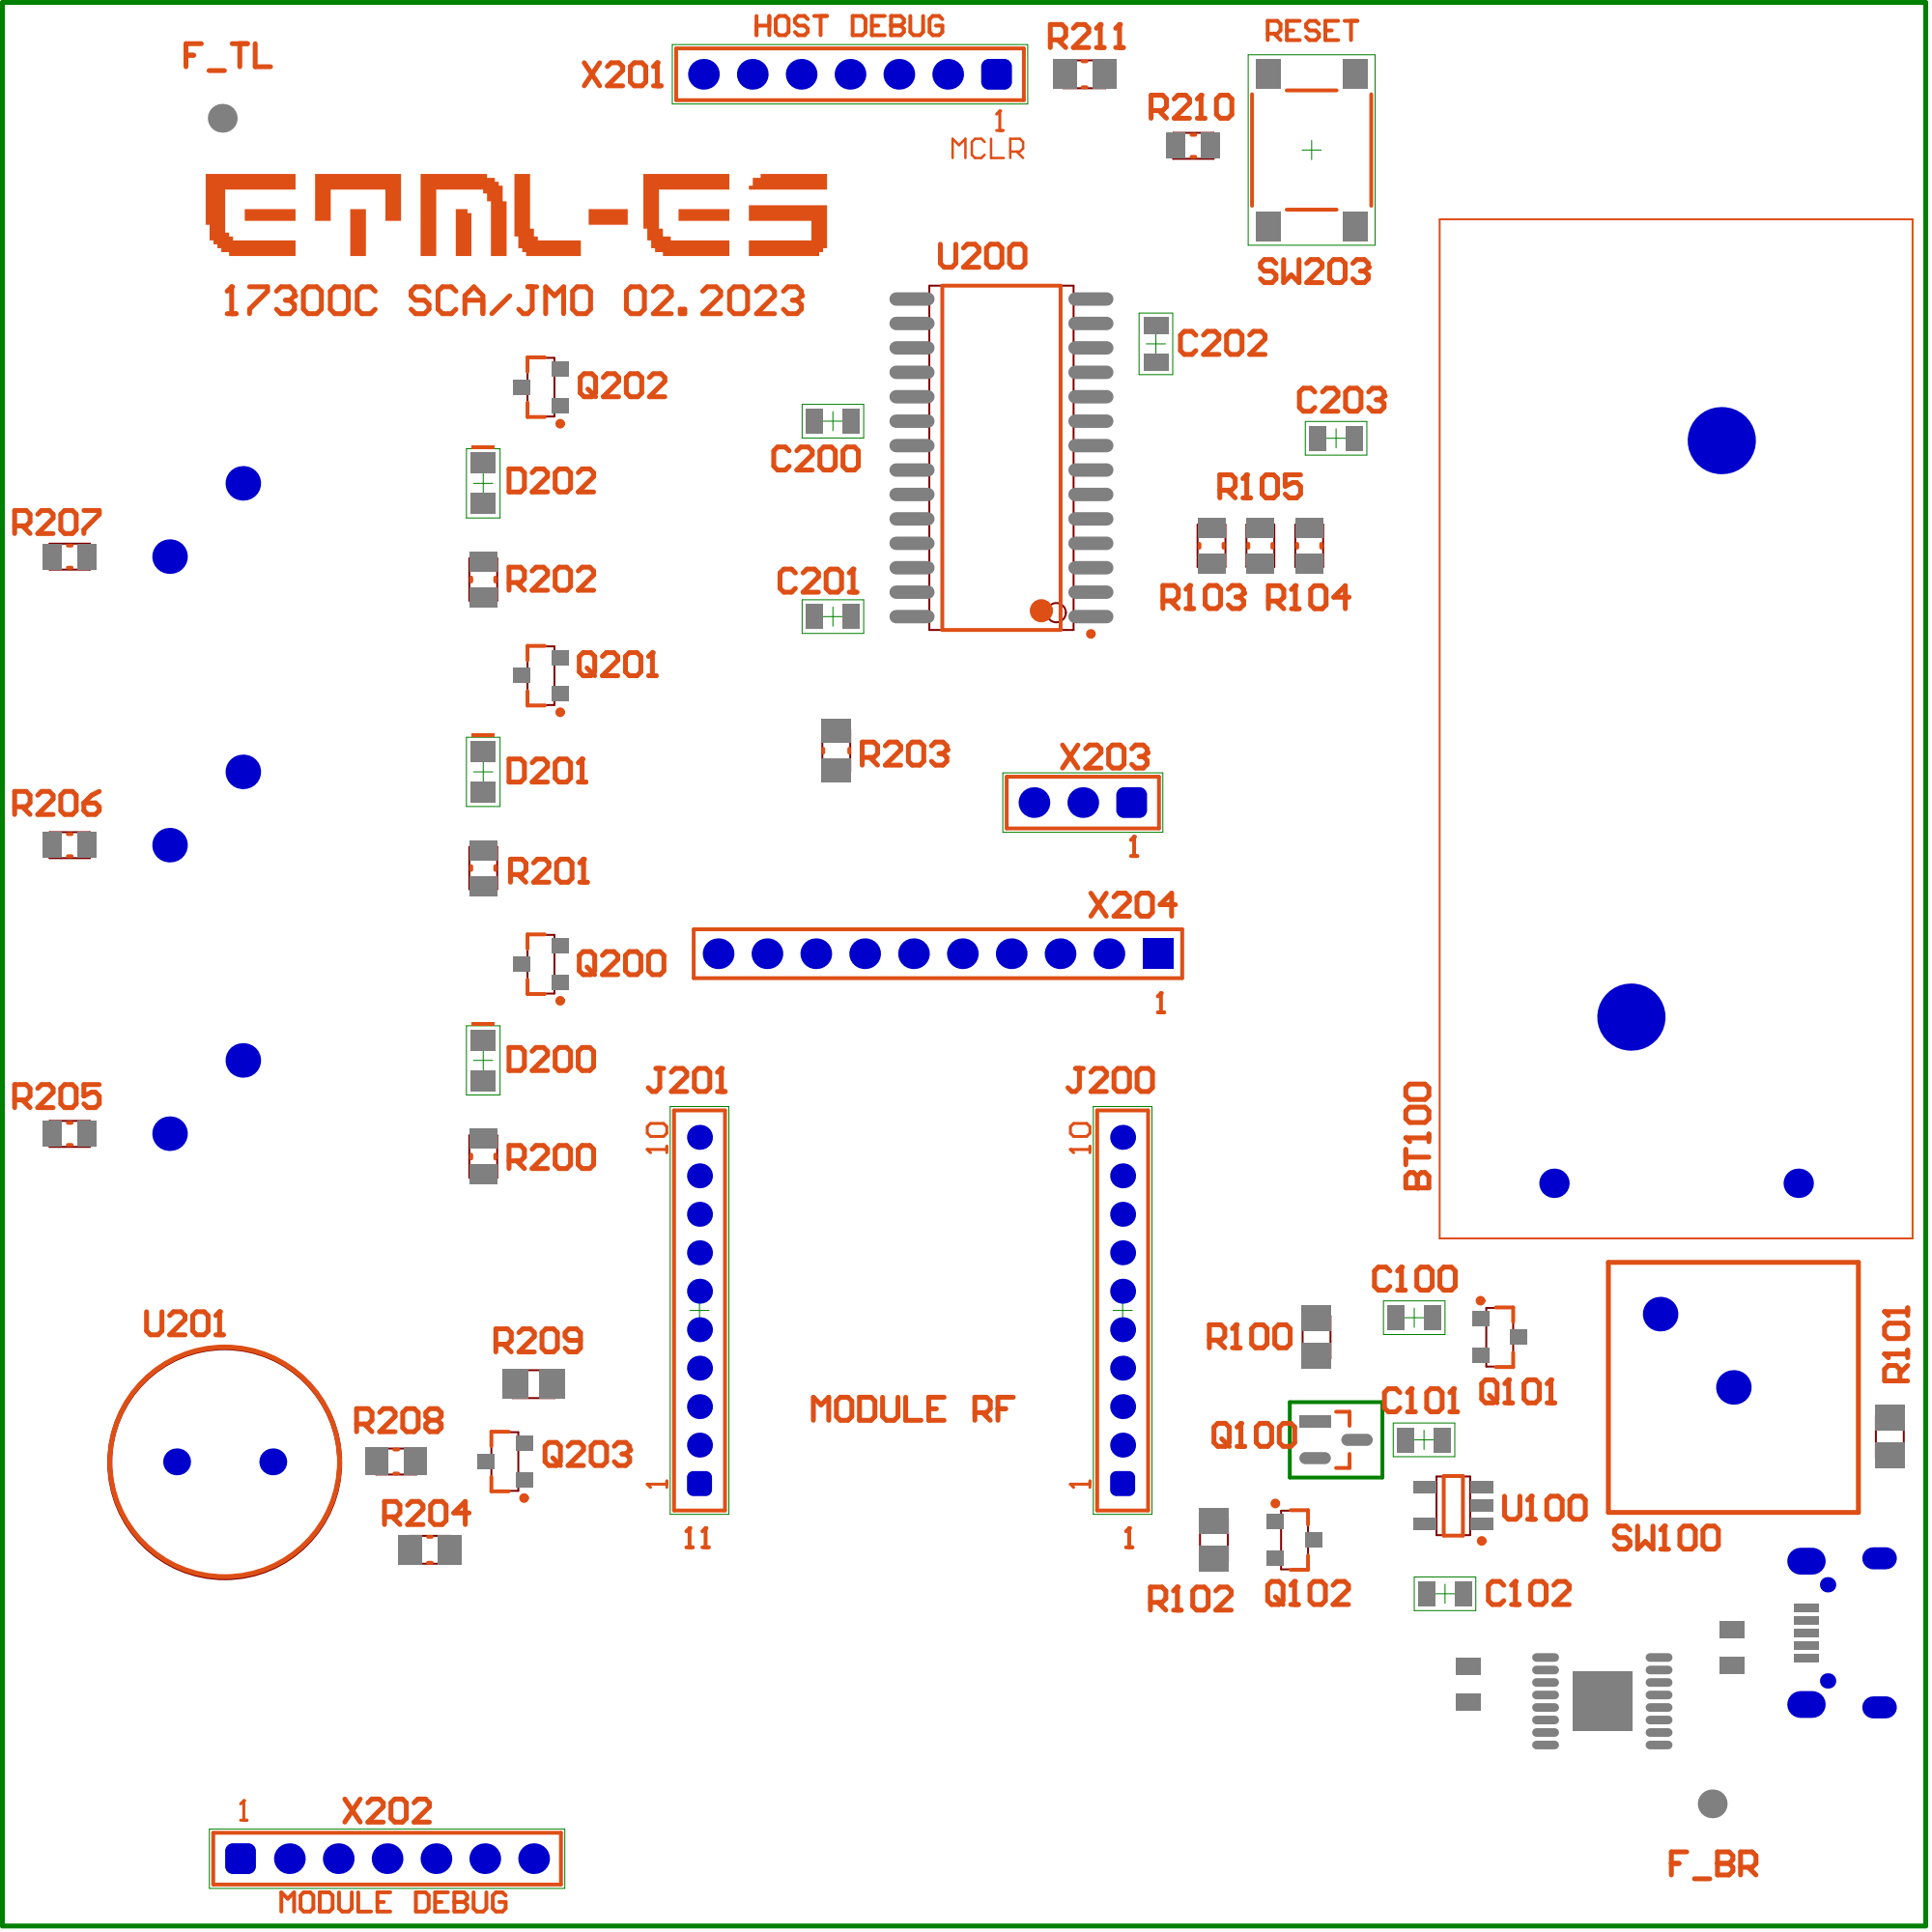
[picture p156: page 1]

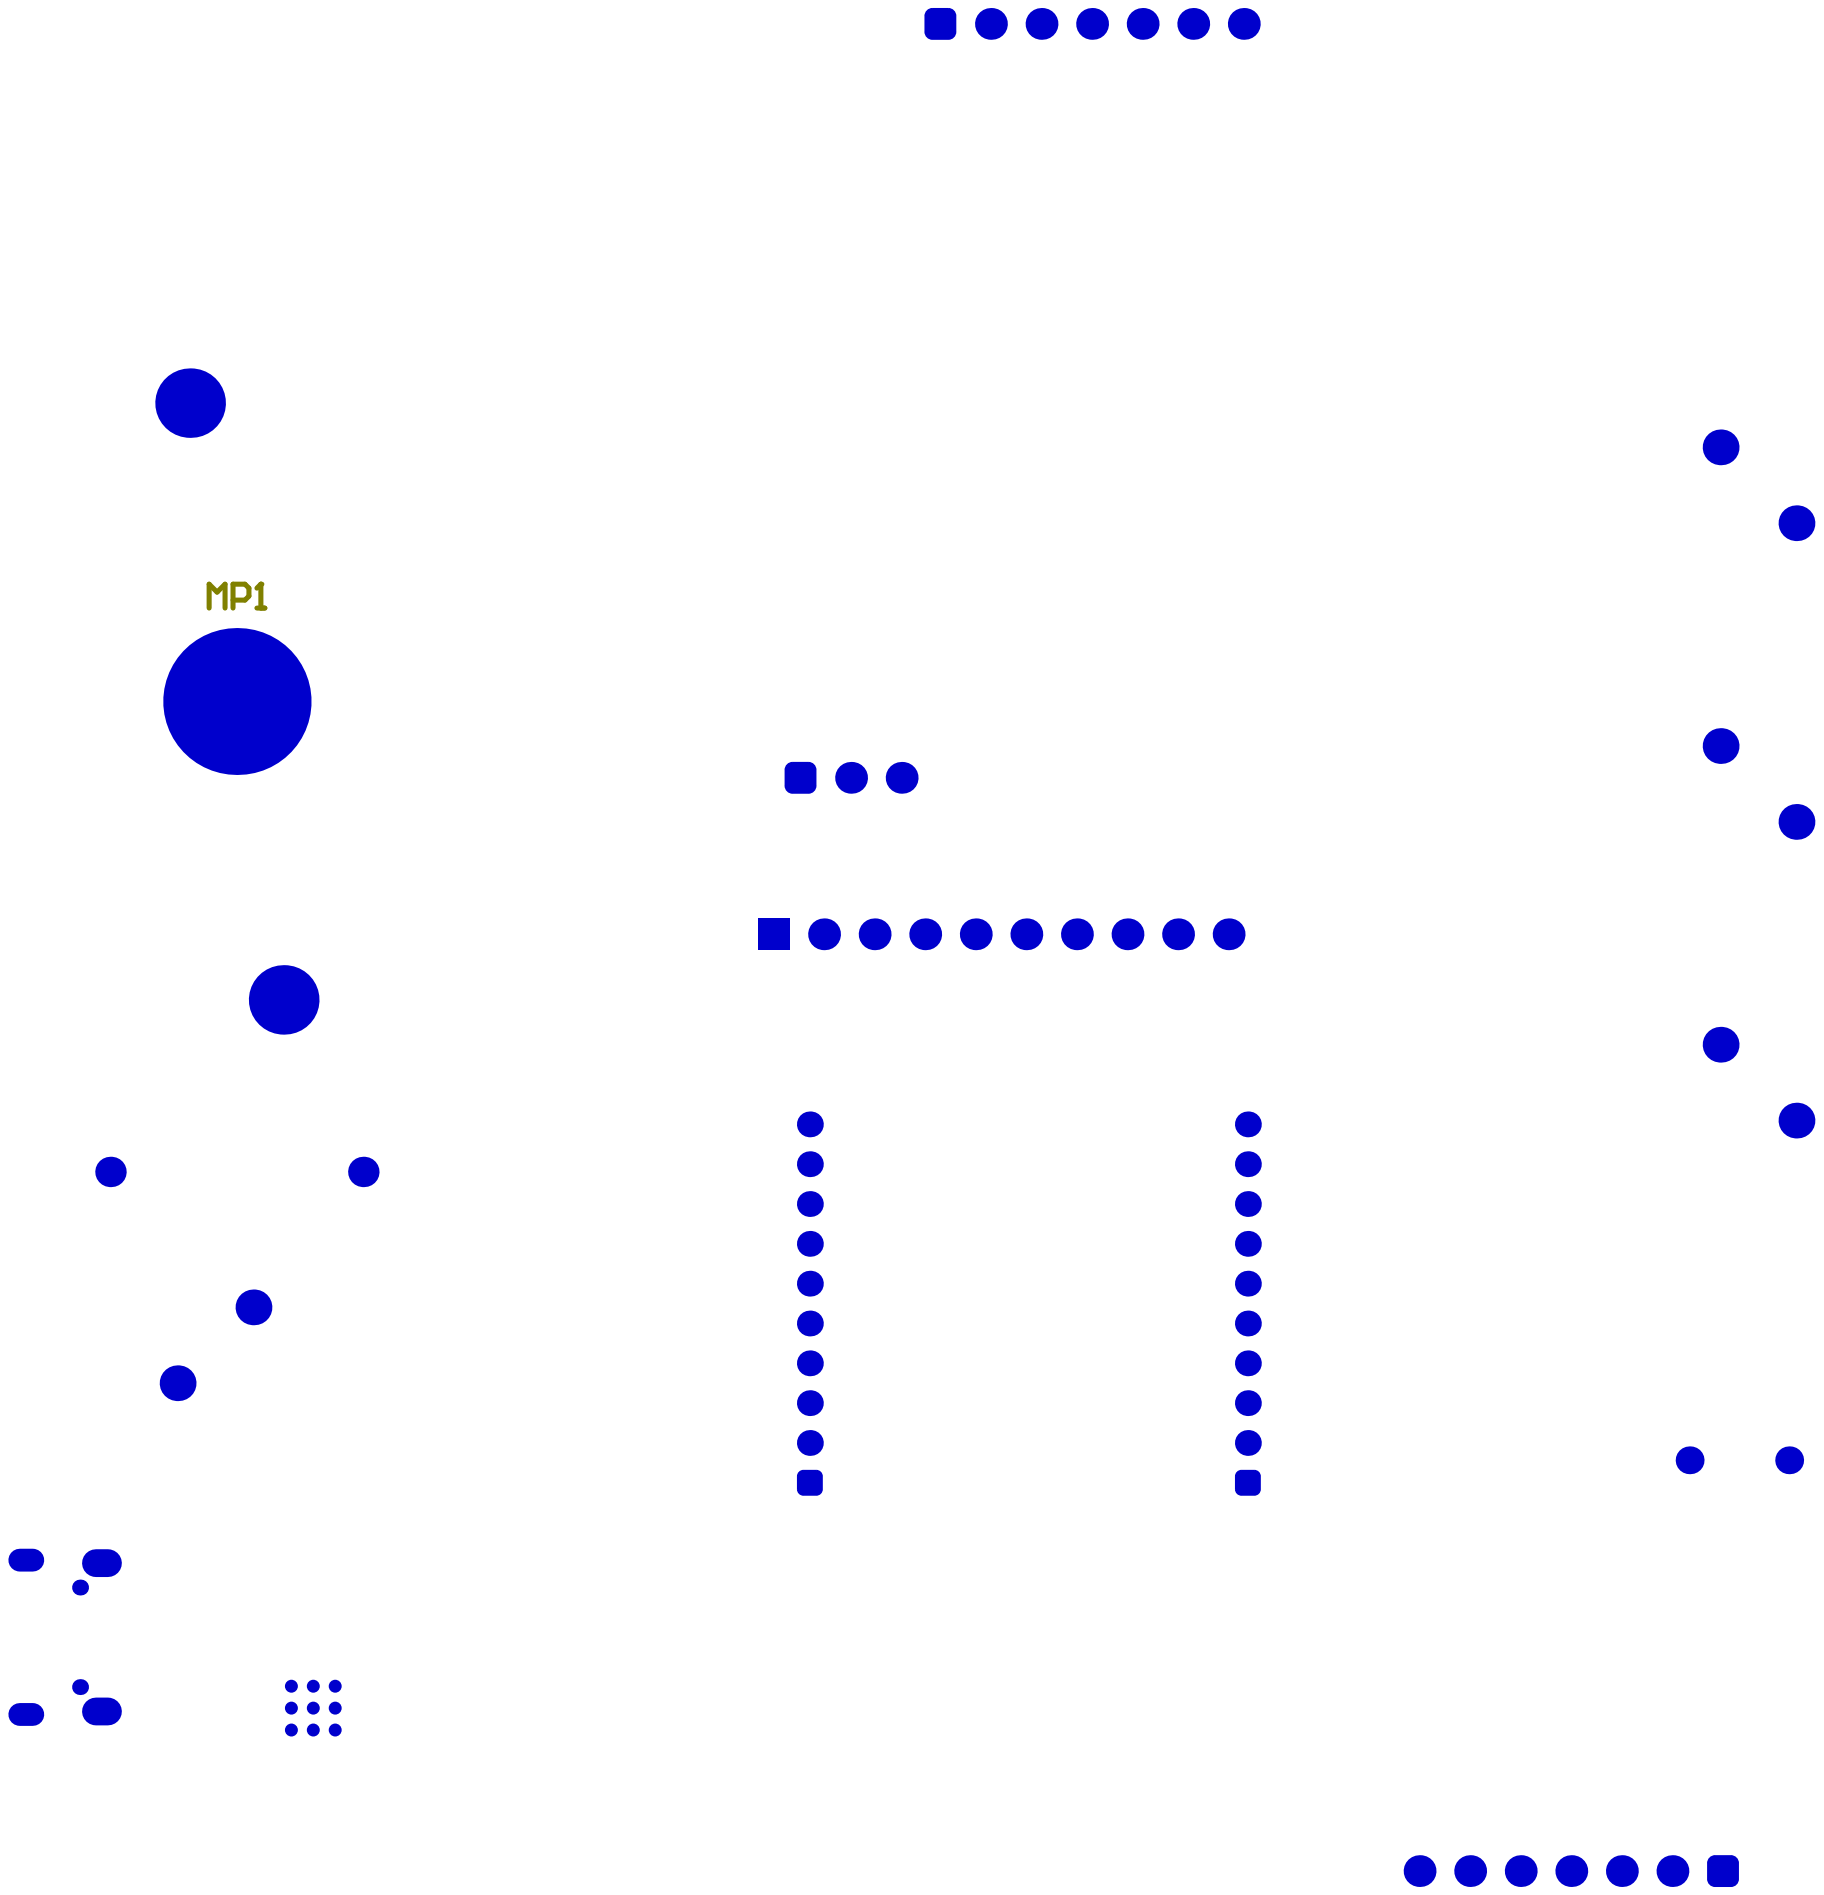
[picture p157: page 2]
