ETML-ES-SLO/PRJ_1730_PortierWireless/doc/PDF(Final)/Implantation.PDF

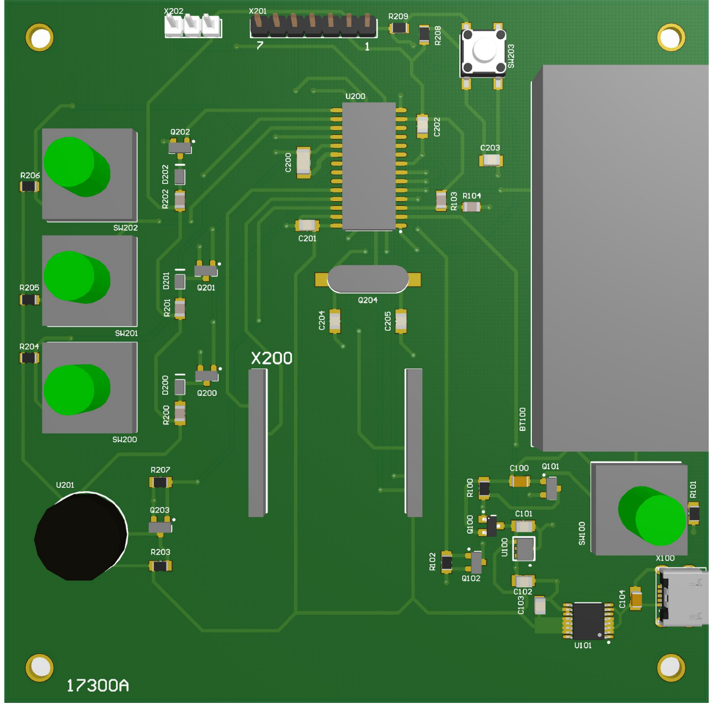
[picture p158: page 1]

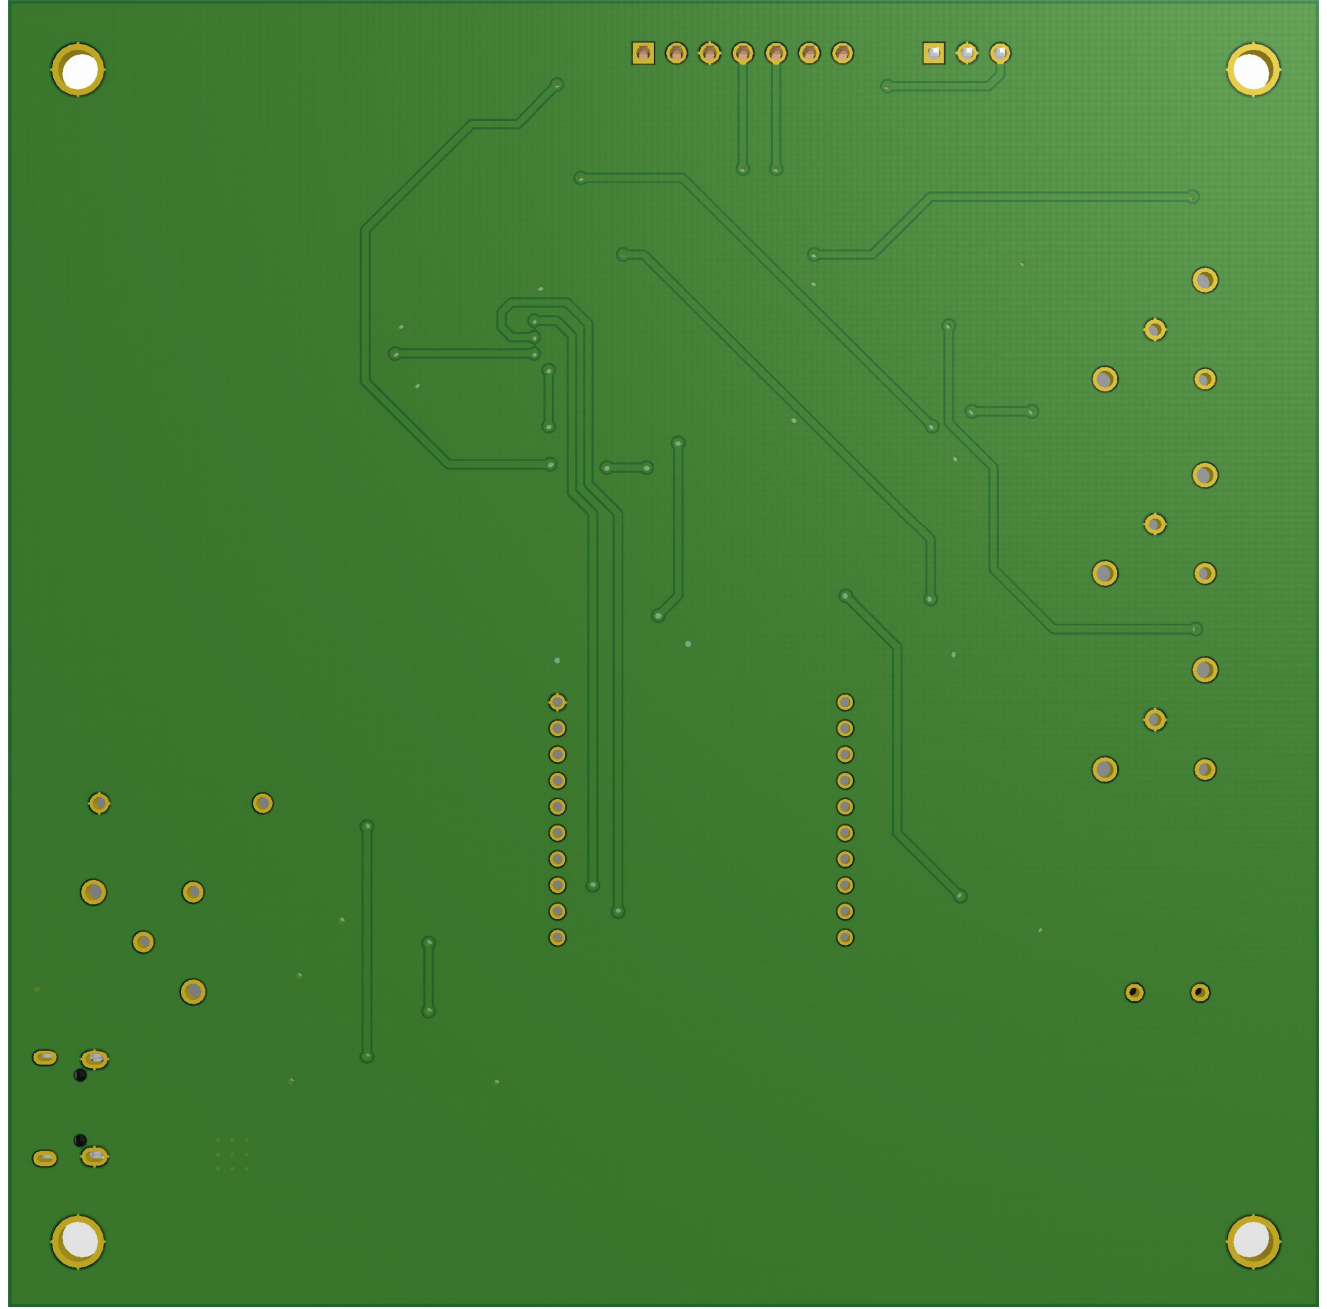
[picture p159: page 2]

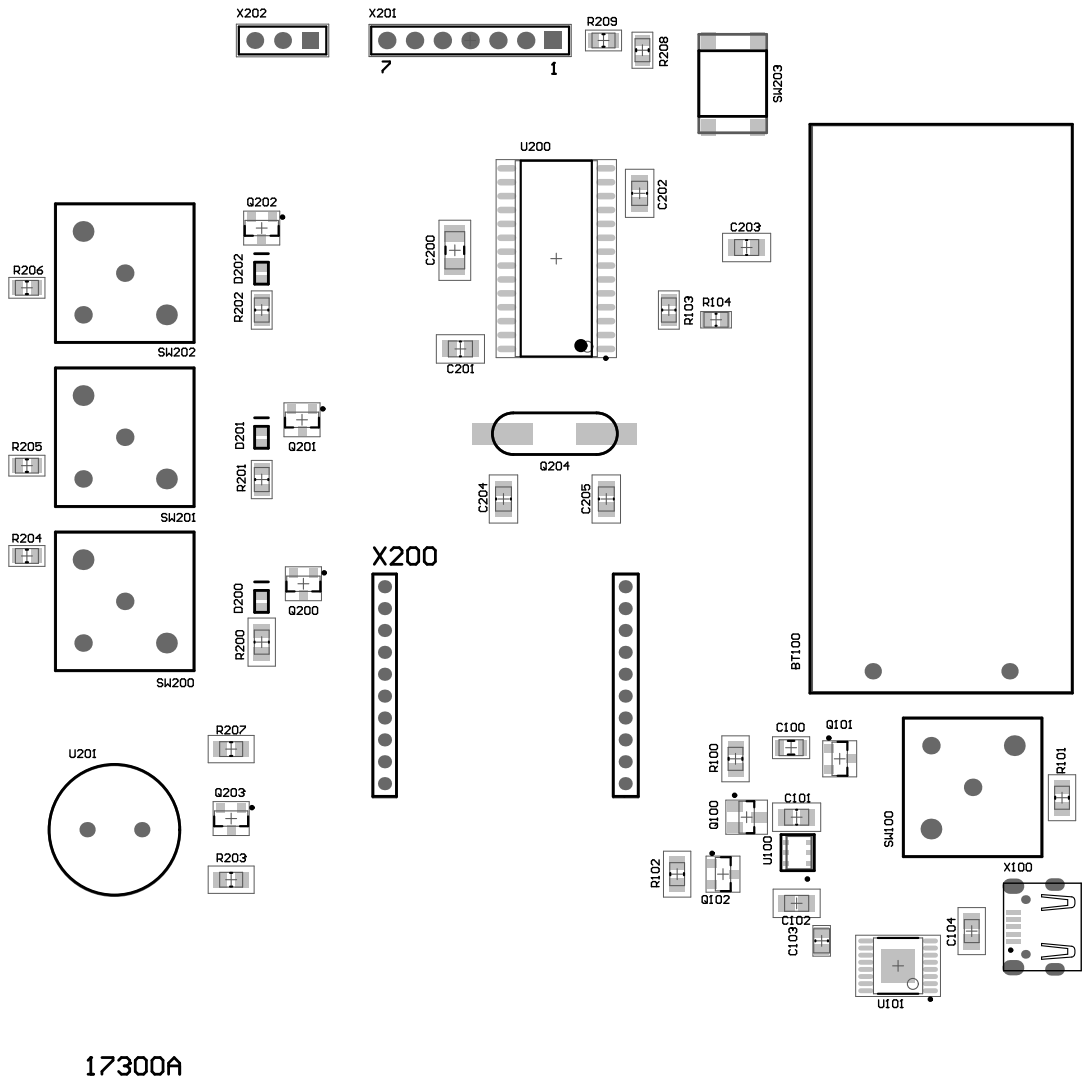
[picture p160: page 3]

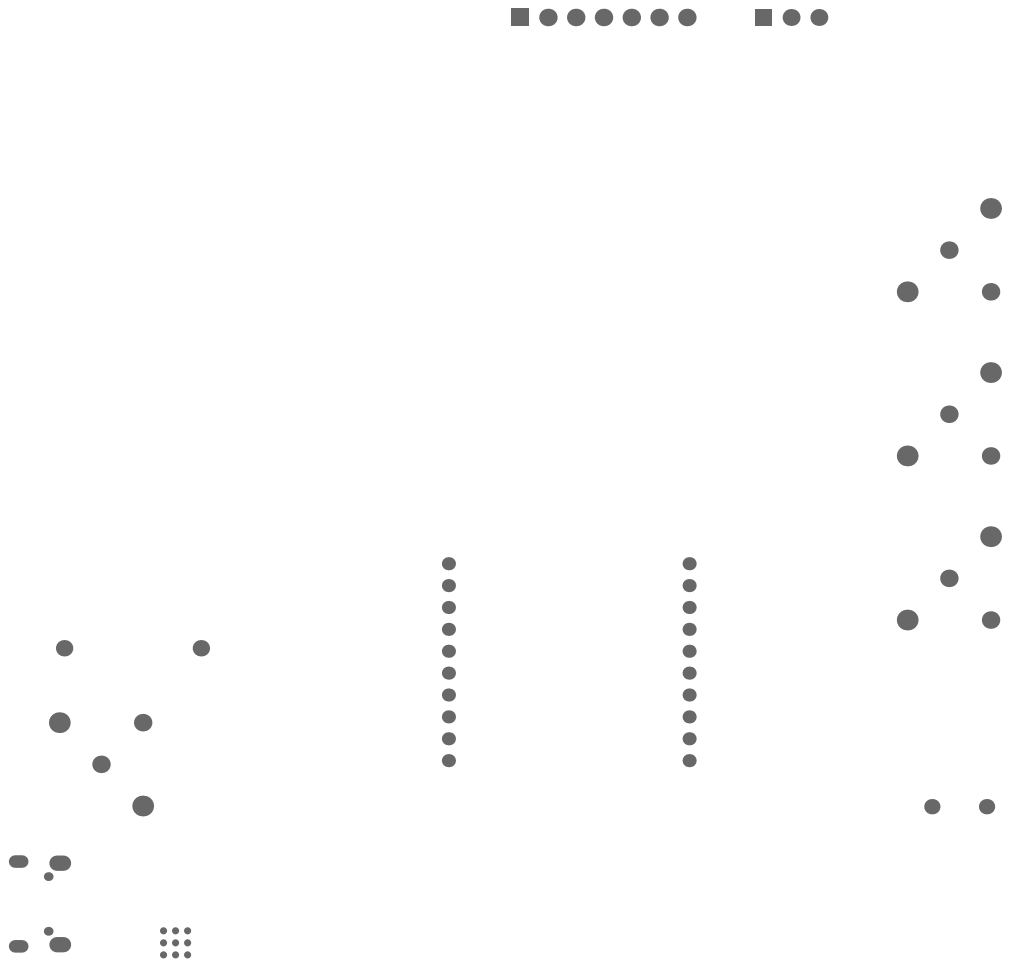
[picture p161: page 4]
