ETML-ES-SLO/PRJ_1730_PortierWireless/doc/PDF(Final)/SchemaPortier.pdf

I/O

# PIC32MX130F064B

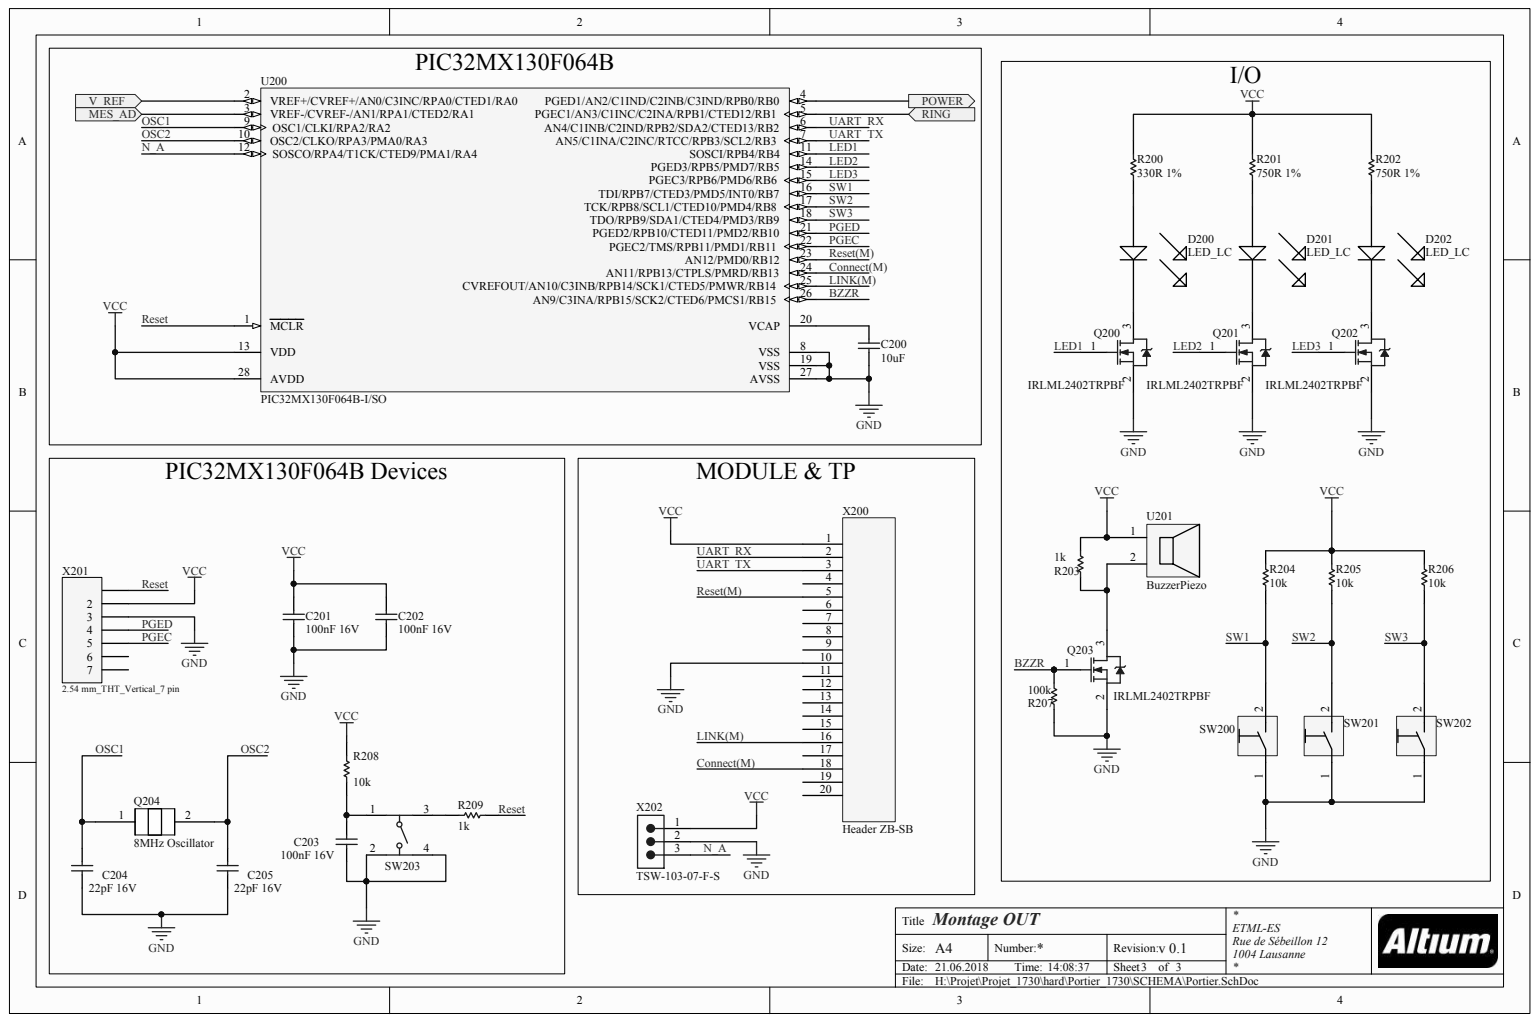
[picture p162: page 1]

H:\Projet\Projet_1730\hard\Portier_1730\SCHEMA\Portier.SchDoc
File:
