ETML-ES-SLO/PRJ_1730_PortierWireless/(list of files, drawings)

Other design files:
hard/Portier_17300B_SCA/LIBRAIRIES/PCBLIB/CircuitOUT.PcbLib
hard/Portier_17300B_SCA/LIBRAIRIES/PCBLIB/TSOP65P640X110_HS-17N.PcbLib
hard/Portier_17300B_SCA/LIBRAIRIES/PCBLIB/WS-TASV.PcbLib
hard/Portier_17300B_SCA/LIBRAIRIES/Portier.PcbLib
hard/Portier_17300B_SCA/LIBRAIRIES/Portier_1730.SCHLIB
hard/Portier_17300B_SCA/LIBRAIRIES/SCHLIB/CircuitOUT.SchLib
hard/Portier_17300B_SCA/LIBRAIRIES/SCHLIB/Micro_USB.SchLib
hard/Portier_17300B_SCA/LIBRAIRIES/SCHLIB/WS-TASV.SchLib
hard/Portier_17300B_SCA/PCB/Portier.PcbDoc
hard/Portier_17300B_SCA/Portier_1730.PrjPcb
hard/Portier_17300B_SCA/SCHEMA/Portier.SchDoc
hard/Portier_17300B_SCA/SCHEMA/Power.SchDoc
hard/Portier_17300B_SCA/SCHEMA/TopSchematic.SchDoc
hard/Portier_17300C_JMO/1730_MecParts.SchLib
hard/Portier_17300C_JMO/LIBRAIRIES/PCBLIB/1730_MecParts.PcbLib
hard/Portier_17300C_JMO/LIBRAIRIES/PCBLIB/CircuitOUT.PcbLib
hard/Portier_17300C_JMO/LIBRAIRIES/PCBLIB/TSOP65P640X110_HS-17N.PcbLib
hard/Portier_17300C_JMO/LIBRAIRIES/PCBLIB/WS-TASV.PcbLib
hard/Portier_17300C_JMO/LIBRAIRIES/Portier.PcbLib
hard/Portier_17300C_JMO/LIBRAIRIES/Portier_1730.SCHLIB
hard/Portier_17300C_JMO/LIBRAIRIES/SCHLIB/CircuitOUT.SchLib
hard/Portier_17300C_JMO/LIBRAIRIES/SCHLIB/Micro_USB.SchLib
hard/Portier_17300C_JMO/LIBRAIRIES/SCHLIB/WS-TASV.SchLib
hard/Portier_17300C_JMO/MecParts.SchDoc
hard/Portier_17300C_JMO/Portier_1730.PrjPcb
hard/Portier_17300C_JMO/SCHEMA/Portier.SchDoc
hard/Portier_17300C_JMO/SCHEMA/Power.SchDoc
hard/Portier_17300C_JMO/SCHEMA/RF_Modules_3D.SchDoc
hard/Portier_17300C_JMO/SCHEMA/TopSchematic.SchDoc
