ETML-ES-SLO/PRJ_1730_PortierWireless/doc/Modification/Mod 3.0/2_Rendu/Portier_17300_04_LMS/1730_PortierWireless_InOut_04/firmware/src/RF.h

//--------------------------------------------------------
// RF.h
//--------------------------------------------------------
// Gestion communication	
//
//	Auteur 		: 	SCA
//  Date        :   5.12.2019
//	Version		:	V1.0
//	Compilateur	:	XC32 V2.15
//  Modifications :
//   -
/*--------------------------------------------------------*/

#ifndef _RF_H    /* Guard against multiple inclusion */
#define _RF_H

#include <stdint.h>
#include <stdbool.h>

/* ************************************************************************** */


/* ************************************************************************** */



/* ************************************************************************** */

void RF_Init(void);
void RF_SendMessage(uint8_t* dataToSend, uint8_t nbBytesToSend);
bool RF_GetMessage(uint8_t* msg);
uint32_t getSerialRF(void);
uint32_t RF_GetLastSenderSerial(void);
void RF_RecordSenderSerial(uint8_t* msg);
#endif /* _RF_H */

/* *****************************************************************************
 End of File
 */
