ETML-ES-SLO/PRJ_1730_PortierWireless/doc/Modification/Mod 3.0/2_Rendu/Portier_17300_04_LMS/1730_PortierWireless_InOut_04/firmware/src/Mc32Delays.h

#ifndef __MC32DELAYS_H
#define __MC32DELAYS_H
/*--------------------------------------------------------*/
//      Mc32Delays.h
/*--------------------------------------------------------*/
//	Description :	Adaptation des fonctions de delay afin
//					de pouvoir utiliser la même syntaxe
//					que sous CCS.
//
//	Auteur 		: 	F. Dominé
//
//	Version		:	V1.0
//	Compilateur	:	C32 V2.01
//
/*--------------------------------------------------------*/


/*--------------------------------------------------------*/
// Définition des fonctions prototypes
/*--------------------------------------------------------*/
// Quelques commentaires:
// Avec notre configuration, le temps nécessire pour passer
// une sortie à 0 puis à 1 est denviron 65ns
// En ajoutant un nop, on obtient environ 100ns
// On peut en conclure que le temps de cycle est de 33ns
#define delay_cycle() __asm__( "nop" )
//void delay500ns(); // nécessaire pour lcd
//void delay_us(unsigned int); // 32 bits
//void delay_ms(unsigned int); // 32 bits

//Fonctions basées sur Core Timer
void delay_msCt(unsigned int NbMs);
void delay_usCt(unsigned int NbUs);
void delay500nsCt(void);


#endif
