ETML-ES-SLO/PRJ_1730_PortierWireless/(commit log)

2024-05-14 first Update Github
    [1730_Circuit_Bell.xlsx, 1730_Circuit_Door.xlsx, 1730_MecParts.PcbLib, 1730_MecParts.SchLib, BOM-CircuitOUT.xlsx, BOM_Cost_ES_Variant_PCBA_Bell.xlsx, BOM_Cost_ES_Variant_PCBA_Door.xlsx, Bill of Materials.xls]
2026-01-28 MAJ dossiers PRJ 1730
    [JournalDeTravailModification.xlsx, app_8c.xml, app_8h.xml, app_8h_source.xml]
2026-01-28 Delete hard/Portier_17300A_Page directory
    ne plus prendre en compte le dossier hardware PCB dans le git
    [CircuitOUT.PcbLib, CircuitOUT.SchLib, Micro_USB.SchLib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]
