ETML-ES-SLO/PRJ_1730_PortierWireless/doc/IMG_Rapport/PlexiIN.jpg

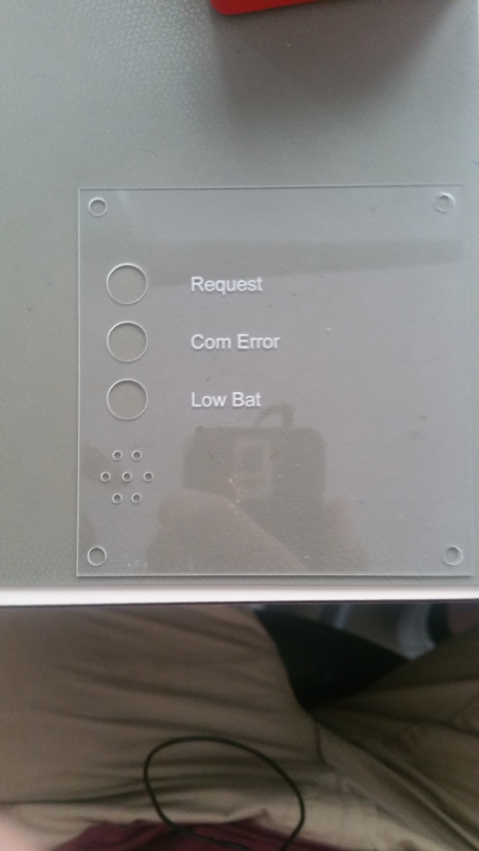
doc/IMG_Rapport/PlexiIN.jpg
